dsheffie/r9999/README.md

# r9999
See https://dsheffie.github.io/henry-the-wannabe-ip22-soc/r9999-microarchitecture/#walking-the-pipeline for more details
