dsheffie/r9999/core.sv

`include "machine.vh"
`include "rob.vh"
`include "uop.vh"

`ifdef VERILATOR
import "DPI-C" function void record_faults(input int n_faults);
import "DPI-C" function void record_branches(input int n_branches);


import "DPI-C" function void record_alloc(input int rob_full,
					  input int alloc_one, 
					  input int alloc_two,
					  input int dq_empty,
					  input int uq_full,
					  input int uq_next_full,
					  input int one_insn_avail,
					  input int two_insn_avail,
					  input int active);

import "DPI-C" function void record_retirement(input longint pc,
					       input longint fetch_cycle,
					       input longint alloc_cycle,
					       input longint complete_cycle,
					       input longint retire_cycle,
					       input int     fault,
					       input int     is_mem,
					       input int     is_fp,
					       input int     missed_l1d);

import "DPI-C" function void record_restart(input int restart_cycles);
`ifdef PIPETRACE
/* pipetrace stage events: clear the rob slot's event list at allocation; name the
 * slot record_retirement is about to retire (see top.cc pt::) */
import "DPI-C" function void pt_alloc(input int rob_ptr);
import "DPI-C" function void pt_retire(input int rob_ptr);
`endif
import "DPI-C" function void record_ds_restart(input int delay_cycles);
import "DPI-C" function int check_insn_bytes(input longint pc, input int data);


`endif

module core(clk,
`ifdef FORMAL_ROBWR_PORTS
	    fml_robwr_badv,
	    fml_robwr_act,
`endif
`ifdef FORMAL_RETIRE_PORTS
	    fml_ret_bad,
	    fml_ret_act,
	    fml_ret_badv,
`endif
	    single_step,
	    step,
	    bp_enable,
	    fault_clear,
	    bp_pc,
	    bp_wp_addr,
	    bp_wp_val,
	    bp_fault_only,
	    rt_oneshot,
	    reset,
	    ip6,
	    ip5,
	    ip4,
	    ip3,
	    ip2,	   
	    in_kernel_mode,
	    in_supervisor_mode,
	    in_user_mode,
	    in_64b_kernel_mode,
	    in_64b_supervisor_mode,
	    in_64b_user_mode,
	    putchar_fifo_out,
	    putchar_fifo_empty,
	    putchar_fifo_pop,
	    putchar_fifo_wptr,
	    putchar_fifo_rptr,
	    head_of_rob_ptr_valid,
	    head_of_rob_ptr,
	    head_of_rob_has_delay_slot,
	    next_head_of_rob_ptr,
	    head_of_rob_ds_committable,
	    resume,
	    memq_empty,
	    drain_ds_complete,
	    dead_rob_mask,
	    resume_pc,
	    ready_for_resume,
	    flush_req_l1d,
	    flush_req_l1i,
	    flush_line_req_l1i,
	    flush_line_idx_l1i,
	    flush_cl_req,
	    flush_cl_addr,
	    flush_cl_inval,
	    flush_pg_req,
	    l1d_flush_complete,
	    l1i_flush_complete,
	    l1i_flush_line_complete,
	    l2_flush_complete,
	    ext_flush_req,
	    ext_flush_done,
	    ext_flush_ppn,
	    ext_flush_whole,
	    ext_flush_drop,
	    insn, 
	    insn_valid,
	    insn_ack,
	    insn_two, 
	    insn_valid_two,
	    insn_ack_two,	    
	    branch_pc,
	    branch_target,
	    branch_is_indirect,
	    branch_pc_valid,
	    branch_fault,
	    took_branch,
	    branch_bpu_idx,
	    restart_pc,
	    restart_src_pc,
	    restart_src_is_indirect,
	    restart_valid,
	    clr_link_reg,
	    restart_ack,
	    core_mem_req_ack,
	    core_mem_req,
	    core_mem_req_valid,

	    
	    core_mem_rsp,
	    core_mem_rsp_valid,
	    core_mem_blk_valid,
	    core_mem_wake_valid,
	    core_mem_st_done_valid,
	    core_mem_st_done_idx,
	    lsu_sb,
	    restart_color,
	    mem_color_busy,
	    mem_quiet,
	    
	    retire_reg_ptr,
	    retire_reg_data,
	    retire_reg_valid,
	    
	    retire_reg_two_ptr,
	    retire_reg_two_data,
	    retire_reg_two_valid,
	    retire_fp_reg_ptr,
	    retire_fp_reg_data,
	    retire_fp_reg_valid,
	    retire_fp_reg_two_ptr,
	    retire_fp_reg_two_data,
	    retire_fp_reg_two_valid,
	    retire_fcr_reg_ptr,
	    retire_fcr_reg_data,
	    retire_fcr_reg_valid,
	    retire_fcr_reg_two_ptr,
	    retire_fcr_reg_two_data,
	    retire_fcr_reg_two_valid,
	    retire_valid,
	    retire_two_valid,
	    retire_delay_slot,
	    retire_pc,
	    retire_two_pc,
`ifdef VERILATOR
	    retire_insn,
	    retire_two_insn,
`endif
	    retire_op,
	    retire_two_op,
	    retired_call,
	    retired_ret,
	    retired_rob_ptr_valid,
	    retired_rob_ptr_two_valid,
	    retired_rob_ptr,
	    retired_rob_ptr_two,
	    
	    got_break,
	    got_ud,
	    got_bad_addr,
	    core_state,
	    inflight,
	    dbg_rob_inflight,
	    epc,
	    status_reg,
	    badvaddr,
	    cause,
	    dbg_frozen,
	    dbg_wp_data,
	    cause_ip,
	    asid,
	    tlb_entry_out,
	    tlb_entry_out_valid,
	    took_irq,
	    cp0_count,
	    cp0_random,
	    
	    l1i_flush_done,
	    l1d_flush_done,
	    l2_flush_done,
	    dbg_head_pc,
	    dbg_head_status,
	    dbg_head_fetch_cycle,
	    dbg_head_alloc_cycle,
	    dbg_serialize_cycle,
	    dbg_cycle,
	    dbg_oldest_first_pending,
	    dbg_trace_index,
	    dbg_trace_data,
	    dbg_trace_wptr);

   input logic clk;
   input logic reset;
   input logic ip6;
   input logic ip5;
   input logic ip4;
   input logic ip3;
   input logic ip2;   
   output logic	in_kernel_mode;
   output logic	in_supervisor_mode;
   output logic	in_user_mode;
   output logic	in_64b_kernel_mode;
   output logic	in_64b_supervisor_mode;
   output logic	in_64b_user_mode;
    
   output logic [7:0] putchar_fifo_out;
   output logic       putchar_fifo_empty;
   input logic 	      putchar_fifo_pop;
   output logic [3:0] putchar_fifo_wptr;
   output logic [3:0] putchar_fifo_rptr;
   
   output logic head_of_rob_ptr_valid;
   output logic [`LG_ROB_ENTRIES-1:0] head_of_rob_ptr;
   output logic			      head_of_rob_has_delay_slot;
   output logic [`LG_ROB_ENTRIES-1:0] next_head_of_rob_ptr;
   output logic			      head_of_rob_ds_committable;
   input logic resume;
   input logic single_step;
   input logic step;
   input logic bp_enable;   /* debug: freeze core after retiring bp_pc (also arms the fault-trap) */
   input logic fault_clear; /* debug: clear the fault-trap latch + re-arm + un-freeze (resettable) */
   input logic [31:0] bp_pc; /* debug: driver-programmable breakpoint PC (slv_reg9) */
   input logic [31:0] bp_wp_addr; /* debug: driver-programmable store-address watchpoint VA (slv_reg10) */
   input logic [31:0] bp_wp_val;  /* debug: expected corrupt store value to freeze on (slv_reg11) */
   /* debug (ctrl bit22): rising edge rewinds + arms the retire ring for ONE
    * full pass, after which it self-freezes -- a coherent dump with the core
    * still RUNNING, so profiling never interrupts the soak. */
   input logic rt_oneshot;
   input logic bp_fault_only;     /* debug (ctrl bit19): freeze ONLY on a FAULT at bp_pc, suppressing
                                   * every retire-match + routine-fatal-fault net.  For a HOT bp_pc
                                   * (e.g. 0e788bc0, a load that usually succeeds) whose crash is a
                                   * rare FAULT: retire-matches would freeze on every normal pass. */
   input logic memq_empty;
   output logic drain_ds_complete;
   output logic [(1<<`LG_ROB_ENTRIES)-1:0] dead_rob_mask;
   
   input logic [(`M_WIDTH-1):0] resume_pc;
   output logic 		ready_for_resume;
   output logic 		flush_req_l1d;
   output logic 		flush_req_l1i;
   /* I-side CACHE op: invalidate one L1I set (both ways) instead of the whole L1I */
   output logic 		flush_line_req_l1i;
   output logic [`LG_L1I_NUM_SETS-1:0] flush_line_idx_l1i;
   
   output logic flush_cl_req;
   output logic [(`M_WIDTH-1):0] flush_cl_addr;
   output logic flush_cl_inval; /* per-line flush is an invalidate-no-writeback (DMA-in) */
   /* injected page op: L1D walks the page at flush_cl_addr (flush_cl_inval = drop) */
   output logic flush_pg_req;

   input logic			 l1d_flush_complete;
   input logic			 l1i_flush_complete;
   input logic			 l1i_flush_line_complete;
   input logic			 l2_flush_complete;
   /* ARM-requested whole-cache flush (via core_l1d_l1i).  Handled like an IRQ:
    * while pending, decode replaces a non-delay-slot instruction with a
    * serializing XFLUSH/XPG_* uop; it flushes L1D then L2 with the
    * core drained, restarts at its own pc, and pulses ext_flush_done. */
   input logic			 ext_flush_req;
   output logic			 ext_flush_done;
   /* sampled when the request is accepted and held until ext_flush_done: the page to
    * flush, or the whole cache. */
   input logic [`PA_WIDTH-1:`LG_PG_SZ] ext_flush_ppn;
   input logic			 ext_flush_whole;
   input logic			 ext_flush_drop;     /* page mode: 1 = drop, 0 = write back + invalidate */
   
	
   input 	insn_fetch_t insn;
   input logic 	insn_valid;
   output logic insn_ack;

   input 	insn_fetch_t insn_two;
   input logic 	insn_valid_two;
   output logic insn_ack_two;
   
   
   output logic [(`M_WIDTH-1):0] restart_pc;
   output logic [(`M_WIDTH-1):0] restart_src_pc;
   output logic 		 restart_src_is_indirect;
   output logic 		 restart_valid;
   output logic			 clr_link_reg;
   input logic 			 restart_ack;
   
   output logic [(`M_WIDTH-1):0] branch_pc;
   /* retiring indirect jump (not a return) and its resolved target: trains the BTB */
   output logic [(`M_WIDTH-1):0] branch_target;
   output logic 		 branch_is_indirect;
   output logic 		 branch_pc_valid;
   output logic 		 branch_fault;
   output logic 		 took_branch;
   output logic [`LG_BPU_TBL_SZ-1:0] branch_bpu_idx;
   
   /* mem port */
   input logic 	 core_mem_req_ack;
   
   output logic  core_mem_req_valid;
   output 	 mem_req_t core_mem_req;

  
   input 	 mem_rsp_t core_mem_rsp;
   input logic 	 core_mem_rsp_valid;
   input logic 	 core_mem_blk_valid;   /* LSU block code (core_mem_rsp.blk/lsu_idx) */
   input logic 	 core_mem_wake_valid;  /* LSU wakeup (core_mem_rsp.lsu_idx) */
   input logic 	 core_mem_st_done_valid;   /* LSU plain store written */
   input logic [`LG_MEM_SCHED_ENTRIES-1:0] core_mem_st_done_idx;
   output 	 lsu_sb_t lsu_sb;          /* LSU -> l1d store-buffer view */
   output logic	 restart_color;            /* current restart color (to the l1d) */
   input logic [1:0] mem_color_busy;       /* l1d: a memory op of color c is still in flight */
   input logic       mem_quiet;            /* l1d: nothing accepted is still in flight */

   output logic [4:0] 			  retire_reg_ptr;
   output logic [`M_WIDTH-1:0]		  retire_reg_data;
   output logic 			  retire_reg_valid;

   output logic [4:0] 			  retire_reg_two_ptr;
   output logic [`M_WIDTH-1:0]		  retire_reg_two_data;
   output logic 			  retire_reg_two_valid;
   /* FP and FCR architectural writes, for the co-sim.  retire_reg_valid tests
    * only valid_dst, so an FP register write was invisible to the checker --
    * every FP value bug stayed silent until it leaked through an mfc1/swc1.
    * rob_entry_t.data already carries the FP result (complete_bundle_2 writes
    * it), and for a compare data[7:0] is the condition-code vector. */
   output logic [4:0] 		  retire_fp_reg_ptr;
   output logic [`M_WIDTH-1:0] 	  retire_fp_reg_data;
   output logic 		  retire_fp_reg_valid;
   output logic [4:0] 		  retire_fp_reg_two_ptr;
   output logic [`M_WIDTH-1:0] 	  retire_fp_reg_two_data;
   output logic 		  retire_fp_reg_two_valid;
   output logic [4:0] 		  retire_fcr_reg_ptr;
   output logic [`M_WIDTH-1:0] 	  retire_fcr_reg_data;
   output logic 		  retire_fcr_reg_valid;
   output logic [4:0] 		  retire_fcr_reg_two_ptr;
   output logic [`M_WIDTH-1:0] 	  retire_fcr_reg_two_data;
   output logic 		  retire_fcr_reg_two_valid;
   
   output logic 			  retire_valid;
   output logic 			  retire_two_valid;
   
   output logic 			  retire_delay_slot;
   
   output logic [(`M_WIDTH-1):0] 	  retire_pc;
   output logic [(`M_WIDTH-1):0] 	  retire_two_pc;
`ifdef VERILATOR
   /* the instruction word each retiring op was fetched as: the L1I is not coherent with
    * stores, so it can differ from memory (IRIX utlbmiss_reset patches the refill vector
    * with no I-cache flush); the co-sim checker runs this word, not memory's */
   output logic [31:0] 			  retire_insn;
   output logic [31:0] 			  retire_two_insn;
   logic [31:0] 			  r_rob_raw_insn[(1<<`LG_ROB_ENTRIES)-1:0];
`endif

   output logic [7:0]			  retire_op;
   output logic [7:0]			  retire_two_op;
      
   output logic 			  retired_call;
   output logic 			  retired_ret;

   output logic 			  retired_rob_ptr_valid;

   output logic retired_rob_ptr_two_valid;
   output logic [`LG_ROB_ENTRIES-1:0] retired_rob_ptr;
   output logic [`LG_ROB_ENTRIES-1:0] retired_rob_ptr_two;
   
   
   output logic 			  got_break;
   output logic 			  got_ud;
   output logic 			  got_bad_addr;
   output logic [`LG_ROB_ENTRIES:0] 	  inflight;
   output logic [N_ROB_ENTRIES-1:0] dbg_rob_inflight;
   output logic [4:0]			  core_state;
   
   output logic [`M_WIDTH-1:0]		  epc;
   output logic [31:0]			  status_reg;
   
   output logic [`M_WIDTH-1:0]		  badvaddr;
   
   output logic [4:0]			  cause;
   output logic [7:0]			  cause_ip;
   output logic [2:0]			  dbg_frozen; /* {r_bp_hit, r_wp_hit, r_fault_hit} -- real freeze vs stall */
   output logic [31:0]			  dbg_wp_data; /* the DATA of the last store to bp_wp_addr (exact store value) */
   output logic [7:0]			  asid;
   output tlb_data_t		          tlb_entry_out;
   output logic				  tlb_entry_out_valid;
   output logic				  took_irq;
   output logic [31:0]			  cp0_count;
   output logic [5:0]			  cp0_random;
   
   
   output logic				  l1i_flush_done;
   output logic				  l1d_flush_done;
   output logic				  l2_flush_done;

   output logic [31:0]			  dbg_head_pc;
   output logic [31:0]			  dbg_head_status;
   output logic [31:0]			  dbg_head_fetch_cycle;
   output logic [31:0]			  dbg_head_alloc_cycle;
   output logic [31:0]			  dbg_serialize_cycle;
   output logic [31:0]			  dbg_cycle;
   output logic				  dbg_oldest_first_pending;
   input logic [19:0] dbg_trace_index;
   output logic [31:0] 			  dbg_trace_data;
   output logic [15:0] 			  dbg_trace_wptr;

   assign in_64b_kernel_mode     = w_in_64b_kernel_mode;
   assign in_64b_supervisor_mode = w_in_64b_supervisor_mode;
   assign in_64b_user_mode       = w_in_64b_user_mode;

   wire				w_in_64b_mode;
   generate
      if(`M_WIDTH==64)
	begin
	   /* must match decode_mips.sv (70538bc): 64-bit OPS are always valid in
	    * kernel mode -- KX gates only addressing and the XTLB vector.  This copy
	    * feeds only the P-mode-hazard guard (mode_when_fetched is decode's value)
	    * and debug prints; still requiring KX here made the guard fire on any RI
	    * in kernel mode with KX=0 (tests/fpu/fp_mips4: the first movn). */
	   assign w_in_64b_mode = in_kernel_mode |
				  w_in_64b_user_mode | 
				  w_in_64b_supervisor_mode;
	end
      else
	begin
	   assign w_in_64b_mode =1'b0;
	end
   endgenerate

   wire					  w_in_64b_kernel_mode;
   wire					  w_in_64b_supervisor_mode;
   wire					  w_in_64b_user_mode;
   wire					  w_cu1;   /* Status.CU1 (FPU enable) from exec -> decode CP1 CpU gate */
   wire					  w_fr;    /* Status.FR (FP reg mode) from exec -> decode FR=0 odd-reg gate */
   wire					  w_irq_pending;
   wire [31:0]				  w_cp0_count;
   wire [5:0]				  w_cp0_random;
   
   
   logic [`M_WIDTH-1:0]			  r_epc, n_epc;
   logic [`M_WIDTH-1:0]			  r_badvaddr, n_badvaddr;   
   wire [`M_WIDTH-1:0]			  w_exec_epc;
   
   wire					  w_sr_bev;
   wire					  w_sr_exl;

   
   logic				  r_exc_in_delay, n_exc_in_delay;
   
   
   localparam N_PRF_ENTRIES = (1<<`LG_PRF_ENTRIES);
   /* N_ROB_ENTRIES = pointer index space (masks/ports indexed by rob_ptr stay 2^LG);
    * ROB_ENTRIES = real capacity (storage arrays, pointer wrap) */
   localparam N_ROB_ENTRIES = (1<<`LG_ROB_ENTRIES);
   localparam ROB_ENTRIES = `ROB_ENTRIES;
   localparam ROB_POW2 = (ROB_ENTRIES == N_ROB_ENTRIES);
   localparam N_UQ_ENTRIES = (1<<`LG_UQ_ENTRIES);
   localparam N_HILO_ENTRIES = (1<<`LG_HILO_PRF_ENTRIES);
   localparam N_FCR_ENTRIES = (1<<`LG_FCR_PRF_ENTRIES);

   localparam N_DQ_ENTRIES = (1<<`LG_DQ_ENTRIES);
   localparam HI_EBITS = `M_WIDTH-32;

   logic 				  t_push_dq_one, t_push_dq_two;
   
   uop_t r_dq[N_DQ_ENTRIES-1:0];

   
   logic [`LG_DQ_ENTRIES:0] 		  r_dq_head_ptr, n_dq_head_ptr;
   logic [`LG_DQ_ENTRIES:0] 		  r_dq_next_head_ptr, n_dq_next_head_ptr;
   logic [`LG_DQ_ENTRIES:0] 		  r_dq_next_tail_ptr, n_dq_next_tail_ptr;
   
   logic [`LG_DQ_ENTRIES:0] 		  r_dq_cnt, n_dq_cnt;
   
   logic [`LG_DQ_ENTRIES:0] 		  r_dq_tail_ptr, n_dq_tail_ptr;
   logic 				  t_dq_empty, t_dq_full, t_dq_next_empty, t_dq_next_full;
   
   logic 				  r_got_restart_ack, n_got_restart_ack;
   
   /* ROB banked even/odd by rob_ptr[0] (rv64core scheme): alloc writes 2 consecutive
    * entries (tail, tail+1) which always differ in bit0 -> one to each bank, so each
    * bank sees a single alloc write (instead of 2 write ports on one wide array).
    * Retire reads head + head+1 -> one from each bank.  Bank index = rob_ptr[hi:1]. */
   /* completion-written fields (multi-ported flops) */
   crob_entry_t r_rob_even[(ROB_ENTRIES/2)-1:0];
   crob_entry_t r_rob_odd[(ROB_ENTRIES/2)-1:0];
   /* alloc-only fields: one write port per bank, no reset (LUTRAM-able) */
   mrob_entry_t r_mrob_even[(ROB_ENTRIES/2)-1:0];
   mrob_entry_t r_mrob_odd[(ROB_ENTRIES/2)-1:0];
   logic 	t_mrob_even_we, t_mrob_odd_we;
   logic [`LG_ROB_ENTRIES-2:0] t_mrob_even_addr, t_mrob_odd_addr;
   mrob_entry_t t_mrob_even_data, t_mrob_odd_data;

   /* ROB pointers are {wrap, index}: empty = equal, full = index equal + wrap differs.
    * Only advancing a pointer depends on the capacity. */
   function automatic logic [`LG_ROB_ENTRIES:0] rob_ptr_inc_pow2(input logic [`LG_ROB_ENTRIES:0] p, input logic [1:0] k);
      return p + {{(`LG_ROB_ENTRIES-1){1'b0}}, k};
   endfunction // rob_ptr_inc_pow2

   /* index wraps at ROB_ENTRIES and flips the wrap bit; k <= 2 and ROB_ENTRIES
    * even, so one conditional subtract suffices */
   function automatic logic [`LG_ROB_ENTRIES:0] rob_ptr_inc_npow2(input logic [`LG_ROB_ENTRIES:0] p, input logic [1:0] k);
      logic [`LG_ROB_ENTRIES:0] t_idx;
      logic 			t_wrap;
      t_idx = {1'b0, p[`LG_ROB_ENTRIES-1:0]} + {{(`LG_ROB_ENTRIES-1){1'b0}}, k};
      t_wrap = (t_idx >= ROB_ENTRIES);
      if(t_wrap)
	begin
	   t_idx = t_idx - ROB_ENTRIES;
	end
      return {p[`LG_ROB_ENTRIES] ^ t_wrap, t_idx[`LG_ROB_ENTRIES-1:0]};
   endfunction // rob_ptr_inc_npow2

`ifdef VERILATOR
   initial
     begin
	if((ROB_ENTRIES % 2) != 0 || ROB_ENTRIES > N_ROB_ENTRIES || ROB_ENTRIES <= (N_ROB_ENTRIES/2))
	  begin
	     $fatal(1, "ROB_ENTRIES %d must be even and in (2^(LG-1), 2^LG]", ROB_ENTRIES);
	  end
     end
`endif

   function automatic logic [`LG_ROB_ENTRIES:0] rob_ptr_inc(input logic [`LG_ROB_ENTRIES:0] p, input logic [1:0] k);
      return ROB_POW2 ? rob_ptr_inc_pow2(p, k) : rob_ptr_inc_npow2(p, k);
   endfunction // rob_ptr_inc

   function automatic mrob_entry_t rob_to_mrob(input rob_entry_t e);
      mrob_entry_t r;
      r.is_cpu = e.is_cpu;
      r.cpu_ce1 = e.cpu_ce1;
      r.is_ret = e.is_ret;
      r.is_call = e.is_call;
      r.is_irq = e.is_irq;
      r.is_store = e.is_store;
      r.is_tlbp = e.is_tlbp;
      r.valid_dst = e.valid_dst;
      r.valid_hilo_dst = e.valid_hilo_dst;
      r.valid_fp_dst = e.valid_fp_dst;
      r.valid_fcr_dst = e.valid_fcr_dst;
      r.has_delay_slot = e.has_delay_slot;
      r.has_nullifying_delay_slot = e.has_nullifying_delay_slot;
      r.in_delay_slot = e.in_delay_slot;
      r.ldst = e.ldst;
      r.srcA_ptr = e.srcA_ptr;
      r.srcA_arch = e.srcA_arch;
      r.pdst = e.pdst;
      r.old_pdst = e.old_pdst;
      r.pc = e.pc;
      r.is_br = e.is_br;
      r.is_indirect = e.is_indirect;
      r.is_break = e.is_break;
      r.is_syscall = e.is_syscall;
      r.is_cache = e.is_cache;
      r.cache_act = e.cache_act;
      r.opcode = e.opcode;
      r.bpu_idx = e.bpu_idx;
      r.br_pred = e.br_pred;
      r.oldest_first = e.oldest_first;
      r.mode_when_fetched = e.mode_when_fetched;
      r.post_restart = e.post_restart;
`ifdef ENABLE_CYCLE_ACCOUNTING
      r.fetch_cycle = e.fetch_cycle;
      r.alloc_cycle = e.alloc_cycle;
`endif
      return r;
   endfunction // rob_to_mrob

   function automatic crob_entry_t rob_to_crob(input rob_entry_t e);
      crob_entry_t r;
      r.faulted = e.faulted;
      r.is_ii = e.is_ii;
      r.is_fpe = e.is_fpe;
      r.fp_set_flags = e.fp_set_flags;
      r.overflow = e.overflow;
      r.trap = e.trap;
      r.is_bad_addr = e.is_bad_addr;
      r.is_bus_err = e.is_bus_err;
      r.target_pc = e.target_pc;
      r.take_br = e.take_br;
      r.data = e.data;
      r.tlb_refill = e.tlb_refill;
      r.tlb_invalid = e.tlb_invalid;
      r.tlb_modified = e.tlb_modified;
      r.tlb_hit = e.tlb_hit;
      r.tlb_index = e.tlb_index;
      r.exec_cycle = e.exec_cycle;
      r.fwd_sel = e.fwd_sel;
      r.fwd_selB = e.fwd_selB;
      r.srcB_val = e.srcB_val;
      r.hi_nzA = e.hi_nzA;
      r.hi_nzB = e.hi_nzB;
      r.wr_echo = e.wr_echo;
`ifdef ENABLE_CYCLE_ACCOUNTING
      r.complete_cycle = e.complete_cycle;
`endif
      return r;
   endfunction // rob_to_crob

   function automatic rob_entry_t rob_merge(input mrob_entry_t m, input crob_entry_t c);
      rob_entry_t r;
      r.faulted = c.faulted;
      r.is_ii = c.is_ii;
      r.is_cpu = m.is_cpu;
      r.cpu_ce1 = m.cpu_ce1;
      r.is_fpe = c.is_fpe;
      r.fp_set_flags = c.fp_set_flags;
      r.overflow = c.overflow;
      r.trap = c.trap;
      r.is_bad_addr = c.is_bad_addr;
      r.is_bus_err = c.is_bus_err;
      r.is_ret = m.is_ret;
      r.is_call = m.is_call;
      r.is_irq = m.is_irq;
      r.is_store = m.is_store;
      r.is_tlbp = m.is_tlbp;
      r.valid_dst = m.valid_dst;
      r.valid_hilo_dst = m.valid_hilo_dst;
      r.valid_fp_dst = m.valid_fp_dst;
      r.valid_fcr_dst = m.valid_fcr_dst;
      r.has_delay_slot = m.has_delay_slot;
      r.has_nullifying_delay_slot = m.has_nullifying_delay_slot;
      r.in_delay_slot = m.in_delay_slot;
      r.ldst = m.ldst;
      r.srcA_ptr = m.srcA_ptr;
      r.srcA_arch = m.srcA_arch;
      r.pdst = m.pdst;
      r.old_pdst = m.old_pdst;
      r.pc = m.pc;
      r.target_pc = c.target_pc;
      r.is_br = m.is_br;
      r.is_indirect = m.is_indirect;
      r.take_br = c.take_br;
      r.is_break = m.is_break;
      r.is_syscall = m.is_syscall;
      r.is_cache = m.is_cache;
      r.cache_act = m.cache_act;
      r.data = c.data;
      r.opcode = m.opcode;
      r.bpu_idx = m.bpu_idx;
      r.br_pred = m.br_pred;
      r.oldest_first = m.oldest_first;
      r.tlb_refill = c.tlb_refill;
      r.tlb_invalid = c.tlb_invalid;
      r.tlb_modified = c.tlb_modified;
      r.tlb_hit = c.tlb_hit;
      r.tlb_index = c.tlb_index;
      r.mode_when_fetched = m.mode_when_fetched;
      r.exec_cycle = c.exec_cycle;
      r.fwd_sel = c.fwd_sel;
      r.fwd_selB = c.fwd_selB;
      r.srcB_val = c.srcB_val;
      r.hi_nzA = c.hi_nzA;
      r.hi_nzB = c.hi_nzB;
      r.wr_echo = c.wr_echo;
      r.post_restart = m.post_restart;
`ifdef ENABLE_CYCLE_ACCOUNTING
      r.fetch_cycle = m.fetch_cycle;
      r.alloc_cycle = m.alloc_cycle;
      r.complete_cycle = c.complete_cycle;
`endif
      return r;
   endfunction // rob_merge
   logic [`M_WIDTH-1:0 ] r_addrs[ROB_ENTRIES-1:0];
   /* FP IEEE flags side-band (1W at FP completion / 2R at retire), mirroring
    * r_addrs: {denorm(E), V,Z,O,U,I} of each completed FP op, indexed by ROB ptr.
    * Read at retire to update FCSR.Cause/Flags (gated by the fp_set_flags bit). */
   logic [5:0] 		 r_fp_flags[ROB_ENTRIES-1:0];

   
   logic [N_ROB_ENTRIES-1:0] 		  r_rob_complete;
   logic [N_ROB_ENTRIES-1:0] 		  r_rob_sd_complete;
   /* ROB entry holds a memory op: a flush restarts without waiting for dead memory
    * ops (restart color) -- only non-memory ops still drain */
   logic [N_ROB_ENTRIES-1:0] 		  r_rob_is_mem;
   wire [1:0] 				  w_exec_color_pending;
   /* the color the next restart flips TO must have nothing left in flight (1-bit
    * color: a straggler from two restarts ago would otherwise alias as live) */
/* debug knob RESTART_MIN_CYC=N: never leave DRAIN/EXCEPTION_DRAIN in fewer than N
 * cycles (tests for completions that trail a flush by a few pipeline stages) */
`ifdef RESTART_MIN_CYC
   logic [7:0] r_drain_age;
   always_ff@(posedge clk)
     begin
	r_drain_age <= (reset || !((r_state == DRAIN) || (r_state == EXCEPTION_DRAIN))) ? 8'd0 :
		       ((r_drain_age == 8'hff) ? r_drain_age : (r_drain_age + 8'd1));
     end
   wire w_drain_min_ok = (r_drain_age >= `RESTART_MIN_CYC);
`else
   wire w_drain_min_ok = 1'b1;
`endif
`ifdef RESTART_MEM_QUIET
   /* debug knob: restart only once the memory system is empty (every accepted op
    * answered, nothing left to send), like main -- the color counters are not used */
   wire 				  w_next_color_busy = !mem_quiet | (w_exec_color_pending != 2'd0);
`else
   wire 				  w_next_color_busy = mem_color_busy[!restart_color] | w_exec_color_pending[!restart_color];
`endif
`ifdef VERILATOR
   /* debug only: a restart that waits a long time names what it is waiting on */
   logic [31:0] r_dbg_drain_cyc;
   always_ff@(posedge clk)
     begin
	r_dbg_drain_cyc <= (reset || !((r_state == DRAIN) || (r_state == EXCEPTION_DRAIN))) ? 32'd0 : (r_dbg_drain_cyc + 32'd1);
	if(r_dbg_drain_cyc == 32'd100000)
	  begin
	     $display("[DRAINWAIT] cyc=%0d state=%0d nonmem_inflight=%x ds_done=%b color=%b mem_color_busy=%b exec_color_pending=%b div_ready=%b",
		      r_cycle, r_state, (r_rob_inflight & ~r_rob_is_mem), r_ds_done, restart_color,
		      mem_color_busy, w_exec_color_pending, t_divide_ready);
	  end
     end
`endif

   logic 				  t_core_store_data_ptr_valid;
   logic [`LG_ROB_ENTRIES-1:0] 		  t_core_store_data_ptr;
 		  
   logic 				  t_rob_head_complete, t_rob_next_head_complete;
   
   
   logic [N_ROB_ENTRIES-1:0] 		  r_rob_inflight, r_rob_dead_insns;
   logic [N_ROB_ENTRIES-1:0] 		  t_clr_mask;
   
   rob_entry_t t_rob_head, t_rob_next_head, t_rob_tail, t_rob_next_tail;

   logic [N_PRF_ENTRIES-1:0] n_prf_free, r_prf_free;
   logic r_bank_sel;
   
   
   logic [N_PRF_ENTRIES-1:0] n_retire_prf_free, r_retire_prf_free;
      
   logic [N_HILO_ENTRIES-1:0] n_hilo_prf_free,r_hilo_prf_free;
   logic [N_HILO_ENTRIES-1:0] n_retire_hilo_prf_free, r_retire_hilo_prf_free;
   logic [`LG_HILO_PRF_ENTRIES-1:0] n_hilo_prf_entry;
   logic [`LG_HILO_PRF_ENTRIES:0]   t_hilo_prf_idx;
   
   logic [`LG_PRF_ENTRIES-1:0]  n_prf_entry, n_prf_entry2;

   //rob
   logic [`LG_ROB_ENTRIES:0] r_rob_head_ptr, n_rob_head_ptr;
   logic [`LG_ROB_ENTRIES:0] r_rob_next_head_ptr, n_rob_next_head_ptr;
   logic [`LG_ROB_ENTRIES:0] r_rob_tail_ptr, n_rob_tail_ptr;
   logic [`LG_ROB_ENTRIES:0] r_rob_next_tail_ptr, n_rob_next_tail_ptr;
   logic 		     t_rob_empty, t_rob_full, t_rob_next_full, t_rob_next_empty;
   
      
         
   logic [`LG_PRF_ENTRIES-1:0] r_alloc_rat[31:0];
   logic [`LG_PRF_ENTRIES-1:0] n_alloc_rat[31:0];
   logic [`LG_PRF_ENTRIES-1:0] r_retire_rat[31:0];
   logic [`LG_PRF_ENTRIES-1:0] n_retire_rat[31:0];
   
   logic [`LG_HILO_PRF_ENTRIES-1:0] r_hilo_alloc_rat;
   logic [`LG_HILO_PRF_ENTRIES-1:0] n_hilo_alloc_rat;
   logic [`LG_HILO_PRF_ENTRIES-1:0] r_hilo_retire_rat;
   logic [`LG_HILO_PRF_ENTRIES-1:0] n_hilo_retire_rat;

   /* ---- FP rename domain: mirrors the integer domain (32 arch FP regs). ----
    * FR=1 / N32 model (32 full 64-bit regs, no even/odd arch pairing yet).
    * One FP dst alloc per cycle (dual-FP-dst is serialized via t_enough_next_fprfs). */
   logic [N_PRF_ENTRIES-1:0]        n_fp_prf_free, r_fp_prf_free;
   logic [N_PRF_ENTRIES-1:0]        n_retire_fp_prf_free, r_retire_fp_prf_free;
   logic [`LG_PRF_ENTRIES-1:0]      r_fp_alloc_rat[31:0];
   logic [`LG_PRF_ENTRIES-1:0]      n_fp_alloc_rat[31:0];
   logic [`LG_PRF_ENTRIES-1:0]      r_fp_retire_rat[31:0];
   logic [`LG_PRF_ENTRIES-1:0]      n_fp_retire_rat[31:0];
   logic [`LG_PRF_ENTRIES-1:0]      n_fp_prf_entry;
   logic [`LG_PRF_ENTRIES:0]        t_fp_ffs0, t_fp_ffs1;   // bank0 (fpu) / bank1 (mem) free ptr
   logic 			   t_fp_b0_full, t_fp_b1_full;
   logic 			   w_fp_dst_is_mem;
   wire [N_PRF_ENTRIES-1:0] 	   w_fp_free_b0, w_fp_free_b1;
   logic 			   t_enough_fprfs, t_enough_next_fprfs;
   logic 			   t_free_fp_reg, t_free_fp_reg_two;
   logic [`LG_PRF_ENTRIES-1:0]      t_free_fp_reg_ptr, t_free_fp_reg_two_ptr;

   /* ---- FCR rename domain (FP condition-code byte): scalar, mirrors HI/LO. ----
    * One arch FCR; a compare RMWs it (read old via fcr_src, write new via fcr_dst).
    * The FCR phys-reg ptr is carried in the uop hilo_src/hilo_dst fields and in the
    * rob pdst/old_pdst fields (truncated to LG_FCR_PRF_ENTRIES), exactly like HI/LO. */
   logic [N_FCR_ENTRIES-1:0]        n_fcr_prf_free, r_fcr_prf_free;
   logic [N_FCR_ENTRIES-1:0]        n_retire_fcr_prf_free, r_retire_fcr_prf_free;
   logic [`LG_FCR_PRF_ENTRIES-1:0]  r_fcr_alloc_rat, n_fcr_alloc_rat;
   logic [`LG_FCR_PRF_ENTRIES-1:0]  r_fcr_retire_rat, n_fcr_retire_rat;
   logic [`LG_FCR_PRF_ENTRIES-1:0]  n_fcr_prf_entry;
   logic [`LG_FCR_PRF_ENTRIES:0]    t_fcr_ffs;
   logic 			   t_enough_fcrprfs, t_enough_next_fcrprfs;
   logic 			   t_free_fcr;
   logic [`LG_FCR_PRF_ENTRIES-1:0]  t_free_fcr_ptr;

   /* FCSR (FCR31) Cause/Flags update -> exec (internal), driven at retire/fault */
   logic			   core_fcsr_we;
   logic [5:0]			   core_fcsr_cause6;
   logic [4:0]			   core_fcsr_flags5;

   logic [N_ROB_ENTRIES-1:0] 	    uq_wait, mq_wait, fp_uq_wait;
   /* DEBUG: ROB-indexed mem-op PC readback from exec (dbg_trace_index[14]=1 mode). */
   wire [31:0] 			    w_dbg_memop_pc;
   

   
   
   wire 		     t_next_head_br;   /* the second retiring slot is a branch */
   logic 		     t_alloc, t_alloc_two, t_retire, t_retire_two,
			     t_rat_copy, t_clr_rob;

   logic 		     t_possible_to_alloc;
   
   
   logic 		     t_fold_uop, t_fold_uop2;
   
   logic 		     n_in_delay_slot, r_in_delay_slot;
   
   logic 		     t_clr_dq;
   logic [`M_WIDTH-1:0]   r_last_branch_target;  /* resolved target of last retired branch (Case 2) */
   logic 		     t_enough_iprfs, t_enough_hlprfs;
   logic 		     t_enough_next_iprfs, t_enough_next_hlprfs;
   

   
   
   logic 		     t_bump_rob_head;
   
   logic [(`M_WIDTH-1):0]    n_restart_pc, r_restart_pc;
   logic [(`M_WIDTH-1):0]    n_restart_src_pc, r_restart_src_pc;
   logic 		     n_restart_src_is_indirect, r_restart_src_is_indirect;
   /* DEBUG last-restart record (see dbg_trace_data, index[14]&index[4]).  The
    * retire ring only sees restarts that are FOLLOWED by a retire; this holds
    * the last one even when the machine wedges right after it. */
   localparam RST_WHY_NONE = 3'd0;
   localparam RST_WHY_MISPREDICT = 3'd1;
   localparam RST_WHY_EXCEPTION = 3'd2;
   localparam RST_WHY_SERIALIZE = 3'd3;
   localparam RST_WHY_CACHE_FLUSH = 3'd4;
   localparam RST_WHY_RESUME = 3'd5;
   logic [2:0] 		     n_restart_why, r_restart_why;
   logic [`LG_ROB_ENTRIES-1:0] n_restart_head_ptr, r_restart_head_ptr;
   logic [31:0] 	     r_restart_cycle;
   logic [31:0] 	     r_restart_count;
   logic [31:0] 	     r_restart_retired;
   
   logic [(`M_WIDTH-1):0]    n_branch_pc, r_branch_pc;
   
   logic [(`M_WIDTH-1):0] 	n_branch_target, r_branch_target;
   
   logic 				n_branch_is_indirect, r_branch_is_indirect;
   logic 		     n_took_branch, r_took_branch;
   logic 		     n_branch_valid, r_branch_valid;
   logic 		     n_branch_fault,r_branch_fault;
   logic [`LG_BPU_TBL_SZ-1:0] n_branch_bpu_idx, r_branch_bpu_idx;
         
   logic 		     n_restart_valid,r_restart_valid;
   logic 		     n_has_delay_slot, r_has_delay_slot;
   logic 		     n_has_nullifying_delay_slot,r_has_nullifying_delay_slot;
   logic 		     n_take_br, r_take_br;

   logic 		     n_got_break, r_got_break;
   logic 		     n_pending_break, r_pending_break;
   logic 		     n_pending_ud, r_pending_ud;
   logic 		     n_pending_bad_addr, r_pending_bad_addr;
   logic 		     n_got_ud, r_got_ud;
   logic 		     n_got_bad_addr, r_got_bad_addr;
   

   logic 		     n_l1i_flush_complete, r_l1i_flush_complete;
   logic 		     n_l1d_flush_complete, r_l1d_flush_complete;
   logic 		     n_l2_flush_complete, r_l2_flush_complete;
   logic 		     n_xflush_pend, r_xflush_pend;
   logic 		     n_xflush_done, r_xflush_done;
   logic [`PA_WIDTH-1:`LG_PG_SZ] n_xflush_ppn, r_xflush_ppn;
   logic 		     n_xflush_whole, r_xflush_whole;
   logic 		     n_xflush_drop, r_xflush_drop;
   assign ext_flush_done = r_xflush_done;
   /* the op decode injects into the flush uop, and the page the L1D walks (read at the
    * ROB head; held here until ext_flush_done) */
   wire [`M_WIDTH-1:0] w_xflush_addr = {{(`M_WIDTH-`PA_WIDTH){1'b0}}, r_xflush_ppn, {`LG_PG_SZ{1'b0}}};
   wire opcode_t w_xflush_op = r_xflush_whole ? XFLUSH : (r_xflush_drop ? XPG_INV : XPG_WBINV);
`ifdef VERILATOR
   /* an injected ext_flush uop must never land in a delay slot: it replaces the
    * instruction, and a replaced delay slot is silently lost (the restart only
    * re-runs .pc, and a delay slot re-run out of context is wrong). */
   always_ff@(negedge clk)
     begin
	if(t_alloc & is_xflush(t_alloc_uop.op) & r_in_delay_slot)
	  begin
	     $display("XFLUSH IN DELAY SLOT: pc %x at cycle %d", t_alloc_uop.pc, r_cycle);
	     $stop();
	  end
     end
`endif
   
   logic [31:0] 	     r_arch_a0;

   logic [4:0] 		     n_cause, r_cause;
   logic [1:0] 		     n_ce, r_ce;   /* Cause.CE for a CpU (1=CP1/FPU, else 0) */
   logic		     r_tlb_refill, n_tlb_refill;
   logic		     r_xtlb_refill, n_xtlb_refill;
   logic		     n_save_to_tlb_regs, r_save_to_tlb_regs;
   logic		     n_has_badvaddr,r_has_badvaddr;
   
   
   
   complete_t t_complete_bundle_1;
   logic 		     t_complete_valid_1;
   /* 2nd completion port: FP pipe (fpu) completes here, in parallel with port 1.
    * Ports 1 and 2 always carry distinct rob_ptrs (an insn completes on exactly
    * one port), so the banked rob writes below never collide. */
   complete_t t_complete_bundle_2;
   logic 		     t_complete_valid_2;
   
   logic 		     t_any_complete;
   

   logic 		     t_free_reg;
   logic [`LG_PRF_ENTRIES-1:0] t_free_reg_ptr;
   
   logic 		       t_free_reg_two;
   logic [`LG_PRF_ENTRIES-1:0] t_free_reg_two_ptr;
   
   logic 			   t_free_hilo;
   logic [`LG_HILO_PRF_ENTRIES-1:0] t_free_hilo_ptr;
   

   logic [`LG_HILO_PRF_ENTRIES:0]   t_hilo_ffs;

   
   logic [`LG_PRF_ENTRIES:0] 	    t_gpr_ffs, t_gpr_ffs2;
   logic 			    t_gpr_ffs_full, t_gpr_ffs2_full;
   wire [N_PRF_ENTRIES-1:0]  w_alu_even, w_alu_odd, w_mem_even, w_mem_odd;
   wire 		     w_alu_even_full, w_alu_odd_full, w_mem_even_full, w_mem_odd_full;
   wire [`LG_PRF_ENTRIES:0]  w_ffs_alu_even, w_ffs_alu_odd, w_ffs_mem_even, w_ffs_mem_odd;
   
   logic 		     t_uq_full, t_uq_next_full;
   
   logic 		     t_uq_read;
   logic 		     n_ready_for_resume, r_ready_for_resume;
   
   
   mem_req_t t_mem_req;
   logic 		     t_mem_req_valid;

   logic 		     n_machine_clr, r_machine_clr;
   logic r_post_restart_arm;  /* arms at RAT->ACTIVE restart edge, stamps first alloc, disarms */
   logic 		     n_flush_req_l1d, r_flush_req_l1d;
   logic 		     n_flush_req_l1i, r_flush_req_l1i;
   logic 		     n_flush_line_req_l1i, r_flush_line_req_l1i;
   logic [`LG_L1I_NUM_SETS-1:0] n_flush_line_idx_l1i, r_flush_line_idx_l1i;
   
   logic 		     n_flush_cl_req, r_flush_cl_req;
   logic [(`M_WIDTH-1):0]    n_flush_cl_addr, r_flush_cl_addr;
   logic 		     n_flush_cl_inval, r_flush_cl_inval;
   logic 		     n_flush_pg_req, r_flush_pg_req;
   logic 		     r_ds_done, n_ds_done;
   
   logic 		     t_can_retire_rob_head;
   logic 		     t_faulted_head_and_serializing_delay;
   logic 		     t_arch_fault;
   
   typedef enum logic [4:0] {
			     FLUSH_FOR_HALT = 'd0, //0			     
			     HALT = 'd1, //1
			     ACTIVE = 'd2 , //2
			     DRAIN = 'd3, //3
			     RAT = 'd4, //4
			     DELAY_SLOT = 'd5, //5
			     ALLOC_FOR_SERIALIZE = 'd6, //6
			     HALT_WAIT_FOR_RESTART = 'd7, //11
			     WAIT_FOR_SERIALIZE_AND_RESTART = 'd8, //12
			     ARCH_FAULT = 'd9,
			     WRITE_EPC = 'd10,
			     EXCEPTION_DRAIN = 'd11,
			     SERIALIZE_IN_FAULTED_DELAY_SLOT = 'd12,
			     WAIT_FOR_SERIALIZE_IN_FAULTED_DELAY_SLOT = 'd13,
			     CACHE_FLUSH = 'd14, // serializing CACHE op: nuke L1I/L1D/L2, then restart
			     DEAD = 'd15
			     } state_t;
   
   state_t r_state, n_state;
   logic 	r_pending_fault, n_pending_fault;
   logic        r_oldest_first_pending, n_oldest_first_pending;
   /* CP0 ordering (uop.vh is_cp0_wr/is_cp0_rd): CP0 writers allocated / retired.  A
    * CP0 reader snapshots r_cp0_alloc_seq into uop.cp0_seq and exec issues it once its
    * commit sequence (retire_cp0_valid count) catches up.  A flush drops every
    * un-retired writer: alloc resyncs to retire. */
   logic [`LG_ROB_ENTRIES+1:0] r_cp0_alloc_seq, n_cp0_alloc_seq;
   logic [`LG_ROB_ENTRIES+1:0] r_cp0_retire_seq, n_cp0_retire_seq;
   logic        r_retire_cp0_valid, r_retire_cp0_staged;
   logic [`LG_ROB_ENTRIES-1:0] r_retire_cp0_rob_ptr;
   
   /* single-step: one architectural commit per 0->1 edge on `step` */
   logic        r_step_d, r_step_credit, n_step_credit;
   logic	r_single_step;
   wire         w_step_edge = step & ~r_step_d;

`ifdef ENABLE_DEBUG_WATCHPOINT
   // On-silicon HW breakpoint + store value+address watchpoint + fault-trap. Gated OFF
   // by default; henry binds bp_pc/bp_wp_x/fault_clear/dbg_frozen/dbg_wp_data
   // unconditionally, so when the guard is off the outputs tie to 0 (else branch) and no
   // compare logic is generated. Retiring insn matching bp_pc, or a store of bp_wp_val to
   // bp_wp_addr, latches r_bp_hit/r_wp_hit and freezes the core so GPRs/DRAM read coherent.
   // bp_pc/bp_wp_x are driver-programmable (slv_reg9-11), no re-synth.
   logic	r_bp_hit;
   /* fault_clear (ctrl bit18) doubles as bp resume: clears r_bp_hit so the core runs
    * full-speed to the NEXT bp_pc match (re-latches next hit). */
   /* bp_fault_only: freeze the pipe on a FAULT at bp_pc (the ROB head always carries the fault,
    * see t_arch_fault); else the classic retire-match.  A hot bp_pc that usually RETIRES would
    * freeze on every normal pass under retire-match -- fault-only waits for the rare crash. */
   wire		w_bp_match = bp_enable &
		(bp_fault_only
		 ? (t_arch_fault & (t_rob_head.pc[31:0] == bp_pc))
		 : ((t_retire     & (t_rob_head.pc[31:0]      == bp_pc)) |
		    (t_retire_two & (t_rob_next_head.pc[31:0] == bp_pc))));

   /* STORE value+address WATCHPOINT (rob_ptr-correlated).  The store ADDRESS (VA) rides
    * t_mem_req (with rob_ptr); the store DATA arrives later from the LSU's
    * store-data capture (t_core_store_data_ptr = its rob_ptr, lsu_sb.data).  On a store whose VA==bp_wp_addr,
    * remember its rob_ptr; when that rob_ptr's data arrives and equals bp_wp_val, FREEZE
    * -- i.e. freeze on the store that writes the CORRUPT value to the watched slot,
    * whichever instruction did it. */
   logic	r_wp_hit;
   logic	r_wp_pending;
   logic [`LG_ROB_ENTRIES-1:0] r_wp_robptr;
   logic [31:0]	r_wp_data;
   assign dbg_wp_data = r_wp_data;
   /* fault-only mode wants ONLY the fault-at-bp_pc freeze: suppress the store watchpoint too
    * (else a store matching a reset/stale bp_wp_addr spuriously freezes retirement -> boot hang). */
   /* PC+THRESHOLD store watchpoint -- the IRIX `be` small-int-in-a-pointer-field BIRTH catch
    * (2026-07-26).  The corrupt struct-field ADDRESS is nondeterministic heap, so we can't preset
    * bp_wp_addr to it; instead key on the store's PC (bp_wp_addr repurposed = producer PC, e.g.
    * 0f377124 `sw r21,0x1c(r17)`) and freeze when its DATA is SMALL (< bp_wp_val, e.g. 0x01000000)
    * -- a small int where a heap pointer belongs.  mem_req_t.pc is un-guarded for synth. */
   wire		w_wp_addr_match = bp_enable & ~bp_fault_only & t_mem_req_valid & t_mem_req.is_store &
		(t_mem_req.pc[31:0] == bp_wp_addr);
   wire		w_wp_data_here  = r_wp_pending & t_core_store_data_ptr_valid &
		(t_core_store_data_ptr == r_wp_robptr);
   /* freeze when the store DATA is a small int (below bp_wp_val threshold) = the corruption. */
   wire		w_wp_match      = w_wp_data_here & (lsu_sb.data[31:0] < bp_wp_val);

   /* resettable fault-trap: while armed (bp_enable), the FIRST fatal USERSPACE arch-fault
    * (AdEL/AdES/IBE/DBE, EPC in useg) latches {epc,cause,badvaddr} + sets r_fault_hit,
    * which folds into w_step_ok to FREEZE so the ARM can read a coherent fault state (the
    * latched taps override the live outputs below).  fault_clear clears + re-arms. */
   logic		r_fault_hit;
   logic [`M_WIDTH-1:0] r_fault_epc, r_fault_badv;
   logic [4:0]	r_fault_cause;
   /* RI (cause 10) is deliberately NOT here: this kernel emulates RDHWR via the RI
    * handler, so userspace takes an RI on every TLS access -- ~1600 per 10M instrs
    * measured on the binutils workload.  Including it latched the trap milliseconds
    * into the run and made bp_enable unusable (arming bp_pc also arms this trap).
    * The remaining causes -- AdEL/AdES/IBE/DBE -- do not occur in healthy userspace,
    * so they are a real corruption signature. */
   /* 2026-09-10: cause 10 (RI) was STILL in this list -- present since the debug
    * interface landed (9e64731/ca2e5c7) -- even though the comment above says it is
    * "deliberately NOT here".  The comment recorded the diagnosis; the fix was never
    * applied.  Consequence, observed on silicon: arming bp_enable for an ARMSIG
    * capture latched HDR-FAULT cause=10 EPC=77bef8cc within ~1s (RDHWR/TLS
    * emulation), froze the core, and swapsoak then reprogrammed the PL -- so the
    * retire-match at force_sig_info could never be reached.  Removing it makes the
    * code match its own comment and is what makes bp_enable usable at all. */
   wire		w_fatal_cause = (n_cause == 5'd4) | (n_cause == 5'd5) | (n_cause == 5'd6) |
		(n_cause == 5'd7);
   /* in fault-only mode the pipe freeze comes from w_bp_match (fault AT bp_pc); suppress the
    * general fatal-fault trap so routine cause-4/5 emulation faults elsewhere don't freeze. */
   wire		w_fault_match = bp_enable & ~bp_fault_only & ~r_fault_hit & t_arch_fault & w_fatal_cause & ~n_epc[31];

   /* this gets consumed by retirement logic */
   wire		w_step_ok   = (r_single_step | r_bp_hit | r_wp_hit | r_fault_hit) ? (t_step_edge) : 1'b1;
   assign dbg_frozen = {r_bp_hit, r_wp_hit, r_fault_hit};
`else
   /* debug watchpoint/fault-trap compiled out -- ports tied off, no compare logic generated */
   wire		w_step_ok   = r_single_step ? (t_step_edge) : 1'b1;
   assign dbg_frozen  = 3'd0;
   assign dbg_wp_data = 32'd0;
`endif

   logic	n_step_last, r_step_last, t_step_edge;
   always_comb
     begin
	n_step_last = r_step_last;
	t_step_edge = 1'b0;
	if(r_step_last & (step == 1'b0))
	  begin
	     n_step_last = 1'b0;
	  end
	else if((r_step_last == 1'b0) & (step == 1'b1))
	  begin
	     n_step_last = 1'b1;
	     t_step_edge = 1'b1;
	  end
     end // always_comb


   always_ff@(posedge clk)
     begin
	r_step_last <= reset ? 1'b0 : n_step_last;
	r_single_step <= reset ? 1'b0 : single_step;
`ifdef ENABLE_DEBUG_WATCHPOINT
	r_bp_hit <= reset ? 1'b0 : (fault_clear ? 1'b0 : (r_bp_hit | w_bp_match));
	r_wp_hit <= reset ? 1'b0 : (fault_clear ? 1'b0 : (r_wp_hit | w_wp_match));
	if(reset)
	  r_wp_data <= 32'd0;
	else if(w_wp_data_here)
	  r_wp_data <= lsu_sb.data[31:0];   /* exact data of the store to bp_wp_addr */
	/* single pending slot: remember the rob_ptr of a store to bp_wp_addr, cleared when
	 * its data arrives (or on fault_clear).  A newer match overwrites -- fine, since we
	 * only care about the store carrying the corrupt value bp_wp_val. */
	if(reset)
	  begin
	     r_wp_pending <= 1'b0;
	     r_wp_robptr  <= '0;
	  end
	else if(fault_clear)
	  begin
	     r_wp_pending <= 1'b0;
	  end
	else if(w_wp_addr_match)
	  begin
	     r_wp_pending <= 1'b1;
	     r_wp_robptr  <= t_mem_req.rob_ptr;
	  end
	else if(w_wp_data_here)
	  begin
	     r_wp_pending <= 1'b0;
	  end
`endif
     end

`ifdef ENABLE_DEBUG_WATCHPOINT
   always_ff@(posedge clk)
     begin
	if(reset)
	  begin
	     r_fault_hit   <= 1'b0;
	     r_fault_epc   <= 'd0;
	     r_fault_badv  <= 'd0;
	     r_fault_cause <= 5'd0;
	  end // if (reset)
	else if(fault_clear)
	  begin
	     r_fault_hit <= 1'b0;   /* clear + re-arm; latched values held until the next hit */
	  end
	else if(w_fault_match)
	  begin
	     r_fault_hit   <= 1'b1;
	     r_fault_epc   <= n_epc;
	     r_fault_badv  <= n_badvaddr;
	     r_fault_cause <= n_cause;
	  end // if (w_fault_match)
     end // always_ff@ (posedge clk)
`endif

   logic [31:0] r_restart_cycles, n_restart_cycles;
   logic t_divide_ready;
   
   
   always_comb
     begin
	core_mem_req_valid = t_mem_req_valid;
	core_mem_req = t_mem_req;
	core_state = r_state;
     end // always_comb
   

   assign ready_for_resume = r_ready_for_resume;
   /* In DRAIN the delay slot of the retired mispredicted branch is the head and must
    * be allowed to issue -- unless it is the NULLIFIED slot of a not-taken
    * branch-likely: an oldest_first op there (mtc0 EntryLo/Index, tlbwr, an uncached
    * access) would otherwise execute its side effect and then be discarded. */
   assign head_of_rob_ptr_valid = (r_state == ACTIVE) |
				  ( (r_state==DRAIN) && !r_ds_done &&
				    !(r_has_nullifying_delay_slot && !r_take_br) );
   assign head_of_rob_ptr = r_rob_head_ptr[`LG_ROB_ENTRIES-1:0];
   assign head_of_rob_has_delay_slot = t_rob_head.has_delay_slot | t_rob_head.has_nullifying_delay_slot;
   /* Fix A (uncached-delay-slot deadlock): a REGULAR (non-nullifying) delay slot
    * of a COMPLETE, FAULTED (mispredicted) branch at the ROB head is guaranteed to
    * commit -- the branch has no execute-stage exception and nothing older can
    * squash it, so the delay slot is non-speculative even though the branch has not
    * retired yet.  l1d uses this to let a delay-slot UNCACHED op (e.g. the ip22
    * eeprom store behind a mispredicted `jr ra`) issue to the device; otherwise the
    * branch's retire gate (waits for delay-slot complete) and the uncached issue
    * gate (waits for at-head/drain) deadlock.  next_head_of_rob_ptr IS the delay
    * slot (the ROB entry right after the head). */
   assign next_head_of_rob_ptr = r_rob_next_head_ptr[`LG_ROB_ENTRIES-1:0];
   assign head_of_rob_ds_committable = w_rob_head_complete
					 & t_rob_head.faulted
					 & t_rob_head.has_delay_slot
					 & ~t_rob_head.has_nullifying_delay_slot;

   always_comb
     begin
	n_cp0_alloc_seq = r_cp0_alloc_seq
			  + ((t_alloc & is_cp0_wr(t_uop.op)) ? 'd1 : 'd0)
			  + ((t_alloc_two & is_cp0_wr(t_uop2.op)) ? 'd1 : 'd0);
	n_cp0_retire_seq = r_cp0_retire_seq
			   + ((t_retire & is_cp0_wr(t_rob_head.opcode)) ? 'd1 : 'd0);
	if(t_clr_rob)
	  begin
	     n_cp0_alloc_seq = n_cp0_retire_seq;
	  end
     end // always_comb

   always_ff@(posedge clk)
     begin
	r_cp0_alloc_seq <= reset ? 'd0 : n_cp0_alloc_seq;
	r_cp0_retire_seq <= reset ? 'd0 : n_cp0_retire_seq;
	/* commit handshake to exec: one CP0 writer retires per cycle (t_retire_two) */
	r_retire_cp0_valid <= reset ? 1'b0 : (t_retire & is_cp0_wr(t_rob_head.opcode));
	r_retire_cp0_staged <= reset ? 1'b0 : (t_retire & ((t_rob_head.opcode == MTC0) | (t_rob_head.opcode == DMTC0)));
	r_retire_cp0_rob_ptr <= r_rob_head_ptr[`LG_ROB_ENTRIES-1:0];
     end

`ifdef VERILATOR
   always_ff@(posedge clk)
     begin
	if(!reset && t_rob_empty && (r_cp0_alloc_seq != r_cp0_retire_seq))
	  begin
	     $display("[CP0SEQ] cycle %d: ROB empty but alloc seq %d != retire seq %d", r_cycle, r_cp0_alloc_seq, r_cp0_retire_seq);
	     $stop();
	  end
	if(!reset && t_retire_two && is_cp0_wr(t_rob_next_head.opcode))
	  begin
	     $display("[CP0SEQ] cycle %d: CP0 writer retired in the second slot", r_cycle);
	     $stop();
	  end
     end
`endif
				      
   assign flush_req_l1d = r_flush_req_l1d;
   assign flush_req_l1i = r_flush_req_l1i;
   assign flush_line_req_l1i = r_flush_line_req_l1i;
   assign flush_line_idx_l1i = r_flush_line_idx_l1i;
   assign flush_cl_req = r_flush_cl_req;
   assign flush_cl_addr = r_flush_cl_addr;
   assign flush_cl_inval = r_flush_cl_inval;
   assign flush_pg_req = r_flush_pg_req;

   
   assign got_break = r_got_break;
   assign got_ud = r_got_ud;
   assign got_bad_addr = r_got_bad_addr;
`ifdef ENABLE_DEBUG_WATCHPOINT
   /* when the fault-trap is frozen, expose the LATCHED fault state on the live taps
    * so the ARM reads a stable {epc,cause,badvaddr} (not clobbered by the handler). */
   assign epc      = r_fault_hit ? r_fault_epc   : r_epc;
   assign badvaddr = r_fault_hit ? r_fault_badv  : r_badvaddr;
   assign cause    = r_fault_hit ? r_fault_cause : r_cause;
`else
   assign epc = r_epc;
   assign badvaddr = r_badvaddr;
   assign cause = r_cause;
`endif

   assign dbg_head_pc              = t_rob_head.pc[31:0];
   /* why is the head stuck? read-only debug packing of existing head signals.
    * [0] rob_empty (stall is upstream/fetch, not the head)
    * [1] head_complete (head done but not retiring => retire-gate blocked)
    * [2] can_retire   [3] faulted
    * [4] has_delay_slot  [5] has_nullifying_delay_slot
    * [6] next_head_complete  [7] decode-queue empty */
   assign dbg_head_status = { 24'd0,
			      t_dq_empty,
			      w_rob_next_head_complete,
			      t_rob_head.has_nullifying_delay_slot,
			      t_rob_head.has_delay_slot,
			      t_rob_head.faulted,
			      t_can_retire_rob_head,
			      w_rob_head_complete,
			      w_rob_empty };
`ifdef ENABLE_CYCLE_ACCOUNTING
   assign dbg_head_fetch_cycle     = t_rob_head.fetch_cycle[31:0];
   assign dbg_head_alloc_cycle     = t_rob_head.alloc_cycle[31:0];
`else
   assign dbg_head_fetch_cycle     = 'd0;
   assign dbg_head_alloc_cycle     = 'd0;
`endif
   assign dbg_serialize_cycle      = r_serialize_cycle;
   assign dbg_cycle                = r_cycle[31:0];
   assign dbg_oldest_first_pending = r_oldest_first_pending;
`ifdef GHOST_DEBUG
   always_ff@(negedge clk)
     begin
	if(t_retire & t_rob_head.faulted & (r_state == ACTIVE))
	  $display("[flt-retire] cyc=%d pc=%x head=%d has_ds=%b nds=%b", r_cycle, t_rob_head.pc, r_rob_head_ptr, t_rob_head.has_delay_slot, n_ds_done);
	if((r_state == DRAIN) | (r_state == RAT))
	  $display("[st] cyc=%d st=%d head=%d hv=%b ds=%b ret=%b hpc=%x", r_cycle, r_state, r_rob_head_ptr, head_of_rob_ptr_valid, r_ds_done, t_retire, t_rob_head.pc);
     end
`endif

   /* NULL-TARGET FREEZE.  A jump to VA 0 is architecturally legal but is
    * essentially never correct: the 2026-08-24 Linux oops was exactly that -- a
    * JALR that RETIRED with target 0 (epc=0, BadVA=0, ra=__split_vma+0x1a0).
    * Detecting it HERE instead of waiting for the kernel oops is what makes the
    * retire ring usable: the oops does not halt the machine, so the 256-entry
    * ring wraps in microseconds and the evidence is gone.  Freezing on the
    * event keeps the offending JALR and everything before it resident.
    *
    * Catches BOTH zero and BTB_POISON_PC, and the two mean different things:
    * poison => a COLD/INVALID BTB entry reached retire (the predictor made it);
    * zero   => a genuine NULL pointer in the program.  Without the poison split
    * these are indistinguishable, which is why the 2026-08-24 dump could not
    * say whether the predictor or the data was at fault.
    *
    * r_trace_frozen is a flop, so the triggering retire record is still written
    * this cycle and only later writes are suppressed.  Sticky until reset. */
   /* MUST check BOTH retire slots: the machine retires two per cycle, and an
    * indirect that commits in the SECOND slot (t_retire_two / t_rob_next_head)
    * would otherwise never be seen -- a detector that is structurally unable to
    * report the event it exists for. */
   /* COMMIT = either head-advance path (`if(t_retire || t_bump_rob_head)`, the
    * ROB free logic).  A MISPREDICTED branch asserts BOTH (measured: retire=1
    * bump=1 at the jalr commit), so t_retire alone was in fact sufficient for
    * the is_indirect triggers -- verified by directed test, and NOT the reason
    * the ring failed to freeze on 2026-08-27.  What t_retire cannot see is an
    * ARCH-FAULT commit: t_retire = t_rob_head_complete & !t_arch_fault, so a
    * faulting entry commits via t_bump_rob_head with t_retire LOW.  That is
    * what w_null_pc_head below needs, and it also puts the fault records --
    * the crash evidence -- into the ring instead of dropping them. */
   wire 	      w_head_commit = t_retire | t_bump_rob_head;
   wire 	      w_null_tgt_head = w_head_commit & t_rob_head.is_indirect &
				        ((t_rob_head.target_pc == 'd0) |
					 (t_rob_head.target_pc == `BTB_POISON_PC));
   wire 	      w_null_tgt_two  = t_retire_two & t_rob_next_head.is_indirect &
				        ((t_rob_next_head.target_pc == 'd0) |
					 (t_rob_next_head.target_pc == `BTB_POISON_PC));
   /* THE CRASH ITSELF, not one way of causing it.  On 2026-08-27 the board
    * took the __split_vma oops (epc=0, cause 2) and the ring did NOT freeze,
    * with the ring provably live -- so the transfer to 0 was NOT a committed
    * indirect with target 0.  The is_indirect triggers above are structurally
    * blind to an ERET into a corrupted EPC, or to any bad restart_pc.  An entry
    * FETCHED from 0 reaching commit catches all of them: the faulting entry
    * carries pc==0 and commits via t_bump_rob_head (t_retire is LOW on an arch
    * fault), which is why this needs w_head_commit and not t_retire. */
   wire 	      w_null_pc_head = w_head_commit & (t_rob_head.pc == 'd0);
   /* WILD RESTART -- the trigger that cannot be blind to the route taken.
    * Fires on ANY restart into the null page, which covers every way the core
    * can architecturally arrive at pc 0: a mispredicted branch resolving to 0
    * (target_pc), a faulted delay slot restarting through a stale
    * r_last_branch_target, and an ERET into a corrupted EPC (resume_pc).  The
    * is_indirect triggers above see only the first of those, which is why they
    * stayed silent through the 2026-08-27 oops.  This is the silicon twin of
    * the sim-only `if(n_epc < 'd1000) $stop()` in the arch-fault path: the null
    * page is never mapped, so a restart into it is always a bug.  Reading
    * n_restart_* here is safe -- w_null_target is consumed only by always_ff
    * (a comb read would form a t_bump_rob_head/t_retire UNOPTFLAT loop). */
   wire 	      w_wild_restart = n_restart_valid &
				       (n_restart_pc[(`M_WIDTH-1):12] == 'd0);
   /* KERNEL NULL-PAGE FAULT.  The four kernel-mode events (__split_vma,
    * filp_flush x2, __get_unmapped_area) all reached PC=0 yet tripped NONE of the
    * triggers above -- so whatever takes the kernel to 0 is not a committed
    * indirect resolving to 0, and w_null_pc_head did not fire either.  Rather than
    * keep guessing at the route, trigger on the CONSEQUENCE: an arch fault taken
    * in kernel mode whose BadVA is in the never-mapped null page.  A kernel-mode
    * access to page 0 is always a bug, and ordinary user demand-paging cannot trip
    * it (that faults in user mode), so this cannot fire on normal activity.
    * Consumed only by always_ff below -- reading n_* in a comb block that assigns
    * them would form an UNOPTFLAT loop. */
   wire 	      w_kernel_null_fault = t_bump_rob_head & in_kernel_mode &
					    (n_badvaddr[(`M_WIDTH-1):12] == 'd0) &
					    ((n_cause == 5'd2) | (n_cause == 5'd3));
   /* WILD EPC -- the actual silicon twin of the pre-existing sim assertion
    * `if(n_epc < 'd1000) $stop()` in the arch-fault path.
    *
    * WHY this and not the others: all FOUR kernel events (__split_vma,
    * filp_flush x2, anon_pipe_read) report epc=0, yet NO trigger that detects a
    * real path to PC 0 ever fires -- not a committed indirect with target 0, not
    * a restart into the null page, and not a ROB entry committing with pc==0
    * (which DOES fire in sim for a genuine null jump).  The consistent reading is
    * that the kernel never executes at 0 at all and the EXCEPTION STATE is what
    * is wrong -- which would also explain ra values matching no call site in the
    * faulting function.  So trigger on the EPC being written wild, regardless of
    * how control got there. */
   /* ARMING GATE: at reset the ROB arrays are uninitialised (BRAM reads 0 on
    * FPGA), so n_epc computes as 0 and this fires during boot firmware -- observed
    * on 6d1f30fc, frozen at wptr=38 with the ring still showing 0xbfc000xx.  Arm
    * only after the machine is well past reset.  Default is small enough for the
    * directed sim test (which faults at ~16.7k cycles); silicon overrides it via
    * SV2V_DEFINES with a value far past boot. */
   /* Arm the wild-EPC trigger on the first USER-mode retire, not on a cycle count.
    * The old `WILD_EPC_ARM_CYCLES 10000` arm fired during the FSBL -- which runs
    * legitimately with EPC=0 -- so the trigger tripped at boot and latched the ring
    * shut at wptr=38 before the workload started.  v5, v6 and 5004523d were all
    * blinded this way, and 5004523d soaked for hours past three real userspace
    * SIGSEGVs (one with epc=0) without recording a single retire.  Arming on the
    * first user-mode commit is workload-relative, so it cannot race the firmware. */
   logic 	      r_wild_epc_armed;
   always_ff@(posedge clk)
     begin
	if(reset)
	  begin
	     r_wild_epc_armed <= 1'b0;
	  end
	else
	  begin
	     if(w_head_commit & !in_kernel_mode)
	       begin
		  r_wild_epc_armed <= 1'b1;
	       end
	  end
     end // always_ff

   wire 	      w_wild_epc = t_bump_rob_head & (n_epc[(`M_WIDTH-1):12] == 'd0) &
				   r_wild_epc_armed;
   /* USER-MODE BREAKPOINT EXCEPTION (ExcCode 09) -- the SIGFPE face of the bug.
    * A userspace `break 0x7' (the compiler's divide-by-zero guard) firing where it
    * is UNREACHABLE.  Captured TWICE on 03702fef (2026-09-06, both in `wc',
    * epc 0x40801c) with IDENTICAL operands t2=28 a3=10, and BOTH times the ring
    * did not freeze: every trigger above keys on reaching PC 0 / a null restart /
    * a wild EPC, and a break trap is none of those.  Two evidence windows lost.
    * TRADE-OFF: a break CAN fire legitimately (a real divide by zero) and the
    * freeze is sticky until the PL is reprogrammed, so a false trigger blinds the
    * board.  Accepted -- the soak workload has no legitimate div-by-zero.
    * USER mode only: the kernel's BUG()/BRK paths use break legitimately. */
   wire 	      w_user_break = t_bump_rob_head & (~in_kernel_mode) &
				     (n_cause == 5'd9);
   wire 	      w_null_target = w_null_tgt_head | w_null_tgt_two |
				      w_null_pc_head | w_wild_restart |
				      w_kernel_null_fault | w_wild_epc |
				      w_user_break;

   /* The retire ring is a flight recorder: it NEVER back-pressures retirement.
    * (debug-infra defined this alongside its own ring; the merged tree uses the
    * r_rtrace ring, whose readback encoding is the one rtdump.cc decodes.) */
   wire        w_rt_stall = 1'b0;

`ifdef ENABLE_PC_TRACE
   /* ---- retire trace ring (rich) ---------------------------------------------
    * Every field below is ALREADY unconditional in rob_entry_t, so logging costs
    * ring storage only -- no new pipeline state.  Deliberately over-collects:
    * a reproduction costs ~2.5 h, so a missing field is far more expensive than
    * an unused one.
    *
    * 256 entries x 4 words (~1 BRAM36).  Readback reuses the existing debug port:
    *   dbg_trace_index[7:0] = entry, [9:8] = word
    *   w0 = pc[31:0]         w1 = target_pc[31:0]   (RESOLVED target for branches)
    *   w2 = data[31:0]       (core_mem_rsp.data for a load == the LOADED VALUE)
    *   w3 = {flags, ldst[4:0], opcode[7:0]}
    * take_br is the resolved branch direction -- it answers directly whether the
    * guard beqz was taken, which no register dump can show.
    *
    * Frozen on a retired indirect whose target is 0 or BTB_POISON_PC. */
   /* TWO BANKS, not one array with two write ports: the machine retires two per
    * cycle, and a single array written twice in a cycle will not infer as BRAM
    * (it degrades to LUTRAM, far too costly at 256x128).  Bank E holds the head
    * slot, bank O the second retire slot, both written in the same cycle and
    * sharing one pair index.  Readback keeps the LINEAR order the driver already
    * expects: entry[0] = E[0], entry[1] = O[0], entry[2] = E[1] ...  so
    * dbg_trace_index[0] selects the bank and [7:1] the row, and the driver needs
    * no change.  WHY this matters: logging only the head hid every second
    * instruction -- both 2026-08-29 captures were missing the nop between the
    * faulting load and the branch, so the retire stream was half blind. */
   localparam LG_RT_BANK = `LG_RTRACE_ENTRIES - 1;   /* per-bank depth, log2 */
   logic [215:0]       r_rtrace_e [(1<<LG_RT_BANK)-1:0];
   logic [215:0]       r_rtrace_o [(1<<LG_RT_BANK)-1:0];
   logic [LG_RT_BANK-1:0] r_rtrace_ptr;
   logic 	       r_rtrace_frozen;
   logic [215:0]       r_rtrace_row_e, r_rtrace_row_o;

   /* Cycles since the previous committed head, saturating.  Logged with every
    * record so a long push-out (mispredict recovery, miss, replay) is visible in
    * the trace itself; the value stored with a record is the gap that PRECEDED
    * it.  The record is 144b, not 128b, because each bank is 2 RAMB36 in 512x72
    * SDP mode -- 144b is already paid for, so these bits cost no extra BRAM. */
   localparam RT_GAP_W = 8;
   logic [RT_GAP_W-1:0] r_rt_gap, n_rt_gap;
   always_comb
     begin
	n_rt_gap = w_head_commit ? 'd0 :
		   (r_rt_gap == {RT_GAP_W{1'b1}}) ? r_rt_gap : (r_rt_gap + 'd1);
     end // always_comb
   always_ff@(posedge clk)
     begin
	if(reset)
	  begin
	     r_rt_gap <= 'd0;
	  end
	else
	  begin
	     r_rt_gap <= n_rt_gap;
	  end
     end // always_ff

   /* ---- TIP-style stall ATTRIBUTION (3 bits, free) ----------------------
    * r_rt_gap already gives the CYCLES chargeable to each instruction (the
    * head-stall that preceded its retirement), so sum(gap)/insns reconciles to
    * CPI.  What it lacks is the REASON, which is what turns a gap histogram
    * into a time-proportional profile.  This adds the reason in the 3 bits that
    * were already sitting as `3'd0` padding at the top of the record -- so the
    * record stays 216b and the BRAM footprint does not change.
    *
    * Deliberately encodes only what CANNOT be recovered offline: the record
    * already carries opcode/is_store/is_br/faulted, so mem-vs-muldiv-vs-alu is
    * derived in post-processing by joining EXEC against opcode.  These codes
    * cover WHY retirement was blocked, which is invisible after the fact.
    *
    * Latched on the FIRST stalled cycle of a gap (r_rt_gap==0 and not
    * committing) and held, so the gap is attributed to what STARTED it rather
    * than to whatever happened to be true when it finally drained. */
   localparam [2:0] RT_ST_NONE  = 3'd0;  /* retired with no stall */
   localparam [2:0] RT_ST_FLUSH = 3'd1;  /* machine not ACTIVE: mispredict recovery/drain/restart */
   localparam [2:0] RT_ST_EMPTY = 3'd2;  /* ROB empty: FRONT-END starved (fetch/icache/TLB) */
   localparam [2:0] RT_ST_BP    = 3'd3;  /* retire back-pressure (single-step) */
   localparam [2:0] RT_ST_EXEC  = 3'd4;  /* head present, NOT complete: join w/ opcode offline */
   localparam [2:0] RT_ST_SER   = 3'd5;  /* serializing op in a faulted delay slot */
   localparam [2:0] RT_ST_DS    = 3'd6;  /* faulted head waiting on its delay slot */
   localparam [2:0] RT_ST_OTHER = 3'd7;  /* head complete but retire still gated */
   logic [2:0] r_rt_stall, n_rt_stall;
   wire [2:0]  w_rt_stall_cls = (r_state != ACTIVE)                     ? RT_ST_FLUSH :
			        t_rob_empty                             ? RT_ST_EMPTY :
			        w_rt_stall                              ? RT_ST_BP    :
			        t_faulted_head_and_serializing_delay    ? RT_ST_SER   :
			        (~t_rob_head_complete)                  ? RT_ST_EXEC  :
			        (t_rob_head.faulted & t_rob_head.has_delay_slot) ? RT_ST_DS :
			                                                  RT_ST_OTHER;
   always_comb
     begin
	n_rt_stall = w_head_commit   ? RT_ST_NONE :
		     (r_rt_gap == 'd0) ? w_rt_stall_cls :   /* first stalled cycle: latch */
		                        r_rt_stall;         /* hold for the rest of the gap */
     end // always_comb
   always_ff@(posedge clk)
     begin
	if(reset)
	  begin
	     r_rt_stall <= RT_ST_NONE;
	  end
	else
	  begin
	     r_rt_stall <= n_rt_stall;
	  end
     end // always_ff

   wire [31:0] 	       w_rt_flags = {25'd0,
				     t_rob_head.is_store,
				     t_rob_head.valid_dst,
				     t_rob_head.take_br,
				     t_rob_head.is_br,
				     t_rob_head.is_indirect,
				     t_rob_head.in_delay_slot,
				     t_rob_head.faulted};

   wire [31:0] 	       w_rt_flags2 = {25'd0,
				      t_rob_next_head.is_store,
				      t_rob_next_head.valid_dst,
				      t_rob_next_head.take_br,
				      t_rob_next_head.is_br,
				      t_rob_next_head.is_indirect,
				      t_rob_next_head.in_delay_slot,
				      t_rob_next_head.faulted};

   wire [215:0]        w_rt_rec_head = { r_rt_stall,
					 t_rob_head.hi_nzB,
					 t_rob_head.hi_nzA,
					 r_rob_head_ptr[`LG_ROB_ENTRIES-1:0],
					 t_rob_head.wr_echo,
					 t_rob_head.srcB_val,
					 t_rob_head.fwd_selB,
					 t_rob_head.post_restart,
					 t_rob_head.has_nullifying_delay_slot,
					 t_rob_head.has_delay_slot,
					 t_rob_head.is_ret,
					 t_rob_head.fwd_sel,   /* {fwd_int,fwd_mem} operand-mux select at execute */
					 t_rob_head.srcA_arch,
					 t_rob_head.srcA_ptr,
					 t_rob_head.pdst,
					 t_rob_head.exec_cycle,
					 r_rt_gap,
					 {{(11-`LG_BPU_TBL_SZ){1'b0}}, t_rob_head.bpu_idx},   /* was pht_idx[10:0]; same 11b slot */
					 t_rob_head.br_pred,
					 w_rt_flags[6:0],
					 t_rob_head.ldst,
					 t_rob_head.opcode,
					 t_rob_head.data[31:0],
					 t_rob_head.target_pc[31:0],
					 t_rob_head.pc[31:0] };

   wire [215:0]        w_rt_rec_two  = { r_rt_stall,
					 t_rob_next_head.hi_nzB,
					 t_rob_next_head.hi_nzA,
					 r_rob_next_head_ptr[`LG_ROB_ENTRIES-1:0],
					 t_rob_next_head.wr_echo,
					 t_rob_next_head.srcB_val,
					 t_rob_next_head.fwd_selB,
					 t_rob_next_head.post_restart,
					 t_rob_next_head.has_nullifying_delay_slot,
					 t_rob_next_head.has_delay_slot,
					 t_rob_next_head.is_ret,
					 t_rob_next_head.fwd_sel,   /* {fwd_int,fwd_mem} operand-mux select at execute */
					 t_rob_next_head.srcA_arch,
					 t_rob_next_head.srcA_ptr,
					 t_rob_next_head.pdst,
					 t_rob_next_head.exec_cycle,
					 r_rt_gap,
					 {{(11-`LG_BPU_TBL_SZ){1'b0}}, t_rob_next_head.bpu_idx},   /* was pht_idx[10:0]; same 11b slot */
					 t_rob_next_head.br_pred,
					 w_rt_flags2[6:0],
					 t_rob_next_head.ldst,
					 t_rob_next_head.opcode,
					 t_rob_next_head.data[31:0],
					 t_rob_next_head.target_pc[31:0],
					 t_rob_next_head.pc[31:0] };

   /* Filler for a cycle that retired ONE instruction: all-ones is impossible for
    * a real record (opcode ff is not a valid uop), so the dump shows ffffffff and
    * op=ff and an odd slot is never mistaken for a retired instruction. */
   wire [215:0]        w_rt_rec_none = {216{1'b1}};

   /* ---- ONE-SHOT capture mode (rt_oneshot, ctrl bit22) -------------------
    * Default is a continuously-wrapping ring that freezes on w_null_target,
    * i.e. "the last 1024 commits BEFORE a trigger".  Right for fault capture,
    * wrong for profiling: the window is only ~82us at CPI 8, it always ENDS at
    * the trigger, and a coherent dump requires HALTING the core because a live
    * ring reads torn (three reads of one index return three different values).
    *
    * One-shot: a rising edge on rt_oneshot rewinds the ring and arms it; it
    * records the next 1024 commits then freezes ITSELF.  The dump is then
    * coherent WITH THE CORE STILL RUNNING -- so the soak is never interrupted
    * and many independent windows can be sampled over time, which is what a
    * time-proportional profile needs.  Costs two flops and a comparator. */
   logic 	       r_rt_os_d, r_rt_os_arm;
   wire 	       w_rt_os_edge = rt_oneshot & ~r_rt_os_d;
   wire 	       w_rt_full    = (r_rtrace_ptr == {LG_RT_BANK{1'b1}});

   always_ff@(posedge clk)
     begin
	if(reset)
	  begin
	     r_rtrace_ptr <= 'd0;
	     r_rtrace_frozen <= 1'b0;
	     r_rt_os_d <= 1'b0;
	     r_rt_os_arm <= 1'b0;
	  end
	else
	  begin
	     r_rt_os_d <= rt_oneshot;
	     if(w_rt_os_edge)
	       begin
		  /* rewind + arm: the window STARTS here instead of ending at a trigger */
		  r_rtrace_ptr <= 'd0;
		  r_rtrace_frozen <= 1'b0;
		  r_rt_os_arm <= 1'b1;
	       end
	     else
	       begin
		  /* fault_clear (ctrl bit18) releases the freeze and puts the ring
		   * back into continuous wrapping mode.  Previously r_rtrace_frozen
		   * cleared ONLY on reset or another one-shot edge, so a one-shot
		   * profiling capture left FAULT capture blind for the rest of the
		   * run and the only way back was a PL reprogram -- which restarts
		   * the soak and destroys the very window being profiled.  Also
		   * cancels a one-shot still in flight.  w_null_target is evaluated
		   * AFTER this, so a trigger firing in the same cycle as the clear
		   * still freezes and the capture is not lost. */
		  if(fault_clear)
		    begin
		       r_rtrace_frozen <= 1'b0;
		       r_rt_os_arm <= 1'b0;
		    end
		  if(w_null_target)
		    begin
		       r_rtrace_frozen <= 1'b1;
		    end
		  if(w_head_commit & !r_rtrace_frozen)
		    begin
		       r_rtrace_e[r_rtrace_ptr] <= w_rt_rec_head;
		       r_rtrace_o[r_rtrace_ptr] <= t_retire_two ? w_rt_rec_two : w_rt_rec_none;
		       r_rtrace_ptr <= r_rtrace_ptr + 'd1;
		       if(r_rt_os_arm & w_rt_full)
			 begin
			    r_rtrace_frozen <= 1'b1;   /* buffer full: self-freeze */
			    r_rt_os_arm <= 1'b0;
			 end
		    end
	       end
	  end
	r_rtrace_row_e <= r_rtrace_e[dbg_trace_index[LG_RT_BANK:1]];
	r_rtrace_row_o <= r_rtrace_o[dbg_trace_index[LG_RT_BANK:1]];
     end // always_ff

   /* linear next-write slot = pair index * 2, so the driver's 0..255 walk is unchanged */
   wire [215:0]        w_rtrace_row = r_rtrace_sel ? r_rtrace_row_o : r_rtrace_row_e;
   logic 	       r_rtrace_sel;
   always_ff@(posedge clk)
     begin
	r_rtrace_sel <= dbg_trace_index[0];
     end
   /* Keep the frozen flag at bit 15 regardless of ring depth so the host decode
    * (frozen=(s>>15)&1, wptr=s&0x7fff) is independent of LG_RTRACE_ENTRIES. */
   assign dbg_trace_wptr = {r_rtrace_frozen, {(14-LG_RT_BANK){1'b0}}, r_rtrace_ptr, 1'b0};
   /* 216b record = 7 words.  Word select is {index[18], index[16:15]} so index[17]
    * stays free for the GHR readback in core_l1d_l1i (w_hist_sel = index[17:15]>=4). */
   wire [2:0] w_rt_word = {dbg_trace_index[18], dbg_trace_index[16:15]};
   /* DEBUG: index[14]=1 snarfs the ROB-indexed mem-op PC shadow (rob slot in
    * index[3:0]) instead of a ring word.  index[14] is unused by ring reads (row
    * = index[10:1] at LG_RTRACE_ENTRIES<=11, word = index[18]/[16:15]), and with
    * index[17:15]<4 and index[19]=0 the outer core_l1d_l1i mux passes it through. */
   /* DEBUG: index[14]&index[4] snarfs the last-restart record, word = index[2:0].
    * word0's 0x5A top byte is the live-probe discriminator. */
   wire w_rst_sel = dbg_trace_index[14] & dbg_trace_index[4];
   wire [31:0] w_rst_word0 = {8'h5A, 8'd0, {(8-`LG_ROB_ENTRIES){1'b0}}, r_restart_head_ptr, r_cause, r_restart_why};
   wire [31:0] w_rst_word = (dbg_trace_index[2:0] == 3'd0) ? w_rst_word0 :
			    (dbg_trace_index[2:0] == 3'd1) ? r_restart_pc[31:0] :
			    (dbg_trace_index[2:0] == 3'd2) ? r_restart_src_pc[31:0] :
			    (dbg_trace_index[2:0] == 3'd3) ? r_restart_cycle :
			    (dbg_trace_index[2:0] == 3'd4) ? r_restart_count :
			    r_restart_retired;
   assign dbg_trace_data = w_rst_sel ? w_rst_word :
			   dbg_trace_index[14] ? w_dbg_memop_pc :
			   (w_rt_word == 3'd4) ? w_rtrace_row[159:128] :
			   (w_rt_word == 3'd5) ? w_rtrace_row[191:160] :
			   (w_rt_word == 3'd6) ? {8'd0, w_rtrace_row[215:192]} :
			   (w_rt_word == 3'd7) ? 32'd0 :
			   (dbg_trace_index[16:15] == 2'd0) ? w_rtrace_row[31:0]   :
			   (dbg_trace_index[16:15] == 2'd1) ? w_rtrace_row[63:32]  :
			   (dbg_trace_index[16:15] == 2'd2) ? w_rtrace_row[95:64]  :
			                                      w_rtrace_row[127:96];
`elsif ENABLE_TRACE_BUFFER
   // ---- trace buffer: log head + next_head {pc,counters,flags} on retire OR arch-fault (incl. II) ----
   // row = 12 words = 2 records; record = {pc, fetch_cycle, alloc_cycle, complete_cycle, retire_cycle, {valid,faulted,cause}}
   // NOTE: verilator-only (see machine.vh) -- the 256x384b RAM dominates FPGA build time.
   logic [11:0][31:0] r_trace_ram [255:0];
   logic [7:0] 	      r_trace_wptr;
   logic [11:0][31:0] r_trace_row;
   logic 	      r_trace_frozen;
   always_ff@(posedge clk)
     begin
	if(reset)
	  begin
	     r_trace_frozen <= 1'b0;
	  end
	else if(w_null_target)
	  begin
	     r_trace_frozen <= 1'b1;
	  end
     end // always_ff

   wire 	      w_trace_we   = (t_retire | (t_arch_fault & (|n_cause))) & (r_state != DEAD) & !r_trace_frozen;

`ifdef VERILATOR
   /* make the event loud in sim too -- on silicon it shows up by itself as
    * epc/BadVA = deadcafc in the oops, but a sim run would otherwise only
    * reveal it via the frozen-ring bit, which nobody thinks to read. */
   always_ff@(posedge clk)
     begin
	/* only the FIRST event -- w_null_target is driven by sticky sources
	 * (w_user_break among them), so an unqualified print emits every cycle
	 * for the rest of the run (8.9GB of log in two minutes of a Linux boot). */
	if(w_null_target & (~r_trace_frozen))
	  begin
	     if(w_wild_epc)
	       begin
		  $display("[WILD-EPC] cyc=%d n_epc=%x cause=%d kernel=%b head_pc=%x",
			   r_cycle, n_epc, n_cause, in_kernel_mode, t_rob_head.pc);
	       end
	     if(w_kernel_null_fault)
	       begin
		  $display("[KERN-NULL] cyc=%d badvaddr=%x cause=%d", r_cycle, n_badvaddr, n_cause);
	       end
	     if(w_user_break)
	       begin
		  $display("[USER-BREAK] cyc=%d head_pc=%x cause=%d kernel=%b",
			   r_cycle, t_rob_head.pc, n_cause, in_kernel_mode);
	       end
	     if(w_wild_restart)
	       begin
		  $display("[WILD-RESTART] cyc=%d restart_pc=%x (head pc=%x op=%d in_ds=%b)",
			   r_cycle, n_restart_pc, t_rob_head.pc, t_rob_head.opcode,
			   t_rob_head.in_delay_slot);
	       end
	     if(w_null_pc_head)
	       begin
		  $display("[NULL-PC] cyc=%d commit of an entry FETCHED from 0 (faulted=%b in_ds=%b)",
			   r_cycle, t_rob_head.faulted, t_rob_head.in_delay_slot);
	       end
	     $display("[NULL-TARGET] cyc=%d slot=%s pc=%x target=%x src=%s",
		      r_cycle, w_null_tgt_head ? "head" : "two",
		      w_null_tgt_head ? t_rob_head.pc : t_rob_next_head.pc,
		      w_null_tgt_head ? t_rob_head.target_pc : t_rob_next_head.target_pc,
		      ((w_null_tgt_head ? t_rob_head.target_pc : t_rob_next_head.target_pc)
		       == `BTB_POISON_PC) ? "COLD-BTB-POISON" : "REAL-NULL");
	  end
     end // always_ff
`endif
   wire [31:0] 	      w_head_flags = {25'd0, (t_retire | t_arch_fault), t_arch_fault, n_cause};
   wire [31:0] 	      w_next_flags = {25'd0, t_retire_two, 1'b0, 5'd0};
   always_ff@(posedge clk)
     begin
	if(reset) r_trace_wptr <= 8'd0;
	else if(w_trace_we)
	  begin
	     r_trace_ram[r_trace_wptr] <=
		{ w_next_flags, r_cycle[31:0], t_rob_next_head.complete_cycle[31:0], t_rob_next_head.alloc_cycle[31:0], t_rob_next_head.fetch_cycle[31:0], t_rob_next_head.pc[31:0],
		  w_head_flags, r_cycle[31:0], t_rob_head.complete_cycle[31:0],      t_rob_head.alloc_cycle[31:0],      t_rob_head.fetch_cycle[31:0],      t_rob_head.pc[31:0] };
	     r_trace_wptr <= r_trace_wptr + 8'd1;
	  end
	r_trace_row <= r_trace_ram[dbg_trace_index[11:4]];
     end
   /* MSB of the wptr readback = "ring is frozen on a null-target event", so the
    * host can tell a captured trace from a live wrapping one with no new reg. */
   assign dbg_trace_wptr = {7'd0, r_trace_frozen, r_trace_wptr};   /* port widened to 16b for the 32K PC-trace ring */
   assign dbg_trace_data = r_trace_row[dbg_trace_index[3:0]];
`elsif STALL_SNAP
   /* debug: stall snapshot on the otherwise-unused trace port (index[4:0] = word).
    * The machine is wedged when this is read, so live values are the snapshot. */
   logic [31:0] r_snap_since_retire;
   logic [31:0] r_snap_word;
   always_ff@(posedge clk)
     begin
	r_snap_since_retire <= (reset || t_retire) ? 32'd0 : (r_snap_since_retire + 32'd1);
	r_snap_word <= (dbg_trace_index[4:0] == 5'd0) ? {16'h5AA5, 2'd0, r_state, t_rob_head_complete, t_rob_head.faulted, t_rob_empty, 6'd0} :
		       (dbg_trace_index[4:0] == 5'd1) ? t_rob_head.pc[31:0] :
		       (dbg_trace_index[4:0] == 5'd2) ? {1'b0, t_rob_head.srcA_ptr, 1'b0, t_rob_head.pdst, 1'b0, t_rob_head.old_pdst, {(8-`LG_ROB_ENTRIES-1){1'b0}}, r_rob_head_ptr} :
		       (dbg_trace_index[4:0] == 5'd3) ? {{(32-N_ROB_ENTRIES){1'b0}}, r_rob_inflight} :
		       (dbg_trace_index[4:0] == 5'd4) ? {24'd0, mem_quiet, mem_color_busy, restart_color, w_exec_color_pending, memq_empty, 1'b0} :
		       (dbg_trace_index[4:0] == 5'd5) ? r_snap_since_retire :
		       (dbg_trace_index[4:0] == 5'd6) ? {1'b0, r_alloc_rat[27], 1'b0, r_retire_rat[27], 1'b0, r_alloc_rat[26], 1'b0, r_retire_rat[26]} :
		       (dbg_trace_index[4:0] == 5'd7) ? {{(8-`LG_ROB_ENTRIES-1){1'b0}}, r_rob_tail_ptr, 24'd0} :
		       (dbg_trace_index[4:0] >= 5'd8 && dbg_trace_index[4:0] < 5'd18) ? w_dbg_exec_snap[{dbg_trace_index[4:0] - 5'd8, 5'd0} +: 32] :
		       32'hDEADBEEF;
     end
   assign dbg_trace_wptr = 'd0;
   assign dbg_trace_data = r_snap_word;
`else
   assign dbg_trace_wptr = 'd0;
   assign dbg_trace_data = 'd0;
`endif

   assign took_irq  = t_wr_epc & (r_cause == 5'd0);
   assign cp0_count = w_cp0_count;
   assign cp0_random = w_cp0_random;
   assign l1i_flush_done = n_l1i_flush_complete;
   assign l1d_flush_done = n_l1d_flush_complete;
   assign l2_flush_done = n_l2_flush_complete;
   
   assign dbg_rob_inflight = r_rob_inflight;
   popcount #(`LG_ROB_ENTRIES) inflight0 (.in(r_rob_inflight), 
					  .out(inflight));

   
   uop_t t_uop, t_dec_uop, t_alloc_uop;
   uop_t t_uop2, t_dec_uop2, t_alloc_uop2;
      
   assign insn_ack = !t_dq_full && insn_valid && (r_state == ACTIVE) && !r_oldest_first_pending;
   assign insn_ack_two = !t_dq_full &&
			 insn_valid &&
			 !t_dq_next_full &&
			 insn_valid_two && (r_state == ACTIVE) && !r_oldest_first_pending;
   
   assign restart_pc = r_restart_pc;
   assign restart_src_pc = r_restart_src_pc;
   assign restart_src_is_indirect = r_restart_src_is_indirect;

   assign dead_rob_mask = r_rob_dead_insns;
   assign restart_valid = r_restart_valid;

   /* clr_link_reg: pulse on exception (WRITE_EPC) or ERET retirement only.
    * Branch mispredictions must NOT clear the link register. */
   assign clr_link_reg = (r_state == WRITE_EPC) ||
                         (r_state == ACTIVE && t_can_retire_rob_head &&
                          t_rob_head.faulted && !t_arch_fault &&
                          t_rob_head.opcode == ERET);

   
   assign branch_pc = r_branch_pc;
   assign branch_target = r_branch_target;
   assign branch_is_indirect = r_branch_is_indirect;
   assign branch_pc_valid = r_branch_valid;
   assign branch_fault = r_branch_fault;
   assign branch_bpu_idx = r_branch_bpu_idx;
   
   assign took_branch = r_took_branch;
   
   
   logic [63:0] r_cycle;
   logic [31:0] r_serialize_cycle;
   logic [31:0] r_daddiu_decode_cycle;
   always_ff@(posedge clk)
     begin
	r_cycle <= reset ? 'd0 : r_cycle + 'd1;

     end

   /* DEBUG last-restart record: stamp the cycle + count on the restart edge
    * (restart_valid is held until acked in the serialize/flush states), and
    * count retires since -- 0 retired = wedged straight out of the restart. */
   wire w_restart_edge = n_restart_valid & !r_restart_valid;
   always_ff@(posedge clk)
     begin
	r_restart_cycle <= reset ? 'd0 : w_restart_edge ? r_cycle[31:0] : r_restart_cycle;
	r_restart_count <= reset ? 'd0 : w_restart_edge ? (r_restart_count + 'd1) : r_restart_count;
	r_restart_retired <= (reset | w_restart_edge) ? 'd0 :
			     (r_restart_retired + {30'd0, t_retire_two, t_retire & !t_retire_two});
     end // always_ff@ (posedge clk)

`ifdef VERILATOR
   // race probe: stamp when 64b-mode (KX) flips and when the kernel_entry
   // daddiu (0x..88300d78) allocates, to measure the decode-vs-mode margin.
   logic r_64b_prev_dbg;
   always_ff@(posedge clk) begin
      if(reset) r_64b_prev_dbg <= 1'b0;
      else begin
	 r_64b_prev_dbg <= w_in_64b_mode;
	 if(w_in_64b_mode != r_64b_prev_dbg)
	   $display("[mode] cyc=%0d 64b_mode -> %b", r_cycle, w_in_64b_mode);
	 if(t_uop.pc[31:0] == 32'h88300d78)
	   $display("[dec0] cyc=%0d op=%0d is_ii=%b mode=%b", r_cycle, t_uop.op, (t_uop.op == II), w_in_64b_mode);
	 if(t_uop2.pc[31:0] == 32'h88300d78)
	   $display("[dec1] cyc=%0d op=%0d is_ii=%b mode=%b", r_cycle, t_uop2.op, (t_uop2.op == II), w_in_64b_mode);
	 if(t_alloc && (t_alloc_uop.pc[31:0] == 32'h88300d78))
	   $display("[daddiu] cyc=%0d slot0 op=%0d is_ii=%b mode=%b", r_cycle, t_alloc_uop.op, (t_alloc_uop.op == II), w_in_64b_mode);
	 if(t_alloc_two && (t_alloc_uop2.pc[31:0] == 32'h88300d78))
	   $display("[daddiu] cyc=%0d slot1 op=%0d is_ii=%b mode=%b", r_cycle, t_alloc_uop2.op, (t_alloc_uop2.op == II), w_in_64b_mode);
      end
   end
`endif


`ifdef VERILATOR
   logic [31:0] r_clear_cnt;
   logic [31:0]	r_fault_cnt;
   always_ff@(posedge clk)
     begin
	if(reset)
	  begin
	     r_fault_cnt <= 'd0;
	  end
	else
	  begin
	     /* DISABLED: net exception-vs-ERET count > 10 is not a reliable livelock
	      * signal on a long healthy boot -- IRIX's R4000 clock-calibration spin
	      * (get_r4k_counter @0x880058xx) takes a periodic timer IRQ every ~660k
	      * cycles, and the +1/-1 accounting drifts.  The no-retire watchdog in
	      * henry_tb (64k cycles with zero retirement) is the reliable hang detector. */
	     // if(r_fault_cnt > 'd10)
	     //   begin
	     //      $display("you've recursively faulted yourself to death");
	     //      $stop();
	     //   end

	     if(t_retire &( t_rob_head.opcode == ERET))
	       begin
		  if(r_fault_cnt != 32'd0)
		    begin
		       r_fault_cnt <= r_fault_cnt - 32'd1;
		    end
	       end
	     else if(t_wr_epc)
	       begin
		  r_fault_cnt <= r_fault_cnt + 'd1;
	       end
	  end
     end
   
   always_ff@(posedge clk)
     begin
	if(reset)
	  begin
	     r_clear_cnt <= 'd0;
	  end
	else if(n_ds_done)
	  begin
	     r_clear_cnt <=  r_clear_cnt + 'd1;
	  end
     end
`endif


   always_ff@(posedge clk)
     begin
	if(reset)
	  begin
	     r_flush_req_l1i <= 1'b0;
	     r_flush_line_req_l1i <= 1'b0;
	     r_flush_line_idx_l1i <= 'd0;
	     r_flush_req_l1d <= 1'b0;
	     r_flush_cl_req <= 1'b0;
	     r_flush_cl_addr <= 'd0;
	     r_flush_cl_inval <= 1'b0;
	     r_flush_pg_req <= 1'b0;
	     r_restart_pc <= 'd0;
	     r_restart_src_pc <= 'd0;
	     r_restart_src_is_indirect <= 1'b0;
	     r_restart_why <= RST_WHY_NONE;
	     r_restart_head_ptr <= 'd0;
	     r_branch_pc <= 'd0;
	     r_branch_target <= 'd0;
	     r_branch_is_indirect <= 1'b0;
	     r_took_branch <= 1'b0;
	     r_branch_valid <= 1'b0;
	     r_branch_fault <= 1'b0;
	     r_branch_bpu_idx <= 'd0;
	     r_in_delay_slot <= 1'b0;
	     r_restart_valid <= 1'b0;
	     r_has_delay_slot <= 1'b0;
	     r_has_nullifying_delay_slot <= 1'b0;
	     r_take_br <= 1'b0;
	     r_got_break <= 1'b0;
	     r_pending_break <= 1'b0;
	     r_pending_ud <= 1'b0;
	     r_pending_bad_addr <= 1'b0;	     	     
	     r_got_ud <= 1'b0;
	     r_got_bad_addr <= 1'b0;
	     r_ready_for_resume <= 1'b0;
	     r_l1i_flush_complete <= 1'b0;
	     r_l1d_flush_complete <= 1'b0;
	     r_l2_flush_complete <= 1'b0;
	     r_xflush_pend <= 1'b0;
	     r_xflush_done <= 1'b0;
	     r_xflush_ppn <= 'd0;
	     r_xflush_whole <= 1'b1;
	     r_xflush_drop <= 1'b0;
	     r_ds_done <= 1'b0;
	     drain_ds_complete <= 1'b0;
	     r_epc <= 'd0;
	     r_badvaddr <= 'd0;
	     r_exc_in_delay <= 1'b0;	     
	  end
	else
	  begin
	     r_flush_req_l1d <= n_flush_req_l1d;
	     r_flush_req_l1i <= n_flush_req_l1i;
	     r_flush_line_req_l1i <= n_flush_line_req_l1i;
	     r_flush_line_idx_l1i <= n_flush_line_idx_l1i;
	     r_flush_cl_req <= n_flush_cl_req;
	     r_flush_cl_addr <= n_flush_cl_addr;
	     r_flush_cl_inval <= n_flush_cl_inval;
	     r_flush_pg_req <= n_flush_pg_req;
	     r_restart_pc <= n_restart_pc;
	     r_restart_src_pc <= n_restart_src_pc;
	     r_restart_src_is_indirect <= n_restart_src_is_indirect;
	     r_restart_why <= n_restart_why;
	     r_restart_head_ptr <= n_restart_head_ptr;
	     r_branch_pc <= n_branch_pc;
	     r_branch_target <= n_branch_target;
	     r_branch_is_indirect <= n_branch_is_indirect;
	     r_took_branch <= n_took_branch;
	     r_branch_valid <= n_branch_valid;
	     r_branch_fault <= n_branch_fault;
	     r_branch_bpu_idx <= n_branch_bpu_idx;
	     r_in_delay_slot <= n_in_delay_slot;
	     r_restart_valid <= n_restart_valid;
	     r_has_delay_slot <= n_has_delay_slot;
	     r_has_nullifying_delay_slot <= n_has_nullifying_delay_slot;
	     r_take_br <= n_take_br;
	     r_got_break <= n_got_break;
	     r_pending_break <= n_pending_break;
	     r_pending_ud <= n_pending_ud;
	     r_pending_bad_addr <= n_pending_bad_addr;	     	     
	     r_got_ud <= n_got_ud;
	     r_got_bad_addr <= n_got_bad_addr;
	     r_ready_for_resume <= n_ready_for_resume;
	     r_l1i_flush_complete <= n_l1i_flush_complete;
	     r_l1d_flush_complete <= n_l1d_flush_complete;
	     r_l2_flush_complete <= n_l2_flush_complete;
	     r_xflush_pend <= n_xflush_pend;
	     r_xflush_done <= n_xflush_done;
	     r_xflush_ppn <= n_xflush_ppn;
	     r_xflush_whole <= n_xflush_whole;
	     r_xflush_drop <= n_xflush_drop;
	     r_ds_done <= n_ds_done;
	     drain_ds_complete <= r_ds_done;
	     r_epc <= n_epc;
	     r_badvaddr <= n_badvaddr;	     
	     r_exc_in_delay <= n_exc_in_delay;
	  end
     end // always_ff@ (posedge clk)

   
   always_ff@(posedge clk)
     begin
	if(reset)
	  begin
	     r_state <= FLUSH_FOR_HALT;
	     r_restart_cycles <= 'd0;
	     r_machine_clr <= 1'b0;
	     r_post_restart_arm <= 1'b0;
	     r_got_restart_ack <= 1'b0;
	     r_cause <= 5'd0;
	     r_ce <= 2'd0;
	     r_tlb_refill <= 1'b0;
	     r_xtlb_refill <= 1'b0;
	     r_save_to_tlb_regs <= 1'b0;
	     r_has_badvaddr <= 1'b0;
	     r_pending_fault <= 1'b0;
	     r_oldest_first_pending <= 1'b0;
	     r_serialize_cycle <= 32'd0;
	     r_daddiu_decode_cycle <= 32'd0;
	  end
	else
	  begin
	     r_state <= n_state;
	     r_restart_cycles <= n_restart_cycles;
	     r_machine_clr <= n_machine_clr;
	     if(r_state == RAT && n_state == ACTIVE)
	       begin
		  r_post_restart_arm <= 1'b1;
	       end
	     else if(t_alloc)
	       begin
		  r_post_restart_arm <= 1'b0;
	       end
	     r_got_restart_ack <= n_got_restart_ack;
	     r_cause <= n_cause;
	     r_ce <= n_ce;
	     r_tlb_refill <= n_tlb_refill;
	     r_xtlb_refill <= n_xtlb_refill;
	     r_save_to_tlb_regs <= n_save_to_tlb_regs;
	     r_has_badvaddr <= n_has_badvaddr;
	     r_pending_fault <= n_pending_fault;
	     r_oldest_first_pending <= n_oldest_first_pending;
	     r_serialize_cycle <= (n_oldest_first_pending && !r_oldest_first_pending) ? r_cycle[31:0] : r_serialize_cycle;
	     if((t_alloc && (t_alloc_uop.pc[31:0] == 32'h88300d78)) || (t_alloc_two && (t_alloc_uop2.pc[31:0] == 32'h88300d78)))
	       r_daddiu_decode_cycle <= r_cycle[31:0];
	  end
     end

   always_ff@(posedge clk)
     begin
	if(reset)
	  begin
	     r_arch_a0 <= 'd0;
	  end
	else if(t_rob_head.valid_dst && t_retire && t_rob_head.ldst == 'd4)
	  begin
	     r_arch_a0 <= t_rob_head.data[31:0];
	  end
     end
   
   always_ff@(posedge clk)
     begin
   	if(reset)
   	  begin
   	     retire_reg_ptr <= 'd0;
   	     retire_reg_data <= 'd0;
   	     retire_reg_valid <= 1'b0;
   	     retire_reg_two_ptr <= 'd0;
   	     retire_reg_two_data <= 'd0;
   	     retire_reg_two_valid <= 1'b0;
   	     retire_fp_reg_ptr <= 'd0;
   	     retire_fp_reg_data <= 'd0;
   	     retire_fp_reg_valid <= 1'b0;
   	     retire_fp_reg_two_ptr <= 'd0;
   	     retire_fp_reg_two_data <= 'd0;
   	     retire_fp_reg_two_valid <= 1'b0;
   	     retire_fcr_reg_ptr <= 'd0;
   	     retire_fcr_reg_data <= 'd0;
   	     retire_fcr_reg_valid <= 1'b0;
   	     retire_fcr_reg_two_ptr <= 'd0;
   	     retire_fcr_reg_two_data <= 'd0;
   	     retire_fcr_reg_two_valid <= 1'b0;
   	     retire_valid <= 1'b0;
	     retire_two_valid <= 1'b0;
	     
   	     retire_pc <= 'd0;
	     retire_two_pc <= 'd0;
	     retire_op <= 'd0;
	     retire_two_op <= 'd0;
	     
	     retire_delay_slot <= 1'b0;
	     retired_call <= 1'b0;
	     retired_ret <= 1'b0;
	     retired_rob_ptr_valid <= 1'b0;
	     
	     retired_rob_ptr_two_valid <= 1'b0;
	     retired_rob_ptr <= 'd0;
	     retired_rob_ptr_two <= 'd0;
   	  end
   	else
   	  begin
   	     retire_reg_ptr <= t_rob_head.ldst;
   	     retire_reg_data <= t_rob_head.data;
   	     retire_reg_valid <= t_rob_head.valid_dst && t_retire;
   	     retire_reg_two_ptr <= t_rob_next_head.ldst;
   	     retire_reg_two_data <= t_rob_next_head.data;
   	     retire_reg_two_valid <= t_rob_next_head.valid_dst && t_retire_two;
   	     retire_fp_reg_ptr <= t_rob_head.ldst;
   	     retire_fp_reg_data <= t_rob_head.data;
   	     retire_fp_reg_valid <= t_rob_head.valid_fp_dst && t_retire;
   	     retire_fp_reg_two_ptr <= t_rob_next_head.ldst;
   	     retire_fp_reg_two_data <= t_rob_next_head.data;
   	     retire_fp_reg_two_valid <= t_rob_next_head.valid_fp_dst && t_retire_two;
   	     retire_fcr_reg_ptr <= t_rob_head.ldst;
   	     retire_fcr_reg_data <= t_rob_head.data;
   	     retire_fcr_reg_valid <= t_rob_head.valid_fcr_dst && t_retire;
   	     retire_fcr_reg_two_ptr <= t_rob_next_head.ldst;
   	     retire_fcr_reg_two_data <= t_rob_next_head.data;
   	     retire_fcr_reg_two_valid <= t_rob_next_head.valid_fcr_dst && t_retire_two;
	     
   	     /* an injected ext_flush uop (XFLUSH/XPG_*) leaves the ROB like any CACHE op
   	      * but is NOT an architectural instruction -- it replaced the insn at .pc,
   	      * which the restart re-executes -- so it must not count as retired (an IRQ
   	      * uop never retires either: it commits through the fault path). */
   	     retire_valid <= t_retire & !is_xflush(t_rob_head.opcode);
	     retire_two_valid <= t_retire_two;
   	     retire_pc <= t_rob_head.pc;
	     retire_two_pc <= t_rob_next_head.pc;
`ifdef VERILATOR
	     retire_insn <= r_rob_raw_insn[r_rob_head_ptr[`LG_ROB_ENTRIES-1:0]];
	     retire_two_insn <= r_rob_raw_insn[r_rob_next_head_ptr[`LG_ROB_ENTRIES-1:0]];
`endif
	     retire_delay_slot <= t_rob_head.in_delay_slot && t_retire;
	     retired_ret <= t_rob_head.is_ret && t_retire;
	     retired_call <= t_rob_head.is_call && t_retire;

	     retire_op <= t_rob_head.opcode;
	     retire_two_op <= t_rob_next_head.opcode;
	     
	     retired_rob_ptr_valid <= t_retire;
	     
	     retired_rob_ptr_two_valid <= t_retire_two;
	     retired_rob_ptr <= r_rob_head_ptr[`LG_ROB_ENTRIES-1:0];
	     retired_rob_ptr_two <= r_rob_next_head_ptr[`LG_ROB_ENTRIES-1:0];
   	  end
     end
`ifdef VERILATOR
   logic [63:0] last_retire_pc;
   always_ff@(posedge clk)
     begin
	if(retire_valid)
	  begin
	     last_retire_pc <= retire_pc;
	  end
     end
   always_ff@(negedge clk)
     begin
	localparam ZP = (64-`M_WIDTH);	
	
	/* sim-only "ran off into nowhere" guard, tuned for the Linux kernel (all
	 * kseg0 @ 0x88xxxxxx).  DISABLED: it false-trips on IRIX, which legitimately
	 * executes uncached in kseg1 -- its cache-init jumps to the kseg1 alias of its
	 * own text (e.g. `or v0,0x88011734,0xa0000000; jr v0` -> 0xa8011734) to size/
	 * flush the caches uncached.  The FPGA has no such guard anyway. */
	// if(retire_valid & retire_pc[63] & (retire_pc[31:0] > 32'h89000000)
	//    & ~((retire_pc[31:0] >= 32'hbfc00000) & (retire_pc[31:0] <= 32'hbfc0ffff)))
	//   begin
	//      $display("jumped into lala land at with pc %x at cycle %d, last retire pc %x", retire_pc, r_cycle, last_retire_pc);
	//      $stop();
	//   end
	
	

	record_alloc(t_rob_full ? 32'd1 : 32'd0,
		     t_alloc ? 32'd1 : 32'd0,
		     t_alloc_two ? 32'd1 : 32'd0,
		     t_dq_empty ? 32'd1 : 32'd0,
		     
		     t_uq_full ? 32'd1 : 32'd0,
		     t_uq_next_full ? 32'd1 : 32'd0,
		     
		     t_dq_empty ? 32'd0 : 32'd1,
		     !t_dq_next_empty && !t_dq_empty ? 32'd1 : 32'd0,
		     t_possible_to_alloc ? 32'd1 : 32'd0);
			    
   	if(t_retire)
   	  begin
`ifdef PIPETRACE
	     pt_retire({{(32-`LG_ROB_ENTRIES){1'b0}}, r_rob_head_ptr[`LG_ROB_ENTRIES-1:0]});
`endif
	     record_retirement({{ZP{1'b0}},t_rob_head.pc}, 
   			       t_rob_head.fetch_cycle,
   			       t_rob_head.alloc_cycle,
   			       t_rob_head.complete_cycle,
   			       r_cycle,
			       t_rob_head.faulted ? 32'd1 : 32'd0,
			       32'd0,
			       32'd0,
			       32'd0);
   	  end
   	if(t_retire_two)
   	  begin
`ifdef PIPETRACE
	     pt_retire({{(32-`LG_ROB_ENTRIES){1'b0}}, r_rob_next_head_ptr[`LG_ROB_ENTRIES-1:0]});
`endif
	     record_retirement({{ZP{1'b0}},t_rob_next_head.pc},
   			       t_rob_next_head.fetch_cycle,
   			       t_rob_next_head.alloc_cycle,
   			       t_rob_next_head.complete_cycle,
   			       r_cycle,
			       t_rob_next_head.faulted ? 32'd1 : 32'd0,
			       32'd0,
			       32'd0,
			       32'd0);	     
   	  end // if (t_retire_two)


	if(r_state == RAT && n_state == ACTIVE)
	  begin
	     record_restart(r_restart_cycles);
	  end
	if(r_state == DRAIN && n_state == RAT)
	  begin
	     record_ds_restart(r_restart_cycles);
	  end
	    
     end // always_ff@ (negedge clk)
`endif
   
   
//`define DEBUG
`ifdef VERILATOR
   logic [31:0] t_faults, t_branches;
   rob_entry_t t_dbg_rob;
   always_comb
     begin
	t_faults = 'd0;
	t_branches = 'd0;
	t_dbg_rob = '0;
	for(logic [`LG_ROB_ENTRIES:0] i = r_rob_head_ptr; i != (r_rob_tail_ptr); i=rob_ptr_inc(i, 2'd1))
	  begin
	     t_dbg_rob = i[0] ? rob_merge(r_mrob_odd[i[`LG_ROB_ENTRIES-1:1]], r_rob_odd[i[`LG_ROB_ENTRIES-1:1]]) :
		  rob_merge(r_mrob_even[i[`LG_ROB_ENTRIES-1:1]], r_rob_even[i[`LG_ROB_ENTRIES-1:1]]);
	     if(r_rob_complete[i[`LG_ROB_ENTRIES-1:0]]  && t_dbg_rob.faulted)
	       begin
		  t_faults = t_faults + 'd1;
	       end
	     if(t_dbg_rob.is_br && r_rob_complete[i[`LG_ROB_ENTRIES-1:0]])
	       begin
		  t_branches = t_branches + 'd1;
	       end
	  end
     end // always_comb
   
   always_ff@(negedge clk)
     begin
	record_faults(t_faults);
	record_branches(t_branches);
     end
`endif
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
