dsheffie/r9999/decode_mips.sv

`include "machine.vh"
`include "rob.vh"
`include "uop.vh"

module decode_mips(
		   in_kernel_mode,
		   in_supervisor_mode,
		   in_user_mode,
		   in_64b_kernel_mode,
		   in_64b_supervisor_mode,
		   in_64b_user_mode,
		   cu1,
		   fr,
		   irq,
		   xflush,
		   xflush_op,
		   tlb_miss,
		   tlb_invalid,
		   misaligned,
		   bad_va,
		   insn,
		   pc,
		   insn_pred,
		   bpu_idx,
		   insn_pred_target,
`ifdef ENABLE_CYCLE_ACCOUNTING
		   fetch_cycle,
`endif
		   uop);
   input logic			in_kernel_mode;
   input logic			in_supervisor_mode;
   input logic			in_user_mode;
   input logic			in_64b_kernel_mode;
   input logic			in_64b_supervisor_mode;
   input logic			in_64b_user_mode;
   input logic			cu1;   /* Status.CU1 (coprocessor-1 / FPU enable) */
   input logic			fr;    /* Status.FR (FP register mode: 1=32x64b, 0=16 even/odd pairs) */
   input logic			irq;
   /* an ARM-requested whole-cache flush is pending: replace this (non-delay-slot)
    * instruction with a serializing whole-L1D CACHE op, exactly as an IRQ
    * replaces it; the core restarts at this pc once the flush completes. */
   input logic			xflush;
   /* the injected flush's op (XFLUSH / XPG_WBINV / XPG_INV).  The page it names is
    * NOT carried in the uop: only one ext flush is pending at a time, so the core
    * reads it from its latched request at the ROB head. */
   input opcode_t		xflush_op;
   input logic			tlb_miss;
   input logic			tlb_invalid;
   input logic			misaligned;
   input logic			bad_va;
   input logic [31:0]		insn;
   input logic [`M_WIDTH-1:0] pc;
   input logic 	      insn_pred;
   input logic [`LG_BPU_TBL_SZ-1:0] bpu_idx;
   input logic [`M_WIDTH-1:0]	insn_pred_target;
`ifdef ENABLE_CYCLE_ACCOUNTING   
   input logic [63:0]		fetch_cycle;
`endif
   output			uop_t uop;

   wire [5:0]			opcode = insn[31:26];
   wire				is_nop = (insn == 32'd0);
   wire				is_ehb = (insn == 32'd192);
   
   
   /* how many zero pad bits for reg specifiers */
   localparam			ZP = (`LG_PRF_ENTRIES-5);

   wire				w_in_64b_mode;
   generate
      if(`M_WIDTH==64)
	begin
	   /* 64-bit OPERATIONS are always valid in Kernel mode (independent of KX --
	    * KX gates 64-bit addressing + XTLB-vector selection, not op availability).
	    * Supervisor/User require SX/UX.  (Gating kernel ops on KX was the root
	    * cause of the kernel_entry daddiu RI / 64b-mode silicon hazard.) */
	   assign w_in_64b_mode = in_kernel_mode |
				  in_64b_user_mode |
				  in_64b_supervisor_mode;
	end
      else
	begin
	   assign w_in_64b_mode =1'b0;
	end
   endgenerate
   
   
   wire [`LG_PRF_ENTRIES-1:0]	rs = {{ZP{1'b0}},insn[25:21]};
   wire [`LG_PRF_ENTRIES-1:0]	rt = {{ZP{1'b0}},insn[20:16]};
   wire [`LG_PRF_ENTRIES-1:0]	rd = {{ZP{1'b0}},insn[15:11]};
   /* (D)MTC0 commits at retire (exec.sv r_cp0_stage_*) and is ordered against every
    * other CP0 op by the CP0 sequence (uop.vh is_cp0_wr/is_cp0_rd), so it needs no
    * serialization -- EXCEPT for registers consumed implicitly by fetch/decode/
    * translate/interrupt logic outside that ordering: those still drain and refetch.
    * Plain: Index(0) EntryLo0(2) EntryLo1(3) Context(4) PageMask(5) console(7)
    * EPC(14) XContext(20) ErrorEPC(30). */
   wire 	w_mtc0_plain = (insn[15:11] == 5'd0) | (insn[15:11] == 5'd2) |
			 (insn[15:11] == 5'd3) | (insn[15:11] == 5'd4) |
			 (insn[15:11] == 5'd5) | (insn[15:11] == 5'd7) |
			 (insn[15:11] == 5'd14) | (insn[15:11] == 5'd20) |
			 (insn[15:11] == 5'd30);
   /* (D)MFC0/(D)MTC0 must have insn[10:0] zero -- except the R10000's PerfCount ($25),
    * whose low bits pick counter/control and which counter (mtps/mtpc, mfps/mfpc).
    * r9999 has no counters: all four selects share the one $25. */
`ifdef ENABLE_R10000
   wire 	w_cop0_sel_ok = (insn[10:0] == 11'd0) | (insn[15:11] == 5'd25);
`else
   wire 	w_cop0_sel_ok = (insn[10:0] == 11'd0);
`endif

   wire [`LG_PRF_ENTRIES-1:0]	fs = {{ZP{1'b0}},insn[15:11]};
   wire [`LG_PRF_ENTRIES-1:0]	ft = {{ZP{1'b0}},insn[20:16]};
   wire [`LG_PRF_ENTRIES-1:0]	fd = {{ZP{1'b0}},insn[10:6]};

   
   /* shamt only feeds the 16-bit imm as {10'b0, shamt}; keep it 6 bits so it
    * does not depend on LG_PRF_ENTRIES (the shift amount is insn[10:6]). */
   wire [5:0]			shamt = {1'b0, insn[10:6]};

   /* CACHE: insn[20:16] = op[4:2] (operation) | op[1:0] (0 I, 1 D, 2 SI, 3 S/SD).
    * Each CPU model numbers its operations differently; these tables turn the
    * encoding into the action this core takes (cache_act_t, machine.vh), and
    * nothing downstream of decode depends on the CPU model. */
   function automatic cache_act_t r4400_cache_act(input logic [4:0] op);
      begin
	 if((op[1:0] == 2'b01) && (op[4:2] == 3'b100))
	   begin
	      r4400_cache_act = CA_D_HIT_INV;      /* 0x11 */
	   end
	 else if((op[1:0] == 2'b01) && (op[4:2] == 3'b101))
	   begin
	      r4400_cache_act = CA_D_HIT_WBINV;    /* 0x15 */
	   end
	 else if((op[1:0] == 2'b01) && (op[4:2] == 3'b110))
	   begin
	      r4400_cache_act = CA_D_HIT_WB;       /* 0x19 */
	   end
	 else if(op[0])
	   begin
	      /* every other D/SD op, index or hit: the one L1D line at the EA */
	      r4400_cache_act = (op[4:2] == 3'b100) ? CA_D_LINE_INV : CA_D_LINE_WB;
	   end
	 else
	   begin
	      r4400_cache_act = CA_I_LINE_INV;     /* I/SI ops, including Fill (0x14) */
	   end
      end
   endfunction

   /* R10000 (MIPS R10000 manual; NetBSD cache_r10k.h; IRIS): ops 5-7 are the cache
    * barrier and the index-addressed data-array load/store, and there is no
    * Create Dirty Exclusive, Hit Writeback or SI target.  The IP28 kernel keeps its
    * caches with the S ops at a 128-byte stride (0x17 ranges, 0x3 sweeps). */
   function automatic cache_act_t r10k_cache_act(input logic [4:0] op);
      begin
	 case(op)
	   5'h00, 5'h10: r10k_cache_act = CA_I_LINE_INV;      /* Index Inv I / Hit Inv I */
	   5'h01:        r10k_cache_act = CA_D_LINE_WB;       /* Index WB-Inv D */
	   5'h11:        r10k_cache_act = CA_D_HIT_INV;       /* Hit Inv D */
	   5'h15:        r10k_cache_act = CA_D_HIT_WBINV;     /* Hit WB-Inv D */
	   5'h03:        r10k_cache_act = CA_BLK_INDEX_WBINV; /* Index WB-Inv S */
	   5'h13:        r10k_cache_act = CA_BLK_HIT_INV;     /* Hit Inv S */
	   5'h17:        r10k_cache_act = CA_BLK_HIT_WBINV;   /* Hit WB-Inv S */
	   default:      r10k_cache_act = CA_NOP;  /* 0x14 barrier, tag/data diagnostics, reserved */
	 endcase
      end
   endfunction

   cache_act_t w_cache_act;
`ifdef ENABLE_R10000
   assign w_cache_act = r10k_cache_act(insn[20:16]);
`else
   assign w_cache_act = r4400_cache_act(insn[20:16]);
`endif

   always_comb
     begin
	uop.op = II;
`ifdef VERILATOR
	uop.raw_insn = insn;
`endif
`ifdef ENABLE_EXC_RING
	uop.insn = insn;   /* debug: ferry the raw fetched word to the ROB alloc (exception ring) */
`endif
	uop.srcA = 'd0;
	uop.srcB = 'd0;
	uop.dst = 'd0;
	uop.srcA_valid = 1'b0;
	uop.srcB_valid = 1'b0;
	uop.fp_srcA_valid = 1'b0;
	uop.fp_srcB_valid = 1'b0;
	uop.srcC = 'd0;
	uop.srcC_valid = 1'b0;
	uop.fp_srcC_valid = 1'b0;
	uop.fcr_src_valid = 1'b0;
	uop.hilo_dst_valid = 1'b0;
	uop.hilo_src_valid = 1'b0;
	uop.hilo_dst = 'd0;
	uop.hilo_src = 'd0;

	uop.dst_valid = 1'b0;
	uop.fp_dst_valid = 1'b0;
	uop.fcr_dst_valid = 1'b0;
	uop.is_fp = 1'b0;
	uop.cpu_ce1 = 1'b0;
	
	uop.has_delay_slot = 1'b0;
	uop.has_nullifying_delay_slot = 1'b0;
	uop.imm = 16'd0;
	uop.jmp_imm = {(`M_WIDTH-16){1'b0}};
	uop.pc = pc;
	uop.pred_target = insn_pred_target;
	uop.serializing_op = 1'b0;
	uop.must_restart = 1'b0;
	uop.oldest_first = 1'b0;
	uop.rob_ptr = 'd0;
	uop.cp0_seq = 'd0;
	uop.br_pred = 1'b0;
	uop.is_br = 1'b0;
	uop.bpu_idx = bpu_idx;
	uop.is_mem = 1'b0;
	uop.is_int = 1'b0;
	uop.is_store = 1'b0;
	uop.is_cache = 1'b0;
	uop.cache_act = CA_NONE;
`ifdef ENABLE_CYCLE_ACCOUNTING
	uop.fetch_cycle = fetch_cycle;
`endif
	uop.mode_when_fetched = w_in_64b_mode;
	if(irq)
	  begin
	     uop.op = IRQ;
	  end
	else if(xflush)
	  begin
	     uop.op = xflush_op;
	     uop.is_int = 1'b1;
	     uop.serializing_op = 1'b1;
	     uop.srcA = 'd0;
	     uop.srcA_valid = 1'b1;
	  end
	else if(misaligned)
	  begin
	     uop.op = FETCH_MISALIGNED;
	  end
	else if(bad_va)
	  begin
	     /* AdEL: access-level / VA out-of-range -- must beat tlb_miss (an OOR
	      * mapped VA also misses the ITLB; Address Error outranks TLB refill). */
	     uop.op = FETCH_ADDR_ERROR;
	  end
	else if(tlb_miss)
	  begin
	     uop.op = FETCH_TLB_MISS;
	  end
	else if(tlb_invalid)
	  begin
	     uop.op = FETCH_TLB_INVALID;
	  end
	else
	  begin
	     case(opcode)
	       6'd0: /* rtype */
		 begin
		    case(insn[5:0])
		      6'd0: /* sll */
			begin
			   /* Two separate physreg-0 reads hid here.  (1) `sll $0,..' is
			    * nop/ssnop/ehb: already NOP'd, but srcA_valid was left set, so
			    * every nop still READ a register -- physreg 0 for the canonical
			    * `sll $0,$0,0'.  A NOP needs no sources.  (2) `sll rd,$0,sa' is
			    * statically zero, so emit MOVI with a zero immediate rather than
			    * shifting physreg 0.  imm MUST be forced to 0 on that path --
			    * MOVI would otherwise return the shift amount. */
			   uop.srcA = rt;
			   uop.srcA_valid = (rd != 'd0) && (rt != 'd0);
			   uop.dst = rd;
			   uop.dst_valid = (rd != 'd0);
			   uop.op = (rd == 'd0) ? NOP : ((rt == 'd0) ? MOVI : SLL);
			   uop.is_int = 1'b1;
			   uop.imm = (rt == 'd0) ? 16'd0 : {10'b0, shamt};
			end
		      6'd2: /* srl */
			begin
			   /* see the sll arm: NOP reads nothing, `srl rd,$0,sa' is MOVI 0 */
			   uop.srcA = rt;
			   uop.srcA_valid = (rd != 'd0) && (rt != 'd0);
			   uop.dst = rd;
			   uop.dst_valid = (rd != 'd0);
			   uop.op = (rd == 'd0) ? NOP : ((rt == 'd0) ? MOVI : SRL);
			   uop.is_int = 1'b1;
			   uop.imm = (rt == 'd0) ? 16'd0 : {10'b0, shamt};
			end
		      6'd3: /* sra */
			begin
			   /* see the sll arm: NOP reads nothing, `sra rd,$0,sa' is MOVI 0 */
			   uop.srcA = rt;
			   uop.srcA_valid = (rd != 'd0) && (rt != 'd0);
			   uop.dst = rd;
			   uop.dst_valid = (rd != 'd0);
			   uop.op = (rd == 'd0) ? NOP : ((rt == 'd0) ? MOVI : SRA);
			   uop.is_int = 1'b1;
			   uop.imm = (rt == 'd0) ? 16'd0 : {10'b0, shamt};
			end
		      6'd4: /* sllv */
			begin
			   uop.srcA = rt;
			   uop.srcA_valid = 1'b1;
			   uop.srcB = rs;
			   uop.srcB_valid = 1'b1;
			   uop.dst = rd;
			   uop.dst_valid = (rd != 'd0);
			   uop.op = (rd == 'd0) ? NOP : SLLV;
			   uop.is_int = 1'b1;
			end // case: 6'd4
		      6'd6: /* srlv */
			begin
			   uop.srcA = rt;
			   uop.srcA_valid = 1'b1;
			   uop.srcB = rs;
			   uop.srcB_valid = 1'b1;
			   uop.dst = rd;
			   uop.dst_valid = (rd != 'd0);
			   uop.op = (rd == 'd0) ? NOP : SRLV;
			   uop.is_int = 1'b1;
			end
		      6'd7: /* srav */
			begin
			   uop.srcA = rt;
			   uop.srcA_valid = 1'b1;
			   uop.srcB = rs;
			   uop.srcB_valid = 1'b1;
			   uop.dst = rd;
			   uop.dst_valid = (rd != 'd0);
			   uop.op = (rd == 'd0) ? NOP : SRAV;
			   uop.is_int = 1'b1;
			end
		      6'd20: /* dsllv */
			if(w_in_64b_mode)
			  begin
			     uop.srcA = rt;
			     uop.srcA_valid = 1'b1;
			     uop.srcB = rs;
			     uop.srcB_valid = 1'b1;
			     uop.dst = rd;
			     uop.dst_valid = (rd != 'd0);
			     uop.op = (rd == 'd0) ? NOP : DSLLV;
			     uop.is_int = 1'b1;
			  end
		      6'd22: /* dsrlv */
			if(w_in_64b_mode)
			  begin
			     uop.srcA = rt;
			     uop.srcA_valid = 1'b1;
			     uop.srcB = rs;
			     uop.srcB_valid = 1'b1;
			     uop.dst = rd;
			     uop.dst_valid = (rd != 'd0);
			     uop.op = (rd == 'd0) ? NOP : DSRLV;
			     uop.is_int = 1'b1;
			  end
		      6'd23: /* dsrav */
			if(w_in_64b_mode)
			  begin
			     uop.srcA = rt;
			     uop.srcA_valid = 1'b1;
			     uop.srcB = rs;
			     uop.srcB_valid = 1'b1;
			     uop.dst = rd;
			     uop.dst_valid = (rd != 'd0);
			     uop.op = (rd == 'd0) ? NOP : DSRAV;
			     uop.is_int = 1'b1;
			  end
		      6'd56: /* dsll */
			if(w_in_64b_mode)
			  begin
			     uop.srcA = rt;
			     uop.srcA_valid = 1'b1;
			     uop.dst = rd;
			     uop.dst_valid = (rd != 'd0);
			     uop.op = (rd == 'd0) ? NOP : DSLL;
			     uop.imm = {10'b0, shamt};
			     uop.is_int = 1'b1;
			  end
		      6'd58: /* dsrl */
			if(w_in_64b_mode)
			  begin
			     uop.srcA = rt;
			     uop.srcA_valid = 1'b1;
			     uop.dst = rd;
			     uop.dst_valid = (rd != 'd0);
			     uop.op = (rd == 'd0) ? NOP : DSRL;
			     uop.imm = {10'b0, shamt};
			     uop.is_int = 1'b1;
			  end
		      6'd59: /* dsra */
			if(w_in_64b_mode)
			  begin
			     uop.srcA = rt;
			     uop.srcA_valid = 1'b1;
			     uop.dst = rd;
			     uop.dst_valid = (rd != 'd0);
			     uop.op = (rd == 'd0) ? NOP : DSRA;
			     uop.imm = {10'b0, shamt};
			     uop.is_int = 1'b1;
			  end
		      6'd60: /* dsll32: shift = sa + 32 */
			if(w_in_64b_mode)
			  begin
			     uop.srcA = rt;
			     uop.srcA_valid = 1'b1;
			     uop.dst = rd;
			     uop.dst_valid = (rd != 'd0);
			     uop.op = (rd == 'd0) ? NOP : DSLL32;
			     uop.imm = {10'b0, shamt};
			     uop.is_int = 1'b1;
			  end
		      6'd62: /* dsrl32: shift = sa + 32 */
			if(w_in_64b_mode)
			  begin
			     uop.srcA = rt;
			     uop.srcA_valid = 1'b1;
			     uop.dst = rd;
			     uop.dst_valid = (rd != 'd0);
			     uop.op = (rd == 'd0) ? NOP : DSRL32;
			     uop.imm = {10'b0, shamt};
			     uop.is_int = 1'b1;
			  end
		      6'd63: /* dsra32: shift = sa + 32 */
			if(w_in_64b_mode)
			  begin
			     uop.srcA = rt;
			     uop.srcA_valid = 1'b1;
			     uop.dst = rd;
			     uop.dst_valid = (rd != 'd0);
			     uop.op = (rd == 'd0) ? NOP : DSRA32;
			     uop.imm = {10'b0, shamt};
			     uop.is_int = 1'b1;
			  end
		      6'd8: /* jr */
			begin
			   uop.srcA = rs;
			   uop.srcA_valid = 1'b1;
			   uop.has_delay_slot = 1'b1;
			   uop.op = JR;
			   uop.imm = insn_pred_target[15:0];
			   uop.jmp_imm = insn_pred_target[`M_WIDTH-1:16];
			   uop.is_br = 1'b1;
			   uop.is_int = 1'b1;
			end
		      6'd9: /* jalr */
			begin
			   uop.srcA = rs;
			   uop.srcA_valid = 1'b1;
			   uop.has_delay_slot = 1'b1;
			   uop.op = (rd == 'd0) ? JR : JALR;  /* jalr $0,rx == jr rx: keep the jump, drop the dead link write */
			   uop.dst_valid = rd != 'd0;
			   uop.dst = rd;
			   uop.imm = insn_pred_target[15:0];
			   uop.jmp_imm = insn_pred_target[`M_WIDTH-1:16];
			   uop.is_br = 1'b1;
			   uop.is_int = 1'b1;
			end // case: 6'd9
		      6'd12:
			begin
			   uop.op = SYSCALL;
			   uop.oldest_first = 1'b1;
			   uop.is_int = 1'b1;
			end
		      6'd13:
			begin
			   uop.op = BREAK;
			   uop.oldest_first = 1'b1;
			   uop.is_int = 1'b1;
			end
		      6'd15: /* sync - treat as nop */
			begin
			   uop.op = NOP;
			   uop.is_int = 1'b1;
			end
		      6'd16:
			begin
			   uop.op = (rd == 'd0) ? NOP : MFHI;
			   uop.dst = rd;
			   uop.dst_valid = (rd != 'd0);
			   uop.hilo_src_valid = 1'b1;
			   uop.is_int = 1'b1;		      
			end
		      6'd17:
			begin
			   uop.op = MTHI;
			   uop.srcA = rs;
			   uop.srcA_valid = 1'b1;
			   uop.hilo_src_valid = 1'b1;		      
			   uop.hilo_dst_valid = 1'b1;
			   uop.is_int = 1'b1;
			end
		      6'd18:
			begin
			   uop.op = (rd == 'd0) ? NOP : MFLO;
			   uop.dst = rd;
			   uop.dst_valid = (rd != 'd0);
			   uop.hilo_src_valid = 1'b1;
			   uop.is_int = 1'b1;
			end
		      6'd19:
			begin
			   uop.op = MTLO;
			   uop.srcA = rs;
			   uop.srcA_valid = 1'b1;
			   uop.hilo_src_valid = 1'b1;		      
			   uop.hilo_dst_valid = 1'b1;
			   uop.is_int = 1'b1;
			end
		      6'd24: /* mult */
			begin
			   uop.srcA = rs;
			   uop.srcA_valid = 1'b1;
			   uop.srcB = rt;
			   uop.srcB_valid = 1'b1;
			   uop.hilo_dst_valid = 1'b1;
			   uop.op = MULT;
			   uop.is_int = 1'b1;
			end
		      6'd25: /* multu */
			begin
			   uop.srcA = rs;
			   uop.srcA_valid = 1'b1;
			   uop.srcB = rt;
			   uop.srcB_valid = 1'b1;
			   uop.hilo_dst_valid = 1'b1;
			   uop.op = MULTU;
			   uop.is_int = 1'b1;
			end
		      6'd26: /* div */
			begin
			   uop.srcA = rs;
			   uop.srcA_valid = 1'b1;
			   uop.srcB = rt;
			   uop.srcB_valid = 1'b1;
			   uop.hilo_dst_valid = 1'b1;
			   uop.op = DIV;
			   uop.is_int = 1'b1;
			end
		      6'd27: /* divu */
			begin
			   uop.srcA = rs;
			   uop.srcA_valid = 1'b1;
			   uop.srcB = rt;
			   uop.srcB_valid = 1'b1;
			   uop.hilo_dst_valid = 1'b1;
			   uop.op = DIVU;
			   uop.is_int = 1'b1;
			end
		      6'd28: /* dmult */
			if(w_in_64b_mode)
			  begin
			     uop.srcA = rs;
			     uop.srcA_valid = 1'b1;
			     uop.srcB = rt;
			     uop.srcB_valid = 1'b1;
			     uop.hilo_dst_valid = 1'b1;
			     uop.op = DMULT;
			     uop.is_int = 1'b1;
			  end
		      6'd29: /* dmultu */
			if(w_in_64b_mode)
			  begin
			     uop.srcA = rs;
			     uop.srcA_valid = 1'b1;
			     uop.srcB = rt;
			     uop.srcB_valid = 1'b1;
			     uop.hilo_dst_valid = 1'b1;
			     uop.op = DMULTU;
			     uop.is_int = 1'b1;
			  end
		      6'd30: /* ddiv */
			if(w_in_64b_mode)
			  begin
			     uop.srcA = rs;
			     uop.srcA_valid = 1'b1;
			     uop.srcB = rt;
			     uop.srcB_valid = 1'b1;
			     uop.hilo_dst_valid = 1'b1;
			     uop.op = DDIV;
			     uop.is_int = 1'b1;
			  end
		      6'd31: /* ddivu */
			if(w_in_64b_mode)
			  begin
			     uop.srcA = rs;
			     uop.srcA_valid = 1'b1;
			     uop.srcB = rt;
			     uop.srcB_valid = 1'b1;
			     uop.hilo_dst_valid = 1'b1;
			     uop.op = DDIVU;
			     uop.is_int = 1'b1;
			  end
		      6'd32: /* add */
			begin
			   uop.srcA = rt;
			   uop.srcA_valid = 1'b1;
			   uop.srcB = rs;
			   uop.srcB_valid = 1'b1;
			   uop.dst = rd;
			   uop.dst_valid = (rd != 'd0);
			   uop.op = (rd == 'd0) ? ADDCHK : ADD;
			   uop.is_int = 1'b1;
			end		 
		      6'd33: /* addu */
			begin
			   /* `move rd,rs' assembles to `addu rd,rs,$0', which is the single
			    * biggest physreg-0 reader in compiled code -- 1099 static reads
			    * in the o32 `wc' binary, against 896 for every $0-comparing
			    * branch combined.  Steer the $0 forms to single-source uops so
			    * the read never happens (same triage as BEQZ/BNEZ/BRA).
			    * NOTE: ADDU is a 32-bit add whose result is sign-extended, NOT a
			    * 64-bit copy, so the one-source form is SLL with shamt 0 -- the
			    * ISA's own sext32 idiom.  MOV is WRONG here: it copies all 64
			    * bits and would carry bits 63:32 that ADDU must clear/replicate. */
			   if((rs == 'd0) && (rt == 'd0))
			     begin
				/* `addu rd,$0,$0': statically zero, no sources at all */
				uop.dst = rd;
				uop.dst_valid = (rd != 'd0);
				uop.op = (rd == 'd0) ? NOP : MOVI;
				uop.imm = 16'd0;
				uop.is_int = 1'b1;
			     end
			   else if((rs == 'd0) || (rt == 'd0))
			     begin
				uop.srcA = (rs == 'd0) ? rt : rs;
				uop.srcA_valid = 1'b1;
				uop.dst = rd;
				uop.dst_valid = (rd != 'd0);
				uop.op = (rd == 'd0) ? NOP : SLL;
				uop.imm = 16'd0;  /* sext32(srcA << 0) == addu rd,srcA,$0 */
				uop.is_int = 1'b1;
			     end
			   else
			     begin
				uop.srcA = rt;
				uop.srcA_valid = 1'b1;
				uop.srcB = rs;
				uop.srcB_valid = 1'b1;
				uop.dst = rd;
				uop.dst_valid = (rd != 'd0);
				uop.op = (rd == 'd0) ? NOP : ADDU;
				uop.is_int = 1'b1;
			     end
			end
		      6'd34: /* sub */
			begin
			   /* rd==$0 keeps SUBCHK (overflow check, no dst) and genuinely
			    * needs both operands.  Otherwise fold the $0 forms:
			    *   sub rd,$0,rt == trapping neg -> NEGT (traps only at INT_MIN)
			    *   sub rd,rs,$0 == rs - 0, cannot overflow -> SLL 0
			    *   sub rd,$0,$0 == 0 -> MOVI 0 */
			   if(rd == 'd0)
			     begin
				uop.srcA = rs;
				uop.srcA_valid = 1'b1;
				uop.srcB = rt;
				uop.srcB_valid = 1'b1;
				uop.op = SUBCHK;
				uop.is_int = 1'b1;
			     end
			   else
			     begin
				uop.srcA = (rs == 'd0) ? rt : rs;
				uop.srcA_valid = !((rs == 'd0) && (rt == 'd0));
				uop.srcB = rt;
				uop.srcB_valid = (rs != 'd0) && (rt != 'd0);
				uop.dst = rd;
				uop.dst_valid = 1'b1;
				uop.op = ((rs == 'd0) && (rt == 'd0)) ? MOVI :
					 (rs == 'd0) ? NEGT :
					 (rt == 'd0) ? SLL : SUB;
				uop.imm = 16'd0;
				uop.is_int = 1'b1;
			     end
			end
		      6'd35: /* subu */
			begin
			   /* `subu rd,$0,rt' is `negu rd,rt' -- 6039 static occurrences,
			    * the last large physreg-0 reader.  NOTE subu decodes
			    * srcA=rs, srcB=rt (the opposite of slt), so the non-zero
			    * operand for NEG is rt.  Free foldings of the other forms:
			    *   subu rd,rs,$0 == sext32(rs) -> SLL 0 (as for `addu')
			    *   subu rd,$0,$0 == 0          -> MOVI 0 */
			   uop.srcA = (rs == 'd0) ? rt : rs;
			   uop.srcA_valid = !((rs == 'd0) && (rt == 'd0));
			   uop.srcB = rt;
			   uop.srcB_valid = (rs != 'd0) && (rt != 'd0);
			   uop.dst = rd;
			   uop.dst_valid = (rd != 'd0);
			   uop.op = (rd == 'd0) ? NOP :
				    ((rs == 'd0) && (rt == 'd0)) ? MOVI :
				    (rs == 'd0) ? NEG :
				    (rt == 'd0) ? SLL : SUBU;
			   uop.imm = 16'd0;
			   uop.is_int = 1'b1;
			end
		      6'd36: /* and */
			begin
			   /* `and rd,rs,$0' is statically ZERO whichever operand is $0, so
			    * emit MOVI with a zero immediate -- no source reads at all. */
			   if((rs == 'd0) || (rt == 'd0))
			     begin
				uop.dst = rd;
				uop.dst_valid = (rd != 'd0);
				uop.op = (rd == 'd0) ? NOP : MOVI;
				uop.imm = 16'd0;
				uop.is_int = 1'b1;
			     end
			   else
			     begin
				uop.srcA = rt;
				uop.srcA_valid = 1'b1;
				uop.srcB = rs;
				uop.srcB_valid = 1'b1;
				uop.dst = rd;
				uop.dst_valid = (rd != 'd0);
				uop.op = (rd == 'd0) ? NOP : AND;
				uop.is_int = 1'b1;
			     end
			end
		      6'd37: /* or */
			begin
			   if(rs == 'd0)
			     begin
				/* `or rd,$0,rt' is `move rd,rt' -- already a single-source
				 * MOV.  But when rt is ALSO $0 (`move rd,$zero') the result
				 * is statically 0, and MOV would read physreg 0 to compute
				 * it: 967 such reads in one dhrystone run.  Emit MOVI with a
				 * zero immediate instead -- no sources at all.  This reuses
				 * the idiom decode already applies to `li' (addiu rt,$0,imm
				 * -> MOVI), so no new uop is needed. */
				uop.srcA = rt;
				uop.srcA_valid = (rt != 'd0);
				uop.dst = rd;
				uop.dst_valid = (rd != 'd0);
				uop.op = (rd == 'd0) ? NOP : ((rt == 'd0) ? MOVI : MOV);
				uop.imm = 16'd0;   /* MOVI path: result = sext(imm) = 0 */
				uop.is_int = 1'b1;
			     end
			   else if(rt == 'd0)
			     begin
				/* `or rd,rs,$0' is the other `move rd,rs' encoding (712 static
				 * reads in the same binary; gas picks it over addu depending on
				 * the macro).  OR is a full 64-bit bitwise op, so MOV -- a plain
				 * 64-bit copy -- is exact here, unlike the ADDU case above. */
				uop.srcA = rs;
				uop.srcA_valid = 1'b1;
				uop.dst = rd;
				uop.dst_valid = (rd != 'd0);
				uop.op = (rd == 'd0) ? NOP : MOV;
				uop.is_int = 1'b1;
			     end
			   else
			     begin
				uop.srcA = rt;
				uop.srcA_valid = 1'b1;
				uop.srcB = rs;
				uop.srcB_valid = 1'b1;
				uop.dst = rd;
				uop.dst_valid = (rd != 'd0);
				uop.op = (rd == 'd0) ? NOP : OR;
				uop.is_int = 1'b1;
			     end
			end
		      6'd38: /* xor */
			begin
			   /* `xor rd,rs,$0' is just `rs'.  XOR is a full 64-bit bitwise op,
			    * so a plain MOV copy is exact (contrast ADDU, which sign-extends).
			    * Both operands $0 is statically zero -> MOVI, no sources. */
			   if((rs == 'd0) && (rt == 'd0))
			     begin
				uop.dst = rd;
				uop.dst_valid = (rd != 'd0);
				uop.op = (rd == 'd0) ? NOP : MOVI;
				uop.imm = 16'd0;
				uop.is_int = 1'b1;
			     end
			   else if((rs == 'd0) || (rt == 'd0))
			     begin
				uop.srcA = (rs == 'd0) ? rt : rs;
				uop.srcA_valid = 1'b1;
				uop.dst = rd;
				uop.dst_valid = (rd != 'd0);
				uop.op = (rd == 'd0) ? NOP : MOV;
				uop.is_int = 1'b1;
			     end
			   else
			     begin
				uop.srcA = rt;
				uop.srcA_valid = 1'b1;
				uop.srcB = rs;
				uop.srcB_valid = 1'b1;
				uop.dst = rd;
				uop.dst_valid = (rd != 'd0);
				uop.op = (rd == 'd0) ? NOP : XOR;
				uop.is_int = 1'b1;
			     end
			end
		      6'd39: /* nor */
			begin
			   /* `nor rd,rs,$0' is the canonical `not rd,rs' -- steer it to the
			    * single-source NOT uop.  NOR(x,x) would give the same value and
			    * also avoid physreg 0, but it still occupies two RF read ports;
			    * NOT occupies one, which is what makes single-reader uops useful
			    * for shrinking the port count later.
			    * `nor rd,$0,$0' is ~0 == -1 -> MOVI 16'hffff (t_simm sign-extends
			    * from bit 15, giving all ones). */
			   if((rs == 'd0) && (rt == 'd0))
			     begin
				uop.dst = rd;
				uop.dst_valid = (rd != 'd0);
				uop.op = (rd == 'd0) ? NOP : MOVI;
				uop.imm = 16'hffff;
				uop.is_int = 1'b1;
			     end
			   else if((rs == 'd0) || (rt == 'd0))
			     begin
				uop.srcA = (rs == 'd0) ? rt : rs;
				uop.srcA_valid = 1'b1;
				uop.dst = rd;
				uop.dst_valid = (rd != 'd0);
				uop.op = (rd == 'd0) ? NOP : NOT;
				uop.is_int = 1'b1;
			     end
			   else
			     begin
				uop.srcA = rt;
				uop.srcA_valid = 1'b1;
				uop.srcB = rs;
				uop.srcB_valid = 1'b1;
				uop.dst = rd;
				uop.dst_valid = (rd != 'd0);
				uop.op = (rd == 'd0) ? NOP : NOR;
				uop.is_int = 1'b1;
			     end
			end
`ifdef ENABLE_MIPS4
		      6'd1: /* movf, movt (MIPS IV) */
			begin
			   /* rd = (FCC[cc] == tf) ? rs : rd.  The condition is the renamed
			    * FCC that BC1x already reads in the int ALU; cc rides srcC
			    * unrenamed as for BC1x */
			   uop.srcA = rs;
			   uop.srcA_valid = (rs != 'd0);
			   uop.srcB = rd;
			   uop.srcB_valid = (rd != 'd0);
			   uop.srcC = {{(`LG_PRF_ENTRIES-3){1'b0}}, insn[20:18]};
			   uop.fcr_src_valid = 1'b1;
			   uop.imm = {15'd0, insn[16]};
			   uop.dst = rd;
			   uop.dst_valid = (rd != 'd0);
			   uop.op = (rd == 'd0) ? NOP : MOVCI;
			   uop.is_int = 1'b1;
			end
		      6'd10, 6'd11: /* movz, movn (MIPS IV) */
			begin
			   /* rd = cond ? rs : rd.  The old rd is a real source (srcB),
			    * rt is a condition only (srcC -> its zero flag in exec);
			    * rs/rt == $0 stay unrenamed and read physreg 0 (value 0,
			    * zero flag 1) */
			   uop.srcA = rs;
			   uop.srcA_valid = (rs != 'd0);
			   uop.srcB = rd;
			   uop.srcB_valid = (rd != 'd0);
			   uop.srcC = rt;
			   uop.srcC_valid = (rt != 'd0);
			   uop.dst = rd;
			   uop.dst_valid = (rd != 'd0);
			   uop.op = (rd == 'd0) ? NOP : (insn[0] ? MOVN : MOVZ);
			   uop.is_int = 1'b1;
			end
`endif
		      6'd42: /* slt */
			begin
			   /* exec computes (srcB < srcA) with srcA=rt, srcB=rs.
			    *   slt rd,$0,rt -> (0 < rt) -> SGTZ on rt
			    *   slt rd,rs,$0 -> (rs < 0) -> SLTZ on rs
			    *   slt rd,$0,$0 -> 0        -> MOVI 0 */
			   uop.srcA = (rt == 'd0) ? rs : rt;
			   uop.srcA_valid = !((rs == 'd0) && (rt == 'd0));
			   uop.srcB = rs;
			   uop.srcB_valid = (rs != 'd0) && (rt != 'd0);
			   uop.dst = rd;
			   uop.dst_valid = (rd != 'd0);
			   uop.op = (rd == 'd0) ? NOP :
				    ((rs == 'd0) && (rt == 'd0)) ? MOVI :
				    (rs == 'd0) ? SGTZ :
				    (rt == 'd0) ? SLTZ : SLT;
			   uop.imm = 16'd0;
			   uop.is_int = 1'b1;
			end
		      6'd43: /* sltu */
			begin
			   /*   sltu rd,$0,rt -> (0 <u rt) == (rt != 0) -> SNEZ on rt
			    *   sltu rd,rs,$0 -> (rs <u 0)  is never true  -> MOVI 0 */
			   uop.srcA = rt;
			   uop.srcA_valid = (rt != 'd0);
			   uop.srcB = rs;
			   uop.srcB_valid = (rs != 'd0) && (rt != 'd0);
			   uop.dst = rd;
			   uop.dst_valid = (rd != 'd0);
			   uop.op = (rd == 'd0) ? NOP :
				    (rt == 'd0) ? MOVI :
				    (rs == 'd0) ? SNEZ : SLTU;
			   uop.imm = 16'd0;
			   uop.is_int = 1'b1;
			end // case: 6'd43
		      6'd44: /* dadd */
			begin
			   if(w_in_64b_mode)
			     begin		      
				uop.srcA = rt;
				uop.srcA_valid = 1'b1;
				uop.srcB = rs;
				uop.srcB_valid = 1'b1;
				uop.dst = rd;
				uop.dst_valid = (rd != 'd0);
				uop.op = (rd == 'd0) ? DADDCHK : DADD;
				uop.is_int = 1'b1;
			     end
			end
		      6'd45: /* daddu */
			begin
			   if(w_in_64b_mode)
			     begin
				/* the 64-bit ABI spells `move rd,rs' as `daddu rd,rs,$0'.  DADDU
				 * is a true 64-bit add, so MOV is exact here -- contrast ADDU
				 * above, which must sign-extend and therefore uses SLL 0. */
				if((rs == 'd0) && (rt == 'd0))
				  begin
				     uop.dst = rd;
				     uop.dst_valid = (rd != 'd0);
				     uop.op = (rd == 'd0) ? NOP : MOVI;
				     uop.imm = 16'd0;
				     uop.is_int = 1'b1;
				  end
				else if((rs == 'd0) || (rt == 'd0))
				  begin
				     uop.srcA = (rs == 'd0) ? rt : rs;
				     uop.srcA_valid = 1'b1;
				     uop.dst = rd;
				     uop.dst_valid = (rd != 'd0);
				     uop.op = (rd == 'd0) ? NOP : MOV;
				     uop.is_int = 1'b1;
				  end
				else
				  begin
				     uop.srcA = rt;
				     uop.srcA_valid = 1'b1;
				     uop.srcB = rs;
				     uop.srcB_valid = 1'b1;
				     uop.dst = rd;
				     uop.dst_valid = (rd != 'd0);
				     uop.op = (rd == 'd0) ? NOP : DADDU;
				     uop.is_int = 1'b1;
				  end
			     end
			end
		      6'd46: /* dsub */
			begin
			   if(w_in_64b_mode)
			     begin
				uop.srcA = rs;
				uop.srcA_valid = 1'b1;
				uop.srcB = rt;
				uop.srcB_valid = 1'b1;
				uop.dst = rd;
				uop.dst_valid = (rd != 'd0);
				uop.op = (rd == 'd0) ? DSUBCHK : DSUB;
				uop.is_int = 1'b1;
			     end
			end
		      6'd47: /* dsubu */
			begin
			   if(w_in_64b_mode)
			     begin
				uop.srcA = rs;
				uop.srcA_valid = 1'b1;
				uop.srcB = rt;
				uop.srcB_valid = 1'b1;
				uop.dst = rd;
				uop.dst_valid = (rd != 'd0);
				uop.op = (rd == 'd0) ? NOP : DSUBU;
				uop.is_int = 1'b1;
			     end
			end
		      6'd48: /* tge  */
			begin
			   uop.op = TGE;
			   uop.srcA = rs; uop.srcA_valid = 1'b1;
			   uop.srcB = rt; uop.srcB_valid = 1'b1;
			   uop.is_int = 1'b1;
			end
		      6'd49: /* tgeu */
			begin
			   /* `tgeu $0,rt' is `0 >=u rt', i.e. exactly rt == 0 -- reuse
			    * TEQZ, single source, no physreg-0 read.
			    * (`tgeu rs,$0' is unsigned `>= 0' and so traps ALWAYS; that
			    *  would need a source-free always-trap uop.  Left as TGEU:
			    *  0 static occurrences across wc/dhrystone/big-csmith/hello.) */
			   if((rs == 'd0) && (rt != 'd0))
			     begin
				uop.op = TEQZ;
				uop.srcA = rt; uop.srcA_valid = 1'b1;
				uop.is_int = 1'b1;
			     end
			   else
			     begin
				uop.op = TGEU;
				uop.srcA = rs; uop.srcA_valid = 1'b1;
				uop.srcB = rt; uop.srcB_valid = 1'b1;
				uop.is_int = 1'b1;
			     end
			end
		      6'd50: /* tlt  */
			begin
			   uop.op = TLT;
			   uop.srcA = rs; uop.srcA_valid = 1'b1;
			   uop.srcB = rt; uop.srcB_valid = 1'b1;
			   uop.is_int = 1'b1;
			end
		      6'd51: /* tltu */
			begin
			   /* `tltu rs,$0' is unsigned `< 0' -- can never trap, so it is a
			    * NOP with no sources at all.  `tltu $0,rt' is `0 <u rt', i.e.
			    * exactly rt != 0 -- reuse TNEZ, single source. */
			   if(rt == 'd0)
			     begin
				uop.op = NOP;
				uop.is_int = 1'b1;
			     end
			   else if(rs == 'd0)
			     begin
				uop.op = TNEZ;
				uop.srcA = rt; uop.srcA_valid = 1'b1;
				uop.is_int = 1'b1;
			     end
			   else
			     begin
				uop.op = TLTU;
				uop.srcA = rs; uop.srcA_valid = 1'b1;
				uop.srcB = rt; uop.srcB_valid = 1'b1;
				uop.is_int = 1'b1;
			     end
			end
		      6'd52: /* teq */
			begin
			   /* steer `teq rs,$zero' (the div-by-zero guard shape) to a
			    * uop that carries only the non-zero operand, so the trap
			    * decision never reads physreg 0.  Both-zero is degenerate
			    * and stays plain TEQ. */
			   uop.op = ((rs == 'd0) ^ (rt == 'd0)) ? TEQZ : TEQ;
			   uop.srcA = (rt == 'd0) ? rs : rt;
			   uop.srcA_valid = 1'b1;
			   uop.srcB = rs;
			   uop.srcB_valid = !((rs == 'd0) ^ (rt == 'd0));
			   uop.is_int = 1'b1;
			end
		      6'd54: /* tne */
			begin
			   /* steer `tne rs,$zero' (the div-by-zero guard shape) to a
			    * uop that carries only the non-zero operand, so the trap
			    * decision never reads physreg 0.  Both-zero is degenerate
			    * and stays plain TNE. */
			   uop.op = ((rs == 'd0) ^ (rt == 'd0)) ? TNEZ : TNE;
			   uop.srcA = (rt == 'd0) ? rs : rt;
			   uop.srcA_valid = 1'b1;
			   uop.srcB = rs;
			   uop.srcB_valid = !((rs == 'd0) ^ (rt == 'd0));
			   uop.is_int = 1'b1;
			end
		      default:
			begin
			end
		    endcase // case (insn[5:0])
		 end // case: 6'd0
	       /* end-rtype */
	       6'd1: /* BGEZ through BLTZ */
		 begin
		    uop.srcA = rs;
		    uop.srcA_valid = 1'b1;
		    uop.has_delay_slot = 1'b1;
		    uop.imm = insn[15:0];
		    uop.is_br = 1'b1;
		    uop.is_int = 1'b1;
		    uop.br_pred = insn_pred;

		    
		    case(rt[4:0])
		      'd0: /* BLTZ */
			begin
			   uop.op = BLTZ;
			end
		      'd1: /* BGEZ */
			begin
			   uop.op = BGEZ;
			end
		      'd2: /* BLTZL */
			begin
			   uop.op = BLTZL;
			   uop.has_nullifying_delay_slot = 1'b1;
			end
		      'd3:
			begin /* BGEZL */
			   uop.op = BGEZL;
			   uop.has_nullifying_delay_slot = 1'b1;
			end
		      'd17:
			begin /* BGEZAL */
			   uop.op = (rs == 'd0) ? BAL : BGEZAL;
			   uop.dst_valid = 1'b1;
			   uop.dst = 'd31;
			   uop.srcB = 'd31;
			   uop.srcB_valid = 1'b0;   /* *al links unconditionally: no old-r31 src */
			   /* `bal off' IS `bgezal $0,off': $0 >= 0 always, so the branch is
			    * UNCONDITIONAL and the operand is never consulted.  The shared
			    * REGIMM prologue above set srcA=rs=$0 with srcA_valid=1, which
			    * made every `bal' read physreg 0 for nothing -- 1888 of them in
			    * one dhrystone run, on a CONTROL TRANSFER, the same class as the
			    * bug being hunted.  Drop the source. */
			   if(rs == 'd0)
			     begin
				uop.srcA_valid = 1'b0;
			     end
			end
		      'd16:
			begin /* BLTZAL */
			   uop.op = BLTZAL;
			   uop.dst_valid = 1'b1;
			   uop.dst = 'd31;
			   uop.srcB = 'd31;
			   uop.srcB_valid = 1'b0;   /* *al links unconditionally: no old-r31 src */
			end
		      'd18:
			begin /* BLTZALL (likely) */
			   uop.op = BLTZALL;
			   uop.has_nullifying_delay_slot = 1'b1;
			   uop.dst_valid = 1'b1;
			   uop.dst = 'd31;
			   uop.srcB = 'd31;
			   uop.srcB_valid = 1'b0;   /* *al links unconditionally: no old-r31 src */
			end
		      'd19:
			begin /* BGEZALL (likely) */
			   uop.op = BGEZALL;
			   uop.has_nullifying_delay_slot = 1'b1;
			   uop.dst_valid = 1'b1;
			   uop.dst = 'd31;
			   uop.srcB = 'd31;
			   uop.srcB_valid = 1'b0;   /* *al links unconditionally: no old-r31 src */
			end
		      /* trap-immediates: srcA=rs (set above), compare vs sign-ext imm;
		       * reuse the register-trap ops with srcB_valid=0.  These are NOT
		       * branches -> undo the branch fields the common block set. */
		      'd8:  begin uop.op = TGE;  uop.has_delay_slot=1'b0; uop.is_br=1'b0; end /* tgei  */
		      'd9:  begin uop.op = TGEU; uop.has_delay_slot=1'b0; uop.is_br=1'b0; end /* tgeiu */
		      'd10: begin uop.op = TLT;  uop.has_delay_slot=1'b0; uop.is_br=1'b0; end /* tlti  */
		      'd11: begin uop.op = TLTU; uop.has_delay_slot=1'b0; uop.is_br=1'b0; end /* tltiu */
		      'd12: begin uop.op = TEQ;  uop.has_delay_slot=1'b0; uop.is_br=1'b0; end /* teqi  */
		      'd14: begin uop.op = TNE;  uop.has_delay_slot=1'b0; uop.is_br=1'b0; end /* tnei  */
		      default:
			begin
			   uop.op = II;
			end
		    endcase // case (rt[1:0])
		 end // case: 6'd1
	       6'd2: /* J - just fold */
		 begin
		    uop.op = J;
		    uop.is_br = 1'b1;
		    uop.is_int = 1'b1;
		    uop.has_delay_slot = 1'b1;
		    //uop.imm = insn[15:0];
		    //uop.jmp_imm = insn[25:16];
		    //uop.br_pred = 1'b1;
		 end
	       6'd3:
		 begin
		    uop.op = JAL;
		    uop.has_delay_slot = 1'b1;
		    uop.imm = insn[15:0];
		    uop.jmp_imm = {{(`M_WIDTH-26){1'b0}}, insn[25:16]};
		    uop.dst_valid = 1'b1;
		    uop.dst = 'd31;	  
		    uop.br_pred = 1'b1;
		    uop.is_br = 1'b1;
		    uop.is_int = 1'b1;	       
		 end
	       6'd4: /* BEQ -- steered to a zero-compare uop when either side is $zero */
		 begin
		    /* `beqz rs' is `beq rs,$zero' and `b lbl' is `beq $0,$0', so the
		     * plain BEQ arm made both read physreg 0 through the forwarding
		     * network.  Emit uops that carry NO srcB (and no sources at all
		     * for the unconditional case) so the compare is against a literal
		     * zero in exec.  Removes the read, drops a source from the
		     * scheduler wakeup, and makes the branch immune to $zero
		     * corruption on the bypass. */
		    uop.op = (rs == 'd0 && rt == 'd0) ? BRA :
			     (rt == 'd0) ? BEQZ :
			     (rs == 'd0) ? BEQZ : BEQ;

		    uop.dst_valid = 1'b0;
		    uop.dst = 'd0;
		    /* BEQZ keeps the ONE non-zero operand in srcA */
		    uop.srcA = (rs == 'd0) ? rt : rs;
		    uop.srcA_valid = (rs == 'd0 && rt == 'd0) ? 1'b0 : 1'b1;
		    uop.srcB = rt;
		    uop.srcB_valid = (rs != 'd0 && rt != 'd0);
		    uop.has_delay_slot = 1'b1;
		    uop.imm = insn[15:0];
		    uop.br_pred = insn_pred;
		    uop.is_br = 1'b1;
		    uop.is_int = 1'b1;
		 end // case: 6'd4
	       6'd5: /* BNE */
		 begin
		    //$display("decoded bne, rs = %d, rs = %d", rs, rt);
		    /* mirror of the BEQ arm above.  `bne $0,$0' is never taken; it is
		     * rare enough that it stays a plain BNE (still reads $zero) rather
		     * than earning a fourth uop. */
		    uop.op = (rs == 'd0 && rt == 'd0) ? BNE :
			     (rt == 'd0) ? BNEZ :
			     (rs == 'd0) ? BNEZ : BNE;
		    uop.dst_valid = 1'b0;
		    uop.dst = 'd0;
		    uop.srcA = (rs == 'd0 && rt != 'd0) ? rt : rs;
		    uop.srcA_valid = 1'b1;
		    uop.srcB = rt;
		    uop.srcB_valid = !((rs == 'd0) ^ (rt == 'd0));
		    uop.has_delay_slot = 1'b1;
		    uop.imm = insn[15:0];
		    uop.br_pred = insn_pred;
		    uop.is_br = 1'b1;
		    uop.is_int = 1'b1;
		 end // case: 6'd5
	       6'd6: /* BLEZ */
		 begin	    
		    uop.op = BLEZ;
		    uop.dst_valid = 1'b0;
		    uop.dst = 'd0;
		    uop.srcA = rs;
		    uop.srcA_valid = 1'b1;
		    uop.has_delay_slot = 1'b1;
		    uop.imm = insn[15:0];
		    uop.br_pred = insn_pred;
		    uop.is_br = 1'b1;
		    uop.is_int = 1'b1;	       
		 end
	       6'd7: /* BGTZ */
		 begin
		    uop.op = BGTZ;
		    uop.dst_valid = 1'b0;
		    uop.dst = 'd0;
		    uop.srcA = rs;
		    uop.srcA_valid = 1'b1;
		    uop.has_delay_slot = 1'b1;
		    uop.imm = insn[15:0];
		    uop.br_pred = insn_pred;
		    uop.is_br = 1'b1;
		    uop.is_int = 1'b1;
		 end // case: 6'd7
	       6'd8: /* ADDI */
		 begin
		    /* `addi rt,$0,imm' is 0 + sext(imm): it cannot overflow, so the
		     * trap is unreachable and it degenerates to a plain MOVI. */
		    uop.op = (rt == 'd0) ? ((rs == 'd0) ? NOP : ADDICHK)
					 : ((rs == 'd0) ? MOVI : ADDI);
		    uop.srcA_valid = (rs != 'd0);
		    uop.srcA = rs;
		    uop.dst_valid = (rt != 'd0);
		    uop.is_int = 1'b1;
		    uop.dst = rt;
		    uop.imm = insn[15:0];
		 end
	       6'd9: /* ADDIU */
		 begin
		    if(rs == 'd0)
		      begin
			 uop.op = (rt == 'd0) ? NOP : MOVI;
			 uop.dst_valid = (rt != 'd0);
			 uop.is_int = 1'b1;
			 uop.dst = rt;
			 uop.imm = insn[15:0];		    
		      end
		    else
		      begin
			 uop.op = (rt == 'd0) ? NOP : ADDIU;
			 uop.srcA_valid = 1'b1;
			 uop.srcA = rs;
			 uop.dst_valid = (rt != 'd0);
			 uop.is_int = 1'b1;
			 uop.dst = rt;
			 uop.imm = insn[15:0];
		      end
		 end
	       6'd10: /* SLTI */
		 begin
		    uop.op = (rt == 'd0) ? NOP : SLTI;
		    uop.srcA_valid = 1'b1;
		    uop.srcA = rs;
		    uop.dst_valid = (rt != 'd0);
		    uop.dst = rt;
		    uop.is_int = 1'b1;	       
		    uop.imm = insn[15:0];
		 end
	       6'd11: /* SLTIU */
		 begin
		    uop.op = (rt == 'd0) ? NOP : SLTIU;
		    uop.srcA_valid = 1'b1;
		    uop.srcA = rs;
		    uop.dst_valid = (rt != 'd0);
		    uop.dst = rt;
		    uop.is_int = 1'b1;	       
		    uop.imm = insn[15:0];
		 end
	       6'd12: /* ANDI */
		 begin
		    /* `andi rt,$0,imm' is statically zero -> MOVI with a zero imm */
		    uop.op = (rt == 'd0) ? NOP : ((rs == 'd0) ? MOVI : ANDI);
		    uop.srcA_valid = (rs != 'd0);
		    uop.srcA = rs;
		    uop.dst_valid = (rt != 'd0);
		    uop.dst = rt;
		    uop.is_int = 1'b1;
		    uop.imm = (rs == 'd0) ? 16'd0 : insn[15:0];	       
		 end
	       6'd13: /* ORI */
		 begin
		    /* `ori rt,$0,imm' is a zero-extended immediate load (1935 static
		     * occurrences -- the biggest physreg-0 reader left after `move').
		     * MOVIU, not MOVI: MOVI sign-extends and would be wrong for
		     * imm[15]=1. */
		    uop.op = (rt == 'd0) ? NOP : ((rs == 'd0) ? MOVIU : ORI);
		    uop.srcA_valid = (rs != 'd0);
		    uop.srcA = rs;	       
		    uop.dst_valid = (rt != 'd0);
		    uop.dst = rt;
		    uop.is_int = 1'b1;
		    uop.imm = insn[15:0];
		    //$display("ORI : dest %d, src %d, imm = %d", uop.dst, uop.srcA, uop.imm);
		    
		 end
	       6'd14: /* XORI */
		 begin
		    /* `xori rt,$0,imm' == `ori rt,$0,imm' -- zero-extended immediate */
		    uop.op = (rt == 'd0) ? NOP : ((rs == 'd0) ? MOVIU : XORI);
		    uop.srcA_valid = (rs != 'd0);
		    uop.srcA = rs;	       
		    uop.dst_valid = (rt != 'd0);
		    uop.dst = rt;
		    uop.is_int = 1'b1;
		    uop.imm = insn[15:0];	       
		 end
	       6'd15: /* LUI*/
		 begin
		    uop.op = (rt == 'd0) ? NOP : LUI;
		    uop.dst_valid = (rt != 'd0);
		    uop.dst = rt;
		    uop.is_int = 1'b1;
		    uop.imm = insn[15:0];
		 end
	       6'd16: /* coproc0 */
		 begin	
		    /* COP0 is kernel-only, with ONE deliberate exception: a user-mode MFC0 of
		     * the two custom performance counters (CP0 $23 = r_cycle, $24 =
		     * r_retired_insns).  These are hacks of ours living in CP0 space the R4x00
		     * marks Reserved (R4400 UM Table 1-19: 21-25 "--"), and reading them from
		     * userspace is the entire point -- without this the instruction matches no
		     * clause below, uop.op stays II, and it retires as RI, which IRIX reports
		     * as SIGILL.
		     *
		     * Deliberately narrow: MFC0 only (rs==0), reads only, and only those two
		     * register numbers.  Opening the whole block to user mode would let
		     * userspace MTC0 scribble on Status/EntryHi.
		     *
		     * NOTE this diverges from MIPS twice over: architecturally any COP0 access
		     * without Status.CU0 raises CpU (cause 11), and we raise RI (cause 10)
		     * instead -- same SIGILL to userspace, different Cause. */
		    /* rs==0 is MFC0, rs==1 is DMFC0.  Both are reads, so both are safe to
		     * expose for $23/$24; DMFC0 is what you want since the 32-bit MFC0 view
		     * wraps in seconds.  DMFC0 additionally requires 64-bit mode below, so a
		     * 32-bit (o32) user still gets the MFC0 path only. */
		    if(in_kernel_mode |
		       (((insn[25:21] == 5'd0) | (insn[25:21] == 5'd1)) & (insn[10:0] == 'd0) &
			((insn[15:11] == 5'd23) | (insn[15:11] == 5'd24))))
		    begin
		    if((insn[25]==1'b1) & (insn[24:6] == 19'd0) & (insn[5:0] == 6'd1))
		      begin
			 uop.op = TLBR;
			 uop.is_int = 1'b1;
			 uop.oldest_first = 1'b1;
		      end
		    else if((insn[25]==1'b1) & (insn[24:6] == 19'd0) & (insn[5:0] == 6'd2))
		      begin
			 uop.op = TLBWI;
			 uop.is_int = 1'b1;
			 uop.oldest_first = 1'b1;
		      end
		    else if((insn[25]==1'b1) & (insn[24:6] == 19'd0) & (insn[5:0] == 6'd6))
		      begin
			 uop.op = TLBWR;
			 uop.is_int = 1'b1;
			 uop.oldest_first = 1'b1;
		      end
		    else if((insn[25]==1'b1) & (insn[24:6] == 19'd0) & (insn[5:0] == 6'd8))
		      begin
			 uop.op = TLBP;
			 uop.is_mem = 1'b1;
		      end	       
		    else if((insn[25:21] == 5'd0) & w_cop0_sel_ok) /* switch on RS */
		      begin /* mfc0 */
			 uop.op = (rt == 'd0) ? NOP : MFC0;
			 uop.dst = rt;
			 uop.dst_valid = (rt != 'd0); /* never a valid int dest of $0 */
			 uop.srcA = rd;
			 uop.is_int = 1'b1;
			 /* ordered by the CP0 sequence (uop.vh is_cp0_rd), except Cause: its
			  * IP bits are asynchronous, and the CP0 sequence does not order a read
			  * behind older loads/stores.  IRIX wbadaddr does a posted store, flushes
			  * it with uncached loads, then reads Cause.IP6 for the MC bus error; an
			  * early mfc0 misses IP6, which then fires when SR is restored ("IRIX
			  * Killed due to Bus Error", IRIX 5.3 boot).  The R4000 is in order, so
			  * read Cause at the head. */
			 uop.oldest_first = (rd == 'd13);
		      end
		    else if((insn[25:21] == 5'd1) & w_cop0_sel_ok) /* dmfc0 */
		      begin
			 /* NO counter exemption here: in 32-bit mode (o32 user) a 64-bit
			  * GPR read has no meaning -- the ABI's registers are 32-bit -- so
			  * DMFC0 correctly stays II and retires as RI, counters included.
			  * o32 reads the counters with MFC0 (32-bit view, wraps); n32/n64
			  * run with UX set, so w_in_64b_mode is already true for them and
			  * they get the full 64-bit DMFC0. */
			 if(w_in_64b_mode)
			   begin
			      uop.op = (rt == 'd0) ? NOP : DMFC0;
			      uop.dst = rt;
			      uop.dst_valid = (rt != 'd0); /* never a valid int dest of $0 */
			      uop.srcA = rd;
			      uop.is_int = 1'b1;
			      uop.oldest_first = (rd == 'd13);   /* Cause: see MFC0 */
			   end
			 /* else: 64-bit op in 32-bit mode -> op stays II (RI) */
		      end
		    else if((insn[25:21] == 5'd4) & w_cop0_sel_ok) /* switch on RS */
		      begin
			 uop.op = MTC0;
			 uop.dst = rd;
			 uop.srcA = rt;
			 uop.srcA_valid = 1'b1;
			 uop.has_delay_slot = 1'b0;
			 uop.is_int = 1'b1;
			 uop.serializing_op = !w_mtc0_plain;
		      end // case: 5'd4
		    else if((insn[25:21] == 5'd5) & w_cop0_sel_ok) /* dmtc0 */
		      begin
			 if(w_in_64b_mode)
			   begin
			      uop.op = DMTC0;
			      uop.dst = rd;
			      uop.srcA = rt;
			      uop.srcA_valid = 1'b1;
			      uop.has_delay_slot = 1'b0;
			      uop.is_int = 1'b1;
			      uop.serializing_op = !w_mtc0_plain;
			   end
			 /* else: 64-bit op in 32-bit mode -> op stays II (RI) */
		      end
		    else if(insn[25:0] == 26'b10000000000000000000011000)
		      begin
			 uop.op = ERET;
			 uop.oldest_first = 1'b1;
			 uop.has_delay_slot = 1'b0;
			 uop.is_int = 1'b1;
		      end
		    else if((insn[25]==1'b1) & (insn[24:6] == 19'd0) & (insn[5:0] == 6'd32))
		      begin
			 /* WAIT: r9999 has no low-power halt -- treat as NOP so the kernel
			  * idle loop (r4k_wait) spins with interrupts enabled instead of
			  * RI-faulting (same approach as CACHE->NOP). */
			 uop.op = NOP;
			 uop.is_int = 1'b1;
		      end
		    end // if(in_kernel_mode)
		    else
		      begin
			 uop.op = CPU; /* CP0 instruction outside kernel mode -> Coprocessor Unusable */
		      end
		 end // case: 6'd16
	       6'd17: /* coproc1 */
		 begin
		    if(!cu1)
		      begin /* CP1 with FPU disabled -> Coprocessor Unusable, CE=1 */
			 uop.op = CPU;
			 uop.cpu_ce1 = 1'b1;
		      end
		    else
		    if((insn[25:21]==5'd0) && (insn[10:0] == 11'd0))
		      begin /* mfc1: GPR[rt] <- FPR[fs] */
			 uop.dst = rt;
			 uop.dst_valid = (rt != 'd0); /* never a valid int dest of $0 */
			 uop.op = MFC1;
			 /* FR=0: read the EVEN reg of the pair; jmp_imm[0]=fs[0] picks the
			  * 32b half to extract (low=even, high=odd).  FR=1: whole reg, low32. */
			 if(!fr)
			   begin
			      uop.srcB = {fs[`LG_PRF_ENTRIES-1:1], 1'b0};
			      uop.jmp_imm[0] = fs[0];
			   end
			 else
			   uop.srcB = fs;
			 uop.fp_srcB_valid = 1'b1;
			 uop.is_mem = 1'b1;
		      end
		    else if((insn[25:21]==5'd4) && (insn[10:0] == 11'd0))
		      begin /* mtc1: FPR[fs] <- GPR[rt] */
			 uop.srcA = rt;
			 uop.srcA_valid = 1'b1;
			 uop.op = MTC1;
			 /* FR=0: write the EVEN reg; read it too (srcB) as the merge old-value;
			  * jmp_imm[0]=fs[0] picks the half to overwrite.  FR=1: whole reg. */
			 if(!fr)
			   begin
			      uop.dst = {fs[`LG_PRF_ENTRIES-1:1], 1'b0};
			      uop.srcB = {fs[`LG_PRF_ENTRIES-1:1], 1'b0};
			      uop.fp_srcB_valid = 1'b1;
			      uop.jmp_imm[0] = fs[0];
			   end
			 else
			   uop.dst = fs;
			 uop.fp_dst_valid = 1'b1;
			 uop.is_mem = 1'b1;
		      end // if ((insn[25:21]==5'd4) && (insn[10:0] == 11'd0))
		    else if((insn[25:21]==5'd2) && (insn[10:0] == 11'd0))
		      begin /* cfc1: GPR[rt] <- FCR[fs] (fs=insn[15:11]: 0=FIR, 31=FCSR) */
			 uop.op = (rt == 'd0) ? NOP : CFC1;
			 uop.dst = rt;
			 uop.dst_valid = (rt != 'd0); /* never a valid int dest of $0 */
			 uop.srcA = fs;        /* carry the FCR number (NOT a PRF read) */
			 uop.is_int = 1'b1;
			 uop.oldest_first = 1'b1;
			 uop.fcr_src_valid = 1'b1; /* read the renamed FCC to materialize FCSR */
		      end
		    else if((insn[25:21]==5'd6) && (insn[10:0] == 11'd0))
		      begin /* ctc1: FCR[fs] <- GPR[rt] (only FCR31 is writable) */
			 uop.op = CTC1;
			 uop.dst = fs;         /* the FCR number, for the FCSR-field write */
			 uop.srcA = rt;
			 uop.srcA_valid = 1'b1;
			 uop.fcr_dst_valid = 1'b1;  /* CTC1 writes all 8 CCs: full write */
			 uop.is_int = 1'b1;
			 uop.serializing_op = 1'b1;
		      end
		    else if((insn[25:21]==5'd1) && (insn[10:0] == 11'd0))
		      begin /* dmfc1: GPR[rt] <- FPR[fs] (full 64b) */
			 if(w_in_64b_mode)
			   begin
			      uop.op = DMFC1;
			      uop.dst = rt;
			      uop.dst_valid = (rt != 'd0); /* never a valid int dest of $0 */
			      uop.srcB = fs;
			      uop.fp_srcB_valid = 1'b1;
			      uop.is_mem = 1'b1;
			   end
		      end
		    else if((insn[25:21]==5'd5) && (insn[10:0] == 11'd0))
		      begin /* dmtc1: FPR[fs] <- GPR[rt] (full 64b) */
			 if(w_in_64b_mode)
			   begin
			      uop.srcA = rt;
			      uop.srcA_valid = 1'b1;
			      uop.op = DMTC1;
			      uop.dst = fs;
			      uop.fp_dst_valid = 1'b1;
			      uop.is_mem = 1'b1;
			   end
		      end
		    else if(insn[25:21]==5'd8)
		      begin /* BC1x: branch on FP condition code (read FCR) */
			 uop.fcr_src_valid = 1'b1;
			 uop.has_delay_slot = 1'b1;
			 uop.imm = insn[15:0];
			 uop.br_pred = insn_pred;
			 uop.is_br = 1'b1;
			 uop.is_int = 1'b1;
			 /* cc index (which condition-code bit) rides srcC, NOT renamed */
			 uop.srcC = {{(`LG_PRF_ENTRIES-3){1'b0}}, insn[20:18]};
			 case(insn[17:16])
			   2'b00: uop.op = BC1F;
			   2'b01: uop.op = BC1T;
			   2'b10:
			     begin
				uop.op = BC1FL;
				uop.has_nullifying_delay_slot = 1'b1;
			     end
			   2'b11:
			     begin
				uop.op = BC1TL;
				uop.has_nullifying_delay_slot = 1'b1;
			     end
			 endcase
		      end
		    else if((insn[25:21]==5'd16 || insn[25:21]==5'd17) &&
			    (insn[5:0]==6'd0 || insn[5:0]==6'd1 || insn[5:0]==6'd2 || insn[5:0]==6'd3))
		      begin /* ADD/SUB/MUL/DIV.[sd]: fmt 16=single,17=double; func 0=add,1=sub,2=mul,3=div */
			 uop.srcA = fs;
			 uop.fp_srcA_valid = 1'b1;
			 uop.srcB = ft;
			 uop.fp_srcB_valid = 1'b1;
			 uop.dst = fd;
			 uop.fp_dst_valid = 1'b1;
			 uop.is_fp = 1'b1;
			 if(insn[25:21]==5'd16) /* single */
			   uop.op = (insn[5:0]==6'd0) ? SP_ADD :
				    (insn[5:0]==6'd1) ? SP_SUB :
				    (insn[5:0]==6'd2) ? SP_MUL : SP_DIV;
			 else /* double */
			   uop.op = (insn[5:0]==6'd0) ? DP_ADD :
				    (insn[5:0]==6'd1) ? DP_SUB :
				    (insn[5:0]==6'd2) ? DP_MUL : DP_DIV;
		      end
		    else if((insn[25:21]==5'd16 || insn[25:21]==5'd17) && (insn[5:0]==6'd4))
		      begin /* SQRT.[sd]: single source (fs), func 4 */
			 uop.srcA = fs;
			 uop.fp_srcA_valid = 1'b1;
			 uop.dst = fd;
			 uop.fp_dst_valid = 1'b1;
			 uop.is_fp = 1'b1;
			 uop.op = (insn[25:21]==5'd16) ? SP_SQRT : DP_SQRT;
		      end
`ifdef ENABLE_MIPS4
		    else if((insn[25:21]==5'd16 || insn[25:21]==5'd17) &&
			    (insn[5:0]==6'd21 || insn[5:0]==6'd22))
		      begin /* RECIP(21)/RSQRT(22).[sd]: single source (fs), on the divider */
			 uop.srcA = fs;
			 uop.fp_srcA_valid = 1'b1;
			 uop.dst = fd;
			 uop.fp_dst_valid = 1'b1;
			 uop.is_fp = 1'b1;
			 if(insn[25:21]==5'd16)
			   begin
			      uop.op = (insn[5:0]==6'd21) ? SP_RECIP : SP_RSQRT;
			   end
			 else
			   begin
			      uop.op = (insn[5:0]==6'd21) ? DP_RECIP : DP_RSQRT;
			   end
		      end
		    else if((insn[25:21]==5'd16 || insn[25:21]==5'd17) &&
			    (insn[5:0]==6'd17 || insn[5:0]==6'd18 || insn[5:0]==6'd19))
		      begin /* MOVCF(17: movf/movt)/MOVZ(18)/MOVN(19).[sd]: fd = cond ? fs : fd.
			     * Two FP sources (fs, the old fd) and a one-bit condition:
			     * an FCC bit, or GPR rt's zero flag (int-renamed srcC) */
			 uop.srcA = fs;
			 uop.fp_srcA_valid = 1'b1;
			 uop.srcB = fd;
			 uop.fp_srcB_valid = 1'b1;
			 uop.dst = fd;
			 uop.fp_dst_valid = 1'b1;
			 uop.is_fp = 1'b1;
			 uop.op = FP_CMOV;
			 if(insn[5:0]==6'd17)
			   begin
			      uop.fcr_src_valid = 1'b1;
			      uop.imm = {10'd0, 2'd0, insn[16], insn[20:18]};
			   end
			 else
			   begin
			      uop.srcC = rt;
			      uop.srcC_valid = (rt != 'd0);
			      uop.imm = {10'd0, (insn[0] ? 2'd2 : 2'd1), 4'd0};
			   end
		      end
`endif
		    else if((insn[25:21]==5'd16 || insn[25:21]==5'd17) &&
			    (insn[5:0]==6'd5 || insn[5:0]==6'd6 || insn[5:0]==6'd7))
		      begin /* ABS(5)/MOV(6)/NEG(7).[sd]: single FP source, no flags */
			 uop.srcA = fs;
			 uop.fp_srcA_valid = 1'b1;
			 uop.dst = fd;
			 uop.fp_dst_valid = 1'b1;
			 uop.is_fp = 1'b1;
			 if(insn[25:21]==5'd16) /* single */
			   uop.op = (insn[5:0]==6'd5) ? SP_ABS :
				    (insn[5:0]==6'd6) ? SP_MOV : SP_NEG;
			 else /* double */
			   uop.op = (insn[5:0]==6'd5) ? DP_ABS :
				    (insn[5:0]==6'd6) ? DP_MOV : DP_NEG;
		      end
		    else if((insn[25:21]==5'd16 || insn[25:21]==5'd17) && (insn[5:4]==2'b11))
		      begin /* C.cond.fmt: all 16 predicates (func 48..63); cc = insn[10:8] */
			 uop.srcA = fs;
			 uop.fp_srcA_valid = 1'b1;
			 uop.srcB = ft;
			 uop.fp_srcB_valid = 1'b1;
			 uop.fcr_dst_valid = 1'b1; /* alloc a new FCR phys reg */
			 uop.fcr_src_valid = 1'b1; /* read old FCR to keep other CC bits */
			 uop.is_fp = 1'b1;
			 uop.imm = {9'd0, insn[3:0], insn[10:8]}; /* cond->imm[6:3], cc->imm[2:0] */
			 uop.op = (insn[25:21]==5'd16) ? SP_CMP : DP_CMP;
		      end
		    else if((insn[25:21]==5'd16 || insn[25:21]==5'd17) && (insn[5:0]==6'd13))
		      begin /* TRUNC.W.[sd]: FP->int32, round toward zero (f2i) */
			 uop.srcA = fs;
			 uop.fp_srcA_valid = 1'b1;
			 uop.dst = fd;
			 uop.fp_dst_valid = 1'b1;
			 uop.is_fp = 1'b1;
			 uop.op = (insn[25:21]==5'd16) ? TRUNC_W_S : TRUNC_W_D;
		      end
			    else if((insn[25:21]==5'd16 || insn[25:21]==5'd17) &&
				    (insn[5:0]==6'd12 || insn[5:0]==6'd14 ||
				     insn[5:0]==6'd15 || insn[5:0]==6'd36))
			      begin /* ROUND.W(12,RN)/CEIL.W(14,RP)/FLOOR.W(15,RM)/CVT.W(36,FCSR.RM) */
				 uop.srcA = fs;
				 uop.fp_srcA_valid = 1'b1;
				 uop.dst = fd;
				 uop.fp_dst_valid = 1'b1;
				 uop.is_fp = 1'b1;
				 uop.op = (insn[25:21]==5'd16) ? CVT_W_S : CVT_W_D;
				 /* rm carrier: imm[2]=1 -> FCSR.RM (cvt.w); else imm[1:0] fixed */
				 uop.imm = (insn[5:0]==6'd36) ? 16'd4 :   /* CVT.W -> FCSR.RM */
					   (insn[5:0]==6'd12) ? 16'd0 :   /* ROUND -> RN */
					   (insn[5:0]==6'd14) ? 16'd2 :   /* CEIL  -> RP */
							16'd3;    /* FLOOR -> RM */
			      end
			    else if((insn[25:21]==5'd16 || insn[25:21]==5'd17) &&
				    (insn[5:0]==6'd8 || insn[5:0]==6'd9 ||
				     insn[5:0]==6'd10 || insn[5:0]==6'd11 || insn[5:0]==6'd37))
			      begin /* f2i->L: ROUND.L(8,RN)/TRUNC.L(9,RZ)/CEIL.L(10,RP)/FLOOR.L(11,RM)/CVT.L(37,FCSR.RM) */
				 uop.srcA = fs;
				 uop.fp_srcA_valid = 1'b1;
				 uop.dst = fd;
				 uop.fp_dst_valid = 1'b1;
				 uop.is_fp = 1'b1;
				 uop.op = (insn[25:21]==5'd16) ? CVT_L_S : CVT_L_D;
				 uop.imm = (insn[5:0]==6'd37) ? 16'd4 :   /* CVT.L -> FCSR.RM */
					   (insn[5:0]==6'd8)  ? 16'd0 :   /* ROUND -> RN */
					   (insn[5:0]==6'd9)  ? 16'd1 :   /* TRUNC -> RZ */
					   (insn[5:0]==6'd10) ? 16'd2 :   /* CEIL  -> RP */
							16'd3;    /* FLOOR -> RM */
			      end
			    else if((insn[25:21]==5'd21) && (insn[5:0]==6'd32 || insn[5:0]==6'd33))
			      begin /* CVT.S.L / CVT.D.L: int64 -> FP (i2f, src_long), FCSR.RM */
				 uop.srcA = fs;
				 uop.fp_srcA_valid = 1'b1;
				 uop.dst = fd;
				 uop.fp_dst_valid = 1'b1;
				 uop.is_fp = 1'b1;
				 uop.op = (insn[5:0]==6'd32) ? CVT_S_L : CVT_D_L;
			      end
		    else if((insn[25:21]==5'd20) && (insn[5:0]==6'd32 || insn[5:0]==6'd33))
		      begin /* CVT.S.W / CVT.D.W: int32->FP (i2f), FCSR.RM */
			 uop.srcA = fs;
			 uop.fp_srcA_valid = 1'b1;
			 uop.dst = fd;
			 uop.fp_dst_valid = 1'b1;
			 uop.is_fp = 1'b1;
			 uop.op = (insn[5:0]==6'd32) ? CVT_S_W : CVT_D_W;
		      end
			    else if((insn[25:21]==5'd17 && insn[5:0]==6'd32) ||  /* CVT.S.D: D->S narrow */
				    (insn[25:21]==5'd16 && insn[5:0]==6'd33))    /* CVT.D.S: S->D widen */
			      begin /* FP<->FP convert (f2f): narrow rounds per RM, widen is exact */
				 uop.srcA = fs;
				 uop.fp_srcA_valid = 1'b1;
				 uop.dst = fd;
				 uop.fp_dst_valid = 1'b1;
				 uop.is_fp = 1'b1;
				 uop.op = (insn[5:0]==6'd32) ? CVT_S_D : CVT_D_S;
			      end
			    else
			      begin /* any other COP1 op: Unimplemented (E) -> OS soft-float emulator */
				 uop.srcA = fs;
				 uop.fp_srcA_valid = 1'b1;
				 uop.dst = fd;
				 uop.fp_dst_valid = 1'b1;
				 uop.is_fp = 1'b1;
				 uop.op = FP_UNIMPL;
			      end
		 end // case: 6'd17
	       6'd20: /* BEQL */
		 begin
		    /* `beqzl rs' IS `beql rs,$0' -- the same physreg-0 read BEQZ/BNEZ
		     * already removed for the non-likely forms; branch-likely was
		     * simply missed.  Both operands $0 is degenerate (beql $0,$0 is
		     * always taken, bnel $0,$0 never taken but STILL nullifies its
		     * delay slot, so it is not a NOP) -- left as plain BEQL, matching
		     * the teq/tne $0,$0 precedent. */
		    uop.op = ((rs == 'd0) ^ (rt == 'd0)) ? BEQZL : BEQL;
		    uop.dst_valid = 1'b0;
		    uop.dst = 'd0;
		    uop.srcA = (rs == 'd0) ? rt : rs;
		    uop.srcA_valid = 1'b1;
		    uop.srcB = rt;
		    uop.srcB_valid = !((rs == 'd0) ^ (rt == 'd0));
		    uop.has_delay_slot = 1'b1;
		    uop.has_nullifying_delay_slot = 1'b1;
		    uop.imm = insn[15:0];
		    uop.is_br = 1'b1;
		    uop.br_pred = insn_pred;
		    uop.is_int = 1'b1;
		 end // case: 6'd20
	       6'd21: /* BNEL */
		 begin
		    /* `bnezl rs' IS `bnel rs,$0' -- the same physreg-0 read BEQZ/BNEZ
		     * already removed for the non-likely forms; branch-likely was
		     * simply missed.  Both operands $0 is degenerate (beql $0,$0 is
		     * always taken, bnel $0,$0 never taken but STILL nullifies its
		     * delay slot, so it is not a NOP) -- left as plain BNEL, matching
		     * the teq/tne $0,$0 precedent. */
		    uop.op = ((rs == 'd0) ^ (rt == 'd0)) ? BNEZL : BNEL;
		    uop.dst_valid = 1'b0;
		    uop.dst = 'd0;
		    uop.srcA = (rs == 'd0) ? rt : rs;
		    uop.srcA_valid = 1'b1;
		    uop.srcB = rt;
		    uop.srcB_valid = !((rs == 'd0) ^ (rt == 'd0));
		    uop.has_delay_slot = 1'b1;
		    uop.has_nullifying_delay_slot = 1'b1;
		    uop.imm = insn[15:0];
		    uop.is_br = 1'b1;
		    uop.br_pred = insn_pred;
		    uop.is_int = 1'b1;
		 end // case: 6'd21
	       6'd22: /* BLEZL */
		 begin	    
		    uop.op = BLEZL;
		    uop.dst_valid = 1'b0;
		    uop.dst = 'd0;
		    uop.srcA = rs;
		    uop.srcA_valid = 1'b1;
		    uop.has_delay_slot = 1'b1;
		    uop.has_nullifying_delay_slot = 1'b1;	       
		    uop.imm = insn[15:0];
		    uop.is_br = 1'b1;
		    uop.br_pred = insn_pred;
		    uop.is_int = 1'b1;
		 end // case: 6'd22
	       6'd23: /* BGTZL */
		 begin
		    uop.op = BGTZL;
		    uop.dst_valid = 1'b0;
		    uop.dst = 'd0;
		    uop.srcA = rs;
		    uop.srcA_valid = 1'b1;
		    uop.has_delay_slot = 1'b1;
		    uop.has_nullifying_delay_slot = 1'b1;
		    uop.imm = insn[15:0];
		    uop.is_br = 1'b1;
		    uop.br_pred = insn_pred;
		    uop.is_int = 1'b1;
		 end // case: 6'd23
	       6'd24: /* daddi (traps on 64-bit overflow) */
		 begin
		    if(w_in_64b_mode)
		      begin
			 uop.srcA = rs;
			 uop.srcA_valid = 1'b1;
			 uop.dst = rt;
			 uop.dst_valid = (rt != 'd0);
			 uop.op = (rt == 'd0) ? DADDICHK : DADDI;
			 uop.imm = insn[15:0];
			 uop.is_int = 1'b1;
		      end
		 end
	       6'd25: /* daddiu */
		 begin
		    if(w_in_64b_mode)
		      begin
			 uop.srcA = rs;
			 uop.srcA_valid = 1'b1;
			 uop.dst = rt;
			 uop.dst_valid = (rt != 'd0);
			 uop.op = (rt == 'd0) ? NOP : DADDIU;
			 uop.imm = insn[15:0];
			 uop.is_int = 1'b1;
		      end
		 end
	       6'd32: /* LB */
		 begin
		    uop.op = LB;
		    uop.srcA = rs;
		    uop.srcA_valid = 1'b1;
		    uop.dst = rt;
		    uop.dst_valid = (rt != 'd0);
		    uop.imm = insn[15:0];
		    uop.is_mem = 1'b1;
		 end
	       6'd33: /* LH */
		 begin
		    uop.op = LH;
		    uop.srcA = rs;
		    uop.srcA_valid = 1'b1;
		    uop.dst = rt;
		    uop.dst_valid = (rt != 'd0);
		    uop.imm = insn[15:0];
		    uop.is_mem = 1'b1;
		 end
	       6'd26: /* LDL */
		 begin
		    if(w_in_64b_mode)
		      begin
			 uop.op = LDL;
			 uop.srcA = rs;
			 uop.srcA_valid = 1'b1;
			 uop.srcB = rt;
			 uop.srcB_valid = 1'b1;
			 uop.dst = rt;
			 uop.dst_valid = (rt != 'd0);
			 uop.imm = insn[15:0];
			 uop.is_mem = 1'b1;
		      end
		 end
	       6'd27: /* LDR */
		 begin
		    if(w_in_64b_mode)
		      begin
			 uop.op = LDR;
			 uop.srcA = rs;
			 uop.srcA_valid = 1'b1;
			 uop.srcB = rt;
			 uop.srcB_valid = 1'b1;
			 uop.dst = rt;
			 uop.dst_valid = (rt != 'd0);
			 uop.imm = insn[15:0];
			 uop.is_mem = 1'b1;
		      end
		 end
	       6'd34: /* LWL */
		 begin
		    uop.op = LWL;
		    uop.srcA = rs;
		    uop.srcA_valid = 1'b1;
		    uop.srcB = rt;
		    uop.srcB_valid = 1'b1;
		    uop.dst = rt;
		    uop.dst_valid = (rt != 'd0);
		    uop.imm = insn[15:0];
		    uop.is_mem = 1'b1;
		 end
	       6'd35: /* LW */
		 begin
		    uop.op = LW;
		    uop.srcA = rs;
		    uop.srcA_valid = 1'b1;
		    uop.dst = rt;
		    uop.dst_valid = (rt != 'd0);
		    uop.imm = insn[15:0];
		    uop.is_mem = 1'b1;
		 end
	       6'd36: /* LBU */
		 begin
		    uop.op = LBU;
		    uop.srcA = rs;
		    uop.srcA_valid = 1'b1;
		    uop.dst = rt;
		    uop.dst_valid = (rt != 'd0);
		    uop.imm = insn[15:0];
		    uop.is_mem = 1'b1;
		 end
	       6'd37: /* LHU */
		 begin
		    uop.op = LHU;
		    uop.srcA = rs;
		    uop.srcA_valid = 1'b1;
		    uop.dst = rt;
		    uop.dst_valid = (rt != 'd0);
		    uop.imm = insn[15:0];
		    uop.is_mem = 1'b1;
		 end
	       6'd38: /* LWR */
		 begin
		    uop.op = LWR;
		    uop.srcA = rs;
		    uop.srcA_valid = 1'b1;
		    uop.srcB = rt;
		    uop.srcB_valid = 1'b1;
		    uop.dst = rt;
		    uop.dst_valid = (rt != 'd0);
		    uop.imm = insn[15:0];
		    uop.is_mem = 1'b1;
		 end
	       6'd39: /* LWU */
		 begin
		    if(w_in_64b_mode)
		      begin
			 uop.op = LWU;
			 uop.srcA = rs;
			 uop.srcA_valid = 1'b1;
			 uop.dst = rt;
			 uop.dst_valid = (rt != 'd0);
			 uop.imm = insn[15:0];
			 uop.is_mem = 1'b1;
		      end
		 end
	       6'd40: /* SB */
		 begin
		    uop.op = SB;
		    uop.srcA = rs;
		    uop.srcA_valid = 1'b1;
		    uop.srcB = rt;
		    uop.srcB_valid = 1'b1;
		    uop.imm = insn[15:0];
		    uop.is_mem = 1'b1;
		    uop.is_store = 1'b1;
		 end	    
	       6'd41: /* SH */
		 begin
		    uop.op = SH;
		    uop.srcA = rs;
		    uop.srcA_valid = 1'b1;
		    uop.srcB = rt;
		    uop.srcB_valid = 1'b1;
		    uop.imm = insn[15:0];
		    uop.is_mem = 1'b1;
		    uop.is_store = 1'b1;	       
		 end
	       6'd42:
		 begin
		    uop.op = SWL;
		    uop.srcA = rs;
		    uop.srcA_valid = 1'b1;
		    uop.srcB = rt;
		    uop.srcB_valid = 1'b1;
		    uop.imm = insn[15:0];
		    uop.is_mem = 1'b1;
		    uop.is_store = 1'b1;
		 end
	       6'd43: /* SW */
		 begin
		    uop.op = SW;
		    uop.srcA = rs;
		    uop.srcA_valid = 1'b1;
		    uop.srcB = rt;
		    uop.srcB_valid = 1'b1;
		    uop.imm = insn[15:0];
		    uop.is_mem = 1'b1;
		    uop.is_store = 1'b1;
		 end
	       6'd44: /* SDL */
		 begin
		    if(w_in_64b_mode)
		      begin
			 uop.op = SDL;
			 uop.srcA = rs;
			 uop.srcA_valid = 1'b1;
			 uop.srcB = rt;
			 uop.srcB_valid = 1'b1;
			 uop.imm = insn[15:0];
			 uop.is_mem = 1'b1;
			 uop.is_store = 1'b1;
		      end
		 end
	       6'd45: /* SDR */
		 begin
		    if(w_in_64b_mode)
		      begin
			 uop.op = SDR;
			 uop.srcA = rs;
			 uop.srcA_valid = 1'b1;
			 uop.srcB = rt;
			 uop.srcB_valid = 1'b1;
			 uop.imm = insn[15:0];
			 uop.is_mem = 1'b1;
			 uop.is_store = 1'b1;
		      end
		 end
	       6'd46: /* SWR */
		 begin
		    uop.op = SWR;
		    uop.srcA = rs;
		    uop.srcA_valid = 1'b1;
		    uop.srcB = rt;
		    uop.srcB_valid = 1'b1;
		    uop.imm = insn[15:0];
		    uop.is_mem = 1'b1;
		    uop.is_store = 1'b1;
		 end
	       6'd47: /* CACHE: w_cache_act (the CPU model's table, above) picks the action.
		       * D hit ops are MEM uops (AGU -> mem queue -> l1d, where the dtlb
		       * translates the EA: IRIX invalidates MAPPED K2SEG buffer-cache lines
		       * for DMA; the old funnel path masked VA&0x1fffffff, wrong for mapped
		       * EAs -> stale superblock -> EWRONGFS), whose side effect defers to
		       * post-retirement via store graduation.  The line actions serialize
		       * and act at retire (core.sv), on the EA = base+offset in rob.data. */
		 begin
		    if(!in_kernel_mode)
		      begin
			 uop.op = CPU; /* CACHE outside kernel mode -> Coprocessor Unusable */
		      end
		    else if(w_cache_act == CA_NOP)
		      begin
			 uop.op = NOP;
			 uop.is_int = 1'b1;
		      end
		    else if((w_cache_act == CA_D_HIT_INV) || (w_cache_act == CA_D_HIT_WBINV) ||
			    (w_cache_act == CA_D_HIT_WB) || (w_cache_act == CA_BLK_HIT_INV) ||
			    (w_cache_act == CA_BLK_HIT_WBINV) || (w_cache_act == CA_BLK_INDEX_WBINV))
		      begin
			 /* the R10000 block ops (CA_BLK_*) go to the L2 as MEM_BLK_*, which
			  * sequences the 128-byte block */
			 uop.op = (w_cache_act == CA_D_HIT_INV) ? CHINV :
				  (w_cache_act == CA_D_HIT_WBINV) ? CHWBINV :
				  (w_cache_act == CA_D_HIT_WB) ? CHWB :
				  (w_cache_act == CA_BLK_HIT_INV) ? CHBINV :
				  (w_cache_act == CA_BLK_HIT_WBINV) ? CHBWBINV : CHBIDX;
			 uop.is_mem = 1'b1;
			 uop.srcA = rs;
			 uop.srcA_valid = 1'b1;
			 uop.imm = insn[15:0];
		      end
		    else
		      begin
			 uop.op = CACHE_OP;
			 uop.is_int = 1'b1;
			 uop.serializing_op = 1'b1;
			 uop.is_cache = 1'b1;
			 uop.cache_act = w_cache_act;
			 uop.srcA = rs;
			 uop.srcA_valid = 1'b1;
			 uop.imm = insn[15:0];
		      end
		 end
	       6'd48: /* LL */
		 begin
		    uop.op = LL;
		    uop.srcA = rs;
		    uop.srcA_valid = 1'b1;
		    uop.dst = rt;
		    uop.dst_valid = (rt != 'd0);
		    uop.imm = insn[15:0];
		    uop.is_mem = 1'b1;
		    uop.oldest_first = 1'b1;
		 end
	       6'd52: /* LLD */
		 begin
		    if(w_in_64b_mode)
		      begin
			 uop.op = LLD;
			 uop.srcA = rs;
			 uop.srcA_valid = 1'b1;
			 uop.dst = rt;
			 uop.dst_valid = (rt != 'd0);
			 uop.imm = insn[15:0];
			 uop.is_mem = 1'b1;
			 uop.oldest_first = 1'b1;
		      end
		 end
	       6'd56: /* SC */
		 begin
		    uop.op = SC;
		    uop.srcA = rs;
		    uop.srcA_valid = 1'b1;
		    uop.srcB = rt;
		    uop.srcB_valid = 1'b1;
		    uop.dst = rt;
		    uop.dst_valid = (rt != 'd0);
		    uop.imm = insn[15:0];
		    uop.is_mem = 1'b1;
		    uop.is_store = 1'b1;
		    uop.oldest_first = 1'b1;
		 end
	       6'd60: /* SCD */
		 begin
		    if(w_in_64b_mode)
		      begin
			 uop.op = SCD;
			 uop.srcA = rs;
			 uop.srcA_valid = 1'b1;
			 uop.srcB = rt;
			 uop.srcB_valid = 1'b1;
			 uop.dst = rt;
			 uop.dst_valid = (rt != 'd0);
			 uop.imm = insn[15:0];
			 uop.is_mem = 1'b1;
			 uop.is_store = 1'b1;
			 uop.oldest_first = 1'b1;
		      end
		 end
`ifdef ENABLE_MIPS4
	       6'd19: /* COP1X (MIPS IV): indexed FP loads/stores, address = base + index.
		       * The ops are LWC1/LDC1/SWC1/SDC1 with imm 0 and the index GPR (rt
		       * field) in srcC: on a mem uop srcC_valid means "add srcC", which the
		       * AGU selects instead of the immediate (exec.sv w_agu).  srcB keeps its
		       * meaning (store data / the FR=0 merge read), so the store-data path
		       * is untouched.  index = $0 -> srcC_valid = 0 -> + 0.  madd/msub/
		       * nmadd/nmsub (funct 32..57) are three-source FP ops, below. */
		 begin
		    if(!cu1)
		      begin
			 uop.op = CPU;
			 uop.cpu_ce1 = 1'b1;
		      end
		    else
		      begin
			 case(insn[5:0])
			   6'd0: /* LWXC1: FPR[fd] <- mem[base+index] (low 32b) */
			     begin
				uop.op = LWC1;
				uop.srcA = rs;
				uop.srcA_valid = 1'b1;
				uop.srcC = rt;
				uop.srcC_valid = (rt != 'd0);
				uop.fp_dst_valid = 1'b1;
				uop.is_mem = 1'b1;
				if(!fr)
				  begin
				     uop.dst = {fd[`LG_PRF_ENTRIES-1:1], 1'b0};
				     uop.srcB = {fd[`LG_PRF_ENTRIES-1:1], 1'b0};
				     uop.fp_srcB_valid = 1'b1;
				     uop.jmp_imm[0] = fd[0];
				  end
				else
				  begin
				     uop.dst = fd;
				  end
			     end
			   6'd1: /* LDXC1: FPR[fd] <- mem[base+index] (64b) */
			     begin
				uop.op = LDC1;
				uop.srcA = rs;
				uop.srcA_valid = 1'b1;
				uop.srcC = rt;
				uop.srcC_valid = (rt != 'd0);
				uop.dst = fr ? fd : {fd[`LG_PRF_ENTRIES-1:1], 1'b0};
				uop.fp_dst_valid = 1'b1;
				uop.is_mem = 1'b1;
			     end
			   6'd8: /* SWXC1: mem[base+index] <- FPR[fs] (low 32b) */
			     begin
				uop.op = SWC1;
				uop.srcA = rs;
				uop.srcA_valid = 1'b1;
				uop.srcC = rt;
				uop.srcC_valid = (rt != 'd0);
				if(!fr)
				  begin
				     uop.srcB = {fs[`LG_PRF_ENTRIES-1:1], 1'b0};
				     uop.jmp_imm[0] = fs[0];
				  end
				else
				  begin
				     uop.srcB = fs;
				  end
				uop.fp_srcB_valid = 1'b1;
				uop.is_mem = 1'b1;
				uop.is_store = 1'b1;
			     end
			   6'd9: /* SDXC1: mem[base+index] <- FPR[fs] (64b) */
			     begin
				uop.op = SDC1;
				uop.srcA = rs;
				uop.srcA_valid = 1'b1;
				uop.srcC = rt;
				uop.srcC_valid = (rt != 'd0);
				uop.srcB = fr ? fs : {fs[`LG_PRF_ENTRIES-1:1], 1'b0};
				uop.fp_srcB_valid = 1'b1;
				uop.is_mem = 1'b1;
				uop.is_store = 1'b1;
			     end
			   6'd15: /* PREFX: a hint */
			     begin
				uop.op = NOP;
				uop.is_int = 1'b1;
			     end
			   /* MADD(4)/MSUB(5)/NMADD(6)/NMSUB(7) = funct[5:3], fmt3 = funct[2:0]
			    * (0 = S, 1 = D): fd = fs*ft +- fr.  fr is the base field. */
			   6'd32, 6'd33, 6'd40, 6'd41, 6'd48, 6'd49, 6'd56, 6'd57:
			     begin
				uop.srcA = fs;
				uop.fp_srcA_valid = 1'b1;
				uop.srcB = ft;
				uop.fp_srcB_valid = 1'b1;
				uop.srcC = rs;
				uop.fp_srcC_valid = 1'b1;
				uop.dst = fd;
				uop.fp_dst_valid = 1'b1;
				uop.is_fp = 1'b1;
				uop.op = (insn[5:0] == 6'd32) ? SP_MADD :
					 (insn[5:0] == 6'd33) ? DP_MADD :
					 (insn[5:0] == 6'd40) ? SP_MSUB :
					 (insn[5:0] == 6'd41) ? DP_MSUB :
					 (insn[5:0] == 6'd48) ? SP_NMADD :
					 (insn[5:0] == 6'd49) ? DP_NMADD :
					 (insn[5:0] == 6'd56) ? SP_NMSUB : DP_NMSUB;
			     end
			   default:
			     begin
			     end
			 endcase // case (insn[5:0])
		      end
		 end
`endif
	       6'd49: /* LWC1: FPR[ft] <- mem[rs+off] (low 32b) */
		 begin
		    if(!cu1)
		      begin uop.op = CPU; uop.cpu_ce1 = 1'b1; end
		    else
		    begin
		    uop.op = LWC1;
		    uop.srcA = rs;
		    uop.srcA_valid = 1'b1;
		    uop.fp_dst_valid = 1'b1;
		    uop.imm = insn[15:0];
		    uop.is_mem = 1'b1;
		    /* FR=0: write the EVEN reg's jmp_imm[0]-selected 32b half, preserving
		     * the other half.  Read the even reg (srcB) at issue for the merge old
		     * value (spliced at writeback).  FR=1: whole reg ft, plain load. */
		    if(!fr)
		      begin
			 uop.dst = {ft[`LG_PRF_ENTRIES-1:1], 1'b0};
			 uop.srcB = {ft[`LG_PRF_ENTRIES-1:1], 1'b0};
			 uop.fp_srcB_valid = 1'b1;
			 uop.jmp_imm[0] = ft[0];
		      end
		    else
		      uop.dst = ft;
		    end
		 end
	       6'd53: /* LDC1: FPR[ft] <- mem[rs+off] (64b) */
		 begin
		    if(!cu1)
		      begin uop.op = CPU; uop.cpu_ce1 = 1'b1; end
		    else
		    begin
			 uop.op = LDC1;
			 uop.srcA = rs;
			 uop.srcA_valid = 1'b1;
			 uop.dst = fr ? ft : {ft[`LG_PRF_ENTRIES-1:1], 1'b0}; /* FR=0 odd ft: force even (see fp-reg check below) */
			 uop.fp_dst_valid = 1'b1;
			 uop.imm = insn[15:0];
			 uop.is_mem = 1'b1;
		    end
		 end
	       6'd51: /* PREF */
		 begin
		    uop.op = NOP;
		    uop.is_int = 1'b1;
		 end
	       6'd57: /* SWC1: mem[rs+off] <- FPR[ft] (low 32b) */
		 begin
		    if(!cu1)
		      begin uop.op = CPU; uop.cpu_ce1 = 1'b1; end
		    else
		    begin
		    uop.op = SWC1;
		    uop.srcA = rs;
		    uop.srcA_valid = 1'b1;
		    /* FR=0: store the half (even=low, odd=high) of the EVEN reg; jmp_imm[0]
		     * = ft[0] picks it.  FR=1: low 32 of the whole reg. */
		    if(!fr)
		      begin
			 uop.srcB = {ft[`LG_PRF_ENTRIES-1:1], 1'b0};
			 uop.jmp_imm[0] = ft[0];
		      end
		    else
		      uop.srcB = ft;
		    uop.fp_srcB_valid = 1'b1;
		    uop.imm = insn[15:0];
		    uop.is_mem = 1'b1;
		    uop.is_store = 1'b1;
		    end
		 end
	       6'd61: /* SDC1: mem[rs+off] <- FPR[ft] (64b) */
		 begin
		    if(!cu1)
		      begin uop.op = CPU; uop.cpu_ce1 = 1'b1; end
		    else
		    begin
			 uop.op = SDC1;
			 uop.srcA = rs;
			 uop.srcA_valid = 1'b1;
			 uop.srcB = fr ? ft : {ft[`LG_PRF_ENTRIES-1:1], 1'b0}; /* FR=0 odd ft: force even (see fp-reg check below) */
			 uop.fp_srcB_valid = 1'b1;
			 uop.imm = insn[15:0];
			 uop.is_mem = 1'b1;
			 uop.is_store = 1'b1;
		    end
		 end
	       6'd55: /* LD */
		 begin
		    if(w_in_64b_mode)
		      begin
			 uop.op = LD;
			 uop.srcA = rs;
			 uop.srcA_valid = 1'b1;
			 uop.dst = rt;
			 uop.dst_valid = (rt != 'd0);
			 uop.imm = insn[15:0];
			 uop.is_mem = 1'b1;
		      end
		 end
	       6'd63: /* SD */
		 begin
		    if(w_in_64b_mode)
		      begin
			 uop.op = SD;
			 uop.srcA = rs;
			 uop.srcA_valid = 1'b1;
			 uop.srcB = rt;
			 uop.srcB_valid = 1'b1;
			 uop.imm = insn[15:0];
			 uop.is_mem = 1'b1;
			 uop.is_store = 1'b1;
		      end
		 end

	       default:
		 begin
		 end
	     endcase // case (insn[5:0])

	     /* ---- FR=0 odd-register FP-compute gate (DESIGN NOTE) ----------------
	      * In FR=0 (o32 / MIPS I-II FP model) the 32 FPRs are 16 even/odd 32-bit
	      * pairs, and ARITHMETIC is defined only on even-numbered registers
	      * (R10000 UM p.307, "32- and 64-Bit Operations"; Fig 15-5).  An odd
	      * register on a compute op is architecturally UNPREDICTABLE -- MIPS is
	      * wildly underspecified here: it mandates NO specific exception, and the
	      * Sail spec (sail-cheri-mips) doesn't even model FR (mips_prelude.sail:
	      * "RP/FR/RE/MX/PX not implemented") so it gives no ruling.  The R10000
	      * silently forces the low bit to 0 (treats odd as even) -- a SILENT
	      * fault we refuse.  WE CHOOSE Reserved Instruction (ResI / ExcCode 10):
	      * loud, uses the standard RI code, and is correct as PERMANENT behavior
	      * even once FR=0 is fully supported (odd-reg compute stays malformed; the
	      * FR=0 merge work only makes the VALID cases -- even-reg arith + odd/even
	      * load halves -- work).  This per-op silent-half merge in FR=0 is exactly
	      * why mipscore sprayed MERGE variants through every FP op; we instead gate
	      * compute here and (later) do the R10000 rename-alias + load/move merge.
	      * `is_fp` is set ONLY by FP compute (add/sub/mul/div/sqrt/cmp/cvt/abs/
	      * neg/mov) -- never by moves/loads/stores -- so it selects exactly the
	      * even-only ops.  Unused reg fields are 0 in valid encodings (compares:
	      * insn[6]=0; single-src: ft=0), so the uniform fs|ft|fd low-bit test is
	      * safe and, on a malformed encoding, conservatively faults. */
	     /* Only (compute) is_fp ops with an odd fs/ft/fd in FR=0 stay malformed
	      * -> II -> RI (odd-reg arith is genuinely undefined).  LDC1/SDC1 with an
	      * odd ft are NOT faulted: real R4K/R10K, MAME, and our iris ISS all treat
	      * odd-as-even (never RI) -- iris = fpr[reg & !1] -- and the Linux kernel FP
	      * save (_save_fp_context stores all 32, odd incl.) relies on it.  We force
	      * ft even at the LDC1/SDC1 decode above; the even doubleword covers both
	      * FR=0 single halves (lwc1/swc1 already merge them into the even reg). */
	     /* the .fmt conditional moves have no ft: insn[16] is tf (movt/movf) or the
	      * low bit of GPR rt (movz/movn), so only fs and fd must be even */
	     if((fr == 1'b0) && uop.is_fp && (insn[11] | (insn[16] & (uop.op != FP_CMOV)) | insn[6] |
					     (insn[21] & uop.fp_srcC_valid)))   /* madd: fr = insn[25:21] */
	       begin
		  uop.op            = II;   /* -> is_ii -> ARCH_FAULT -> cause 10 (ResI) */
		  uop.is_fp         = 1'b0;
		  uop.is_mem        = 1'b0;
		  uop.is_store      = 1'b0;
		  uop.fp_srcA_valid = 1'b0;
		  uop.fp_srcB_valid = 1'b0;
		  uop.fp_srcC_valid = 1'b0;
		  uop.fp_dst_valid  = 1'b0;
		  uop.fcr_src_valid = 1'b0;
		  uop.fcr_dst_valid = 1'b0;
		  uop.srcA_valid    = 1'b0;
		  uop.dst_valid     = 1'b0;
	       end
	  end // always_comb
     end   

endmodule
   
