dsheffie/r9999/exec.sv

`include "uop.vh"
`include "rob.vh"

`ifdef VERILATOR
import "DPI-C" function void report_exec(input int int_valid, 
					 input int int_blocked,
					 input int mem_valid, 
					 input int mem_blocked,
					 input int fp_valid, 
					 input int fp_blocked,
					 input int iq_full,
					 input int mq_full,
					 input int fq_full,
					 input int blocked_by_store,
					 input int int_ready
					 );
/* checkpoint resume seeds (Verilator only): full control-register + HILO state */
import "DPI-C" function int     have_checkpoint();
import "DPI-C" function int     loadcp0(input int regid);
import "DPI-C" function longint loadcp0_64(input int regid);
import "DPI-C" function longint loadhilo(input int half);
import "DPI-C" function int     loadfcsr();
`endif

module exec(clk, 
	    reset,
	    ip6,
	    ip5,
	    ip4,
	    ip3,
	    ip2,
	    retire,
	    retire_two,
	    single_step,
	    core_epc,
	    core_wr_epc,
	    core_cause,
	    core_ce,
	    core_wr_cause,
	    core_wr_badvaddr,
	    core_badvaddr,
	    core_fcsr_we,
	    core_fcsr_cause6,
	    core_fcsr_flags5,
	    exec_epc,
	    cause_ip,
	    core_wr_tlbp,
	    core_tlbp_hit,
	    core_tlbp_index,
	    save_to_tlb_regs,
	    asid,
	    sr_bev,
	    sr_exl,
	    exc_in_delay,
	    in_kernel_mode,
	    in_supervisor_mode,
	    in_user_mode,
	    in_64b_user_mode,
	    in_64b_supervisor_mode,
	    cu1,
	    fr,
	    in_64b_kernel_mode,
	    putchar_fifo_out,
	    putchar_fifo_empty,
	    putchar_fifo_pop,
	    putchar_fifo_wptr,
	    putchar_fifo_rptr,
`ifdef VERILATOR
	    clear_cnt,
`endif
	    divide_ready,
	    ds_done,
	    restart_complete,
	    head_of_rob_ptr_valid,
	    head_of_rob_ptr,
	    dbg_exec_snap,
	    next_head_of_rob_ptr,
	    head_of_rob_ds_committable,
	    retire_cp0_valid,
	    retire_cp0_staged,
	    retire_cp0_rob_ptr,
	    cpr0_status_reg,
	    uq_wait,
	    mq_wait,
	    fp_uq_wait,
	    dbg_memop_idx,
	    dbg_memop_pc,
	    uq_full,
	    uq_next_full,
	    uq_uop,
	    uq_uop_two,
	    uq_push,
	    uq_push_two,
	    complete_bundle_1,
	    complete_valid_1,
	    complete_bundle_2,
	    complete_valid_2,
	    mem_req,
	    mem_req_valid, 
	    mem_req_ack,
	    //tell rob store data has been read
	    core_store_data_ptr,
	    core_store_data_ptr_valid,
	    mem_rsp_dst_ptr,
	    mem_rsp_dst_valid,
	    mem_rsp_fp_dst,
	    mem_rsp_fp_merge,
	    mem_rsp_fp_hi,
	    mem_rsp_fp_pres,
	    mem_rsp_rob_ptr,
	    mem_rsp_load_data,
	    mem_rsp_valid,
	    mem_rsp_lsu_hold,
	    mem_rsp_lsu_idx,
	    mem_blk_valid,
	    mem_blk_code,
	    mem_blk_st,
	    mem_wake_valid,
	    mem_st_done_valid,
	    mem_st_done_idx,
	    lsu_sb,
	    restart_color,
	    mem_color_pending,
	    retired_rob_ptr_valid,
	    retired_rob_ptr_two_valid,
	    retired_rob_ptr,
	    retired_rob_ptr_two,
	    tlb_entry_out,
	    tlb_entry_out_valid,
	    irq_pending,
	    cp0_count,
	    cp0_random
	    );
   input logic clk;
   input logic reset;
   input logic ip6;
   input logic ip5;
   input logic ip4;
   input logic ip3;
   input logic ip2;
   input logic retire;
   input logic retire_two;
   input logic single_step;
   input logic [`M_WIDTH-1:0] core_epc;
       
   input logic		      core_wr_epc;
   input logic [4:0]	      core_cause;
   input logic [1:0]	      core_ce;     /* Cause.CE (coprocessor #) for a CpU exception */
   input logic		      core_wr_cause;
   input logic		      core_wr_badvaddr;
   input logic [`M_WIDTH-1:0] core_badvaddr;
   /* FCSR (FCR31) update from retire/fault: set the Cause field (bits 17:12) and
    * OR sticky exceptions into the Flags field (bits 6:2). */
   input logic		      core_fcsr_we;
   input logic [5:0]	      core_fcsr_cause6;  /* {E,V,Z,O,U,I} this op raised */
   input logic [4:0]	      core_fcsr_flags5;  /* {V,Z,O,U,I} to OR into Flags (0 on a trap) */

   output logic [`M_WIDTH-1:0] exec_epc;
   input logic		       save_to_tlb_regs;
   input logic		       core_wr_tlbp;
   input logic		       core_tlbp_hit;
   input logic [5:0]	       core_tlbp_index;
   
   output logic [7:0]	       asid;
   output logic [7:0]	       cause_ip;   /* Cause.IP[7:0] pending bits, for co-sim ISR dispatch */

   output logic		       sr_bev;
   output logic		       sr_exl;

   input logic			exc_in_delay;
   output logic			in_kernel_mode;
   output logic			in_supervisor_mode;
   output logic			in_user_mode;

   output logic			in_64b_kernel_mode;
   output logic			in_64b_supervisor_mode;
   output logic			in_64b_user_mode;
   output logic			cu1;   /* Status.CU1 (FPU enable) -> decode CP1 CpU gate */
   output logic			fr;    /* Status.FR (FP reg mode) -> decode FR=0 odd-reg gate */
   output logic			irq_pending;
   output logic [31:0]		cp0_count;
   output logic [5:0]		cp0_random;   /* CP0 Random, for the co-sim checker (timing-dependent) */

   
   output logic [7:0]		putchar_fifo_out;
   output logic       putchar_fifo_empty;
   input logic 	      putchar_fifo_pop;
   output logic [3:0] putchar_fifo_wptr;
   output logic [3:0] putchar_fifo_rptr;   
   
`ifdef VERILATOR
   input logic [31:0] clear_cnt;
`endif
   output logic       divide_ready;
   input logic ds_done;
   input logic restart_complete;
   input logic head_of_rob_ptr_valid;
   input logic [`LG_ROB_ENTRIES-1:0] head_of_rob_ptr;
   output logic [319:0] dbg_exec_snap;   /* STALL_SNAP: head/scheduler/LSU/PRF state for the AXI debug port */
   input logic [`LG_ROB_ENTRIES-1:0] next_head_of_rob_ptr;
   input logic			     head_of_rob_ds_committable;
   /* a CP0 writer (uop.vh is_cp0_wr) retired last cycle; staged = (D)MTC0, whose data
    * is committed from r_cp0_stage_* at retire_cp0_rob_ptr */
   input logic			     retire_cp0_valid;
   input logic			     retire_cp0_staged;
   input logic [`LG_ROB_ENTRIES-1:0] retire_cp0_rob_ptr;
   output logic [31:0]     cpr0_status_reg;
      
   localparam N_ROB_ENTRIES = (1<<`LG_ROB_ENTRIES);   
   output logic [N_ROB_ENTRIES-1:0]  uq_wait;
   output logic [N_ROB_ENTRIES-1:0]  mq_wait;
   output logic [N_ROB_ENTRIES-1:0]  fp_uq_wait;
   /* DEBUG: ROB-indexed PC of the last memory op scheduled into each ROB slot.
    * Written at the one-mem-op-per-cycle schedule point (t_pop_mem_uq); survives
    * squash (only overwritten when the slot is reused).  Snarfed by rob index to
    * identify a memory op that stranded its L1D r_rob_inflight bit but never
    * retired (the applu FP-wedge orphan). */
   input logic [`LG_ROB_ENTRIES-1:0] dbg_memop_idx;
   output logic [31:0] 		     dbg_memop_pc;
   
   output logic 			     uq_full;
   output logic 			     uq_next_full;
   
   input 				     uop_t uq_uop;
   input 				     uop_t uq_uop_two;
   
   input logic 				     uq_push;
   input logic 				     uq_push_two;
   
   output 	complete_t complete_bundle_1;
   output logic complete_valid_1;
   output 	complete_t complete_bundle_2;
   output logic complete_valid_2;


   output 	mem_req_t mem_req;
   output 	logic mem_req_valid;
   input logic 	      mem_req_ack;

   
   output logic [`LG_ROB_ENTRIES-1:0] core_store_data_ptr;
   output logic 		      core_store_data_ptr_valid;
   
   
   input logic [`LG_PRF_ENTRIES-1:0] mem_rsp_dst_ptr;
   input logic 			     mem_rsp_dst_valid;
   input logic 			     mem_rsp_fp_dst;
   input logic 			     mem_rsp_fp_merge;   /* FR=0 lwc1 merge */
   input logic 			     mem_rsp_fp_hi;
   input logic [31:0]		     mem_rsp_fp_pres;
   input logic [`M_WIDTH-1:0]	     mem_rsp_load_data;
   input logic [`LG_ROB_ENTRIES-1:0] mem_rsp_rob_ptr;
   /* LSU: a completing simple load frees its entry (mem_rsp_valid & lsu_hold);
    * a block parks it with a code; a wakeup makes it issuable again */
   input logic 			     mem_rsp_valid;
   input logic 			     mem_rsp_lsu_hold;
   input logic [`LG_MEM_SCHED_ENTRIES-1:0] mem_rsp_lsu_idx;
   input logic 			     mem_blk_valid;
   input 			     blk_code_t mem_blk_code;
   input logic [(1<<`LG_MEM_SCHED_ENTRIES)-1:0] mem_blk_st;
   input logic 			     mem_wake_valid;
   input logic 			     mem_st_done_valid;
   input logic [`LG_MEM_SCHED_ENTRIES-1:0] mem_st_done_idx;
   output 			     lsu_sb_t lsu_sb;
   /* restart color: flips at every restart; stamped into each memory request */
   output logic 		     restart_color;
   /* a request of color c is between issue and the l1d (AGU stage / request FIFO) */
   output logic [1:0] 		     mem_color_pending;
   /* retirement: a plain store in the LSU becomes committable */
   input logic 			     retired_rob_ptr_valid;
   input logic 			     retired_rob_ptr_two_valid;
   input logic [`LG_ROB_ENTRIES-1:0] retired_rob_ptr;
   input logic [`LG_ROB_ENTRIES-1:0] retired_rob_ptr_two;

   /* int-domain mem writeback: an FP mem result (mem_rsp_fp_dst) writes the FP
    * PRF, not the int PRF.  int/FP physical reg numbers OVERLAP, so int-domain
    * wakeup/bypass must gate on this -- else an FP load whose FP pdst happens to
    * equal an int op's source pdst would falsely forward FP data into the int op. */
   /* PRODUCER-SIDE $zero GUARD (mem).  rf4r2w refuses to WRITE physreg 0
    * (wrptr0 != 'd0, the r0/SSNOP fix) but nothing refused to BYPASS onto it: a
    * producer with dst==0 was blocked from the register file yet would still
    * forward its result to every consumer reading $zero.  That asymmetry is the
    * hazard; the decode-side work only removed some of the readers.  Qualifying
    * the single valid signal here covers every mem forward and wakeup compare at
    * once.  Per the decode audit this is currently redundant (all 13 integer
    * loads plus SC/SCD/MFC1/DMFC1 set dst_valid=(rt!='d0)), which is the point --
    * it makes the invariant STRUCTURAL instead of resting on ~68 per-arm guards,
    * two of which were already found missing this month. */
   wire w_mem_rsp_int_valid = mem_rsp_dst_valid & ~mem_rsp_fp_dst &
			      (mem_rsp_dst_ptr != 'd0);
   

   output tlb_data_t	             tlb_entry_out;
   output logic			     tlb_entry_out_valid;

   /* The shadow TLB is the CP0 maintenance mirror (TLBR/TLBWI/TLBWR): a plain
    * indexed 48-entry RAM (registered read by r_index, write by r_tlb_index) --
    * NOT a CAM (TLBP matches on the dtlb instead). Force it into block RAM so it
    * costs ~1 BRAM instead of ~5904 FF/LUTRAM of fabric. 48-deep is too shallow
    * for Vivado to pick BRAM unprompted. */
   `TLB_SHADOW_RAM_STYLE tlb_stored_t r_shadow_tlb[`N_TLB_ENTRIES-1:0];
   
   
   localparam N_INT_SCHED_ENTRIES = 1<<`LG_INT_SCHED_ENTRIES;
   localparam logic [N_INT_SCHED_ENTRIES-1:0] INT_SCHED_USABLE = {N_INT_SCHED_ENTRIES{1'b1}} >> (N_INT_SCHED_ENTRIES - `INT_SCHED_ENTRIES);
   
   localparam N_MQ_ENTRIES = (1<<`LG_MQ_ENTRIES);
   localparam N_INT_PRF_ENTRIES = (1<<`LG_PRF_ENTRIES);
   localparam N_HILO_PRF_ENTRIES = (1<<`LG_HILO_PRF_ENTRIES);
   
   localparam N_UQ_ENTRIES = (1<<`LG_UQ_ENTRIES);
   localparam N_MEM_UQ_ENTRIES = (1<<`LG_MEM_UQ_ENTRIES);
   localparam N_MEM_DQ_ENTRIES = (1<<`LG_MEM_DQ_ENTRIES);
   
   logic [(`M_WIDTH*2)-1:0] r_hilo_prf[N_HILO_PRF_ENTRIES-1:0];
      
   logic [N_INT_PRF_ENTRIES-1:0]  r_prf_inflight, n_prf_inflight;
   logic [N_HILO_PRF_ENTRIES-1:0] r_hilo_inflight, n_hilo_inflight;

   /* FP register file: clustered/banked rf4r2w-style (fp_regfile, instanced below).
    * All four read ports are SYNCHRONOUS (registered inside the module): rd0/rd1 =
    * fpu operand reads (consumed one cycle later in the FP read stage); rd2 = mfc1
    * source (srcB); rd3 = FP store data (dq).  No flat r_fp_prf flop array anymore. */
   logic [`M_WIDTH-1:0] 	  w_fp_srcA, w_fp_srcB;     // fpu reads  (rd0/rd1)
   logic [`M_WIDTH-1:0] 	  w_fp_srcC;                // ENABLE_MIPS4 madd fr (rd4)
   logic [`M_WIDTH-1:0] 	  r_fp_rd_srcB, r_fp_rd_dq; // mem reads (rd2/rd3)
   logic [N_INT_PRF_ENTRIES-1:0]  r_fp_prf_inflight, n_fp_prf_inflight;

   logic 			  t_wr_int_prf, t_wr_cpr0, t_wr_cpr0_64;
   /* (D)MTC0 data staged per ROB entry at exec, committed to CP0 at retire */
   logic [`M_WIDTH-1:0] 	  r_cp0_stage_data[N_ROB_ENTRIES-1:0];
   logic [4:0] 			  r_cp0_stage_reg[N_ROB_ENTRIES-1:0];
   logic 			  r_cp0_stage_64[N_ROB_ENTRIES-1:0];
   wire 			  w_cp0_wr = retire_cp0_valid & retire_cp0_staged;
   wire [4:0] 			  w_cp0_wr_reg = r_cp0_stage_reg[retire_cp0_rob_ptr];
   wire [`M_WIDTH-1:0] 		  w_cp0_wr_data = r_cp0_stage_data[retire_cp0_rob_ptr];
   wire 			  w_cp0_wr_64 = r_cp0_stage_64[retire_cp0_rob_ptr];
   /* CP0 writers retired AND committed; a CP0 reader issues when this reaches its
    * uop.cp0_seq (the writers allocated before it) */
   logic [`LG_ROB_ENTRIES+1:0] 	  r_cp0_commit_seq;
   logic 			  t_wr_fcsr;
   logic [`M_WIDTH-1:0]		  t_csr0_val, t_csr0_64_val;
   
   logic 	t_wr_hilo;
   logic	t_overflow;
   logic	t_eret;
   logic	t_trap;
   
   logic	t_clr_erl;
   logic 	t_take_br;
   logic 	t_mispred_br;
   logic 	t_alu_valid;
      
   
   mem_req_t r_mem_q[N_MQ_ENTRIES-1:0];
   logic [`LG_MQ_ENTRIES:0] r_mq_head_ptr, n_mq_head_ptr;
   logic [`LG_MQ_ENTRIES:0] r_mq_tail_ptr, n_mq_tail_ptr;
   logic [`LG_MQ_ENTRIES:0] r_mq_next_tail_ptr, n_mq_next_tail_ptr;
   mem_req_t t_mem_tail, t_mem_head;
   logic 		    mem_q_full,mem_q_next_full, mem_q_empty;


   
   

   logic [3:0]		    r_rd_pc_idx, n_rd_pc_idx;
   logic [3:0]		    r_wr_pc_idx, n_wr_pc_idx;
   logic [7:0]		    r_pc_buf [7:0];
   logic t_push_putchar;
   
   

   logic 	t_pop_uq,t_pop_mem_uq;
   logic 	r_mem_ready;
   
   
   localparam E_BITS = `M_WIDTH-16;
   localparam HI_EBITS = `M_WIDTH-32;
   
   logic [`M_WIDTH-1:0] t_simm, t_mem_simm;
   logic [`M_WIDTH-1:0] t_result;
   logic [`M_WIDTH-1:0] t_cpr0_result;

   
   logic [(`M_WIDTH*2)-1:0] t_hilo_result;
   
   logic [`M_WIDTH-1:0] t_pc, t_pc4, t_pc8;
   logic [27:0] t_jaddr;
   logic 	t_srcs_rdy;

   
   wire [`M_WIDTH-1:0] w_srcA, w_srcB;
   wire [`M_WIDTH-1:0] w_mem_srcA, w_mem_srcB;
   wire [`M_WIDTH-1:0] w_mem_srcC;   /* ENABLE_MIPS4: indexed FP load/store index (rf port 4) */
   
   logic 	r_fwd_int_srcA, r_fwd_int_srcB;
   logic 	r_fwd_mem_srcA, r_fwd_mem_srcB;

   logic t_fwd_int_mem_srcA,t_fwd_mem_mem_srcA;
   logic r_fwd_int_mem_srcA,r_fwd_mem_mem_srcA;
   logic t_fwd_int_mem_srcC,t_fwd_mem_mem_srcC;
   logic r_fwd_int_mem_srcC,r_fwd_mem_mem_srcC;
   
   /* Dedicated forward-DATA registers, one per forward flag, captured in the
    * SAME if() that sets the flag.  ROOT-CAUSE FIX for the 2026-09-02/03 stale
    * forward (4 silicon ring captures, fwd_sel field): the flags are one-shot
    * but the old free-running result registers (since removed) were overwritten EVERY
    * cycle, so any consumer that executes later than pick+1 forwards a LATER
    * producer's value.  Capture 20260903_120637 shows it exactly: two load
    * responses one cycle apart, the bnez forwarded from MEM and received the
    * SECOND load's data (the ra value, non-zero) while its own producer had
    * written 0 -- so the never-taken __free_hook branch was taken and jr t9
    * jumped to 0.  REG_L1D_RSP moved the timing and the fault survived, which
    * proves the defect is this flag/data lifetime mismatch and not the L1D
    * response path.  With the data captured beside its flag the pair cannot
    * desynchronise, whatever the pick-to-execute delay. */
   logic [`M_WIDTH-1:0]     r_fwd_srcA_data, r_fwd_srcB_data;
   logic [`M_WIDTH-1:0]     r_fwd_mem_srcA_data;
   logic [`M_WIDTH-1:0]     r_fwd_mem_srcC_data;
   logic [(`M_WIDTH*2)-1:0] r_fwd_hilo_data;
   logic [(`M_WIDTH*2)-1:0] r_src_hilo;
   logic 	r_fwd_hilo_int, r_fwd_hilo_mul, r_fwd_hilo_div;
      
   logic [`M_WIDTH-1:0] t_srcA, t_srcB;
   logic [`M_WIDTH-1:0] t_mem_srcA;
   logic [`M_WIDTH-1:0] t_mem_srcC;
   
   
   logic [(`M_WIDTH*2)-1:0] t_src_hilo;
   logic [`M_WIDTH-1:0] t_cpr0_srcA;
   
   
   logic 	t_unimp_op;
   logic 	t_fault;
   
   logic 	t_signed_shift;
   logic [`LG_M_WIDTH-1:0] t_shift_amt;
   
   logic [31:0] t_shift_right;

   logic 	t_start_mul;
   logic 	t_mul_complete;
   logic [(`M_WIDTH*2)-1:0] t_mul_result;
   
   logic 	t_hilo_prf_ptr_val_out;
   logic [`LG_ROB_ENTRIES-1:0] t_rob_ptr_out;

   
   logic [`LG_HILO_PRF_ENTRIES-1:0] t_hilo_prf_ptr_out;
   
   logic [`MAX_LAT:0] r_wb_bitvec, n_wb_bitvec;

   /* divider */
   logic 	t_div_ready, t_signed_div, t_start_div32, t_start_div64;
   logic [`LG_ROB_ENTRIES-1:0] t_div_rob_ptr_out;
   logic [(`M_WIDTH*2)-1:0] 	       t_div_result;
   logic [`LG_HILO_PRF_ENTRIES-1:0] t_div_hilo_prf_ptr_out;
   /* unified divider, FP side (uni_divider.sv).
    * t_fdiv_pop = an FP div/sqrt pops from fp_uq THIS cycle (it starts NEXT cycle) */
   logic 			    t_fdiv_pop, t_fdiv_start, t_fdiv_wb_used;
   logic 			    w_fdiv_ready, w_fdiv_complete, w_fdiv_denorm;
   logic [63:0] 		    w_fdiv_y;
   logic [4:0] 			    w_fdiv_fflags;
   logic [`LG_ROB_ENTRIES-1:0] 	    w_fdiv_rob_ptr;
   logic [`LG_PRF_ENTRIES-1:0] 	    w_fdiv_dst_ptr;
   logic 			    t_div_complete;

   logic [N_ROB_ENTRIES-1:0] 	    r_uq_wait, r_mq_wait, r_fp_uq_wait;
   /* DEBUG mem-op PC shadow, ROB-indexed (see dbg_memop_pc port). */
   logic [31:0] 		    r_memop_pc [N_ROB_ENTRIES-1:0];
   /* non mem uop queue */
   uop_t r_uq[N_UQ_ENTRIES];
   uop_t uq, int_uop;
   /* ENABLE_UQ_DUAL_POP: second uq entry written into a second free entry */
   uop_t uq2;
   logic t_pop_uq2;
   logic 			    r_start_int;
   
   
   
   logic 			    t_uq_read, t_uq_empty, t_uq_full, t_uq_next_full;
   logic [`LG_UQ_ENTRIES:0] 	    r_uq_head_ptr, n_uq_head_ptr;
   logic [`LG_UQ_ENTRIES:0] 	    r_uq_tail_ptr, n_uq_tail_ptr;
   logic [`LG_UQ_ENTRIES:0] 	    r_uq_next_head_ptr, n_uq_next_head_ptr;
   logic [`LG_UQ_ENTRIES:0] 	    r_uq_next_tail_ptr, n_uq_next_tail_ptr;

   /* mem uop queue */
   uop_t r_mem_uq[N_MEM_UQ_ENTRIES];
   uop_t t_mem_uq, mem_uq;
   logic 	      t_mem_uq_read, t_mem_uq_empty, t_mem_uq_full,
		      t_mem_uq_next_full;
   
   logic [`LG_MEM_UQ_ENTRIES:0]  r_mem_uq_head_ptr, n_mem_uq_head_ptr;
   logic [`LG_MEM_UQ_ENTRIES:0]  r_mem_uq_tail_ptr, n_mem_uq_tail_ptr;
   logic [`LG_MEM_UQ_ENTRIES:0] r_mem_uq_next_head_ptr, n_mem_uq_next_head_ptr;
   logic [`LG_MEM_UQ_ENTRIES:0] r_mem_uq_next_tail_ptr, n_mem_uq_next_tail_ptr;

   /* LSU: the memory scheduler (rv64core's age-matrix scheduler, extended to
    * hold loads until answered and stores until written -- see the LSU block) */
   localparam N_MEM_SCHED_ENTRIES = 1<<`LG_MEM_SCHED_ENTRIES;
   localparam logic [N_MEM_SCHED_ENTRIES-1:0] MEM_SCHED_USABLE = {N_MEM_SCHED_ENTRIES{1'b1}} >> (N_MEM_SCHED_ENTRIES - `MEM_SCHED_ENTRIES);
   uop_t r_mem_sched_uops[N_MEM_SCHED_ENTRIES-1:0];
   logic [N_MEM_SCHED_ENTRIES-1:0] r_mem_sched_valid, n_mem_sched_valid;
   logic [N_MEM_SCHED_ENTRIES-1:0] r_mem_sched_ld, n_mem_sched_ld;          /* simple load */
   logic [N_MEM_SCHED_ENTRIES-1:0] r_mem_sched_st, n_mem_sched_st;          /* plain store */
   logic [N_MEM_SCHED_ENTRIES-1:0] r_mem_sched_ser, n_mem_sched_ser;        /* CACHE hit op: serializing */
   logic [N_MEM_SCHED_ENTRIES-1:0] r_mem_sched_old1, n_mem_sched_old1;      /* SC/SCD: a held store that issues only when oldest */
   logic [N_MEM_SCHED_ENTRIES-1:0] r_mem_sched_mg, n_mem_sched_mg;          /* LWL/LWR/LDL/LDR: needs the old rt (captured) before issue */
   logic [N_MEM_SCHED_ENTRIES-1:0] r_mem_sched_mv, n_mem_sched_mv;          /* MFC1/MTC1/DMFC1/DMTC1: register move, no memory ordering */
   logic [N_MEM_SCHED_ENTRIES-1:0] r_mem_sched_issued, n_mem_sched_issued;  /* address pass issued */
   logic [N_MEM_SCHED_ENTRIES-1:0] r_mem_sched_sd_sel, n_mem_sched_sd_sel;  /* store data read issued */
   logic [N_MEM_SCHED_ENTRIES-1:0] r_mem_sched_sd_ok, n_mem_sched_sd_ok;    /* store data in the l1d */
   logic [N_MEM_SCHED_ENTRIES-1:0] r_mem_sched_ret, n_mem_sched_ret;        /* store retired */
   logic [N_MEM_SCHED_ENTRIES-1:0] r_mem_sched_cmt, n_mem_sched_cmt;        /* store commit issued */
   logic [N_MEM_SCHED_ENTRIES-1:0] r_mem_sched_ep, n_mem_sched_ep;          /* slot epoch (per alloc) */
   blk_code_t r_mem_sched_blk[N_MEM_SCHED_ENTRIES-1:0];
   blk_code_t n_mem_sched_blk[N_MEM_SCHED_ENTRIES-1:0];
   logic [N_MEM_SCHED_ENTRIES-1:0] r_mem_sched_blk_st[N_MEM_SCHED_ENTRIES-1:0];   /* LSU-owned block: stores waited on */
   logic [N_MEM_SCHED_ENTRIES-1:0] n_mem_sched_blk_st[N_MEM_SCHED_ENTRIES-1:0];
   logic [N_MEM_SCHED_ENTRIES-1:0] r_mem_sched_ep_snap[N_MEM_SCHED_ENTRIES-1:0];  /* epochs at issue */
   logic [N_MEM_SCHED_ENTRIES-1:0] n_mem_sched_ep_snap[N_MEM_SCHED_ENTRIES-1:0];
   logic [N_MEM_SCHED_ENTRIES-1:0] r_mem_sched_matrix[N_MEM_SCHED_ENTRIES-1:0];
   logic [N_MEM_SCHED_ENTRIES-1:0] n_mem_sched_matrix[N_MEM_SCHED_ENTRIES-1:0];
   logic [N_MEM_SCHED_ENTRIES-1:0] t_mem_entry_rdy, t_mem_elig, t_mem_strict, t_mem_pending, t_mem_st_live;
   logic [N_MEM_SCHED_ENTRIES-1:0] t_mem_alloc_entry, t_mem_select_entry, t_mem_free_entry;
   logic [N_MEM_SCHED_ENTRIES-1:0] t_mem_sched_mask_valid, t_mem_survive;
   logic [N_MEM_SCHED_ENTRIES-1:0] t_mem_cmt_rdy, t_mem_sd_rdy, t_mem_st_retire, t_blk_release;
   wire [N_MEM_SCHED_ENTRIES-1:0]  w_mem_sched_oldest_ready;
   logic [`LG_MEM_SCHED_ENTRIES:0] t_mem_sched_alloc_ptr, t_mem_sched_select_ptr, t_mem_sched_pick_ptr;
   logic [`LG_MEM_SCHED_ENTRIES:0] t_mem_cmt_ptr, t_mem_sd_ptr;
   uop_t t_picked_mem_uop;
   logic 	t_mem_issue, t_mem_issue_addr, t_mem_issue_cmt;
   logic 	t_mem_uq_generic_load, t_mem_uq_plain_store, t_mem_uq_serial, t_mem_uq_old1, t_mem_uq_merge, t_mem_uq_move;
   /* the issued op, one stage on (AGU) */
   logic [`LG_MEM_SCHED_ENTRIES-1:0] r_mem_uq_lsu_idx;
   logic 	r_mem_uq_lsu_hold, r_mem_uq_commit, r_mem_uq_color;
   logic 	r_restart_color;
   logic [N_MEM_SCHED_ENTRIES-1:0] r_mem_uq_older_st, r_mem_uq_older_ep;
   /* store data capture */
   logic 	t_sd_go, r_sd_go, r_sd_fp, r_sd_fp_hi, r_sd_zero;
   logic [`LG_PRF_ENTRIES-1:0] t_sd_src;
   logic [`LG_MEM_SCHED_ENTRIES-1:0] r_sd_idx;
   logic [`LG_ROB_ENTRIES-1:0] r_sd_rob;

   
   logic             t_push_two_mem,  t_push_two_int;
   logic             t_push_one_mem,  t_push_one_int;
   
   logic 			t_flash_clear;
   always_comb
     begin
	t_flash_clear = ds_done;
     end

   always_comb
     begin
	uq_full = t_uq_full || t_mem_uq_full || t_fp_uq_full;
	uq_next_full = t_uq_next_full || t_mem_uq_next_full || t_fp_uq_next_full;
     end
   
   always_ff@(posedge clk)
     begin
	if(reset || t_flash_clear)
	  begin
	     r_uq_head_ptr <= 'd0;
	     r_uq_tail_ptr <= 'd0;
	     r_uq_next_head_ptr <= 'd1;
	     r_uq_next_tail_ptr <= 'd1;	     
	  end
	else
	  begin
	     r_uq_head_ptr <=  n_uq_head_ptr;
	     r_uq_tail_ptr <=  n_uq_tail_ptr;
	     r_uq_next_head_ptr <= n_uq_next_head_ptr;
	     r_uq_next_tail_ptr <= n_uq_next_tail_ptr;	     
	  end
     end // always_ff@ (posedge clk)

   always_ff@(posedge clk)
     begin
	if(reset  || t_flash_clear)
	  begin
	     r_mem_uq_head_ptr <= 'd0;
	     r_mem_uq_tail_ptr <= 'd0;
	     r_mem_uq_next_head_ptr <= 'd1;
	     r_mem_uq_next_tail_ptr <= 'd1;
	  end
	else
	  begin
	     r_mem_uq_head_ptr <= n_mem_uq_head_ptr;
	     r_mem_uq_tail_ptr <= n_mem_uq_tail_ptr;
	     r_mem_uq_next_head_ptr <= n_mem_uq_next_head_ptr;
	     r_mem_uq_next_tail_ptr <= n_mem_uq_next_tail_ptr;
	  end
     end // always_ff@ (posedge clk// )
   
   
   


   always_comb
     begin
	n_mem_uq_head_ptr = r_mem_uq_head_ptr;
	n_mem_uq_tail_ptr = r_mem_uq_tail_ptr;
	n_mem_uq_next_head_ptr = r_mem_uq_next_head_ptr;
	n_mem_uq_next_tail_ptr = r_mem_uq_next_tail_ptr;


	
	t_mem_uq_empty = (r_mem_uq_head_ptr == r_mem_uq_tail_ptr);
	t_mem_uq_full = (r_mem_uq_head_ptr != r_mem_uq_tail_ptr) && (r_mem_uq_head_ptr[`LG_MEM_UQ_ENTRIES-1:0] == r_mem_uq_tail_ptr[`LG_MEM_UQ_ENTRIES-1:0]);

	t_mem_uq_next_full = (r_mem_uq_head_ptr != r_mem_uq_next_tail_ptr) && 
			     (r_mem_uq_head_ptr[`LG_MEM_UQ_ENTRIES-1:0] == r_mem_uq_next_tail_ptr[`LG_MEM_UQ_ENTRIES-1:0]);

		
	t_mem_uq = r_mem_uq[r_mem_uq_head_ptr[`LG_MEM_UQ_ENTRIES-1:0]];


	t_push_two_mem = uq_push && uq_push_two && uq_uop.is_mem && uq_uop_two.is_mem;
	t_push_one_mem = ((uq_push && uq_uop.is_mem) || (uq_push_two && uq_uop_two.is_mem)) && !t_push_two_mem;

	
	/* these need work */
	if(t_push_two_mem)
	  begin
	     n_mem_uq_tail_ptr = r_mem_uq_tail_ptr + 'd2;
	     n_mem_uq_next_tail_ptr = r_mem_uq_next_tail_ptr + 'd2;

	  end
	else if(uq_push_two && uq_uop_two.is_mem || uq_push && uq_uop.is_mem)
	  begin
	     n_mem_uq_tail_ptr = r_mem_uq_tail_ptr + 'd1;
	     n_mem_uq_next_tail_ptr = r_mem_uq_next_tail_ptr + 'd1;
	  end
	
	if(t_pop_mem_uq)
	  begin
	     n_mem_uq_head_ptr = r_mem_uq_head_ptr + 'd1;
	  end
     end // always_comb

   always_ff@(posedge clk)
     begin
	mem_uq <= t_picked_mem_uop;
	r_mem_uq_lsu_idx <= t_mem_sched_select_ptr[`LG_MEM_SCHED_ENTRIES-1:0];
	r_mem_uq_lsu_hold <= r_mem_sched_ld[t_mem_sched_select_ptr[`LG_MEM_SCHED_ENTRIES-1:0]] |
			     r_mem_sched_st[t_mem_sched_select_ptr[`LG_MEM_SCHED_ENTRIES-1:0]] |
			     r_mem_sched_ser[t_mem_sched_select_ptr[`LG_MEM_SCHED_ENTRIES-1:0]];
	r_mem_uq_commit <= t_mem_issue_cmt;
	r_mem_uq_color <= r_restart_color;
	r_mem_uq_older_st <= r_mem_sched_matrix[t_mem_sched_select_ptr[`LG_MEM_SCHED_ENTRIES-1:0]] & t_mem_st_live;
	r_mem_uq_older_ep <= r_mem_sched_ep;
     end

   always_ff@(posedge clk)
     begin
	if(reset)
	  begin
	     r_mq_wait <= 'd0;
	     r_uq_wait <= 'd0;
	     r_fp_uq_wait <= 'd0;
	  end
	else if(restart_complete)
	  begin
	     r_mq_wait <= 'd0;
	     r_uq_wait <= 'd0;
	     r_fp_uq_wait <= 'd0;
	  end
	else
	  begin
	     //mem port
	     if(t_push_two_mem)
	       begin
		  r_mq_wait[uq_uop_two.rob_ptr] <= 1'b1;
		  r_mq_wait[uq_uop.rob_ptr] <= 1'b1;
	       end
	     else if(t_push_one_mem)
	       begin
		  r_mq_wait[uq_uop.is_mem ? uq_uop.rob_ptr : uq_uop_two.rob_ptr] <= 1'b1; 
	       end
	     if(t_mem_issue_addr)
	       begin
		  r_mq_wait[t_picked_mem_uop.rob_ptr] <= 1'b0;
		  r_memop_pc[t_picked_mem_uop.rob_ptr] <= t_picked_mem_uop.pc[31:0];
	       end
	     /* r_mq_wait = "this op is back in the LSU and will not complete if the
	      * machine flushes now" (t_clr_mask drops its ROB inflight bit).  Only an
	      * LSU-owned block puts it back (it is re-picked, which clears the bit); a
	      * cache-owned block (BLK_MISS/BLK_ST_CONFLICT) stays in the l1d and is
	      * ANSWERED, never re-picked, so setting the bit there leaked it to the next
	      * op in the ROB slot -- a multiply then lost its inflight bit at a flush, the
	      * restart did not wait for it, and its completion landed on a new op. */
	     if(mem_rsp_valid)
	       begin
		  r_mq_wait[mem_rsp_rob_ptr] <= 1'b0;
	       end
	     if(mem_blk_valid && mem_blk_code[2])
	       begin
		  r_mq_wait[mem_rsp_rob_ptr] <= 1'b1;
	       end
	     
	     //int port
	     if(t_push_two_int)
	       begin
		  r_uq_wait[uq_uop.rob_ptr] <= 1'b1;
		  r_uq_wait[uq_uop_two.rob_ptr] <= 1'b1;
	       end
	     else if(t_push_one_int)
	       begin
		  r_uq_wait[uq_uop.is_int ? uq_uop.rob_ptr : uq_uop_two.rob_ptr] <= 1'b1; 
	       end
	     
	     if(r_start_int)
	       begin
		  r_uq_wait[int_uop.rob_ptr] <= 1'b0;
	       end

	     //fp port (mirrors mipscore r_fq_wait: track ops sitting in fp_uq so a
	     // fault-drain can flash-clear their r_rob_inflight via t_clr_mask).
	     if(t_push_two_fp)
	       begin
		  r_fp_uq_wait[uq_uop.rob_ptr] <= 1'b1;
		  r_fp_uq_wait[uq_uop_two.rob_ptr] <= 1'b1;
	       end
	     else if(t_push_one_fp)
	       begin
		  r_fp_uq_wait[uq_uop.is_fp ? uq_uop.rob_ptr : uq_uop_two.rob_ptr] <= 1'b1;
	       end
	     if(t_pop_fp_uq)
	       begin
		  r_fp_uq_wait[fp_uq.rob_ptr] <= 1'b0;
	       end

	  end // else: !if(reset)
     end // always_ff@ (posedge clk)

   
   always_ff@(posedge clk)
     begin
	if(t_push_two_mem)
	  begin
	     //$display("cycle %d : pushing mem ops for rob slots %d & %d", r_cycle, uq_uop_two.rob_ptr, uq_uop.rob_ptr);
	     r_mem_uq[r_mem_uq_next_tail_ptr[`LG_MEM_UQ_ENTRIES-1:0]] <= uq_uop_two;
	     r_mem_uq[r_mem_uq_tail_ptr[`LG_MEM_UQ_ENTRIES-1:0]] <= uq_uop;
	  end
	else if(t_push_one_mem)
	  begin
	     //$display("cycle %d : pushing mem ops for rob slots %d", r_cycle, uq_uop.rob_ptr);
	     r_mem_uq[r_mem_uq_tail_ptr[`LG_MEM_UQ_ENTRIES-1:0]] <= uq_uop.is_mem ? uq_uop : uq_uop_two;
	  end	
     end // always_ff@ (posedge clk)


   
   

   
   always_comb
     begin
	n_uq_head_ptr = r_uq_head_ptr;
	n_uq_tail_ptr = r_uq_tail_ptr;
	n_uq_next_head_ptr = r_uq_next_head_ptr;
	n_uq_next_tail_ptr = r_uq_next_tail_ptr;
	
	
	t_uq_empty = (r_uq_head_ptr == r_uq_tail_ptr);
	t_uq_full = (r_uq_head_ptr != r_uq_tail_ptr) && 
		    (r_uq_head_ptr[`LG_UQ_ENTRIES-1:0] == r_uq_tail_ptr[`LG_UQ_ENTRIES-1:0]);
	
	t_uq_next_full = (r_uq_head_ptr != r_uq_next_tail_ptr) && 
			 (r_uq_head_ptr[`LG_UQ_ENTRIES-1:0] == r_uq_next_tail_ptr[`LG_UQ_ENTRIES-1:0]);

	t_push_two_int = uq_push && uq_push_two && uq_uop.is_int && uq_uop_two.is_int;
	t_push_one_int = ((uq_push && uq_uop.is_int) || (uq_push_two && uq_uop_two.is_int)) && !t_push_two_int;
	
	uq = r_uq[r_uq_head_ptr[`LG_UQ_ENTRIES-1:0]];
	uq2 = r_uq[r_uq_next_head_ptr[`LG_UQ_ENTRIES-1:0]];
	
	if(t_push_two_int)
	  begin	     
	     n_uq_tail_ptr = r_uq_tail_ptr + 'd2;
	     n_uq_next_tail_ptr = r_uq_next_tail_ptr + 'd2;
	  end
	else if(uq_push_two && uq_uop_two.is_int || uq_push && uq_uop.is_int)
	  begin	     
	     n_uq_tail_ptr = r_uq_tail_ptr + 'd1;
	     n_uq_next_tail_ptr = r_uq_next_tail_ptr + 'd1;
	  end

	
	if(t_pop_uq2)
	  begin
	     n_uq_head_ptr = r_uq_head_ptr + 'd2;
	     n_uq_next_head_ptr = r_uq_next_head_ptr + 'd2;
	  end
	else if(t_pop_uq)
	  begin
	     n_uq_head_ptr = r_uq_head_ptr + 'd1;
	     n_uq_next_head_ptr = r_uq_next_head_ptr + 'd1;
	  end
     end // always_comb

   always_ff@(posedge clk)
     begin
	if(t_push_two_int)
	  begin
	     r_uq[r_uq_tail_ptr[`LG_UQ_ENTRIES-1:0]] <= uq_uop;
	     r_uq[r_uq_next_tail_ptr[`LG_UQ_ENTRIES-1:0]] <= uq_uop_two;	     
	  end
	else if(t_push_one_int)
	  begin
	     r_uq[r_uq_tail_ptr[`LG_UQ_ENTRIES-1:0]] <= uq_uop.is_int ? uq_uop : uq_uop_two;
	  end
	
     end // always_ff@ (posedge clk)
   
   /* 64-bit: as 32-bit these wrap in ~43s at 100MHz (and r_retired_insns sooner
    * under dual retire), which makes any long measurement useless.  MFC0 still
    * returns the sign-extended LOW 32 for compatibility; DMFC0 returns all 64. */
   logic [63:0]        r_cycle, r_retired_insns;
`ifdef GHOST_DEBUG
   always_ff@(negedge clk)
     begin
	if(r_start_int & ((int_uop.op == TLBWR) | (int_uop.op == TLBWI)))
	  $display("[tlbw-exec] cyc=%d pc=%x op=%s rob=%d random=%d idx=%d vpn=%x head=%d hv=%b", 
		   r_cycle, int_uop.pc, (int_uop.op == TLBWR) ? "wr" : "wi",
		   int_uop.rob_ptr, r_random, r_index, r_entryhi_vpn2, head_of_rob_ptr, head_of_rob_ptr_valid);
	if(r_tlb_entry_out_valid)
	  $display("[tlbwrite] cyc=%d idx=%d vpn=%x ds_done=%b", r_cycle, r_tlb_index, r_entryhi_vpn2, ds_done);
     end
`endif
   always_ff@(posedge clk)
     begin
	r_cycle <= reset ? 'd0 : r_cycle + 'd1;
	
     end

   always_ff@(posedge clk)
     begin
	if(reset)
	  begin
	     r_retired_insns <= 'd0;
	  end
	else if(retire_two)
	  begin
	     r_retired_insns <= r_retired_insns + 'd2;
	  end
	else if(retire) 
	  begin
	     r_retired_insns <= r_retired_insns + 'd1;
	  end
     end // always_ff@ (posedge clk)   


   always_ff@(posedge clk)
     begin
	if(reset)
	  begin
	     r_wb_bitvec <= 'd0;
	  end
	else
	  begin
	     r_wb_bitvec <= n_wb_bitvec;
	  end
     end // always_ff@ (posedge clk)

   always_comb
     begin
	for(integer i = (`MAX_LAT-1); i > -1; i = i-1)
	  begin
	     n_wb_bitvec[i] = r_wb_bitvec[i+1];	     
	  end
	n_wb_bitvec[`DIV32_LAT] = (t_start_div32 | t_start_div64) & r_start_int;
	
	if(t_start_mul&r_start_int)
	  begin
	     n_wb_bitvec[`MUL_LAT] = 1'b1;
	  end
     end // always_comb

   
   always_comb
     begin
	/* forwarded operands come from the data captured WITH the flag (see the
	 * r_fwd_*_data declarations), never from the free-running result registers */
	t_srcA = r_fwd_int_srcA ? r_fwd_srcA_data :
		 r_fwd_mem_srcA ? r_fwd_srcA_data :
		 w_srcA;
	
	t_srcB = r_fwd_int_srcB ? r_fwd_srcB_data :
		 r_fwd_mem_srcB ? r_fwd_srcB_data :
		 w_srcB;

	t_mem_srcA = r_fwd_int_mem_srcA ? r_fwd_mem_srcA_data :
		     r_fwd_mem_mem_srcA ? r_fwd_mem_srcA_data :
		     w_mem_srcA;

	t_mem_srcC = r_fwd_int_mem_srcC ? r_fwd_mem_srcC_data :
		     r_fwd_mem_mem_srcC ? r_fwd_mem_srcC_data :
		     w_mem_srcC;

	
	t_src_hilo = r_fwd_hilo_int ? r_fwd_hilo_data :
		     r_fwd_hilo_mul ? r_fwd_hilo_data :
		     r_fwd_hilo_div ? r_fwd_hilo_data :
		     r_src_hilo;
     end // always_comb




   //does this scheduler entry contain a valid uop?
   logic [N_INT_SCHED_ENTRIES-1:0] r_alu_sched_valid;
   logic [`LG_INT_SCHED_ENTRIES:0] t_alu_sched_alloc_ptr;
   logic 			  t_alu_sched_full;
   /* ENABLE_SCHED_BYPASS: uq head issues straight to the ALU this cycle */
   logic 			  t_uq_bypass;
   logic [`LG_INT_SCHED_ENTRIES:0] t_alu_sched_alloc2_ptr;
   logic [N_INT_SCHED_ENTRIES-1:0] t_alu_alloc2_entry;
   logic [N_INT_SCHED_ENTRIES-1:0] t_alu_sched_free2;
   logic t_alu_alloc2_srcA_match,
	 t_alu_alloc2_srcB_match,
	 t_alu_alloc2_hilo_match,
	 t_alu_alloc2_fcr_match;
   
   logic [N_INT_SCHED_ENTRIES-1:0] t_alu_alloc_entry, t_alu_select_entry;

   uop_t r_alu_sched_uops[N_INT_SCHED_ENTRIES-1:0];
   uop_t t_picked_uop;

   
   logic [N_INT_SCHED_ENTRIES-1:0] t_alu_entry_rdy;
   logic [`LG_INT_SCHED_ENTRIES:0]  t_alu_sched_select_ptr;
   
	
   logic [N_INT_SCHED_ENTRIES-1:0] r_alu_srcA_rdy,
				   r_alu_srcB_rdy,
				   r_alu_hilo_rdy,
				   r_alu_fcr_rdy;
   /* srcC (movn/movz rt) ready, or no srcC */
   logic [N_INT_SCHED_ENTRIES-1:0] t_alu_srcC_ok;
`ifdef ENABLE_MIPS4
   /* movn/movz: rt is only a condition, "is its physical register zero" -- one
    * flag bit per int physical register, written with every int PRF write (never
    * physreg 0, which rf4r2w does not write either: its flag stays 1), and a
    * third ready bit that wakes on the same producers as srcA/srcB.  A consumer
    * selected on a writeback match executes the next cycle, after the flag write. */
   logic [N_INT_PRF_ENTRIES-1:0]   r_prf_zero;
   logic [N_INT_SCHED_ENTRIES-1:0] r_alu_srcC_rdy, t_alu_srcC_match;
   logic 			   t_alu_alloc_srcC_match, t_alu_alloc2_srcC_match;
`endif

   logic [N_INT_SCHED_ENTRIES-1:0] t_alu_srcA_match,
				   t_alu_srcB_match,
				   t_alu_hilo_match,
				   t_alu_fcr_match;



   logic t_alu_alloc_srcA_match,
	 t_alu_alloc_srcB_match,
	 t_alu_alloc_hilo_match,
	 t_alu_alloc_fcr_match;
   
   wire [N_INT_SCHED_ENTRIES-1:0] w_alu_sched_oldest_ready;
   
   find_lowest_set_bit#(`LG_INT_SCHED_ENTRIES) ffs_int_sched_alloc( .in(~r_alu_sched_valid & INT_SCHED_USABLE),
							      .y(t_alu_sched_alloc_ptr));

   find_lowest_set_bit#(`LG_INT_SCHED_ENTRIES) ffs_int_sched_alloc2( .in(t_alu_sched_free2),
							       .y(t_alu_sched_alloc2_ptr));

   find_lowest_set_bit#(`LG_INT_SCHED_ENTRIES) ffs_int_sched_select( .in(w_alu_sched_oldest_ready),
								.y(t_alu_sched_select_ptr));

   
   
   always_comb
     begin
	t_alu_alloc_entry = 'd0;
	t_alu_alloc2_entry = 'd0;
	t_alu_select_entry = 'd0;
	if(t_pop_uq && !t_uq_bypass)
	  begin
	     t_alu_alloc_entry[t_alu_sched_alloc_ptr[`LG_INT_SCHED_ENTRIES-1:0]] = 1'b1;
	  end
	if(t_pop_uq2)
	  begin
	     t_alu_alloc2_entry[t_alu_sched_alloc2_ptr[`LG_INT_SCHED_ENTRIES-1:0]] = 1'b1;
	  end
	if(t_alu_entry_rdy != 'd0)
	  begin
	     t_alu_select_entry[t_alu_sched_select_ptr[`LG_INT_SCHED_ENTRIES-1:0]] = 1'b1;
	  end
     end // always_comb




   always_comb
     begin
	t_picked_uop = t_uq_bypass ? uq : r_alu_sched_uops[t_alu_sched_select_ptr[`LG_INT_SCHED_ENTRIES-1:0]];
     end
   
   always_ff@(posedge clk)
     begin
	int_uop <= t_picked_uop;
     end

`ifdef TOPDOWN
   /* per-uop stage stamps (see core.sv TOPDOWN): 1 = enters the ALU scheduler,
    * 2 = ALU execute starts, 3 = memory uop dispatched to address generation */
   import "DPI-C" function void topdown_uop(input int ev, input int rob_ptr);
   always_ff@(negedge clk)
     begin
	if(!reset)
	  begin
	     if(t_pop_uq)
	       begin
		  topdown_uop(1, {{(32-`LG_ROB_ENTRIES){1'b0}}, uq.rob_ptr});
	       end
	     if(t_pop_uq2)
	       begin
		  topdown_uop(1, {{(32-`LG_ROB_ENTRIES){1'b0}}, uq2.rob_ptr});
	       end
	     if(r_start_int)
	       begin
		  topdown_uop(2, {{(32-`LG_ROB_ENTRIES){1'b0}}, int_uop.rob_ptr});
	       end
	     if(t_mem_issue_addr)
	       begin
		  topdown_uop(3, {{(32-`LG_ROB_ENTRIES){1'b0}}, t_picked_mem_uop.rob_ptr});
	       end
	  end
     end // always_ff
`endif

`ifdef PIPETRACE
   /* pipetrace stage events (letters in gen_html.cc), joined by rob index in top.cc */
   import "DPI-C" function void pt_event(input int rob_ptr, input int letter, input longint cycle);
   function int pt_rob(logic [`LG_ROB_ENTRIES-1:0] p);
      return {{(32-`LG_ROB_ENTRIES){1'b0}}, p};
   endfunction
   always_ff@(negedge clk)
     begin
	if(!reset)
	  begin
	     if(r_start_int)
	       begin
		  pt_event(pt_rob(int_uop.rob_ptr), "S", r_cycle);
	       end
	     if(t_pop_mem_uq)
	       begin
		  pt_event(pt_rob(t_mem_uq.rob_ptr), "Q", r_cycle);
	       end
	     if(t_mem_issue_addr)
	       begin
		  pt_event(pt_rob(t_picked_mem_uop.rob_ptr), "S", r_cycle);
	       end
	     if(mem_blk_valid)
	       begin
		  pt_event(pt_rob(mem_rsp_rob_ptr),
			   (mem_blk_code == BLK_MISS) ? "B" :
			   (mem_blk_code == BLK_ST_CONFLICT) ? "X" :
			   (mem_blk_code == BLK_SB_CONFLICT) ? "W" :
			   (mem_blk_code == BLK_UNCACHEABLE) ? "U" : "D", r_cycle);
	       end
	     if(mem_wake_valid && r_mem_sched_valid[mem_rsp_lsu_idx])
	       begin
		  pt_event(pt_rob(r_mem_sched_uops[mem_rsp_lsu_idx].rob_ptr), "K", r_cycle);
	       end
	     for(integer i = 0; i < N_MEM_SCHED_ENTRIES; i = i + 1)
	       begin
		  if(t_blk_release[i] && r_mem_sched_valid[i])
		    begin
		       pt_event(pt_rob(r_mem_sched_uops[i].rob_ptr), "K", r_cycle);
		    end
	       end
	     if(r_sd_go)
	       begin
		  pt_event(pt_rob(r_sd_rob), "Z", r_cycle);
	       end
	  end
     end // always_ff@ (negedge clk)
`endif

   always_ff@(posedge clk)
     begin
	r_start_int <= reset ? 1'b0 : (((t_alu_entry_rdy != 'd0) | t_uq_bypass) & !ds_done);
     end // always_comb

   
   
   always_comb
     begin
	//allocation forwarding
	t_alu_alloc_srcA_match = uq.srcA_valid && (
						   (w_mem_rsp_int_valid & (mem_rsp_dst_ptr == uq.srcA)) ||
						   (r_start_int && t_wr_int_prf & (int_uop.dst != 'd0) & (int_uop.dst == uq.srcA))
						   );
	t_alu_alloc_srcB_match = uq.srcB_valid && (
						   (w_mem_rsp_int_valid & (mem_rsp_dst_ptr == uq.srcB)) ||
						   (r_start_int && t_wr_int_prf & (int_uop.dst != 'd0) & (int_uop.dst == uq.srcB))
						   );

	t_alu_alloc_hilo_match = uq.hilo_src_valid && (
						       (t_hilo_prf_ptr_val_out & (t_hilo_prf_ptr_out == uq.hilo_src)) ||
						       (t_div_complete && (t_div_hilo_prf_ptr_out == uq.hilo_src)) ||
						       (r_start_int && t_wr_hilo && (int_uop.hilo_dst == uq.hilo_src))
						       );
	/* FCR source (BC1x): wakes on the fpu compare writing the same FCR phys reg */
	t_alu_alloc_fcr_match = uq.fcr_src_valid &&
				(w_fpu_fcr_valid & (w_fpu_fcr_ptr == uq.hilo_src));

	t_alu_alloc2_srcA_match = uq2.srcA_valid && (
						     (w_mem_rsp_int_valid & (mem_rsp_dst_ptr == uq2.srcA)) ||
						     (r_start_int && t_wr_int_prf & (int_uop.dst != 'd0) & (int_uop.dst == uq2.srcA))
						     );
	t_alu_alloc2_srcB_match = uq2.srcB_valid && (
						     (w_mem_rsp_int_valid & (mem_rsp_dst_ptr == uq2.srcB)) ||
						     (r_start_int && t_wr_int_prf & (int_uop.dst != 'd0) & (int_uop.dst == uq2.srcB))
						     );
	t_alu_alloc2_hilo_match = uq2.hilo_src_valid && (
							 (t_hilo_prf_ptr_val_out & (t_hilo_prf_ptr_out == uq2.hilo_src)) ||
							 (t_div_complete && (t_div_hilo_prf_ptr_out == uq2.hilo_src)) ||
							 (r_start_int && t_wr_hilo && (int_uop.hilo_dst == uq2.hilo_src))
							 );
	t_alu_alloc2_fcr_match = uq2.fcr_src_valid &&
				 (w_fpu_fcr_valid & (w_fpu_fcr_ptr == uq2.hilo_src));
`ifdef ENABLE_MIPS4
	t_alu_alloc_srcC_match = uq.srcC_valid && (
						   (w_mem_rsp_int_valid & (mem_rsp_dst_ptr == uq.srcC)) ||
						   (r_start_int && t_wr_int_prf & (int_uop.dst != 'd0) & (int_uop.dst == uq.srcC))
						   );
	t_alu_alloc2_srcC_match = uq2.srcC_valid && (
						     (w_mem_rsp_int_valid & (mem_rsp_dst_ptr == uq2.srcC)) ||
						     (r_start_int && t_wr_int_prf & (int_uop.dst != 'd0) & (int_uop.dst == uq2.srcC))
						     );
`endif

     end // always_comb
  

   logic [N_INT_SCHED_ENTRIES-1:0] t_alu_sched_mask_valid;
   logic [N_INT_SCHED_ENTRIES-1:0] r_alu_sched_matrix [N_INT_SCHED_ENTRIES-1:0];

   
   always_comb
     begin
	t_alu_sched_mask_valid = r_alu_sched_valid & (~t_alu_select_entry);
     end

   generate
      for(genvar i = 0; i < N_INT_SCHED_ENTRIES; i=i+1)
	begin
	   assign w_alu_sched_oldest_ready[i] = t_alu_entry_rdy[i] & (~(|(t_alu_entry_rdy & r_alu_sched_matrix[i])));
	   always_ff@(posedge clk)
	     begin
		if(reset || t_flash_clear)
		  begin
		     r_alu_sched_matrix[i] <= 'd0;
		  end
		else if(t_alu_alloc_entry[i])
		  begin
		     r_alu_sched_matrix[i] <= t_alu_sched_mask_valid;
		  end
		else if(t_alu_alloc2_entry[i])
		  begin
		     r_alu_sched_matrix[i] <= t_alu_sched_mask_valid | t_alu_alloc_entry;
		  end
		else if(t_alu_entry_rdy != 'd0)
		  begin
		     r_alu_sched_matrix[i] <= r_alu_sched_matrix[i] & (~t_alu_select_entry);
		  end
	     end
	end // for (genvar i = 0; i < N_INT_SCHED_ENTRIES; i=i+1)
   endgenerate

   //always_ff@(negedge clk)
   //begin
   //if(t_alu_entry_rdy != 'd0)
   //	  $display("w_alu_sched_oldest = %b, w_alu_sched_oldest_ready = %b, t_alu_entry_rdy = %b", 
   //w_alu_sched_oldest, w_alu_sched_oldest_ready, t_alu_entry_rdy);
   //end
   
   generate
      for(genvar i = 0; i < N_INT_SCHED_ENTRIES; i=i+1)
	begin
	   always_comb
	     begin
		t_alu_srcA_match[i] = r_alu_sched_uops[i].srcA_valid && (
									 (w_mem_rsp_int_valid & (mem_rsp_dst_ptr == r_alu_sched_uops[i].srcA)) ||
									 (r_start_int && t_wr_int_prf & (int_uop.dst != 'd0) & (int_uop.dst == r_alu_sched_uops[i].srcA))
									 );
		t_alu_srcB_match[i] = r_alu_sched_uops[i].srcB_valid && (
									 (w_mem_rsp_int_valid & (mem_rsp_dst_ptr == r_alu_sched_uops[i].srcB)) ||
									 (r_start_int && t_wr_int_prf & (int_uop.dst != 'd0) & (int_uop.dst == r_alu_sched_uops[i].srcB))
									 );
		
		t_alu_hilo_match[i] = r_alu_sched_uops[i].hilo_src_valid && (
									     (t_hilo_prf_ptr_val_out & (t_hilo_prf_ptr_out == r_alu_sched_uops[i].hilo_src)) ||
									     (t_div_complete && (t_div_hilo_prf_ptr_out == r_alu_sched_uops[i].hilo_src)) ||
									     (r_start_int && t_wr_hilo && (int_uop.hilo_dst == r_alu_sched_uops[i].hilo_src))
									     );
		t_alu_fcr_match[i] = r_alu_sched_uops[i].fcr_src_valid &&
				     (w_fpu_fcr_valid & (w_fpu_fcr_ptr == r_alu_sched_uops[i].hilo_src));
`ifdef ENABLE_MIPS4
		t_alu_srcC_match[i] = r_alu_sched_uops[i].srcC_valid && (
									 (w_mem_rsp_int_valid & (mem_rsp_dst_ptr == r_alu_sched_uops[i].srcC)) ||
									 (r_start_int && t_wr_int_prf & (int_uop.dst != 'd0) & (int_uop.dst == r_alu_sched_uops[i].srcC))
									 );
		t_alu_srcC_ok[i] = t_alu_srcC_match[i] | r_alu_srcC_rdy[i];
`else
		t_alu_srcC_ok[i] = 1'b1;
`endif
	

		//is_mult(r_alu_sched_uops[i].op);
		
		t_alu_entry_rdy[i] = r_alu_sched_valid[i] &&
				     (is_div(r_alu_sched_uops[i].op) ?  (t_div_ready & !t_fdiv_pop) :  (is_mult(r_alu_sched_uops[i].op) ?  !r_wb_bitvec[`MUL_LAT+2] : !r_wb_bitvec[1]))
				     ? (
					(t_alu_srcA_match[i] |r_alu_srcA_rdy[i]) &
					(t_alu_srcB_match[i] |r_alu_srcB_rdy[i]) &
					(t_alu_hilo_match[i] |r_alu_hilo_rdy[i]) &
					(t_alu_fcr_match[i] |r_alu_fcr_rdy[i]) &
					t_alu_srcC_ok[i] &
					(!is_cp0_rd(r_alu_sched_uops[i].op) ||
					 (r_alu_sched_uops[i].cp0_seq == r_cp0_commit_seq)) &
					(!r_alu_sched_uops[i].oldest_first ||
					 (head_of_rob_ptr_valid &&
					  (r_alu_sched_uops[i].rob_ptr == head_of_rob_ptr)) ||
					 /* Fix A sibling: an oldest_first op (e.g. mfc0) that is the
					  * REGULAR delay slot of a complete, faulted branch at the head
					  * is non-speculative (guaranteed to commit), so let it issue
					  * even though the branch -- not it -- is the head.  Without
					  * this, the branch's retire waits for the delay slot to
					  * complete while the delay slot waits to be oldest -> deadlock
					  * (IRIX boot: faulted beqz + mfc0 c0_cause delay slot). */
					 (head_of_rob_ds_committable &&
					  (r_alu_sched_uops[i].rob_ptr == next_head_of_rob_ptr))) ) : 1'b0;
	     end // always_comb
	   
	   always_ff@(posedge clk)
	     begin
		if(reset)
		  begin
		     r_alu_srcA_rdy[i] <= 1'b0;
		     r_alu_srcB_rdy[i] <= 1'b0;
		     r_alu_hilo_rdy[i] <= 1'b0;
		     r_alu_fcr_rdy[i] <= 1'b0;
		  end
		else
		  begin
		     if(t_alu_alloc_entry[i])
		       begin //allocating to this entry
			  r_alu_srcA_rdy[i] <= uq.srcA_valid ? (!r_prf_inflight[uq.srcA] | t_alu_alloc_srcA_match) : 1'b1;
			  r_alu_srcB_rdy[i] <= uq.srcB_valid ? (!r_prf_inflight[uq.srcB] | t_alu_alloc_srcB_match) : 1'b1;
			  r_alu_hilo_rdy[i] <= uq.hilo_src_valid ? (!r_hilo_inflight[uq.hilo_src] | t_alu_alloc_hilo_match) : 1'b1;
			  r_alu_fcr_rdy[i] <= uq.fcr_src_valid ? (!r_fcr_prf_inflight[uq.hilo_src] | t_alu_alloc_fcr_match) : 1'b1;
		       end
		     else if(t_alu_alloc2_entry[i])
		       begin
			  r_alu_srcA_rdy[i] <= uq2.srcA_valid ? (!r_prf_inflight[uq2.srcA] | t_alu_alloc2_srcA_match) : 1'b1;
			  r_alu_srcB_rdy[i] <= uq2.srcB_valid ? (!r_prf_inflight[uq2.srcB] | t_alu_alloc2_srcB_match) : 1'b1;
			  r_alu_hilo_rdy[i] <= uq2.hilo_src_valid ? (!r_hilo_inflight[uq2.hilo_src] | t_alu_alloc2_hilo_match) : 1'b1;
			  r_alu_fcr_rdy[i] <= uq2.fcr_src_valid ? (!r_fcr_prf_inflight[uq2.hilo_src] | t_alu_alloc2_fcr_match) : 1'b1;
		       end
		     else if(t_alu_select_entry[i])
		       begin
			  r_alu_srcA_rdy[i] <= 1'b0;
			  r_alu_srcB_rdy[i] <= 1'b0;
			  r_alu_hilo_rdy[i] <= 1'b0;
			  r_alu_fcr_rdy[i] <= 1'b0;
		       end
		     else if(r_alu_sched_valid[i])
		       begin
			  r_alu_srcA_rdy[i] <= r_alu_srcA_rdy[i] | t_alu_srcA_match[i];
			  r_alu_srcB_rdy[i] <= r_alu_srcB_rdy[i] | t_alu_srcB_match[i];
			  r_alu_hilo_rdy[i] <= r_alu_hilo_rdy[i] | t_alu_hilo_match[i];
			  r_alu_fcr_rdy[i] <= r_alu_fcr_rdy[i] | t_alu_fcr_match[i];
		       end // else: !if(t_pop_uq&&(t_alu_sched_alloc_ptr == i))
		     
		  end // else: !if(reset)
	     end // always_ff@ (posedge clk)
`ifdef ENABLE_MIPS4
	   always_ff@(posedge clk)
	     begin
		if(reset)
		  begin
		     r_alu_srcC_rdy[i] <= 1'b0;
		  end
		else if(t_alu_alloc_entry[i])
		  begin
		     r_alu_srcC_rdy[i] <= uq.srcC_valid ? (!r_prf_inflight[uq.srcC] | t_alu_alloc_srcC_match) : 1'b1;
		  end
		else if(t_alu_alloc2_entry[i])
		  begin
		     r_alu_srcC_rdy[i] <= uq2.srcC_valid ? (!r_prf_inflight[uq2.srcC] | t_alu_alloc2_srcC_match) : 1'b1;
		  end
		else if(t_alu_select_entry[i])
		  begin
		     r_alu_srcC_rdy[i] <= 1'b0;
		  end
		else if(r_alu_sched_valid[i])
		  begin
		     r_alu_srcC_rdy[i] <= r_alu_srcC_rdy[i] | t_alu_srcC_match[i];
		  end
	     end // always_ff@ (posedge clk)
`endif
	end // for (genvar i = 0; i < LG_INT_SCHED_ENTRIES; i=i+1)
   endgenerate
   
   
   
   /* second free entry: any free entry other than the first allocation's */
   always_comb
     begin
	t_alu_sched_free2 = ~r_alu_sched_valid & INT_SCHED_USABLE;
	t_alu_sched_free2[t_alu_sched_alloc_ptr[`LG_INT_SCHED_ENTRIES-1:0]] = 1'b0;
     end

   always_comb
     begin
	t_pop_uq = 1'b0;
	t_uq_bypass = 1'b0;
	t_alu_sched_full = (&(r_alu_sched_valid | ~INT_SCHED_USABLE));
`ifdef ENABLE_SCHED_BYPASS
	/* An entry written into the scheduler is not selectable until the next
	 * cycle, so a uq-head uop whose operands are already ready would wait a
	 * cycle for nothing.  When no scheduler entry is ready (so oldest-ready
	 * priority is unaffected), issue the uq head directly.  Readiness is the
	 * same !inflight|alloc-match test used when the uop is written into an
	 * entry; the operand read and the r_fwd_* capture follow t_picked_uop.
	 * div/mult/oldest_first keep the normal path. */
	t_uq_bypass = !(t_flash_clear || t_uq_empty) && (t_alu_entry_rdy == 'd0) &&
		      !is_div(uq.op) && !is_mult(uq.op) && !uq.oldest_first && !r_wb_bitvec[1] &&
		      (uq.srcA_valid ? (!r_prf_inflight[uq.srcA] | t_alu_alloc_srcA_match) : 1'b1) &&
		      (uq.srcB_valid ? (!r_prf_inflight[uq.srcB] | t_alu_alloc_srcB_match) : 1'b1) &&
		      (uq.hilo_src_valid ? (!r_hilo_inflight[uq.hilo_src] | t_alu_alloc_hilo_match) : 1'b1) &&
		      (uq.fcr_src_valid ? (!r_fcr_prf_inflight[uq.hilo_src] | t_alu_alloc_fcr_match) : 1'b1)
`ifdef ENABLE_MIPS4
		      && (uq.srcC_valid ? (!r_prf_inflight[uq.srcC] | t_alu_alloc_srcC_match) : 1'b1)
`endif
		      ;
`endif
	t_pop_uq = !(t_flash_clear || t_uq_empty ||t_alu_sched_full) || t_uq_bypass;
	t_pop_uq2 = 1'b0;
`ifdef ENABLE_UQ_DUAL_POP
	/* The uq pops one uop per cycle but allocation pushes up to two, so
	 * back-to-back int pairs queue here.  Pop the second uq entry into a
	 * second free scheduler entry.  Both uops were pushed in earlier cycles,
	 * so their inflight bits already reflect each other (no pair hazard). */
	t_pop_uq2 = t_pop_uq && (r_uq_next_head_ptr != r_uq_tail_ptr) && (t_alu_sched_free2 != 'd0);
`endif
     end
   
   always_ff@(posedge clk)
     begin
	if(reset || t_flash_clear)
	  begin
	     r_alu_sched_valid <= 'd0;
	  end
	else
	  begin
	     if(t_pop_uq && !t_uq_bypass)
	       begin
		  /* USABLE, not 1: unusable entries' valid bits are then a constant 0 */
		  r_alu_sched_valid[t_alu_sched_alloc_ptr[`LG_INT_SCHED_ENTRIES-1:0]] <= INT_SCHED_USABLE[t_alu_sched_alloc_ptr[`LG_INT_SCHED_ENTRIES-1:0]];
		  r_alu_sched_uops[t_alu_sched_alloc_ptr[`LG_INT_SCHED_ENTRIES-1:0]] <= uq;
	       end
	     if(t_pop_uq2)
	       begin
		  r_alu_sched_valid[t_alu_sched_alloc2_ptr[`LG_INT_SCHED_ENTRIES-1:0]] <= INT_SCHED_USABLE[t_alu_sched_alloc2_ptr[`LG_INT_SCHED_ENTRIES-1:0]];
		  r_alu_sched_uops[t_alu_sched_alloc2_ptr[`LG_INT_SCHED_ENTRIES-1:0]] <= uq2;
	       end
	     if(t_alu_entry_rdy != 'd0)
	       begin
		  r_alu_sched_valid[t_alu_sched_select_ptr[`LG_INT_SCHED_ENTRIES-1:0]] <= 1'b0;
	       end
	  end // else: !if(reset)
     end

   logic t_32b_shift, t_shift_left;

   wire [`M_WIDTH-1:0] w_shifter_out;
   generate
      if(`M_WIDTH == 64)
	begin
	   wire [63:0] w_shift_src = t_32b_shift ? 
				     {{32{(t_signed_shift ? t_srcA[31] : 1'b0)}}, t_srcA[31:0]} : 
				     t_srcA;   

	   shift_right #(.LG_W(6)) 
	   s0(
	      .is_left(t_shift_left),
	      .is_signed(t_signed_shift),
	      .is_circular(1'b0),
	      .data(w_shift_src), 
	      .distance(t_shift_amt),
	      .y(w_shifter_out)
	      );

	end
      else
	begin
	   shift_right #(.LG_W(5)) 
	   s0(
	      .is_left(t_shift_left),
	      .is_signed(t_signed_shift),
	      .is_circular(1'b0),
	      .data(t_srcA[31:0]), 
	      .distance(t_shift_amt),
	      .y(w_shifter_out)
	      );

	end // UNMATCHED !!
   endgenerate
   
   
   mul #(.W(`M_WIDTH)) m(
			 .clk(clk),
			 .reset(reset),
			 .is_signed(int_uop.op != MULTU && int_uop.op != DMULTU),
			 .go(t_start_mul&r_start_int),
			 .is_32b(int_uop.op == MULT || int_uop.op == MULTU),
			 .src_A(t_srcA),
			 .src_B(t_srcB),
			 .rob_ptr_in(int_uop.rob_ptr),
			 .hilo_prf_ptr_in(int_uop.hilo_dst),
			 .y(t_mul_result),
			 .complete(t_mul_complete),
			 .rob_ptr_out(t_rob_ptr_out),
			 .hilo_prf_ptr_val_out(t_hilo_prf_ptr_val_out),
			 .hilo_prf_ptr_out(t_hilo_prf_ptr_out)
	 );

   /* CLZ-accelerated divider (ported from rv64core/nu_divider). It finishes
    * early and holds the result until a HILO writeback slot is free; the other
    * two HILO writers are the multiplier (t_hilo_prf_ptr_val_out) and int->HILO
    * ops (r_start_int & t_wr_hilo). The DIV32/64_LAT reservation above is the
    * backstop that guarantees a free slot by the worst-case latency. */
   uni_divider #(.LG_W(`LG_M_WIDTH))
   d0 (
       .clk(clk),
       .reset(reset),
       /* ds_done: the delay slot (if any) has completed, so an op still in d0 is dead */
       .flush(ds_done),
       /* defer the divide's WB drain for ANY int completion, not just HILO-writing
	* ones: the divide shares the ROB completion port complete_bundle_1 with plain
	* ALU ops (r_start_int & t_alu_valid), and div wins that mux -- so draining in
	* the same cycle an ALU op completes DROPS the ALU op's completion -> its ROB
	* entry never completes -> head wedge.  (& t_wr_hilo missed plain ALU ops; this
	* restores rv64core's `r_start_int | t_mul_complete` guard.) */
       .wb_slot_used(t_hilo_prf_ptr_val_out | r_start_int),
       .is_32b(t_start_div32),
       .srcA(t_srcA),
       .srcB(t_srcB),
       .rob_ptr_in(int_uop.rob_ptr),
       .hilo_prf_ptr_in(int_uop.hilo_dst),
       .is_signed_div(t_signed_div),
       .start_div(t_start_div32 | t_start_div64),
       .y(t_div_result),
       .rob_ptr_out(t_div_rob_ptr_out),
       .hilo_prf_ptr_out(t_div_hilo_prf_ptr_out),
       .complete(t_div_complete),
       .ready(t_div_ready),
       .fp_opcode(r_fp_iss_uop.op),
       .fp_start(t_fdiv_start),
`ifdef ENABLE_MIPS4
       /* recip = 1.0 / fs: the constant dividend, fs as the divisor */
       .fp_src_a(((r_fp_iss_uop.op == SP_RECIP) || (r_fp_iss_uop.op == DP_RECIP)) ?
		 ((r_fp_iss_uop.op == DP_RECIP) ? 64'h3ff0000000000000 : 64'h000000003f800000) : w_fp_srcA),
       .fp_src_b(((r_fp_iss_uop.op == SP_RECIP) || (r_fp_iss_uop.op == DP_RECIP)) ? w_fp_srcA : w_fp_srcB),
`else
       .fp_src_a(w_fp_srcA),
       .fp_src_b(w_fp_srcB),
`endif
       .fp_rm(r_fcsr[1:0]),
       .fp_rob_ptr_in(r_fp_iss_uop.rob_ptr),
       .fp_dst_ptr_in(r_fp_iss_uop.dst),
       .fp_wb_slot_used(t_fdiv_wb_used),
       .fp_ready(w_fdiv_ready),
       .fp_complete(w_fdiv_complete),
       .fp_y(w_fdiv_y),
       .fp_fflags(w_fdiv_fflags),
       .fp_denorm(w_fdiv_denorm),
       .fp_rob_ptr_out(w_fdiv_rob_ptr),
       .fp_dst_ptr_out(w_fdiv_dst_ptr)
       );
   
   assign divide_ready = t_div_ready;




   
   always_comb
     begin
	n_mq_head_ptr = r_mq_head_ptr;
	n_mq_tail_ptr = r_mq_tail_ptr;
	n_mq_next_tail_ptr = r_mq_next_tail_ptr;
	
`ifdef ENABLE_L1D_SKID
	/* skid: enqueue a fresh request only if it was NOT bypassed-and-accepted this
	 * cycle; advance head only for requests that actually came from the FIFO. */
	if(r_mem_ready & !(w_skid_bypass & mem_req_ack))
	  begin
	     n_mq_tail_ptr = r_mq_tail_ptr + 'd1;
	     n_mq_next_tail_ptr = r_mq_next_tail_ptr + 'd1;
	  end
	if(mem_req_ack & !w_skid_bypass)
	  begin
	     n_mq_head_ptr = r_mq_head_ptr + 'd1;
	  end
`else
	if(r_mem_ready)
	  begin
	     n_mq_tail_ptr = r_mq_tail_ptr + 'd1;
	     n_mq_next_tail_ptr = r_mq_next_tail_ptr + 'd1;
	  end
	if(mem_req_ack)
	  begin
	     n_mq_head_ptr = r_mq_head_ptr + 'd1;
	  end
`endif
	
	t_mem_head = r_mem_q[r_mq_head_ptr[`LG_MQ_ENTRIES-1:0]];
	
	mem_q_empty = (r_mq_head_ptr == r_mq_tail_ptr);
	
	mem_q_full = (r_mq_head_ptr != r_mq_tail_ptr) &&
		     (r_mq_head_ptr[`LG_MQ_ENTRIES-1:0] == r_mq_tail_ptr[`LG_MQ_ENTRIES-1:0]);

	mem_q_next_full = (r_mq_head_ptr != r_mq_next_tail_ptr) &&
			  (r_mq_head_ptr[`LG_MQ_ENTRIES-1:0] == r_mq_next_tail_ptr[`LG_MQ_ENTRIES-1:0]);
	
     end // always_comb
   
   always_ff@(posedge clk)
     begin
`ifdef ENABLE_L1D_SKID
	if(r_mem_ready & !(w_skid_bypass & mem_req_ack))
	  begin
	     r_mem_q[r_mq_tail_ptr[`LG_MQ_ENTRIES-1:0]] <= t_mem_tail;
	  end
`else
	if(r_mem_ready)
	  begin
	     r_mem_q[r_mq_tail_ptr[`LG_MQ_ENTRIES-1:0]] <= t_mem_tail;
	  end
`endif
     end


   
   

   
`ifdef ENABLE_L1D_SKID
   /* bypass the FIFO when it is empty and a fresh AGU'd request is ready this
    * cycle: drive t_mem_tail straight to the L1D (which accepts combinationally
    * and registers into r_req2), saving the enqueue->dequeue cycle. */
   wire w_skid_bypass = (r_mq_head_ptr == r_mq_tail_ptr) & r_mem_ready;
   assign mem_req       = w_skid_bypass ? t_mem_tail : t_mem_head;
   assign mem_req_valid = !mem_q_empty | r_mem_ready;
`else
   assign mem_req = t_mem_head;
   assign mem_req_valid = !mem_q_empty;
`endif
   assign uq_wait = r_uq_wait;
   assign mq_wait = r_mq_wait;
   assign dbg_memop_pc = r_memop_pc[dbg_memop_idx];
   assign fp_uq_wait = r_fp_uq_wait;
   
   
   always_ff@(posedge clk)
     begin
	r_mq_head_ptr <= reset ? 'd0 : n_mq_head_ptr;
	r_mq_tail_ptr <= reset ? 'd0 : n_mq_tail_ptr;
	r_mq_next_tail_ptr <= reset ? 'd1 : n_mq_next_tail_ptr;
     end

   always_ff@(posedge clk)
     begin
	if(reset)
	  begin
	     r_prf_inflight <= 'd0;
	     r_hilo_inflight <= 'd0;
	     r_fp_prf_inflight <= 'd0;
	  end
	else
	  begin
	     r_prf_inflight <= ds_done ? 'd0 : n_prf_inflight;
	     r_hilo_inflight <= ds_done ? 'd0 : n_hilo_inflight;
	     r_fp_prf_inflight <= ds_done ? 'd0 : n_fp_prf_inflight;
	  end
     end // always_ff@ (posedge clk)

   /* FP register file -- clustered/banked (Henry Wong scheme), like the int PRF.
    * Bank by physical-ptr MSB: bank 0 (fpu-arith results, write port 0) / bank 1
    * (mem-pipe FP results = loads + mtc1, write port 1).  The free-list allocates
    * fp dsts into the bank matching their producing write port (core.sv), so the
    * MSB is meaningful.  4 synchronous read ports: rd0/rd1 = fpu operands (address
    * = combinational FP-UQ head; consumed a cycle later in the FP read stage),
    * rd2/rd3 = mem-pipe reads (mfc1 source / FP store data), aligned with mem_uq /
    * mem_dq exactly as before.  read-before-write on a same-cycle collision is a
    * non-issue: inflight pop-gating never lets a source be read the cycle it is
    * written. */
   fp_regfile #(.WIDTH(`M_WIDTH), .LG_DEPTH(`LG_PRF_ENTRIES))
   fpprf (.clk(clk),
	  .reset(reset),
	  .rdptr0(fp_uq.srcA),
	  .rdptr1(fp_uq.srcB),
	  .rdptr2(t_picked_mem_uop.srcB),
	  .rdptr3(t_sd_src),
`ifdef ENABLE_MIPS4
	  .rdptr4(fp_uq.srcC),
`else
	  .rdptr4('d0),
`endif
	  /* bank0 write port shared by fpu-arith result and single-cycle convert
	   * (mutually exclusive by r_fp_wb_bitvec) */
	  .wrptr0(w_fdiv_complete ? w_fdiv_dst_ptr : w_fpu_result_valid ? w_fpu_dst_ptr : r_cvt_dst),
	  .wrptr1(mem_rsp_dst_ptr),
	  .wen0(w_fdiv_complete | w_fpu_result_valid | r_cvt_valid),
	  .wen1(mem_rsp_dst_valid & mem_rsp_fp_dst),
	  .wr0(w_fdiv_complete ? w_fdiv_y : w_fpu_result_valid ? w_fpu_result : r_cvt_result),
	  /* FR=0 lwc1 merge: splice the loaded 32 into the fp_hi half, keep fp_pres. */
	  .wr1(mem_rsp_fp_merge
	       ? (mem_rsp_fp_hi ? {mem_rsp_load_data[31:0], mem_rsp_fp_pres}
				: {mem_rsp_fp_pres, mem_rsp_load_data[31:0]})
	       : mem_rsp_load_data),
	  .rd0(w_fp_srcA),
	  .rd1(w_fp_srcB),
	  .rd2(r_fp_rd_srcB),
	  .rd3(r_fp_rd_dq),
	  .rd4(w_fp_srcC)
	  );

   
   always_comb
     begin
	n_prf_inflight = r_prf_inflight;
	n_fp_prf_inflight = r_fp_prf_inflight;


	if(uq_push && uq_uop.dst_valid)
	  begin
	     n_prf_inflight[uq_uop.dst] = 1'b1;
	  end
	if(uq_push_two && uq_uop_two.dst_valid)
	  begin
	     n_prf_inflight[uq_uop_two.dst] = 1'b1;
	  end
	/* FP dst allocation marks the FP physical reg inflight */
	if(uq_push && uq_uop.fp_dst_valid)
	  n_fp_prf_inflight[uq_uop.dst] = 1'b1;
	if(uq_push_two && uq_uop_two.fp_dst_valid)
	  n_fp_prf_inflight[uq_uop_two.dst] = 1'b1;

	if(mem_rsp_dst_valid)
	  begin
	     if(mem_rsp_fp_dst)
	       n_fp_prf_inflight[mem_rsp_dst_ptr] = 1'b0;
	     else
	       n_prf_inflight[mem_rsp_dst_ptr] = 1'b0;
	  end
	/* the unified divider's FP result clears its FP-dst inflight bit */
	if(w_fdiv_complete)
	  n_fp_prf_inflight[w_fdiv_dst_ptr] = 1'b0;
	/* FP arithmetic result clears the FP-dst inflight bit */
	if(w_fpu_result_valid)
	  n_fp_prf_inflight[w_fpu_dst_ptr] = 1'b0;
	/* single-cycle convert result clears its FP-dst inflight bit */
	if(r_cvt_valid)
	  n_fp_prf_inflight[r_cvt_dst] = 1'b0;
	if(r_start_int && t_wr_int_prf)
	  begin
	     n_prf_inflight[int_uop.dst] = 1'b0;
	  end
     end // always_comb

   // =================================================================
   // FP execution pipe (mirrors mipscore: in-order FP UQ -> fpu -> port 2)
   // =================================================================
   localparam N_FP_UQ_ENTRIES   = (1<<`LG_FP_UQ_ENTRIES);
   localparam N_FCR_PRF_ENTRIES = (1<<`LG_FCR_PRF_ENTRIES);

   /* FP issue queue: a normal circular queue, issued strictly in-order (no
    * scheduler) -- exactly like mipscore.  Sources wake on r_fp_prf_inflight /
    * r_fcr_prf_inflight; the fpu is fixed-latency so FP completes 1/cycle on its
    * own ROB port (complete_bundle_2) with no shared writeback-bitvec. */
   uop_t r_fp_uq[N_FP_UQ_ENTRIES];
   uop_t fp_uq;
   logic t_fp_uq_empty, t_fp_uq_full, t_fp_uq_next_full;
   logic [`LG_FP_UQ_ENTRIES:0] r_fp_uq_head_ptr, n_fp_uq_head_ptr;
   logic [`LG_FP_UQ_ENTRIES:0] r_fp_uq_tail_ptr, n_fp_uq_tail_ptr;
   logic [`LG_FP_UQ_ENTRIES:0] r_fp_uq_next_tail_ptr, n_fp_uq_next_tail_ptr;
   logic t_push_one_fp, t_push_two_fp, t_pop_fp_uq;

   /* renamed FCR (FP condition-code byte) physical register file */
   logic [7:0] r_fcr_prf[N_FCR_PRF_ENTRIES-1:0];
   /* FP condition codes live ONLY here.  r_fcsr holds bits 23 and 31:25 at zero
    * and CFC1 ORs the renamed vector back in, so the two cannot drift apart --
    * which is how `ctc1 $t,$31; bc1t' came to read a stale condition code. */
   localparam [31:0] FCC_MASK = {7'h7f, 1'b0, 1'b1, 23'd0};
   function automatic logic [31:0] fcc_expand(input logic [7:0] cc);
      begin
	 fcc_expand = {cc[7:1], 1'b0, cc[0], 23'd0};
      end
   endfunction
   logic [N_FCR_PRF_ENTRIES-1:0] r_fcr_prf_inflight, n_fcr_prf_inflight;

   /* fpu outputs */
   wire [63:0] w_fpu_result;
   wire [4:0]  w_fpu_fflags;
   wire        w_fpu_denorm;
   wire        w_fpu_result_valid, w_fpu_fcr_valid;
   wire [`LG_PRF_ENTRIES-1:0]     w_fpu_dst_ptr;
   wire [`LG_FCR_PRF_ENTRIES-1:0] w_fpu_fcr_ptr;
   wire [`LG_ROB_ENTRIES-1:0]     w_fpu_rob_ptr;

   /* single-cycle FP convert (fpu_f2i / fpu_i2f) -- shares the bank0 write port +
    * complete_bundle_2 with the multi-cycle fpu, arbitrated by r_fp_wb_bitvec.
    * Latency from pop: convert = 2 (read stage + 1), fpu = FPU_LAT+1; reserve each
    * op's writeback slot at pop, gate the head on the matching slot. */
`ifdef ENABLE_MIPS4
   /* madd/msub/nmadd/nmsub: a mul pass then an add pass in fpu0 -> 2*FPU_LAT+1 from pop.
    * Its add pass re-enters fpu0's head FPU_LAT cycles after its own start, so that
    * start slot is reserved too (r_fp_st_bitvec, same dist conventions: an fpu op
    * popped now starts at dist 1, a madd's add pass at dist FPU_LAT+1). */
   localparam FP_WB_BITS = 2*`FPU_LAT + 2;
   localparam FP_ST_BITS = `FPU_LAT + 2;
   logic [FP_ST_BITS-1:0] r_fp_st_bitvec, n_fp_st_bitvec;
`else
   localparam FP_WB_BITS = `FPU_LAT + 2;
`endif
   logic [FP_WB_BITS-1:0] r_fp_wb_bitvec, n_fp_wb_bitvec;
   wire [63:0] w_f2i_out, w_i2f_out, w_f2f_out;
   wire [4:0]  w_f2i_fflags, w_i2f_fflags, w_f2f_fflags;
   wire        w_f2f_denorm;
   logic        r_cvt_valid;
   logic [`LG_PRF_ENTRIES-1:0] r_cvt_dst;
   logic [`LG_ROB_ENTRIES-1:0] r_cvt_rob;
   logic [63:0] r_cvt_result;
   logic [4:0]  r_cvt_fflags;
   logic        r_cvt_denorm;   /* CVT.S.D narrow underflow / denorm operand -> E-trap */
   /* head-op (fp_uq) and issue-op (r_fp_iss_uop) convert classification */
   wire w_head_is_cvt = (fp_uq.op == TRUNC_W_S) || (fp_uq.op == TRUNC_W_D) ||
			(fp_uq.op == CVT_S_W)   || (fp_uq.op == CVT_D_W)   ||
			(fp_uq.op == CVT_S_D)   || (fp_uq.op == CVT_D_S)   ||
			(fp_uq.op == CVT_W_S)   || (fp_uq.op == CVT_W_D)   ||
			(fp_uq.op == CVT_L_S)   || (fp_uq.op == CVT_L_D)   ||
			(fp_uq.op == CVT_S_L)   || (fp_uq.op == CVT_D_L);
   wire w_iss_is_f2f  = (r_fp_iss_uop.op == CVT_S_D)   || (r_fp_iss_uop.op == CVT_D_S);
   wire w_iss_is_f2i  = (r_fp_iss_uop.op == TRUNC_W_S) || (r_fp_iss_uop.op == TRUNC_W_D) ||
			(r_fp_iss_uop.op == CVT_W_S)   || (r_fp_iss_uop.op == CVT_W_D)   ||
			(r_fp_iss_uop.op == CVT_L_S)   || (r_fp_iss_uop.op == CVT_L_D);
   wire w_iss_is_i2f  = (r_fp_iss_uop.op == CVT_S_W)   || (r_fp_iss_uop.op == CVT_D_W)   ||
			(r_fp_iss_uop.op == CVT_S_L)   || (r_fp_iss_uop.op == CVT_D_L);
   wire w_iss_is_cvt  = w_iss_is_f2i | w_iss_is_i2f | w_iss_is_f2f;
   /* abs/neg/mov: single-cycle bit-twiddle, ride the same single-cycle path as
    * converts (bank0 writeback, complete at pop+2 via r_fp_wb_bitvec). */
   wire w_head_is_signop = (fp_uq.op == SP_ABS) || (fp_uq.op == DP_ABS) ||
			   (fp_uq.op == SP_NEG) || (fp_uq.op == DP_NEG) ||
			   (fp_uq.op == SP_MOV) || (fp_uq.op == DP_MOV);
   wire w_iss_is_signop  = (r_fp_iss_uop.op == SP_ABS) || (r_fp_iss_uop.op == DP_ABS) ||
			   (r_fp_iss_uop.op == SP_NEG) || (r_fp_iss_uop.op == DP_NEG) ||
			   (r_fp_iss_uop.op == SP_MOV) || (r_fp_iss_uop.op == DP_MOV);
`ifdef ENABLE_MIPS4
   wire w_head_is_fcmov = (fp_uq.op == FP_CMOV);
   wire w_iss_is_fcmov  = (r_fp_iss_uop.op == FP_CMOV);
`else
   wire w_head_is_fcmov = 1'b0;
   wire w_iss_is_fcmov  = 1'b0;
`endif
   /* convert, signop and the FP conditional moves are single-cycle (bitvec dist 2,
    * fpu bypassed) */
   wire w_head_is_sc = w_head_is_cvt | w_head_is_signop | w_head_is_fcmov;
`ifdef ENABLE_MIPS4
   /* recip/rsqrt run on the divider too (uni_divider: 1.0 / fs, and its two-pass rsqrt) */
   wire w_head_is_ds = (fp_uq.op == SP_DIV) || (fp_uq.op == DP_DIV) ||
		       (fp_uq.op == SP_SQRT) || (fp_uq.op == DP_SQRT) ||
		       (fp_uq.op == SP_RECIP) || (fp_uq.op == DP_RECIP) ||
		       (fp_uq.op == SP_RSQRT) || (fp_uq.op == DP_RSQRT);
   wire w_iss_is_ds  = (r_fp_iss_uop.op == SP_DIV) || (r_fp_iss_uop.op == DP_DIV) ||
		       (r_fp_iss_uop.op == SP_SQRT) || (r_fp_iss_uop.op == DP_SQRT) ||
		       (r_fp_iss_uop.op == SP_RECIP) || (r_fp_iss_uop.op == DP_RECIP) ||
		       (r_fp_iss_uop.op == SP_RSQRT) || (r_fp_iss_uop.op == DP_RSQRT);
   wire w_head_is_madd = (fp_uq.op == SP_MADD) || (fp_uq.op == DP_MADD) ||
			 (fp_uq.op == SP_MSUB) || (fp_uq.op == DP_MSUB) ||
			 (fp_uq.op == SP_NMADD) || (fp_uq.op == DP_NMADD) ||
			 (fp_uq.op == SP_NMSUB) || (fp_uq.op == DP_NMSUB);
`else
   wire w_head_is_ds = (fp_uq.op == SP_DIV) || (fp_uq.op == DP_DIV) ||
		       (fp_uq.op == SP_SQRT) || (fp_uq.op == DP_SQRT);
   wire w_iss_is_ds  = (r_fp_iss_uop.op == SP_DIV) || (r_fp_iss_uop.op == DP_DIV) ||
		       (r_fp_iss_uop.op == SP_SQRT) || (r_fp_iss_uop.op == DP_SQRT);
   wire w_head_is_madd = 1'b0;
`endif
   /* writeback distance from pop: convert 2, fpu FPU_LAT+1, madd 2*FPU_LAT+1 */
   localparam LG_FP_WB = $clog2(FP_WB_BITS);
   wire [LG_FP_WB-1:0] w_head_wb_dist = w_head_is_sc ? LG_FP_WB'(2) :
				       w_head_is_madd ? LG_FP_WB'(2*`FPU_LAT+1) : LG_FP_WB'(`FPU_LAT+1);
   wire w_iss_is_sc  = w_iss_is_cvt  | w_iss_is_signop | w_iss_is_fcmov;
   /* abs.* clears the sign, neg.* flips it, mov.* copies; single zero-extends low 32 */
   wire w_signop_dbl = (r_fp_iss_uop.op == DP_ABS) || (r_fp_iss_uop.op == DP_NEG) || (r_fp_iss_uop.op == DP_MOV);
   wire w_signop_abs = (r_fp_iss_uop.op == SP_ABS) || (r_fp_iss_uop.op == DP_ABS);
   wire w_signop_neg = (r_fp_iss_uop.op == SP_NEG) || (r_fp_iss_uop.op == DP_NEG);
   wire [63:0] w_signop_out = w_signop_dbl ?
       (w_signop_abs ? {1'b0,           w_fp_srcA[62:0]} :
        w_signop_neg ? {~w_fp_srcA[63], w_fp_srcA[62:0]} : w_fp_srcA) :
       {32'd0, (w_signop_abs ? {1'b0,           w_fp_srcA[30:0]} :
                w_signop_neg ? {~w_fp_srcA[31], w_fp_srcA[30:0]} : w_fp_srcA[31:0])};

   logic t_fpu_srcA_rdy, t_fpu_srcB_rdy, t_fpu_fcr_rdy, t_fpu_srcs_rdy;
   /* registered FP read/issue stage: the cycle after a head pops, the fp_regfile
    * presents its operands (w_fp_srcA/B) and these carry the issued uop's metadata,
    * so the fpu sees registered operands + metadata together (synchronous RF read
    * costs +1 FP issue latency; inflight gating keeps it correct, no bypass). */
   uop_t       r_fp_iss_uop;
   logic       r_fp_iss_valid;
   logic [7:0] r_fp_iss_fcr;

   // ---- FP UQ pointers / full-empty / push-pop bookkeeping ----
   always_comb
     begin
	n_fp_uq_head_ptr = r_fp_uq_head_ptr;
	n_fp_uq_tail_ptr = r_fp_uq_tail_ptr;
	n_fp_uq_next_tail_ptr = r_fp_uq_next_tail_ptr;
	t_fp_uq_empty = (r_fp_uq_head_ptr == r_fp_uq_tail_ptr);
	t_fp_uq_full = (r_fp_uq_head_ptr != r_fp_uq_tail_ptr) &&
		       (r_fp_uq_head_ptr[`LG_FP_UQ_ENTRIES-1:0] == r_fp_uq_tail_ptr[`LG_FP_UQ_ENTRIES-1:0]);
	t_fp_uq_next_full = (r_fp_uq_head_ptr != r_fp_uq_next_tail_ptr) &&
			    (r_fp_uq_head_ptr[`LG_FP_UQ_ENTRIES-1:0] == r_fp_uq_next_tail_ptr[`LG_FP_UQ_ENTRIES-1:0]);
	fp_uq = r_fp_uq[r_fp_uq_head_ptr[`LG_FP_UQ_ENTRIES-1:0]];

	t_push_two_fp = uq_push && uq_push_two && uq_uop.is_fp && uq_uop_two.is_fp;
	t_push_one_fp = ((uq_push && uq_uop.is_fp) || (uq_push_two && uq_uop_two.is_fp)) && !t_push_two_fp;

	if(t_push_two_fp)
	  begin
	     n_fp_uq_tail_ptr = r_fp_uq_tail_ptr + 'd2;
	     n_fp_uq_next_tail_ptr = r_fp_uq_next_tail_ptr + 'd2;
	  end
	else if((uq_push_two && uq_uop_two.is_fp) || (uq_push && uq_uop.is_fp))
	  begin
	     n_fp_uq_tail_ptr = r_fp_uq_tail_ptr + 'd1;
	     n_fp_uq_next_tail_ptr = r_fp_uq_next_tail_ptr + 'd1;
	  end
	if(t_pop_fp_uq)
	  n_fp_uq_head_ptr = r_fp_uq_head_ptr + 'd1;
     end

   always_ff@(posedge clk)
     begin
	if(reset || t_flash_clear)
	  begin
	     r_fp_uq_head_ptr <= 'd0;
	     r_fp_uq_tail_ptr <= 'd0;
	     r_fp_uq_next_tail_ptr <= 'd1;
	  end
	else
	  begin
	     r_fp_uq_head_ptr <= n_fp_uq_head_ptr;
	     r_fp_uq_tail_ptr <= n_fp_uq_tail_ptr;
	     r_fp_uq_next_tail_ptr <= n_fp_uq_next_tail_ptr;
	  end
     end
   always_ff@(posedge clk)
     begin
	if(t_push_two_fp)
	  begin
	     r_fp_uq[r_fp_uq_tail_ptr[`LG_FP_UQ_ENTRIES-1:0]] <= uq_uop;
	     r_fp_uq[r_fp_uq_next_tail_ptr[`LG_FP_UQ_ENTRIES-1:0]] <= uq_uop_two;
	  end
	else if(t_push_one_fp)
	  r_fp_uq[r_fp_uq_tail_ptr[`LG_FP_UQ_ENTRIES-1:0]] <= uq_uop.is_fp ? uq_uop : uq_uop_two;
     end

   // ---- in-order issue: wake on source inflight bits, pop when ready ----
   always_comb
     begin
	t_fpu_srcA_rdy = fp_uq.fp_srcA_valid ? !r_fp_prf_inflight[fp_uq.srcA] : 1'b1;
	t_fpu_srcB_rdy = fp_uq.fp_srcB_valid ? !r_fp_prf_inflight[fp_uq.srcB] : 1'b1;
	t_fpu_fcr_rdy  = fp_uq.fcr_src_valid ? !r_fcr_prf_inflight[fp_uq.hilo_src] : 1'b1;
	t_fpu_srcs_rdy = t_fpu_srcA_rdy && t_fpu_srcB_rdy && t_fpu_fcr_rdy;
`ifdef ENABLE_MIPS4
	/* madd's fr */
	if(fp_uq.fp_srcC_valid && r_fp_prf_inflight[fp_uq.srcC])
	  begin
	     t_fpu_srcs_rdy = 1'b0;
	  end
	/* movz/movn.fmt: GPR rt (srcC) must be written, so its zero flag is valid */
	if(fp_uq.srcC_valid && r_prf_inflight[fp_uq.srcC])
	  begin
	     t_fpu_srcs_rdy = 1'b0;
	  end
`endif
	/* writeback slot for the head op (convert=2, fpu arith/compare=FPU_LAT+1 from pop)
	 * must be free, else stall a cycle (mixed-latency shared FP writeback port). */
	/* div.s/div.d/sqrt.s/sqrt.d run on the unified divider (d0), not fpu0.
	 * Variable latency, one op in flight, shared with the INTEGER divides: the
	 * head pops only when d0 is free (w_fdiv_ready), starts from the issue stage
	 * the next cycle, and drains into the FP writeback port / complete_bundle_2
	 * in the first cycle neither fpu0 nor the convert path is using them -- so it
	 * takes no r_fp_wb_bitvec reservation. */
	t_pop_fp_uq = !t_fp_uq_empty && !t_flash_clear && t_fpu_srcs_rdy &&
		      (w_head_is_ds ? w_fdiv_ready
				    : !r_fp_wb_bitvec[w_head_wb_dist]);
`ifdef ENABLE_MIPS4
	/* an fpu op (not convert/signop/cmov, not divider) starts fpu0 next cycle: not in
	 * the slot a madd's add pass has reserved */
	if(!w_head_is_sc && !w_head_is_ds && r_fp_st_bitvec[1])
	  begin
	     t_pop_fp_uq = 1'b0;
	  end
`endif
	t_fdiv_pop     = t_pop_fp_uq & w_head_is_ds;
	t_fdiv_start   = r_fp_iss_valid & w_iss_is_ds;
	t_fdiv_wb_used = w_fpu_result_valid | w_fpu_fcr_valid | r_cvt_valid;
     end

   /* FP writeback reservation: shift down each cycle; on pop, reserve dist-1 (next-cycle
    * frame). gate above reads [dist]. arith/compare fpu dist=FPU_LAT+1, convert dist=2. */
   always_comb
     begin
	integer i;
	for(i = 0; i < FP_WB_BITS-1; i = i + 1)
	  n_fp_wb_bitvec[i] = r_fp_wb_bitvec[i+1];
	n_fp_wb_bitvec[FP_WB_BITS-1] = 1'b0;
	if(t_pop_fp_uq)
	  n_fp_wb_bitvec[w_head_wb_dist - LG_FP_WB'(1)] = 1'b1;
     end
`ifdef ENABLE_MIPS4
   always_comb
     begin
	integer i;
	for(i = 0; i < FP_ST_BITS-1; i = i + 1)
	  begin
	     n_fp_st_bitvec[i] = r_fp_st_bitvec[i+1];
	  end
	n_fp_st_bitvec[FP_ST_BITS-1] = 1'b0;
	if(t_pop_fp_uq && w_head_is_madd)
	  begin
	     n_fp_st_bitvec[`FPU_LAT] = 1'b1;
	  end
     end
   always_ff@(posedge clk)
     begin
	if(reset)
	  begin
	     r_fp_st_bitvec <= 'd0;
	  end
	else
	  begin
	     r_fp_st_bitvec <= n_fp_st_bitvec;
	  end
     end
`endif
   always_ff@(posedge clk)
     begin
	/* NOT flushed on t_flash_clear: an FP op already in the pipeline (popped from
	 * fp_uq) must run to completion so it clears its r_rob_inflight bit -- otherwise
	 * EXCEPTION_DRAIN (which waits for r_rob_inflight==0 with flash_clear held high
	 * the whole drain) deadlocks.  Matches mipscore (fq_wait drops the *waiting* ops;
	 * the in-flight pipe drains naturally).  fpu0's internal pipe likewise only resets. */
	if(reset)
	  r_fp_wb_bitvec <= 'd0;
	else
	  r_fp_wb_bitvec <= n_fp_wb_bitvec;
     end

   /* FP read/issue stage register: aligns with the fp_regfile rd0/rd1 latency.
    * NOT flushed on t_flash_clear -- a just-popped op must reach fpu0 and complete
    * so its r_rob_inflight clears (see r_fp_wb_bitvec note).  t_pop_fp_uq is gated by
    * !t_flash_clear, so no NEW op enters; this only lets the one caught op proceed. */
   always_ff@(posedge clk)
     begin
	if(reset)
	  r_fp_iss_valid <= 1'b0;
	else
	  r_fp_iss_valid <= t_pop_fp_uq;
     end
   always_ff@(posedge clk)
     begin
	r_fp_iss_uop <= fp_uq;
	r_fp_iss_fcr <= r_fcr_prf[fp_uq.hilo_src];
     end
`ifdef ENABLE_MIPS4
   /* movz/movn.fmt condition: rt's zero flag, read with the FCC at issue */
   logic r_fp_iss_zero;
   always_ff@(posedge clk)
     begin
	r_fp_iss_zero <= r_prf_zero[fp_uq.srcC];
     end
   /* whole 64-bit register either way (the old fd is srcB): .s keeps fd's upper half */
   wire w_fcmov_cond = (r_fp_iss_uop.imm[5:4] == 2'd0) ? (r_fp_iss_fcr[r_fp_iss_uop.imm[2:0]] == r_fp_iss_uop.imm[3]) :
		       (r_fp_iss_uop.imm[5:4] == 2'd2) ? !r_fp_iss_zero : r_fp_iss_zero;
   wire [63:0] w_fcmov_out = w_fcmov_cond ? w_fp_srcA : w_fp_srcB;
`else
   wire [63:0] w_fcmov_out = 64'd0;
`endif

   fpu #(.LG_PRF_WIDTH(`LG_PRF_ENTRIES),
	 .LG_ROB_WIDTH(`LG_ROB_ENTRIES),
	 .LG_FCR_WIDTH(`LG_FCR_PRF_ENTRIES),
	 .FPU_LAT(`FPU_LAT))
   fpu0(
	.clk(clk),
	.reset(reset),
	.pc(r_fp_iss_uop.pc),
	.opcode(r_fp_iss_uop.op),
	.start(r_fp_iss_valid & ~w_iss_is_sc & ~w_iss_is_ds),   /* converts + sign-ops bypass the fpu (single-cycle path); div/sqrt -> d0 */
	.src_a(w_fp_srcA),
	.src_b(w_fp_srcB),
`ifdef ENABLE_MIPS4
	.src_c(w_fp_srcC),          /* madd fr */
`else
	.src_c({`M_WIDTH{1'b0}}),
`endif
	.src_fcr(r_fp_iss_fcr),
	.rm(r_fcsr[1:0]),   /* FCSR.RM; CTC1 serializes so this is stable per FP op */
	.rob_ptr_in(r_fp_iss_uop.rob_ptr),
	.dst_ptr_in(r_fp_iss_uop.dst),
	.fcr_ptr_in(r_fp_iss_uop.hilo_dst),
	.fcr_sel(r_fp_iss_uop.imm[2:0]),
	.cmp_cond(r_fp_iss_uop.imm[6:3]),   /* C.cond predicate */
	.val(w_fpu_result_valid),
	.cmp_val(w_fpu_fcr_valid),
	.y(w_fpu_result),
	.fflags(w_fpu_fflags),
	.denorm(w_fpu_denorm),
	.rob_ptr_out(w_fpu_rob_ptr),
	.dst_ptr_out(w_fpu_dst_ptr),
	.fcr_ptr_out(w_fpu_fcr_ptr)
	);

   /* single-cycle FP convert: combinational on the issue-stage operand (w_fp_srcA),
    * result registered one cycle -> writes bank0 / completes at pop+2.  TRUNC.W = RZ;
    * CVT.S.W/CVT.D.W use FCSR.RM.  fmt: source-double for f2i, dest-double for i2f. */
   /* TRUNC.W -> RZ; ROUND/CEIL/FLOOR.W -> fixed rm in imm[1:0]; CVT.W -> FCSR.RM
    * (imm[2]).  fmt = source-double (TRUNC_W_D / CVT_W_D). */
   wire w_f2i_src_d = (r_fp_iss_uop.op == TRUNC_W_D) || (r_fp_iss_uop.op == CVT_W_D) ||
		      (r_fp_iss_uop.op == CVT_L_D);
   wire w_f2i_dst_l = (r_fp_iss_uop.op == CVT_L_S) || (r_fp_iss_uop.op == CVT_L_D);
   wire [1:0] w_f2i_rm = ((r_fp_iss_uop.op == TRUNC_W_S) || (r_fp_iss_uop.op == TRUNC_W_D)) ? 2'b01
			 : r_fp_iss_uop.imm[2] ? r_fcsr[1:0]
			 : r_fp_iss_uop.imm[1:0];
   fpu_f2i f2i0(.in(w_fp_srcA),
		.fmt(w_f2i_src_d),
		.dst_long(w_f2i_dst_l),
		.rm(w_f2i_rm),
		.out(w_f2i_out), .fflags(w_f2i_fflags));
   fpu_i2f i2f0(.in(w_fp_srcA),
		.src_long((r_fp_iss_uop.op == CVT_S_L) || (r_fp_iss_uop.op == CVT_D_L)),
		.fmt((r_fp_iss_uop.op == CVT_D_W) || (r_fp_iss_uop.op == CVT_D_L)),
		.rm(r_fcsr[1:0]),
		.out(w_i2f_out), .fflags(w_i2f_fflags));
   /* FP<->FP convert: CVT.D.S widens (to_double=1, exact); CVT.S.D narrows (rounds
    * per FCSR.RM, E-trap via denorm on underflow / denorm operand). */
   fpu_f2f f2f0(.in(w_fp_srcA),
		.to_double(r_fp_iss_uop.op == CVT_D_S),
		.rm(r_fcsr[1:0]),
		.out(w_f2f_out), .denorm(w_f2f_denorm), .fflags(w_f2f_fflags));
   always_ff@(posedge clk)
     begin
	/* NOT flushed on t_flash_clear: the single-cycle convert in flight must complete
	 * so its r_rob_inflight clears (see r_fp_wb_bitvec note). */
	if(reset)
	  r_cvt_valid <= 1'b0;
	else
	  r_cvt_valid <= r_fp_iss_valid & w_iss_is_sc;
     end
   always_ff@(posedge clk)
     begin
	r_cvt_result <= w_iss_is_fcmov  ? w_fcmov_out :
			w_iss_is_signop ? w_signop_out :
			w_iss_is_f2f    ? w_f2f_out :
			w_iss_is_f2i    ? w_f2i_out : w_i2f_out;
	r_cvt_fflags <= (w_iss_is_signop | w_iss_is_fcmov) ? 5'd0 :
			w_iss_is_f2f    ? w_f2f_fflags :
			w_iss_is_f2i    ? w_f2i_fflags : w_i2f_fflags;
	r_cvt_denorm <= w_iss_is_f2f ? w_f2f_denorm : 1'b0;
	r_cvt_dst    <= r_fp_iss_uop.dst;
	r_cvt_rob    <= r_fp_iss_uop.rob_ptr;
     end

   /* FP exception: the single FP completion this cycle (fpu OR convert -- bitvec
    * mutually-exclusive) carries {denorm, fflags}.  An op FAULTS (R4000 FPE,
    * ExcCode 15) iff denorm (Unimplemented E, always) OR an enabled IEEE flag
    * (fflags & FCSR.Enable[11:7]).  Routed via complete_bundle_2.faulted -> the
    * ROB is_fpe bit -> ARCH_FAULT.  (convert raises no denorm.) */
   wire [4:0] w_fp_cmpl_fflags = w_fdiv_complete ? w_fdiv_fflags : (w_fpu_result_valid | w_fpu_fcr_valid) ? w_fpu_fflags : r_cvt_fflags;
   wire       w_fp_cmpl_denorm = w_fdiv_complete ? w_fdiv_denorm : (w_fpu_result_valid | w_fpu_fcr_valid) ? w_fpu_denorm : r_cvt_denorm;
   wire       w_fp_fault = w_fp_cmpl_denorm | (|(w_fp_cmpl_fflags & r_fcsr[11:7]));

   // ---- FCR PRF: inflight tracking + write ----
   always_comb
     begin
	n_fcr_prf_inflight = r_fcr_prf_inflight;
	if(uq_push && uq_uop.fcr_dst_valid)
	  n_fcr_prf_inflight[uq_uop.hilo_dst] = 1'b1;
	if(uq_push_two && uq_uop_two.fcr_dst_valid)
	  n_fcr_prf_inflight[uq_uop_two.hilo_dst] = 1'b1;
	if(w_fpu_fcr_valid)
	  n_fcr_prf_inflight[w_fpu_fcr_ptr] = 1'b0;
	/* CTC1 produces an FCR value from the INT pipe and must clear its own
	 * inflight bit, or every later FCR reader waits for an FP completion
	 * that never comes. */
	if(r_start_int & t_wr_fcsr)
	  n_fcr_prf_inflight[int_uop.hilo_dst] = 1'b0;
     end
   always_ff@(posedge clk)
     begin
	if(reset || t_flash_clear)
	  r_fcr_prf_inflight <= 'd0;
	else
	  r_fcr_prf_inflight <= ds_done ? 'd0 : n_fcr_prf_inflight;
     end
   always_ff@(posedge clk)
     begin
	if(reset)
	  begin
	     for(integer i = 0; i < N_FCR_PRF_ENTRIES; i = i + 1)
	       r_fcr_prf[i] <= 8'd0;
	  end
	else if(w_fpu_fcr_valid)
	  r_fcr_prf[w_fpu_fcr_ptr] <= w_fpu_result[7:0];
	else if(r_start_int & t_wr_fcsr)
	  r_fcr_prf[int_uop.hilo_dst] <= {t_srcA[31:25], t_srcA[23]};
     end

   // ---- FP completion -> ROB port 2 ----
   always_ff@(posedge clk)
     begin
	if(reset)
	  complete_valid_2 <= 1'b0;
	else
	  /* NOT gated by !ds_done: an in-flight FP op must be allowed to COMPLETE during
	   * EXCEPTION_DRAIN (ds_done held high the whole drain) so it clears its
	   * r_rob_inflight bit -- otherwise the drain's r_rob_inflight==0 exit never fires
	   * and the machine deadlocks.  Matches mipscore (FP complete has no ds_done gate). */
	  complete_valid_2 <= (w_fpu_result_valid || w_fpu_fcr_valid || r_cvt_valid || w_fdiv_complete);
     end
   always_ff@(posedge clk)
     begin
	/* port-2 source mux: fpu arith/compare, else the single-cycle convert.
	 * r_fp_wb_bitvec guarantees these never assert in the same cycle. */
	complete_bundle_2.rob_ptr <= w_fdiv_complete ? w_fdiv_rob_ptr : (w_fpu_result_valid || w_fpu_fcr_valid) ? w_fpu_rob_ptr : r_cvt_rob;
	complete_bundle_2.complete <= 1'b1;
	complete_bundle_2.faulted <= w_fp_fault;   /* FP exception (denorm/enabled IEEE) -> is_fpe -> ExcCode 15 */
	complete_bundle_2.restart_pc <= 'd0;
	complete_bundle_2.is_ii <= 1'b0;
	complete_bundle_2.take_br <= 1'b0;
	complete_bundle_2.overflow <= 1'b0;
	complete_bundle_2.trap <= 1'b0;
	complete_bundle_2.fp_flags <= {w_fp_cmpl_denorm, w_fp_cmpl_fflags};
	complete_bundle_2.data <= w_fdiv_complete ? w_fdiv_y : (w_fpu_result_valid || w_fpu_fcr_valid) ? w_fpu_result : r_cvt_result;
	complete_bundle_2.fwd_sel <= 2'b00;   /* FP/convert port: no int srcA mux */
	complete_bundle_2.fwd_selB <= 2'b00;
	complete_bundle_2.srcB_val <= 32'd0;
	complete_bundle_2.hi_nzA <= 1'b0;
	complete_bundle_2.hi_nzB <= 1'b0;
     end

   always_comb
     begin
	n_hilo_inflight = r_hilo_inflight;
	if(uq_push && uq_uop.hilo_dst_valid)
	  begin
	     n_hilo_inflight[uq_uop.hilo_dst] = 1'b1;
	  end
	
	if(uq_push_two && uq_uop_two.hilo_dst_valid)
	  begin
	     n_hilo_inflight[uq_uop_two.hilo_dst] = 1'b1;
	  end
	
	if(t_hilo_prf_ptr_val_out)
	  begin
	     n_hilo_inflight[t_hilo_prf_ptr_out] = 1'b0;
	  end
	if(t_div_complete)
	  begin
	     n_hilo_inflight[t_div_hilo_prf_ptr_out] = 1'b0;
	  end
	if(r_start_int && t_wr_hilo)
	  begin
	     n_hilo_inflight[int_uop.hilo_dst] = 1'b0;
	  end

     end // always_comb
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
