dsheffie/r9999/l1d.sv

`include "machine.vh"
`include "rob.vh"
`include "uop.vh"
// EXPERIMENT: fence mapped cached loads to ROB-head (non-speculative) -- read-path
// DMA coherence (stale INQUIRY-buffer reads).  Comment out to disable.
//`define ENABLE_KERNEL_LOAD_FENCE 1
// EXPERIMENT (speculation-off test): gate EVERY cached mem request (loads AND
// stores, mapped or kseg0) on being at the ROB head / its committable delay slot,
// so nothing accesses the L1D speculatively -> no speculative fill of a DMA buffer
// (the R10000-class non-coherent-DMA hazard).  Very slow (serializes memory), a
// correctness knob to prove the speculation root cause on silicon.
//`define ENABLE_MEM_HEAD_SERIALIZE 1

//`define VERBOSE_L1D 1

`ifdef VERILATOR
import "DPI-C" function void record_l1d(input int req, 
					input int ack,
					input int ack_st,
					input int block,
					input int stall_reason);
`endif

`ifdef ENABLE_STORE_CHECK
// Co-sim store-check (forward-ported from rv64core l1d.sv across the shared MIPS
// ancestor): report each committed store-write so henry_tb can compare vs the golden
// ISS store stream.  Gated by ENABLE_STORE_CHECK (henry_tb only) -- r9999's own
// ooo_core Verilator build never sees it.
import "DPI-C" function void wr_log(input longint pc, input int rob_ptr,
				    input longint unsigned addr,
				    input longint unsigned data, int is_atomic);
// L1D->L2 writeback watch: report each dirty-line writeback so henry_tb can tell whether
// the L1D hands L2 a clean or already-corrupted cache line (vs the L2->DRAM store DESCWATCH sees).
import "DPI-C" function void l1d_wb_log(input longint unsigned pa,
					input longint unsigned data_lo,
					input longint unsigned data_hi);
// IRIX o32 .data stale-load debug: fill-cycle map + bcopy-load read trace.  rd_log = a
// committed load's pc/pa/data/hit; l1d_fill_log = a line fill (pa+data) so henry_tb can
// record WHEN each line was last loaded; l1d_cacheop_log = a CACHE-op invalidate (pa).
// Together they timeline the source line: filled-before-DMA (speculative refill) vs a
// never-invalidated stale line (incomplete CACHE-inval).
import "DPI-C" function void rd_log(input longint pc, input longint unsigned addr,
				    input longint unsigned data, input int hit);
// L1D line-lifecycle trace: l1d_fill records WHICH instruction (pc) at WHICH cycle brought
// a line into the L1D (fill); l1d_cacheop records a CACHE-op invalidate/writeback hitting a
// line (pc = the CACHE-op instruction if known, else 0).  henry_tb correlates: a line filled
// (speculatively?) and never CACHE-op'd before a DMA overwrote DRAM = the stale-read bug.
import "DPI-C" function void l1d_fill(input longint unsigned cycle, input longint pc,
				      input longint unsigned pa,
				      input longint unsigned data_lo, input longint unsigned data_hi);
import "DPI-C" function void l1d_cacheop(input longint unsigned cycle, input longint pc,
					 input longint unsigned pa, input int inval);
// dirty-set-drop watch: fires when a store commit (t_wr_array, wants dirty=1) coincides with a
// dirty-CLEAR event (refill or invalidate, which win the single dc_dirty write port) -> the
// store's dirty=1 is DROPPED -> the line looks clean -> evicted with no writeback.  by_refill
// distinguishes the refill-clear (1) from the invalidate-clear (0).
import "DPI-C" function void dirtydrop(input longint unsigned cycle, input longint pc,
				      input longint unsigned pa, input int by_refill);
`endif

module l1d(clk,
`ifdef FORMAL_DPRELOAD
	   fml_pre_tag,
	   fml_pre_data,
`endif
	   reset,
	   asid,
	   tlb_entry_in,
	   tlb_entry_in_valid,
	   state,
	   in_kernel_mode,
	   in_supervisor_mode,
	   in_user_mode,
	   head_of_rob_ptr,
	   head_of_rob_ptr_valid,
	   head_of_rob_has_delay_slot,
	   next_head_of_rob_ptr,
	   head_of_rob_ds_committable,
	   retired_rob_ptr_valid,
	   retired_rob_ptr_two_valid,
	   retired_rob_ptr,
	   retired_rob_ptr_two,
	   restart_valid,
	   clr_link_reg,
	   memq_empty,
	   dbg_rob_inflight,
	   drain_ds_complete,
	   dead_rob_mask,
	   flush_req,
	   flush_complete,
	   flush_cl_req,
	   flush_cl_addr,
	   flush_cl_inval,
	   dma_inval_req,
	   dma_inval_addr,
	   dma_inval_ack,
	   probe_req,
	   probe_addr,
	   probe_colour,
	   probe_ack,
	   probe_dirty,
	   probe_data,
	   flush_pg_req,
	   pg_drop_dirty_cnt,
	   //inputs from core
	   core_mem_req_valid,
	   core_mem_req,
	   //store data (and lwl/lwr data)
	   //outputs to core
	   core_mem_req_ack,
	   core_mem_rsp,
	   core_mem_rsp_valid,
	   core_mem_blk_valid,
	   core_mem_wake_valid,
	   core_mem_st_done_valid,
	   core_mem_st_done_idx,
	   lsu_sb,
	   restart_color,
	   mem_color_busy,
	   mem_quiet,
	   //output to the memory system
	   mem_req_ack,
	   mem_req_valid, 
	   mem_req_addr, 
	   mem_req_colour,
	   mem_req_store_data, 
	   mem_req_opcode,
	   mem_req_cacheable,
	   mem_req_mask,
	   //reply from memory system
	   mem_rsp_valid,
	   mem_rsp_load_data,
	   mem_rsp_bad,
	   cache_accesses,
	   cache_hits
	   );

   localparam L1D_NUM_SETS = 1 << `LG_L1D_NUM_SETS;
   localparam L1D_CL_LEN = 1 << `LG_L1D_CL_LEN;
   localparam L1D_CL_LEN_BITS = 1 << (`LG_L1D_CL_LEN + 3);
   
   input logic clk;
   input logic reset;
   input logic [7:0] asid;
   input	     tlb_data_t tlb_entry_in;
   input logic	     tlb_entry_in_valid;
   
   output logic [3:0] state;
   input logic			in_kernel_mode;
   input logic			in_supervisor_mode;
   input logic			in_user_mode;


   input logic [`LG_ROB_ENTRIES-1:0] head_of_rob_ptr;
   input logic 			     head_of_rob_ptr_valid;
   input logic			     head_of_rob_has_delay_slot;
   input logic [`LG_ROB_ENTRIES-1:0] next_head_of_rob_ptr;
   input logic			     head_of_rob_ds_committable;
   
   input logic retired_rob_ptr_valid;
   input logic retired_rob_ptr_two_valid;
   input logic [`LG_ROB_ENTRIES-1:0] retired_rob_ptr;
   input logic [`LG_ROB_ENTRIES-1:0] retired_rob_ptr_two;
   input logic 			     restart_valid;
   input logic			     clr_link_reg;
   output logic			     memq_empty;
   output logic [N_ROB_ENTRIES-1:0] dbg_rob_inflight;
   input logic 			     drain_ds_complete;
   input logic [(1<<`LG_ROB_ENTRIES)-1:0] dead_rob_mask;
   
   
   input logic flush_cl_req;
   input logic [`M_WIDTH-1:0] flush_cl_addr;
   input logic 		      flush_cl_inval;
   /* DMA-completion invalidate: a SECOND requester into the same per-line
    * invalidate machinery, independent of the CPU's CACHE-op handshake so the
    * core never stalls on it.  One 16B line per request; the SoC-side walker
    * steps the range and holds dma_inval_addr stable until dma_inval_ack.
    * Always drop-without-writeback (software already invalidated pre-DMA, so a
    * line present here is a clean speculative refill -- writing it back would
    * stomp the DMA'd data). */
   input logic 		      dma_inval_req;
   input logic [`PA_WIDTH-1:0] dma_inval_addr;
   output logic 	      dma_inval_ack;
   /* inclusive-l2-v2 stage B: back-invalidate probe from the L2, which is evicting a line
    * the L1D may hold on behalf of an L1I miss.  The L2 holds probe_req/probe_addr until
    * probe_ack (a 1-cycle pulse); r_prb_seen keeps one held request from being answered
    * twice and clears when probe_req drops.  The probe is taken from ACTIVE or from any
    * state that is only waiting on the L2 -- never dependent on the L1D's own request
    * (rule R2 of INCLUSIVE_L2_PROTOCOL.md).  Hit: the line is invalidated and returned
    * (probe_dirty, probe_data) if dirty. */
   input logic 		      probe_req;
   input logic [`PA_WIDTH-1:0] probe_addr;
   input logic [`L1D_N_COLOUR-1:0] probe_colour;   /* stage C2: the set colour to probe (L2 pidx) */
   output logic 	      probe_ack;
   output logic 	      probe_dirty;
   output logic [127:0]       probe_data;
   /* injected page op (XPG_WBINV / XPG_INV): walk the page's lines at flush_cl_addr
    * (page-aligned PA, held by the core like the CACHE-op address), flush_cl_inval =
    * drop (XPG_INV).  Per line, L1D then L2 -- the core is drained at the ROB head, so
    * the order is free (formal/murphi/r9999_pagewalk.m):
    *   WBINV: L1D dirty hit -> MEM_WB (to DRAM, L2 copy dropped); otherwise invalidate
    *          an L1D hit and MEM_INVL (L2 writes back if dirty, then drops).
    *   INV:   invalidate an L1D hit, MEM_PGDROP (L2 drops without writeback).
    * One flush_complete pulse at the end of the page. */
   input logic 		      flush_pg_req;
   /* dirty lines found by XPG_INV walks (L1D + L2): a correctly cleaned page has none,
    * so any nonzero count is a coherence bug (saturating). */
   output logic [15:0] 	      pg_drop_dirty_cnt;
   input logic 		      flush_req;
   output logic 	      flush_complete;

   input logic core_mem_req_valid;
   input       mem_req_t core_mem_req;

   
   output logic core_mem_req_ack;
   output 	mem_rsp_t core_mem_rsp;
   output logic core_mem_rsp_valid;
   /* LSU replay: a simple load (lsu_hold) that cannot complete on its port-2 pass
    * returns a block code (core_mem_rsp.blk) instead of waiting in the l1d; its
    * miss-queue entry still reloads the line, and the port-1 pass then sends a
    * wakeup (core_mem_rsp.lsu_idx) instead of the data.  The LSU re-issues it. */
   output logic core_mem_blk_valid;
   output logic core_mem_wake_valid;
   /* a plain-store commit has been written (cache or device): free its LSU slot */
   output logic core_mem_st_done_valid;
   output logic [`LG_MEM_SCHED_ENTRIES-1:0] core_mem_st_done_idx;
   input 	lsu_sb_t lsu_sb;
   /* restart color: a request / queued op / response of the other color belongs
    * to a flushed era (commits exempt) -- dropped instead of drained */
   input logic	restart_color;
   /* an op of color c is still in flight here (the core's flip-back guard) */
   output logic [1:0] mem_color_busy;
   output logic       mem_quiet;       /* nothing accepted is still being worked on */

   input logic 	mem_req_ack;
   
   output logic mem_req_valid;
   output logic [(`PA_WIDTH-1):0] mem_req_addr;
   output logic [`L1D_N_COLOUR-1:0] mem_req_colour;   /* stage C2: the colour of the set this line lives at */
   output logic [L1D_CL_LEN_BITS-1:0] mem_req_store_data;
   output logic [5:0] 			  mem_req_opcode;
   output logic				  mem_req_cacheable;
   output logic [15:0]			  mem_req_mask;
   
   input logic 				  mem_rsp_valid;
   input logic [L1D_CL_LEN_BITS-1:0] 	  mem_rsp_load_data;
   input logic 				  mem_rsp_bad;        /* uncached load answered with a bus error */

   
   output logic [63:0] 			 cache_accesses;
   output logic [63:0] 			 cache_hits;

         
   localparam LG_WORDS_PER_CL = `LG_L1D_CL_LEN - 2;
   localparam LG_DWORDS_PER_CL = `LG_L1D_CL_LEN - 3;
   
   localparam WORDS_PER_CL = 1<<(LG_WORDS_PER_CL);
   /* Tag is taken down to LG_PG_SZ (not IDX_STOP) so it INCLUDES the alias bits
    * -- the index bits above the page offset (VIPT synonym bits).  At <=page-size
    * (4KB: IDX_STOP==LG_PG_SZ) this is identical to the old tag.  When the L1D is
    * larger than a page (8KB: IDX_STOP>LG_PG_SZ), including PA[12..] in the tag is
    * what lets the speculatively-VA-indexed port-2 read detect an alias as a tag
    * miss; it then replays through the (already physical) miss-queue retry, which
    * re-indexes with the physical address -> no synonym/duplicate lines can form.
    * (rv64core nu_l1d scheme; see machine.vh LG_L1D_NUM_SETS.) */
   localparam IDX_START = `LG_L1D_CL_LEN;
   localparam IDX_STOP  = `LG_L1D_CL_LEN + `LG_L1D_NUM_SETS;
   /* TAG_LSB = min(LG_PG_SZ, IDX_STOP).  For cache >= page the tag is still taken down to
    * LG_PG_SZ (carries the VIPT alias bits, unchanged).  For a SUB-page cache
    * (IDX_STOP < LG_PG_SZ) it extends down to IDX_STOP so PA[IDX_STOP..LG_PG_SZ-1] stays
    * tagged (no aliasing) and {tag,idx,offset} reconstructs the full PA_WIDTH address. */
   localparam TAG_LSB = (IDX_STOP < `LG_PG_SZ) ? IDX_STOP : `LG_PG_SZ;
   localparam LG_ALIAS_BITS = IDX_STOP - TAG_LSB;   // == max(0, IDX_STOP - LG_PG_SZ)
   localparam N_TAG_BITS = `PA_WIDTH - TAG_LSB;
`ifdef FORMAL_DPRELOAD
   /* FORMAL PRELOAD (d-side).  The flush walk normally writes valid=0 to every
    * set; here it writes valid=1 and fills tag/data from these FREE inputs, so a
    * load HITS immediately instead of needing a DRAM round trip.  Two payoffs:
    *  (1) REACHABILITY -- no fill latency, so interesting states arrive in a
    *      handful of cycles instead of the ~30 the DIVA controls needed.
    *  (2) It makes `dst_valid` LIVE.  The response only carries dst_valid on a
    *      CACHE-HIT reply (t_rsp_dst_valid2 = r_req2.dst_valid & t_hit_cache2),
    *      and a harness that cannot manufacture a hit leaves every response-field
    *      control CONSTANT-0 -- which is exactly why formal_l1d_rsp's c_dstv /
    *      c_ptr / c_rob / c_dat are all dead and its bad_p0 "proof" is vacuous.
    * These MUST be real ports, not undriven nets: the build does `setundef -zero`,
    * which would silently tie them to 0 (the phantom mem_req_ack trap).
    * OVER-APPROXIMATION: a free tag lets a line claim any address, so this admits
    * cache states no real fill sequence produces.  UNSAT is therefore sound; a SAT
    * counterexample must be checked for realizability before it is believed. */
   input logic [N_TAG_BITS-1:0]      fml_pre_tag;
   input logic [L1D_CL_LEN_BITS-1:0] fml_pre_data;
   /* INIT_CACHE is the RESET walk (INITIALIZE -> INIT_CACHE -> ACTIVE) and needs no
    * flush_req, so the preload happens automatically out of reset.  FLUSH_CACHE is
    * included so an explicit flush re-preloads rather than emptying the cache. */
   wire w_dpreload = ((r_state == INIT_CACHE) | (r_state == FLUSH_CACHE)) & t_mark_invalid;
`endif
   localparam WORD_START = 2;
   localparam WORD_STOP = WORD_START+LG_WORDS_PER_CL;
   localparam DWORD_START = 3;
   localparam DWORD_STOP = DWORD_START + LG_DWORDS_PER_CL;
  
   localparam N_MQ_ENTRIES = (1<<`LG_MRQ_ENTRIES);

   function logic [15:0] make_mask(mem_req_t r);
      logic [15:0]		  t_m, m;
      logic			  b,s,w,d;
      logic			  lwl_lwr, swl_swr;
      logic [3:0]		  swl, swr;

      swr = r.addr[1:0] == 'd0 ? 4'b0001 :
	    r.addr[1:0] == 'd1 ? 4'b0011 :
	    r.addr[1:0] == 'd2 ? 4'b0111 :
	    4'b1111;

      swl = r.addr[1:0] == 'd3 ? 4'b1000 :
	    r.addr[1:0] == 'd2 ? 4'b1100 :
	    r.addr[1:0] == 'd1 ? 4'b1110 :
	    4'b1111;        // BE swl at word-aligned EA stores all 4 bytes (was 4'b0000 = no-op)
            
      
      swl_swr = (r.op == MEM_SWR | r.op == MEM_SWL);
      lwl_lwr = (r.op == MEM_LWR | r.op == MEM_LWL);
      if(r.op == MEM_LDL || r.op == MEM_LDR || r.op == MEM_SDL || r.op == MEM_SDR ||
         r.op == MEM_LLD || r.op == MEM_SCD || r.op == MEM_LD || r.op == MEM_SD)
	return 16'hff << {r.addr[DWORD_START], 3'b0};

      b = 	(r.op == MEM_SB | r.op == MEM_LB | r.op == MEM_LBU);
      s = 	(r.op == MEM_SH | r.op == MEM_LH | r.op == MEM_LHU);
      w = 	(r.op == MEM_SW | r.op == MEM_LW | r.op == MEM_LL | r.op == MEM_SC | lwl_lwr);
      
      t_m = b ? 16'h0001 :
	    s ? 16'h0003 :
	    w ? 16'h000f :
	    (r.op == MEM_SWL) ? {12'd0, swl} :
	    (r.op == MEM_SWR) ? {12'd0, swr} :
	    16'hffff;
      
      m = t_m << ((lwl_lwr | swl_swr) ? {r.addr[3:2], 2'd0} : r.addr[3:0]);      
      return m;
   endfunction
         
   /* byte mask an UNCACHED store sends to memory.  make_mask gives SDL/SDR the whole
    * doubleword (fine for the cached merge, the store-buffer overlap checks and the MQ),
    * but an uncached store's line is merged onto r_array_out -- the cached line that
    * happens to sit at that index -- so every byte under the mask reaches memory.
    * SDL/SDR must cover only their own bytes (big-endian: SDL k..7, SDR 0..k), or the
    * unrelated line's bytes land in memory (IRIX 5.3's bcopy/blkclr on kseg1 directory
    * buffers: /tmp got the in-core superblock's bytes). */
   function logic [15:0] unc_st_mask(mem_req_t r);
      if(r.op == MEM_SDL)
	return {8'd0, 8'hff << r.addr[2:0]} << {r.addr[DWORD_START], 3'b0};
      if(r.op == MEM_SDR)
	return {8'd0, 8'hff >> (3'd7 - r.addr[2:0])} << {r.addr[DWORD_START], 3'b0};
      return make_mask(r);
   endfunction

function logic [L1D_CL_LEN_BITS-1:0] merge_cl32(logic [L1D_CL_LEN_BITS-1:0] cl, logic [31:0] w32, logic[LG_WORDS_PER_CL-1:0] pos);
   logic [L1D_CL_LEN_BITS-1:0] 		 cl_out;
   case(pos)
     2'd0:
       cl_out = {cl[127:32], w32};
     2'd1:
       cl_out = {cl[127:64], w32, cl[31:0]};
     2'd2:
       cl_out = {cl[127:96], w32, cl[63:0]};
     2'd3:
       cl_out = {w32, cl[95:0]};
   endcase // case (pos)
   return cl_out;
endfunction

function logic [31:0] select_cl32(logic [L1D_CL_LEN_BITS-1:0] cl, logic[LG_WORDS_PER_CL-1:0] pos);
   logic [31:0] 			 w32;
   case(pos)
     2'd0:
       w32 = cl[31:0];
     2'd1:
       w32 = cl[63:32];
     2'd2:
       w32 = cl[95:64];
     2'd3:
       w32 = cl[127:96];
   endcase // case (pos)
   return w32;
endfunction

function logic [63:0] bswap64(logic [63:0] x);
   return {x[7:0],x[15:8],x[23:16],x[31:24],x[39:32],x[47:40],x[55:48],x[63:56]};
endfunction

function logic [L1D_CL_LEN_BITS-1:0] merge_cl64(logic [L1D_CL_LEN_BITS-1:0] cl, logic [63:0] w64, logic [LG_DWORDS_PER_CL-1:0] pos);
   logic [L1D_CL_LEN_BITS-1:0] cl_out;
   case(pos)
     1'd0:
       cl_out = {cl[127:64], w64};
     1'd1:
       cl_out = {w64, cl[63:0]};
   endcase
   return cl_out;
endfunction

function logic [63:0] select_cl64(logic [L1D_CL_LEN_BITS-1:0] cl, logic [LG_DWORDS_PER_CL-1:0] pos);
   logic [63:0] w64;
   case(pos)
     1'd0:
       w64 = cl[63:0];
     1'd1:
       w64 = cl[127:64];
   endcase
   return w64;
endfunction
   
   logic 				  r_got_req, r_last_wr, n_last_wr;
   logic 				  r_last_rd, n_last_rd;
   logic 				  r_got_req2, r_last_wr2, n_last_wr2;
   logic 				  r_last_rd2, n_last_rd2;
   
   logic 				  rr_got_req, rr_last_wr, rr_is_retry, rr_did_reload;

   logic 				  r_lock_cache, n_lock_cache;
   
   logic [`LG_MRQ_ENTRIES:0] 		  r_n_inflight;   


   
   //1st read port
   logic [`LG_L1D_NUM_SETS-1:0] 	  t_cache_idx, r_cache_idx, rr_cache_idx;
   logic [N_TAG_BITS-1:0] 		  t_cache_tag, r_cache_tag, r_tag_out;
   logic [N_TAG_BITS-1:0] 		  rr_cache_tag;
   /* PA of the line read out on port 1 (writeback / invalidate address).  The tag
    * carries the alias bits (PA above the page offset), so only the in-page index bits
    * come from r_cache_idx: the line's PA no longer depends on WHERE it is stored,
    * which is what lets stage C store lines at their VA index. */
   localparam IDX_IN_PG = TAG_LSB - IDX_START;
   wire [`PA_WIDTH-1:0] 		  w_line_pa = {r_tag_out, r_cache_idx[IDX_IN_PG-1:0], {`LG_L1D_CL_LEN{1'b0}}};
   /* the in-page part of a set index; the bits above it are the set's colour */
   localparam [`LG_L1D_NUM_SETS-1:0] IDX_PG_MASK = (1 << IDX_IN_PG) - 1;
   localparam N_COLOUR = `L1D_N_COLOUR;
   logic 				  r_valid_out, r_dirty_out;
   logic [L1D_CL_LEN_BITS-1:0] 		  r_array_out, t_data, t_data2;
   
   //2nd read port
   logic [`LG_L1D_NUM_SETS-1:0] 	  t_cache_idx2, r_cache_idx2;
   logic [N_TAG_BITS-1:0] 		  t_cache_tag2, r_cache_tag2, r_tag_out2;
   logic 				  r_valid_out2, r_dirty_out2;
   logic [L1D_CL_LEN_BITS-1:0] 		  r_array_out2;
   
   
   logic [`LG_L1D_NUM_SETS-1:0] 	  t_miss_idx, r_miss_idx;
   logic [`M_WIDTH-1:0] 		  t_miss_addr, r_miss_addr;

   //write port   
   logic [`LG_L1D_NUM_SETS-1:0] 	  t_array_wr_addr;
   logic [L1D_CL_LEN_BITS-1:0] 		  t_array_wr_data, r_array_wr_data;

   logic 				  t_array_wr_en;
		  

   logic 				  r_flush_req, n_flush_req;
   logic 				  r_flush_cl_req, n_flush_cl_req;
   logic 				  r_dma_inval_req, n_dma_inval_req;
   logic 				  r_dma_inval_ack, n_dma_inval_ack;
   logic 				  r_cl_is_dma, n_cl_is_dma;   /* owner of the in-flight FLUSH_CL */
   logic 				  r_flush_pg_req, n_flush_pg_req;
   localparam LG_PG_LINES = `LG_PG_SZ - `LG_L1D_CL_LEN;
   logic [LG_PG_LINES-1:0] 		  r_pg_off, n_pg_off;
   logic [15:0] 			  r_pg_dirty_cnt, n_pg_dirty_cnt;
   assign pg_drop_dirty_cnt = r_pg_dirty_cnt;
   wire [`PA_WIDTH-1:0] 		  w_pg_line = {flush_cl_addr[`PA_WIDTH-1:`LG_PG_SZ], r_pg_off, {`LG_L1D_CL_LEN{1'b0}}};
   wire [`PA_WIDTH-1:0] 		  w_pg_line_nxt = {flush_cl_addr[`PA_WIDTH-1:`LG_PG_SZ], r_pg_off + 1'b1, {`LG_L1D_CL_LEN{1'b0}}};
   wire [`PA_WIDTH-1:0] 		  w_pg_line0 = {flush_cl_addr[`PA_WIDTH-1:`LG_PG_SZ], {`LG_PG_SZ{1'b0}}};
   wire 				  w_pg_hit = r_valid_out & (r_tag_out == w_pg_line[`PA_WIDTH-1:TAG_LSB]);
   assign dma_inval_ack = r_dma_inval_ack;
   /* arbitrated line address/op: the CPU CACHE-op wins; DMA is always invalidate */
   wire [`M_WIDTH-1:0] 			  w_cl_addr  = r_cl_is_dma ? {{(`M_WIDTH-`PA_WIDTH){1'b0}}, dma_inval_addr} : flush_cl_addr;
   wire 				  w_cl_inval = r_cl_is_dma ? 1'b1 : flush_cl_inval;
   logic 				  r_flush_complete, n_flush_complete;
   

   logic [31:0] 			  t_array_out_b32[WORDS_PER_CL-1:0];
   logic [31:0] 			  t_w32, t_bswap_w32;
   logic [31:0] 			  t_w32_2, t_bswap_w32_2;

   logic 				  t_got_rd_retry, t_port2_hit_cache;
`ifdef L1D_PORT2_ALWAYS_MISS
   wire 				  w_p2_force_miss = 1'b1;
`else
   wire 				  w_p2_force_miss = 1'b0;
`endif
      
   logic 				  t_mark_invalid;
   logic 				  t_wr_array;
   logic 				  t_hit_cache;
   logic 				  t_rsp_dst_valid;
   logic 				  t_rsp_fp_dst_valid;
   logic [63:0] 			  t_rsp_data;
   
   logic 				  t_hit_cache2;
   logic 				  t_rsp_dst_valid2;
   logic 				  t_rsp_fp_dst_valid2;
   logic [63:0] 			  t_rsp_data2;


   
   logic [L1D_CL_LEN_BITS-1:0] 		  t_array_data;
   
   logic [`M_WIDTH-1:0] 		  t_addr;
   logic 				  t_got_req, t_got_req2;
   logic 				  t_got_miss;
   logic 				  t_push_miss;
   
   logic 				  t_mh_block, t_cm_block, t_cm_block2,
					  t_cm_block_stall;

   logic 				  r_must_forward, r_must_forward2;
      
   logic 				  n_inhibit_write, r_inhibit_write;
   logic 				  t_got_non_mem, r_got_non_mem;

   logic 				  t_ucld_dead_drop;
      
   logic 				  n_is_retry, r_is_retry;
   logic 				  r_q_priority, n_q_priority;
   
   logic 				  n_core_mem_rsp_valid, r_core_mem_rsp_valid;
   logic 				  n_core_mem_blk_valid, r_core_mem_blk_valid;
   logic 				  n_core_mem_wake_valid, r_core_mem_wake_valid;
   logic 				  n_core_mem_st_done_valid, r_core_mem_st_done_valid;
   logic [`LG_MEM_SCHED_ENTRIES-1:0] 	  n_core_mem_st_done_idx, r_core_mem_st_done_idx;
   mem_rsp_t n_core_mem_rsp, r_core_mem_rsp;

   wire [5:0] w_tlb_index;
   wire        w_tlb_dirty;
   wire        w_tlb_valid;
   wire [2:0]  w_tlb_c;     /* dtlb: matched page cacheability (EntryLo C/CCA) */
   wire	      w_tlb_hit;
   wire	      w_tlb_oor;   /* dtlb: matched entry's PFN exceeds MAX_PA(36b) -> Addr Error */

      
   mem_req_t n_req, r_req, t_req;
   mem_req_t n_req2, r_req2;

   mem_req_t r_mem_q[N_MQ_ENTRIES-1:0];
   logic [`LG_MRQ_ENTRIES:0] r_mq_head_ptr, n_mq_head_ptr;
   logic [`LG_MRQ_ENTRIES:0] r_mq_tail_ptr, n_mq_tail_ptr;
   logic [`LG_MRQ_ENTRIES:0] t_mq_tail_ptr_plus_one;

   
   logic [N_MQ_ENTRIES-1:0] r_mq_addr_valid;
   logic [IDX_STOP-IDX_START-1:0] r_mq_addr[N_MQ_ENTRIES-1:0];
   /* per-MQ-entry byte mask (mirrors rv64core nu_l1d): only STORES carry a mask;
    * loads store 0.  Used to refine the port-2 same-set hazard from set-index-only
    * to set-index AND byte-overlap so disjoint-byte accesses no longer serialize. */
   logic [15:0] 		 r_mq_mask[N_MQ_ENTRIES-1:0];
  
   
   mem_req_t t_mem_tail, t_mem_head;
   logic 	mem_q_full, mem_q_empty, mem_q_almost_full;
   
   typedef enum logic [4:0] {INITIALIZE = 'd0, //0
			     INIT_CACHE = 'd1, //1
			     ACTIVE = 'd2, //2
                             INJECT_RELOAD = 'd3, //3
			     WAIT_INJECT_RELOAD = 'd4, //4
                             FLUSH_CACHE = 'd5, //5
                             FLUSH_CACHE_WAIT = 'd6, //6
			     FLUSH_CACHE_LAST_WAIT = 'd7, //6
                             FLUSH_CL = 'd8,
                             FLUSH_CL_WAIT = 'd9,
                             HANDLE_RELOAD = 'd10,
			     INJECT_UNCACHE_STORE = 'd11,
			     INJECT_UNCACHE_LOAD = 'd12,
			     UNCACHE_WB = 'd13,
			     /* 'd14-'d16 were the 32B "double-beat" CACHE-op states, removed:
			      * a D CACHE op acts on the one 16B block containing its address
			      * (Config DB=0).  Encodings below are kept for trace decoders. */
			     /* injected page op: one line of the page per visit (RAM
			      * outputs are for w_pg_line), then wait for the L2 ack */
			     FLUSH_PG = 'd17,
			     FLUSH_PG_WAIT = 'd18,
			     PROBE_CHK = 'd19
                             } state_t;

   
   state_t r_state, n_state;
   /* stage B probe state */
   logic 		      r_prb_seen, n_prb_seen;
   logic 		      r_prb_ack, n_prb_ack;
   logic 		      r_prb_dirty, n_prb_dirty;
   logic [127:0] 	      r_prb_data, n_prb_data;
   state_t 		      r_prb_ret, n_prb_ret;
   logic [`LG_L1D_NUM_SETS-1:0] r_prb_save, n_prb_save;
   logic [`PA_WIDTH-1:TAG_LSB] r_prb_tag, n_prb_tag;
   logic 		      t_prb_pend, t_prb_ok_state, t_prb_hit;
`ifdef VERILATOR
   /* stage B probe statistics (sim only) */
   logic [63:0] r_dbg_prb, r_dbg_prb_hit, r_dbg_prb_dirty;
   always_ff@(posedge clk)
     begin
	if(reset)
	  begin
	     r_dbg_prb <= 'd0;
	     r_dbg_prb_hit <= 'd0;
	     r_dbg_prb_dirty <= 'd0;
	  end
	else if(r_state == PROBE_CHK)
	  begin
	     r_dbg_prb <= r_dbg_prb + 'd1;
	     r_dbg_prb_hit <= r_dbg_prb_hit + (t_prb_hit ? 'd1 : 'd0);
	     r_dbg_prb_dirty <= r_dbg_prb_dirty + ((t_prb_hit && r_dirty_out) ? 'd1 : 'd0);
	  end
     end
   final
     begin
	$display("[PROBE] L1D probes %0d, hit %0d, dirty %0d", r_dbg_prb, r_dbg_prb_hit, r_dbg_prb_dirty);
     end
`endif
   assign probe_ack = r_prb_ack;
   assign probe_dirty = r_prb_dirty;
   assign probe_data = r_prb_data;
   always_ff@(posedge clk)
     begin
	if(reset)
	  begin
	     r_prb_seen <= 1'b0;
	     r_prb_ack <= 1'b0;
	     r_prb_dirty <= 1'b0;
	     r_prb_data <= 'd0;
	     r_prb_ret <= ACTIVE;
	     r_prb_save <= 'd0;
	     r_prb_tag <= 'd0;
	  end
	else
	  begin
	     r_prb_seen <= n_prb_seen;
	     r_prb_ack <= n_prb_ack;
	     r_prb_dirty <= n_prb_dirty;
	     r_prb_data <= n_prb_data;
	     r_prb_ret <= n_prb_ret;
	     r_prb_save <= n_prb_save;
	     r_prb_tag <= n_prb_tag;
	  end
     end
   logic 	t_pop_mq;
   logic 	n_reload_issue, r_reload_issue;
   logic 	n_did_reload, r_did_reload;
   logic 	n_uncache_wb_dirty, r_uncache_wb_dirty;

   /* debug/trace-only observability port (kept 4b to avoid rippling the width
    * up through core_l1d_l1i/henry_soc/ILA); r_state is 5b, so FLUSH_PG=17 and
    * FLUSH_PG_WAIT=18 alias 1 and 2 in the trace. */
   assign state = r_state[3:0];
   /* both restart colors folded: "this rob slot has an l1d op in flight" */
   assign dbg_rob_inflight = r_rob_inflight[N_ROB_ENTRIES-1:0] | r_rob_inflight[2*N_ROB_ENTRIES-1:N_ROB_ENTRIES];
   
   logic	r_mem_req_cacheable, n_mem_req_cacheable;
   logic [15:0]	t_mem_req_mask, r_mem_req_mask, n_mem_req_mask;
   
   logic	r_mem_req_valid, n_mem_req_valid;
   logic [(`PA_WIDTH-1):0] r_mem_req_addr, n_mem_req_addr;
   /* stage C2: the L1D set a request's line lives in travels WITH the request
    * (port 2 -> MQ -> r_req -> fill), instead of being re-derived from the PA.
    * C2a: always the PA index (cycle-identical); C2b: the VA index. */
   logic [`LG_L1D_NUM_SETS-1:0] r_mem_req_idx, n_mem_req_idx;   /* the fill's set */
   logic [`LG_L1D_NUM_SETS-1:0] r_req_idx, n_req_idx;           /* r_req's set */
   logic [`LG_L1D_NUM_SETS-1:0] t_req2_idx;                     /* r_req2's set */
   logic [`LG_L1D_NUM_SETS-1:0] t_mq_push_idx;
   logic [L1D_CL_LEN_BITS-1:0] r_mem_req_store_data, n_mem_req_store_data;
   
   logic [5:0] 		       r_mem_req_opcode, n_mem_req_opcode;
   logic [63:0] 	       n_cache_accesses, r_cache_accesses;
   logic [63:0] 	       n_cache_hits, r_cache_hits;

   wire [`PA_WIDTH-1:0]      w_mapped_addr;
   /* port-2 tag is the TLB-TRANSLATED physical tag (w_mapped_addr), not the VA
    * tag (r_cache_tag2).  For unmapped accesses w_mapped_addr == va (1:1) so this
    * is equivalent; for mapped accesses it is the real physical tag.  Aligned
    * with r_tag_out2/r_req2 (both clocked off the same port-2 request). */
   wire [N_TAG_BITS-1:0]     w_tlb_tag2 = w_mapped_addr[`PA_WIDTH-1:TAG_LSB];
   
   
   logic [31:0] 			 r_cycle;
   assign flush_complete = r_flush_complete;
   assign mem_req_addr = r_mem_req_addr;
   assign mem_req_colour = N_COLOUR'(r_mem_req_idx >> IDX_IN_PG);
   assign mem_req_store_data = r_mem_req_store_data;
   assign mem_req_opcode = r_mem_req_opcode;
   assign mem_req_valid = r_mem_req_valid;
   assign mem_req_cacheable = r_mem_req_cacheable;
   assign mem_req_mask = r_mem_req_mask;

   /* w_* = the l1d's own view of what it answered (counts every answer);
    * core_mem_* = the same, minus answers for a flushed era (restart color) */
   logic w_rsp_v, w_blk_v, w_wake_v;
   mem_rsp_t w_rsp;
   logic t_req_stale, t_mq_stale_drop, t_mq_stale_owed;
`ifdef REG_L1D_RSP
   /* registered response -- matches rv64core; see REG_L1D_RSP in machine.vh */
   assign w_rsp_v = r_core_mem_rsp_valid;
   assign w_blk_v = r_core_mem_blk_valid;
   assign w_wake_v = r_core_mem_wake_valid;
   assign w_rsp = r_core_mem_rsp;
   assign core_mem_st_done_valid = r_core_mem_st_done_valid;
   assign core_mem_st_done_idx = r_core_mem_st_done_idx;
`else
   assign w_rsp_v = n_core_mem_rsp_valid;
   assign w_blk_v = n_core_mem_blk_valid;
   assign w_wake_v = n_core_mem_wake_valid;
   assign w_rsp = n_core_mem_rsp;
   assign core_mem_st_done_valid = n_core_mem_st_done_valid;
   assign core_mem_st_done_idx = n_core_mem_st_done_idx;
`endif
   wire w_rsp_stale = (w_rsp.restart_id != restart_color);
   assign core_mem_rsp_valid = w_rsp_v & !w_rsp_stale;
   assign core_mem_blk_valid = w_blk_v & !w_rsp_stale;
   assign core_mem_wake_valid = w_wake_v & !w_rsp_stale;
   always_comb
     begin
	core_mem_rsp = w_rsp;
	core_mem_rsp.dst_valid = w_rsp.dst_valid & !w_rsp_stale;   /* no PRF write / forward */
     end
   
   assign cache_accesses = r_cache_accesses;
   assign cache_hits = r_cache_hits;

   wire					 w_cacheable_mem_rsp_valid = (r_state == INJECT_RELOAD) & 
					 mem_rsp_valid;
   /* fill -> load bypass: the simple load that owns this fill takes its data from
    * the fill itself (no array write + port-1 re-lookup + registered hit).  Its
    * ordering checks were all made on its first pass (an overlapping older LSU store
    * blocks it BLK_SB_*, an MQ store is ahead of it), and the L1D held no copy, so
    * the fill is current.  If a port-2 op answers this cycle (they share the
    * response), the bypass response goes out next cycle from r_fill_rsp: no
    * port-2 request is accepted on the fill cycle and the MQ's next pop answers a
    * cycle later, so that slot is always free. */
   wire					 w_fill_bypass = w_cacheable_mem_rsp_valid &
					 (r_mem_req_opcode == MEM_LW) &
					 r_req.lsu_hold & !r_req.is_store;
   mem_rsp_t				 t_fill_rsp, r_fill_rsp;
   /* start the fill straight from the port-2 miss (no MQ pop + port-1 re-lookup) */
   logic				 t_direct_fill_ok, t_direct_fill;
   logic				 n_fill_rsp_pend, r_fill_rsp_pend;
   
   always_ff@(posedge clk)
     begin
	r_cycle <= reset ? 'd0 : (r_cycle + 'd1);
     end
   
   
   always_ff@(posedge clk)
     begin
	if(reset)
	  begin
	     r_mq_head_ptr <= 'd0;
	     r_mq_tail_ptr <= 'd0;
	  end
	else
	  begin
	     r_mq_head_ptr <= n_mq_head_ptr;
	     r_mq_tail_ptr <= n_mq_tail_ptr;
	  end
     end // always_ff@ (posedge clk)

   localparam N_ROB_ENTRIES = (1<<`LG_ROB_ENTRIES);
   logic [N_ROB_ENTRIES-1:0] r_missed;
   logic [2*N_ROB_ENTRIES-1:0] r_rob_inflight;   /* indexed {restart color, rob_ptr} */

   logic r_link_reg_val;
   logic [`PA_WIDTH-1:0] r_link_reg;
   wire w_match_link = r_link_reg_val &&
                       (r_link_reg == {r_req.addr[`PA_WIDTH-1:`LG_L1D_CL_LEN],
                                       {`LG_L1D_CL_LEN{1'b0}}});
   wire w_match_link2 = r_link_reg_val &&
                        (r_link_reg == {r_req2.addr[`PA_WIDTH-1:`LG_L1D_CL_LEN],
                                        {`LG_L1D_CL_LEN{1'b0}}});

`ifdef VERILATOR
   logic r_pg_wait2;
   always_ff@(posedge clk)
     begin
	r_pg_wait2 <= reset ? 1'b0 : (r_state == FLUSH_PG_WAIT) & (n_state == FLUSH_PG_WAIT);
     end
   /* XPG_INV found a dirty line: the page was not cleaned before its DMA deposit */
   always_ff@(negedge clk)
     begin
	if((r_state == FLUSH_PG) & flush_cl_inval & w_pg_hit & r_dirty_out)
	  begin
	     $display("[pgdrop-dirty] L1D cyc=%d pa=%x", r_cycle, w_pg_line);
	  end
	/* the walk held the index, so from the 2nd wait cycle on the RAM output is the
	 * post-invalidate line: a page op must never leave a page line valid */
	if((r_state == FLUSH_PG_WAIT) & r_pg_wait2 & w_pg_hit)
	  begin
	     $display("[pgwalk] LINE STILL VALID after page op: cyc=%d pa=%x", r_cycle, w_pg_line);
	     $stop();
	  end
	if((r_state == FLUSH_PG_WAIT) & mem_rsp_valid & flush_cl_inval & mem_rsp_load_data[0])
	  begin
	     $display("[pgdrop-dirty] L2 cyc=%d pa=%x", r_cycle, w_pg_line);
	  end
     end // always_ff
`endif
   /* CACHE hit-type mem ops (MEM_CHWB/CHWBINV/CHINV): line ops with dtlb-translated
    * PAs, admitted only non-speculatively (w_chop_req), performed from the MQ head,
    * answered when the L2 acks.  The R10000 block ops (MEM_BLK_*) take the same
    * path, but the l1d hands the whole 128-byte block to the L2. */
   function automatic logic is_blkop(mem_op_t op);
      begin
`ifdef ENABLE_R10000
	 is_blkop = (op == MEM_BLK_WBINV) | (op == MEM_BLK_INV) | (op == MEM_BLK_IDX);
`else
	 is_blkop = 1'b0;
`endif
      end
   endfunction
   function automatic logic is_chop(mem_op_t op);
      begin
	 is_chop = (op == MEM_CHWB) | (op == MEM_CHWBINV) | (op == MEM_CHINV) | is_blkop(op);
      end
   endfunction
   wire w_is_chop2 = is_chop(r_req2.op);
   wire w_is_chop_head = is_chop(t_mem_head.op);
   wire w_is_chop_r = is_chop(r_req.op);
   logic r_chop_wait, n_chop_wait;
`ifdef CHOP_DEBUG
   always_ff@(negedge clk)
     begin
	if(t_push_miss)
	  $display("[push] cyc=%d op=%d pa=%x st=%b rob=%d", r_cycle, r_req2.op, t_remapped_req2.addr, r_req2.is_store, r_req2.rob_ptr);
	if(t_pop_mq & t_mem_head.is_store & !w_is_chop_head)
	  $display("[st-fire] cyc=%d pa=%x", r_cycle, t_mem_head.addr);
	if(t_pop_mq & w_is_chop_head)
	  $display("[chop-fire] cyc=%d op=%d pa=%x", r_cycle, t_mem_head.op, t_mem_head.addr);
	if(r_got_req & w_is_chop_r)
	  $display("[chop-retry] cyc=%d op=%d pa=%x v=%b tagm=%b d=%b -> st=%d wb=%b", r_cycle, r_req.op, r_req.addr,
		   r_valid_out, (r_tag_out == r_cache_tag), r_dirty_out, n_state, n_mem_req_valid);
	if(r_state == FLUSH_CL)
	  $display("[funnel-flcl] cyc=%d pa=%x inval=%b v=%b tagm=%b d=%b -> st=%d", r_cycle, flush_cl_addr, flush_cl_inval,
		   r_valid_out, (r_tag_out == flush_cl_addr[`PA_WIDTH-1:TAG_LSB]), r_dirty_out, n_state);
	if(n_mem_req_valid & ((n_mem_req_opcode == MEM_WB) | (n_mem_req_opcode == MEM_INVL)) & (r_state != FLUSH_CACHE))
	  $display("[l2op] cyc=%d op=%s pa=%x data=%x", r_cycle, (n_mem_req_opcode == MEM_WB) ? "WB" : "INVL", n_mem_req_addr, n_mem_req_store_data[31:0]);
     end
`endif


   wire w_req2_is_store = (r_req2.op == MEM_SB)  || (r_req2.op == MEM_SH)  ||
                          (r_req2.op == MEM_SW)  || (r_req2.op == MEM_SWL) ||
                          (r_req2.op == MEM_SWR) || (r_req2.op == MEM_SD)  ||
                          (r_req2.op == MEM_SDL) || (r_req2.op == MEM_SDR);
   /* What breaks the LL/SC link on the in-order first pass (LLSC model, machine.vh).
    * NOT MEM_LL/LLD (set it), NOT MEM_SC/SCD (clear at response after w_match_link2). */
`ifdef LLSC_BREAK_ON_LOAD
   /* R10000 (p.27): ANY intervening normal load/store breaks the link. */
   wire w_req2_breaks_link = (r_req2.op != MEM_LL)   && (r_req2.op != MEM_LLD) &&
                             (r_req2.op != MEM_SC)    && (r_req2.op != MEM_SCD) &&
                             (r_req2.op != MEM_TLBP)  && (r_req2.op != MEM_INVL) &&
                             (r_req2.op != MEM_MOV);
`else
   /* BERI/CHERI (default): only a STORE to the linked line breaks the link. */
   wire w_req2_breaks_link = w_req2_is_store && w_match_link2;
`endif
   always_ff@(posedge clk)
     begin
	if(reset || clr_link_reg)
	  begin
	     r_link_reg_val <= 1'b0;
	     r_link_reg <= 'd0;
	  end
	/* Track the link at the IN-ORDER first pass (port2 = core_mem_req ingress);
	 * misses replay via port1, which is OOO and must NOT touch the link. */
	else if(r_got_req2 && (r_req2.op == MEM_LL || r_req2.op == MEM_LLD))
	  begin
	     r_link_reg_val <= 1'b1;
	     r_link_reg <= {r_req2.addr[`PA_WIDTH-1:`LG_L1D_CL_LEN], {`LG_L1D_CL_LEN{1'b0}}};
	  end
	else if(n_core_mem_rsp_valid && r_got_req2 && (r_req2.op == MEM_SC || r_req2.op == MEM_SCD))
	  begin
	     /* SC/SCD: clear at its response, after the w_match_link2 check below */
	     r_link_reg_val <= 1'b0;
	  end
	else if(r_got_req2 && w_req2_breaks_link && !r_req2.commit)
	  begin
	     /* in-order first pass breaks the link (model selected above) */
	     r_link_reg_val <= 1'b0;
	  end
     end


   always_ff@(posedge clk)
     begin
	if(reset)
	  begin
	     r_n_inflight <= 'd0;
	  end
	else
	  begin
	     /* a cache-owned block (MISS / ST_CONFLICT) stays counted until its wakeup,
	      * so memq_empty (the drain condition) cannot assert while one is owed */
	     r_n_inflight <= r_n_inflight + {{`LG_MRQ_ENTRIES{1'b0}}, t_got_req2}
			     - {{`LG_MRQ_ENTRIES{1'b0}}, (w_rsp_v | w_wake_v | (w_blk_v & w_rsp.blk[2]))}
			     - {{`LG_MRQ_ENTRIES{1'b0}}, core_mem_st_done_valid}
			     - {{`LG_MRQ_ENTRIES{1'b0}}, t_mq_stale_owed};
	  end
     end // always_ff@ (posedge clk)

   

   
   
   always_comb
     begin
	n_mq_head_ptr = r_mq_head_ptr;
	n_mq_tail_ptr = r_mq_tail_ptr;
	t_mq_tail_ptr_plus_one = r_mq_tail_ptr + 'd1;
	
	if(t_push_miss)
	  begin
	     n_mq_tail_ptr = r_mq_tail_ptr + 'd1;
	  end
	
	if(t_pop_mq)
	  begin
	     n_mq_head_ptr = r_mq_head_ptr + 'd1;
	  end
	
	t_mem_head = r_mem_q[r_mq_head_ptr[`LG_MRQ_ENTRIES-1:0]];
	
	mem_q_empty = (r_mq_head_ptr == r_mq_tail_ptr);
	
	mem_q_full = (r_mq_head_ptr != r_mq_tail_ptr) &&
		     (r_mq_head_ptr[`LG_MRQ_ENTRIES-1:0] == r_mq_tail_ptr[`LG_MRQ_ENTRIES-1:0]);
	
	mem_q_almost_full = (r_mq_head_ptr != t_mq_tail_ptr_plus_one) &&
			    (r_mq_head_ptr[`LG_MRQ_ENTRIES-1:0] == t_mq_tail_ptr_plus_one[`LG_MRQ_ENTRIES-1:0]);
	
	
     end // always_comb


   always_ff@(posedge clk)
     begin
	if(reset)
	  begin
	     r_missed <= 'd0;
	  end
	else
	  begin
	     if(t_push_miss && !r_req2.commit)
	       begin
		  r_missed[r_req2.rob_ptr] <= !t_port2_hit_cache;
	       end
	  end
     end // always_ff@ (posedge clk)

   always_ff@(posedge clk)
     begin
	if(reset)
	  begin
	     r_rob_inflight <= 'd0;
	  end
	else
	  begin
	     if(t_direct_fill)
	       begin
		  r_rob_inflight[{r_req2.restart_id, r_req2.rob_ptr}] <= 1'b1;
	       end
	     if(r_got_req2 && !drain_ds_complete && t_push_miss && !r_req2.commit)
	       begin
		  //$display("rob entry %d enters at cycle %d", r_req2.rob_ptr, r_cycle);
		  
		  if(r_rob_inflight[{r_req2.restart_id, r_req2.rob_ptr}] == 1'b1)
		    $display("entry %d should not be inflight\n", r_req2.rob_ptr);
		  
		  r_rob_inflight[{r_req2.restart_id, r_req2.rob_ptr}] <= 1'b1;
	       end
	     if(r_got_req && r_valid_out && (r_tag_out == r_cache_tag) && !r_req.commit)
	       begin
		  //$display("rob entry %d leaves at cycle %d", r_req.rob_ptr, r_cycle);
		  //if(r_rob_inflight[{r_req.restart_id, r_req.rob_ptr}] == 1'b0) 
		  //$display("huh %d should be inflight....\n", r_req.rob_ptr);
		  
		  r_rob_inflight[{r_req.restart_id, r_req.rob_ptr}] <= 1'b0;
	       end
	     else if(w_fill_bypass)
	       begin
		  r_rob_inflight[{r_req.restart_id, r_req.rob_ptr}] <= 1'b0;
	       end
	     else if((r_state == INJECT_UNCACHE_STORE | r_state == INJECT_UNCACHE_LOAD) & mem_rsp_valid & !r_req.commit)
	       begin
		  //if(r_rob_inflight[{r_req.restart_id, r_req.rob_ptr}] == 1'b0) 
		  //$display("huh %d should be inflight....\n", r_req.rob_ptr);
		  
		  r_rob_inflight[{r_req.restart_id, r_req.rob_ptr}] <= 1'b0;
	       end
	     if(t_mq_stale_drop)
	       begin
		  r_rob_inflight[{t_mem_head.restart_id, t_mem_head.rob_ptr}] <= 1'b0;
	       end
	     if(t_ucld_dead_drop)
	       begin
		  r_rob_inflight[{r_req.restart_id, r_req.rob_ptr}] <= 1'b0;
	       end
	     /* a CACHE hit-op retry completes the op on THIS pass whether it hits,
	      * misses, or tag-mismatches (the line op / L2 scrub is issued either
	      * way) -- clear its inflight bit unconditionally, else a miss/mismatch
	      * chop leaves rob_inflight stuck and the next op reusing that rob_ptr
	      * can never be accepted (l1d wedge, MQ empty). */
	     if(r_got_req & w_is_chop_r)
	       begin
		  r_rob_inflight[{r_req.restart_id, r_req.rob_ptr}] <= 1'b0;
	       end
	  end
     end

   mem_req_t t_remapped_req2;
   always_comb
     begin
	t_remapped_req2 = r_req2;
	t_remapped_req2.addr = {{(`M_WIDTH-`PA_WIDTH){1'b0}}, w_mapped_addr};
`ifdef L1D_PA_INDEX
	t_req2_idx = w_mapped_addr[IDX_STOP-1:IDX_START];   /* (old behaviour) the PA set */
`else
	/* stage C2: lines live at their VA set -- the set port 2 already read.  A
	 * synonym (same PA, other colour) misses here and the L2 probes the old copy. */
	t_req2_idx = r_req2.addr[IDX_STOP-1:IDX_START];
`endif
	/* For a TLB-MAPPED access, cacheability comes from the matched page's C
	 * field (machine.vh CCA_CACHED) rather than mipsseg's segment default; for an
	 * unmapped (direct) access keep the segment decision in r_req2.cached.
	 * w_tlb_c is registered in lockstep with w_mapped_addr, so it lines up
	 * with r_req2 here. (This is the proper fix the L2 UNCACHE_WB_TURNAROUND
	 * worked around: a cacheable mapped store was being routed uncached.) */
`ifdef FORCE_UNCACHED
	t_remapped_req2.cached = 1'b0;   /* SCIENCE: force ALL data traffic uncached */
`else
	t_remapped_req2.cached = r_req2.mapped ? `CCA_CACHED(w_tlb_c) : r_req2.cached;
`endif
	/* the queued/replayed req now carries the TLB-translated PHYSICAL address;
	 * mark it unmapped so the replay refills from / re-tags with the PA and
	 * does NOT translate it a second time. */
	t_remapped_req2.mapped = 1'b0;
	/* merge loads (LWL/LWR/LDL/LDR) take their register merge value from
	 * their LSU slot; MQ entries and direct fills carry it in .data */
	if(r_req2.op == MEM_LWL || r_req2.op == MEM_LWR ||
	   r_req2.op == MEM_LDL || r_req2.op == MEM_LDR)
	  begin
	     t_remapped_req2.data = r_sb_data[r_req2.lsu_idx];
	  end
     end

   /* ---------------- LSU store buffer (payload only) ----------------
    * One slot per LSU entry.  A plain store's port-2 pass (translation, fault
    * check, early ack) writes its PA/mask/op/cacheability here; its data arrives
    * separately from the LSU (lsu_sb.data_*).  The LSU owns liveness, age,
    * retirement and drain; a load compares against the slots its LSU entry saw as
    * older stores at issue (lsu_older_st), still holding the same store (epoch). */
   localparam N_LSU = 1 << `LG_MEM_SCHED_ENTRIES;
   logic [`PA_WIDTH-1:0] r_sb_pa[N_LSU-1:0];
   logic [`LG_L1D_NUM_SETS-1:0] r_sb_idx[N_LSU-1:0];   /* the store's L1D set (C2) */
   logic [15:0] 	 r_sb_mask[N_LSU-1:0];
   mem_op_t		 r_sb_op[N_LSU-1:0];
   logic [N_LSU-1:0] 	 r_sb_cached;
   logic [N_LSU-1:0] 	 r_sb_scok;       /* SC/SCD: link held at the address pass */
   logic [63:0] 	 r_sb_data[N_LSU-1:0];
   logic 		 t_sb_wr;
   /* pipetrace: the port-2 / port-1 outcome for this cycle's op (0 = none) */
   logic [7:0] 		 t_pt2, t_pt1;
   logic 		 t_p2_ok, t_p2_accept;
   /* hit-under-miss: the port-2 request was read from the set being filled */
   logic 		 r_fill_conflict2;

   always_ff@(posedge clk)
     begin
	if(t_sb_wr)
	  begin
	     r_sb_pa[r_req2.lsu_idx] <= w_mapped_addr;
	     r_sb_idx[r_req2.lsu_idx] <= t_req2_idx;
	     r_sb_mask[r_req2.lsu_idx] <= make_mask(r_req2);
	     r_sb_op[r_req2.lsu_idx] <= r_req2.op;
	     r_sb_cached[r_req2.lsu_idx] <= t_remapped_req2.cached;
	     r_sb_scok[r_req2.lsu_idx] <= w_match_link2;
	  end
	if(lsu_sb.data_valid)
	  begin
	     r_sb_data[lsu_sb.data_idx] <= lsu_sb.data;
	  end
     end // always_ff@ (posedge clk)

   /* a store's bytes placed in a 16B line (byte k at bits 8k+7:8k), as the port-1
    * merge writes them: SB raw, SH/SW/SD byte-swapped */
   function logic [L1D_CL_LEN_BITS-1:0] sb_line(mem_op_t op, logic [3:0] off, logic [63:0] d);
      logic [L1D_CL_LEN_BITS-1:0] l;
      l = (op == MEM_SB) ? {120'd0, d[7:0]} :
	  (op == MEM_SH) ? {112'd0, bswap16(d[15:0])} :
	  (op == MEM_SW) ? {96'd0, bswap32(d[31:0])} :
	  {64'd0, bswap64(d)};
      return l << {off, 3'd0};
   endfunction

   function logic [L1D_CL_LEN_BITS-1:0] expand_mask(logic [15:0] m);
      logic [L1D_CL_LEN_BITS-1:0] e;
      for(integer b = 0; b < 16; b = b + 1)
	begin
	   e[b*8 +: 8] = {8{m[b]}};
	end
      return e;
   endfunction

   logic [N_LSU-1:0] t_sb_older, t_sb_match, t_sb_youngest;
   logic [15:0] 	 t_ld_mask2;
   logic [`LG_MEM_SCHED_ENTRIES-1:0] t_sb_y;
   logic 				   t_sb_fwd, t_sb_blk;
   blk_code_t				   t_sb_code;
   logic [N_LSU-1:0] 			   t_sb_blk_st;
   logic [L1D_CL_LEN_BITS-1:0] 		   t_sb_line, t_sb_bytes;
   logic 				   w_sb_fwd_op;

   always_comb
     begin
	t_ld_mask2 = make_mask(r_req2);
	t_sb_y = 'd0;
	for(integer j = 0; j < N_LSU; j = j + 1)
	  begin
	     t_sb_older[j] = r_req2.lsu_older_st[j] & lsu_sb.live[j] & (lsu_sb.epoch[j] == r_req2.lsu_older_ep[j]);
	     t_sb_match[j] = t_sb_older[j] &
			     (r_sb_pa[j][`PA_WIDTH-1:`LG_L1D_CL_LEN] == w_mapped_addr[`PA_WIDTH-1:`LG_L1D_CL_LEN]) &
			     (|(r_sb_mask[j] & t_ld_mask2));
	  end
	/* the youngest overlapping older store: no other match is younger than it */
	for(integer j = 0; j < N_LSU; j = j + 1)
	  begin
	     t_sb_youngest[j] = t_sb_match[j] &
				((t_sb_match & ~lsu_sb.matrix[j*N_LSU +: N_LSU] & ~(1 << j)) == 'd0);
	     if(t_sb_youngest[j])
	       begin
		  t_sb_y = j[`LG_MEM_SCHED_ENTRIES-1:0];
	       end
	  end
	/* the youngest overlapping store is a whole-access store sb_line can place
	 * (partial stores and SC never forward: the load waits for their drain) */
	w_sb_fwd_op = (r_sb_op[t_sb_y] == MEM_SB) | (r_sb_op[t_sb_y] == MEM_SH) |
		      (r_sb_op[t_sb_y] == MEM_SW) | (r_sb_op[t_sb_y] == MEM_SD);
	t_sb_line = sb_line(r_sb_op[t_sb_y], r_sb_pa[t_sb_y][3:0], r_sb_data[t_sb_y]);
	t_sb_bytes = expand_mask(r_sb_mask[t_sb_y]);
	/* forward when the youngest overlapping older store covers every load byte */
	t_sb_fwd = (|t_sb_match) & lsu_sb.data_ok[t_sb_y] & r_sb_cached[t_sb_y] & t_remapped_req2.cached &
		   w_sb_fwd_op &
		   ((t_ld_mask2 & ~r_sb_mask[t_sb_y]) == 16'd0);
	/* an uncached load waits for EVERY older store (device ordering); a cached
	 * one only for overlapping stores it cannot forward from */
	t_sb_blk = r_req2.lsu_hold & !r_req2.is_store &
		   (t_remapped_req2.cached ? ((|t_sb_match) & !t_sb_fwd) : (|t_sb_older));
	t_sb_code = BLK_SB_CONFLICT;
	t_sb_blk_st = t_remapped_req2.cached ? t_sb_match : t_sb_older;
	if(t_remapped_req2.cached && !lsu_sb.data_ok[t_sb_y] && r_sb_cached[t_sb_y] && w_sb_fwd_op &&
	   ((t_ld_mask2 & ~r_sb_mask[t_sb_y]) == 16'd0))
	  begin
	     /* only the data is missing: wait for it, not for the drain */
	     t_sb_code = BLK_SB_DATA;
	     t_sb_blk_st = t_sb_youngest;
	  end
     end // always_comb

   /* commit: the MQ entry is rebuilt from the store buffer (already physical,
    * already retired -- it fires at the MQ head with no graduation wait) */
   mem_req_t t_mq_push_req;
   always_comb
     begin
	t_mq_push_req = t_remapped_req2;
	t_mq_push_idx = t_req2_idx;
	if(r_req2.commit)
	  begin
	     t_mq_push_req = r_req2;
	     t_mq_push_req.addr = {{(`M_WIDTH-`PA_WIDTH){1'b0}}, r_sb_pa[r_req2.lsu_idx]};
	     t_mq_push_idx = r_sb_idx[r_req2.lsu_idx];
	     t_mq_push_req.op = r_sb_op[r_req2.lsu_idx];
	     t_mq_push_req.data = r_sb_data[r_req2.lsu_idx];
	     t_mq_push_req.cached = r_sb_cached[r_req2.lsu_idx];
	     t_mq_push_req.sc_ok = r_sb_scok[r_req2.lsu_idx];
	     t_mq_push_req.mapped = 1'b0;
	     t_mq_push_req.is_store = 1'b1;
	     t_mq_push_req.bad_addr = 1'b0;
	  end
     end

`ifdef LSU_TRACE
   always_ff@(negedge clk)
     begin
	if(!reset && t_p2_accept && (r_state == INJECT_RELOAD))
	  begin
	     $display("[L1D] cyc=%0d hum-accept op=%0d", r_cycle, core_mem_req.op);
	  end
	if(!reset && r_got_req2 && (r_state == INJECT_RELOAD) && (n_core_mem_rsp_valid && n_core_mem_rsp.dst_valid))
	  begin
	     $display("[L1D] cyc=%0d hum-hit", r_cycle);
	  end
     end // always_ff@ (negedge clk)
`endif

   /* per-color accounting for the core's flip-back guard: ops accepted and not yet
    * answered (a cache-owned block stays owed until its wakeup/data), plus queued
    * MQ entries (an early-acked old-path store still sits in the MQ) */
   logic [`LG_MRQ_ENTRIES+1:0] r_color_cnt [1:0];
   logic [1:0] 		       t_mq_color;
   always_ff@(posedge clk)
     begin
	for(integer c = 0; c < 2; c = c + 1)
	  begin
	     if(reset)
	       begin
		  r_color_cnt[c] <= 'd0;
	       end
	     else
	       begin
		  r_color_cnt[c] <= r_color_cnt[c]
				    + {{(`LG_MRQ_ENTRIES+1){1'b0}}, (t_got_req2 && !core_mem_req.commit && (core_mem_req.restart_id == c[0]))}
				    - {{(`LG_MRQ_ENTRIES+1){1'b0}}, ((w_rsp_v | w_wake_v | (w_blk_v & w_rsp.blk[2])) && (w_rsp.restart_id == c[0]))}
				    - {{(`LG_MRQ_ENTRIES+1){1'b0}}, (t_mq_stale_owed && (t_mem_head.restart_id == c[0]))};
	       end
	  end
     end // always_ff@ (posedge clk)
`ifdef VERILATOR
   /* debug only: exact shadow of the per-color accounting, keyed {color, rob_ptr}.
    * Catches the leak/double-answer the moment it happens, not at the next flip. */
   logic [N_ROB_ENTRIES-1:0] r_dbg_out [1:0];
   logic [7:0] r_dbg_mm_cnt;
   always_ff@(posedge clk)
     begin
	if(reset)
	  begin
	     r_dbg_out[0] <= '0;
	     r_dbg_out[1] <= '0;
	  end
	else
	  begin
	     logic [N_ROB_ENTRIES-1:0] t_o0, t_o1;
	     t_o0 = r_dbg_out[0];
	     t_o1 = r_dbg_out[1];
	     if(t_got_req2 && !core_mem_req.commit)
	       begin
		  if(core_mem_req.restart_id ? t_o1[core_mem_req.rob_ptr] : t_o0[core_mem_req.rob_ptr])
		    begin
		       $display("[COLORSHADOW] cyc=%0d double accept color=%0d rob=%0d op=%0d", r_cycle, core_mem_req.restart_id, core_mem_req.rob_ptr, core_mem_req.op);
		    end
		  if(core_mem_req.restart_id) t_o1[core_mem_req.rob_ptr] = 1'b1; else t_o0[core_mem_req.rob_ptr] = 1'b1;
	       end
	     if((w_rsp_v | w_wake_v | (w_blk_v & w_rsp.blk[2])))
	       begin
		  if(!(w_rsp.restart_id ? r_dbg_out[1][w_rsp.rob_ptr] : r_dbg_out[0][w_rsp.rob_ptr]))
		    begin
		       $display("[COLORSHADOW] cyc=%0d answer to non-outstanding color=%0d rob=%0d rsp=%b blk=%b(%0d) wake=%b st_commit_op=%0d",
				r_cycle, w_rsp.restart_id, w_rsp.rob_ptr, w_rsp_v, w_blk_v, w_rsp.blk, w_wake_v, r_req.op);
		    end
		  if(w_rsp.restart_id) t_o1[w_rsp.rob_ptr] = 1'b0; else t_o0[w_rsp.rob_ptr] = 1'b0;
	       end
	     if(t_mq_stale_owed)
	       begin
		  if(t_mem_head.restart_id) t_o1[t_mem_head.rob_ptr] = 1'b0; else t_o0[t_mem_head.rob_ptr] = 1'b0;
	       end
	     r_dbg_out[0] <= t_o0;
	     r_dbg_out[1] <= t_o1;
	  end
     end
   always_ff@(negedge clk)
     begin
	if(reset)
	  begin
	     r_dbg_mm_cnt <= 8'd0;
	  end
	else if(((32'($countones(r_dbg_out[0])) != 32'(r_color_cnt[0])) || (32'($countones(r_dbg_out[1])) != 32'(r_color_cnt[1]))) && (r_dbg_mm_cnt < 8'd20))
	  begin
	     r_dbg_mm_cnt <= r_dbg_mm_cnt + 8'd1;
	     $display("[COLORSHADOW] cyc=%0d count mismatch shadow=%0d/%0d cnt=%0d/%0d", r_cycle,
		      $countones(r_dbg_out[0]), $countones(r_dbg_out[1]), r_color_cnt[0], r_color_cnt[1]);
	  end
     end
`endif
`ifdef VERILATOR
   /* debug only: a color counter must never underflow or run away */
   always_ff@(negedge clk)
     begin
	for(integer c = 0; c < 2; c = c + 1)
	  begin
	     if(!reset && (r_color_cnt[c] > (N_MQ_ENTRIES + 8)))
	       begin
		  $display("[COLORCNT] cyc=%0d color %0d count %0d runaway/underflow", r_cycle, c, r_color_cnt[c]);
	       end
	  end
     end
`endif
   always_comb
     begin
	t_mq_color = 2'd0;
	for(integer i = 0; i < N_MQ_ENTRIES; i = i + 1)
	  begin
	     if(r_mq_addr_valid[i] && !r_mem_q[i].commit)
	       begin
		  t_mq_color[r_mem_q[i].restart_id] = 1'b1;
	       end
	  end
	mem_color_busy[0] = (r_color_cnt[0] != 'd0) | t_mq_color[0];
	mem_color_busy[1] = (r_color_cnt[1] != 'd0) | t_mq_color[1];
	/* independent of the color counters: the queue is empty, no pass or fill is
	 * in progress and no answer is on its way out */
	mem_quiet = mem_q_empty && (r_state == ACTIVE) && !r_got_req && !r_got_req2 &&
		    !r_fill_rsp_pend && !w_rsp_v && !w_blk_v && !w_wake_v;
     end // always_comb

`ifdef VERILATOR
   /* rv64core's restart_id check: nothing of a flushed era may be accepted */
   always_ff@(negedge clk)
     begin
	if(!reset && t_got_req2 && !core_mem_req.commit && (core_mem_req.restart_id != restart_color))
	  begin
	     $display("cycle %0d : current restart color is %0d but ingesting %0d", r_cycle, restart_color, core_mem_req.restart_id);
	     $stop();
	  end
     end // always_ff@ (negedge clk)
`endif

`ifdef PIPETRACE
   import "DPI-C" function void pt_event(input int rob_ptr, input int letter, input longint cycle);
   always_ff@(negedge clk)
     begin
	if(!reset && (t_pt2 != 8'd0))
	  begin
	     pt_event({{(32-`LG_ROB_ENTRIES){1'b0}}, r_req2.rob_ptr}, {24'd0, t_pt2}, {32'd0, r_cycle});
	  end
	if(!reset && (t_pt1 != 8'd0))
	  begin
	     pt_event({{(32-`LG_ROB_ENTRIES){1'b0}}, r_req.rob_ptr}, {24'd0, t_pt1}, {32'd0, r_cycle});
	  end
	/* L1D-miss path of a load (the owner is r_req; stores/commits are skipped --
	 * a commit's rob_ptr is stale) */
	if(!reset && t_pop_mq && !t_mem_head.is_store && !t_mem_head.commit)
	  begin
	     pt_event({{(32-`LG_ROB_ENTRIES){1'b0}}, t_mem_head.rob_ptr}, "O", {32'd0, r_cycle});
	  end
	if(!reset && t_direct_fill)
	  begin
	     pt_event({{(32-`LG_ROB_ENTRIES){1'b0}}, r_req2.rob_ptr}, "E", {32'd0, r_cycle});
	  end
	if(!reset && n_mem_req_valid && !r_mem_req_valid && !r_req.is_store && !t_direct_fill)
	  begin
	     pt_event({{(32-`LG_ROB_ENTRIES){1'b0}}, r_req.rob_ptr}, (n_mem_req_opcode == MEM_LW) ? "E" : "Y", {32'd0, r_cycle});
	  end
	if(!reset && (r_state == HANDLE_RELOAD) && !r_req.is_store)
	  begin
	     pt_event({{(32-`LG_ROB_ENTRIES){1'b0}}, r_req.rob_ptr}, "J", {32'd0, r_cycle});
	  end
     end // always_ff@ (negedge clk)
`endif

   /* the deferred fill response: FUNCTIONAL state, so it must not live under
    * `ifdef VERILATOR (it once did -- synthesis dropped the register, the FPGA
    * delivered a zero response and the waiting load wedged; sim never saw it) */
   always_ff@(posedge clk)
     begin
	if(n_fill_rsp_pend)
	  begin
	     r_fill_rsp <= t_fill_rsp;
	  end
     end

`ifdef VERILATOR
   always_ff@(posedge clk)
     begin
	if(!reset && r_fill_rsp_pend && (r_got_req2 || r_got_req))
	  begin
	     $display("[LSU] cyc=%0d deferred fill rsp collides with a port pass", r_cycle);
	     $stop();
	  end
     end // always_ff@ (posedge clk)

   /* rsp / block / wakeup share core_mem_rsp: port 1 and port 2 never answer in
    * the same cycle (a port-1 read retry holds off the port-2 accept) */
   always_ff@(posedge clk)
     begin
	if(!reset && ((n_core_mem_rsp_valid + n_core_mem_blk_valid + n_core_mem_wake_valid) > 2'd1))
	  begin
	     $display("[LSU] cyc=%0d l1d rsp/blk/wake collide %b%b%b", r_cycle,
		      n_core_mem_rsp_valid, n_core_mem_blk_valid, n_core_mem_wake_valid);
	     $stop();
	  end
     end // always_ff@ (posedge clk)

   /* an uncached LOAD must reach memory only when non-speculative (at the ROB
    * head, the head's committable delay slot, or draining dead ops, which the
    * t_ucld_dead_drop arm answers without an access) */
   always_ff@(posedge clk)
     begin
	if(!reset && (r_state == ACTIVE) && (n_state == INJECT_UNCACHE_LOAD) &&
	   !(head_of_rob_ptr_valid && (head_of_rob_ptr == r_req.rob_ptr)) &&
	   !(head_of_rob_ds_committable && (next_head_of_rob_ptr == r_req.rob_ptr)))
	  begin
	     $display("[UCSPEC] cyc=%0d speculative uncached load pa=%x rob_ptr=%0d head=%0d",
		      r_cycle, r_req.addr, r_req.rob_ptr, head_of_rob_ptr);
	  end
     end // always_ff@ (posedge clk)
`endif
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
