dsheffie/r9999/l2.sv

`include "machine.vh"

module l2(clk,
	  reset,
	  state,
	  rsp_state,
	  l1i_flush_req,
	  l1d_flush_req,

	  l1i_flush_complete,
	  l1d_flush_complete,
	  
	  flush_complete,

	  //l1 -> l2
	  l1_mem_req_valid,
	  l1_mem_req_ack,
	  l1_mem_req_addr,
	  l1_mem_req_cacheable,
	  l1_mem_req_mask,
	  l1_mem_req_store_data,
	  l1_mem_req_opcode,
	  l1_mem_req_from_d,
	  l1_mem_req_colour,
	  l2_nocache,

	  //l2 -> l1
	  l1_mem_rsp_valid,
	  l1_mem_rsp_bad,
	  l1_mem_load_data,

	  //l2 -> mem
	  mem_req_ack,
	  mem_req_valid, 
	  mem_req_addr, 
	  mem_req_store_data, 
	  mem_req_opcode,
	  mem_req_mask,
	  mem_req_uncached,
	  
	  //mem -> l2
	  mem_rsp_valid,
	  mem_rsp_bad,
	  mem_rsp_load_data,

	  cache_hits,
	  cache_accesses,

	  // DMA-coherence snoop (from henry's snoop FIFO): invalidate one L2 line per request.
	  snoop_req_valid,
	  snoop_req_addr,
	  snoop_req_ack,
	  snoop_req_wbinv,
	  snoop_done,

	  // stage B: back-invalidate probe to the L1D
	  probe_req,
	  probe_addr,
	  probe_colour,
	  probe_ack,
	  probe_dirty,
	  probe_data,

	  // R10000 block op: invalidate the block in the L1I
	  l1i_blk_inv_req,
	  l1i_blk_inv_addr,
	  l1i_blk_inv_done
	  );

   input logic clk;
   input logic reset;
   output logic [3:0] state;
   output logic [3:0] rsp_state;
   
   input logic l1i_flush_req;
   input logic l1d_flush_req;
   input logic l1i_flush_complete;
   input logic l1d_flush_complete;
   
   output logic flush_complete;

   input logic 	l1_mem_req_valid;
   output logic l1_mem_req_ack;
   input logic [`PA_WIDTH-1:0] l1_mem_req_addr;
   input logic	      l1_mem_req_cacheable;
   /* l2_nocache (driver-set BEFORE `go`, static during a run): entirely disable the L2 as a
    * cache.  Route cacheable DATA ops (loads/stores/line-fills, opcode < MEM_INVL=24) down the
    * uncached pass-through-to-DRAM path so the L2 NEVER fills a line -> holds nothing -> no stale
    * reservoir AND no inclusivity vs the L1D.  CACHE-management ops (>=24) stay cacheable so their
    * handlers still run (find an empty L2, ack/write through).  l2_nocache=0 => normal L2.  Set
    * before-go only, so no mid-run flush needed (no lines exist to go stale). Was `ENABLE_L2_NOCACHE. */
   wire w_l2_cacheable = l1_mem_req_cacheable & (~l2_nocache | (l1_mem_req_opcode >= 6'd24));
`ifdef ENABLE_COHERENT_L1I
   wire w_ci_need = l1_mem_req_from_d && !is_blkop(l1_mem_req_opcode) &&
		    (((l1_mem_req_opcode == 6'd4) && w_l2_cacheable) ||
		     ((l1_mem_req_opcode == 6'd7) && !w_l2_cacheable));
   wire w_ci_ok = r_ci_ok && (l1_mem_req_addr[`PA_WIDTH-1:7] == r_blk_addr);
`endif
   input logic l2_nocache;
   input logic [15:0] l1_mem_req_mask;
   
   input logic [127:0] l1_mem_req_store_data;
   input logic [5:0] l1_mem_req_opcode;   /* mem_op_t; the memory side (mem_req_opcode) stays 5 bits */
   /* the granted request is the L1D's (the arbiter's address mux selects the L1D unless
    * it is in GNT_L1I) -- presence tracking only records L1D fills */
   input logic       l1_mem_req_from_d;
   /* stage C2: the L1D set colour (index bits above the page offset) the request's
    * line lives at in the VA-indexed L1D -- what pidx records */
   input logic [`L1D_N_COLOUR-1:0] l1_mem_req_colour;

   output logic        l1_mem_rsp_valid;
   output logic        l1_mem_rsp_bad;     /* uncached load answered with a bus error */
   output logic [127:0] l1_mem_load_data;
   
   input logic 	mem_req_ack;
   output logic mem_req_valid;
   output logic [`PA_WIDTH-1:0] mem_req_addr;
   output logic [127:0] mem_req_store_data;
   output logic [4:0] 	mem_req_opcode;
   output logic [15:0]	mem_req_mask;
   output logic 	mem_req_uncached;   /* this request is an uncached load/store (non-speculative) */
   
   input logic 		mem_rsp_valid;
   input logic		mem_rsp_bad;
   
   input logic [127:0] 	mem_rsp_load_data;
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
