dsheffie/r9999/sgi_hpc.cc

#include "sgi_hpc.hh"
#include "interpret.hh"
#include "sgi_scsi.hh"
#include "sgi_seeq.hh"
#include "sgi_scc.hh"
#include "sgi_newport.hh"
#include "sgi_ps2.hh"
#include "sgi_mc.hh"
#include "cache_model.hh"
#include "sclog.hh"
#include "globals.hh"

static sgi_scsi *ip28_scsi1(state_t *s);   /* --ip28 second WD33C93, below */
#include <cassert>
#include <cstdlib>
#include <ctime>

/* device-trace spew is off by default (it floods the console stream and slows the
 * boot to a crawl); set DEVTRACE=1 to re-enable. */
static const bool dev_verbose = getenv("DEVTRACE") != nullptr;
#define DPRINTF(...) do { if(dev_verbose) fprintf(stderr, __VA_ARGS__); } while(0)

/* RTC time source. Default: the live host wall-clock. Deterministic-time mode
 * (DETTIME env -- set on BOTH interp_mips and the JIT sim for reproducible
 * lockstep co-sim): a fixed plausible epoch advanced by retired-instruction
 * count, so the DS1286 clock is identical run-to-run instead of reading
 * ::time(nullptr). The base + rate must match the JIT sim's rtc_now exactly. */
static time_t rtc_now(state_t *s) {
  static const bool det = getenv("DETTIME") != nullptr;
  if(det) {
    static const time_t   DETTIME_BASE = 1717200000;     /* 2024-06-01 00:00:00 UTC */
    static const uint64_t DETTIME_RATE = 100000000ull;   /* ~100 M retired insns / simulated sec */
    return DETTIME_BASE + (time_t)(s->icnt / DETTIME_RATE);
  }
  return ::time(nullptr);
}

/* hundredths of a second for the DS1386 clock (same time source as rtc_now);
 * the SGI PROM polls it to check that the oscillator runs */
static uint32_t rtc_hundredths(state_t *s) {
  static const bool det = getenv("DETTIME") != nullptr;
  if(det) {
    return (uint32_t)((s->icnt / 1000000ull) % 100);   /* DETTIME_RATE / 100 */
  }
  struct timespec ts;
  clock_gettime(CLOCK_REALTIME, &ts);
  return (uint32_t)(ts.tv_nsec / 10000000);
}
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
