dsheffie/r9999/(commit log)

2026-05-02 hack in coproc0 print to register7 in the coproc
2026-05-03 better hacked in support for register print
2026-05-14 change smt2 file name and deal with broken logic in l1i
    [l1i.sv]
2026-05-22 plumb uncachable data side, swl and swr still broken
    [core_l1d_l1i.sv, exec.sv, interpret.cc, l1d.sv, l2.sv, top.cc]
2026-05-22 plumb processor mode bits, cacheable memory seems broken, isnt working on fpga
    [core.sv, core_l1d_l1i.sv, exec.sv, interpret.cc, l1d.sv, l1i.sv, top.cc]
2026-05-23 fix test harness issues
    [core_l1d_l1i.sv, exec.sv, l1d.sv, l1i.sv, l2.sv, mipsseg.sv, top.cc]
2026-05-23 fix deadlock on uncacheable access
    [core_l1d_l1i.sv, l2.sv]
2026-05-24 fix word sw mask
    [sgi_mc.cc, top.cc]
2026-05-25 add wired and random
2026-05-25 use bev to compute correct exception vector
    [core.sv, exec.sv]
2026-05-28 whoops - signal direction wrong
    [exec.sv]
2026-05-29 more tlb plumbing, fix double definition of w_add32
    [core.sv, core_l1d_l1i.sv, exec.sv, l1d.sv]
2026-05-29 tlb probe executes on mem pipe
2026-05-31 looks like the divider latency is wrong
    [core.sv, exec.sv, top.cc]
2026-05-31 divider appears to work, multiplier still has some bugs
    [divider.sv, exec.sv, mul.sv]
2026-06-03 i left claude have its way with the interpreter to fix the testing environment. added tlb instructions that i'm not currently testing and added hooks to terminate the simulation
    [interpret.cc, top.cc]
2026-06-04 fix multu/divu/maddu sign-extension in interpreter; switch csmith ref to QEMU
    MIPS-III specifies that 32-bit multiply/divide results are sign-extended
    into the 64-bit HI/LO registers. The interpreter was zero-extending via
    uint32_t assignments and unsafe uint64_t* pointer casts, causing the
    checker to catch divergences between the RTL (correct) and interpreter
    (wrong) on any test that used mflo/mfhi after multu or divu.
    Fix multu and divu to use sext64() for both lo and hi. Fix maddu the
    same way, and also fix the HI:LO accumulator reconstruction in madd and
    maddu to mask each half to 32 bits before shifting, which would otherwise
    corrupt the high word when lo holds a sign-extended negati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
    [interpret.cc, top.cc]
2026-06-05 fix HILO PRF exhaustion deadlock; fix 32b div/mul sign-extension; fix TEQ trap
    LG_HILO_PRF_ENTRIES 2→3 (4→8 entries): a tight ddiv loop could simultaneously
    hold 3 speculative HILO PRF entries (one per in-flight loop iteration) plus 1
    architectural entry, exhausting all 4 slots and permanently blocking further
    ddiv allocation — manifested as "no retire in 65537 cycles" on fail_15.
    Also includes fixes from prior session:
    - divider.sv: sign-extend remainder (n_Y[127:64]) for 32b divides, not just
    quotient; was producing wrong HI value for 32-bit div/divu
    - mul.sv: properly sign/zero-extend operands to 2W bits before multiplying so
    the full 2W-bit product is correct; use w_src_A/B (z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
    [core.sv, divider.sv, interpret.cc, mul.sv]
2026-06-05 revert LG_HILO_PRF_ENTRIES to 2 (not the root cause of fail_15 stall)
2026-06-05 fix is_div/is_mult missing 64b opcodes; fix capstone to MIPS64 mode
    is_div() and is_mult() in uop.vh only covered 32b variants (DIV/DIVU,
    MULT/MULTU), leaving DDIV/DDIVU/DMULT/DMULTU to fall through to the ALU
    scheduler's 1-cycle bus check instead of using t_div_ready / mul latency.
    For DDIV this meant the divider was never gated by t_div_ready, so the
    divide never actually started and the instruction deadlocked at the ROB
    head — the root cause of the fail_15 csmith hang (0/500 failures now).
    Also switch capstone disassembler init to CS_MODE_MIPS64 so 64b
    instructions decode correctly.
2026-06-05 run_tests.sh: N tests after cbmc filtering; save failures to failures/
    Previously N controlled total attempts including cbmc skips, so a run of
    500 might only exercise ~370 tests. Now each worker retries csmith generation
    until cbmc passes (up to 100 tries), so N is the count of tests that
    actually reach the simulator.
    Failing test artifacts are now saved to failures/fail_N.{c,elf} instead of
    the repo root, keeping the workspace clean.
2026-06-05 fix checker exception handling and slow-test classification
    top.cc: when RTL takes an exception (retires bfc00180-bfc003FF) while
    the sim is still at the faulting instruction in user code, advance the
    sim to execute the fault (triggering raise_adel/raise_ades → sim→bfc00180)
    then one more step to restore the normal invariant ss->pc == next_retire_pc.
    Normal branch delay-slot mismatches (bfc00010 startup jr, etc.) are not in
    the handler range and keep the original 2-mismatch tolerance unchanged.
    tests/csmith/run_tests.sh: bump default MAXICNT 10M→50M so slow-but-finite
    programs (like fail_12458 which needs 20M instructions) complete within the
    wall-clock limit. Classify "no checksum A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
    [top.cc]
2026-06-06 add CP0 timer interrupt: Count/Compare, IRQ injection, checker sync
    - exec.sv: add r_count/r_compare/r_timer_ip registers; irq_pending
    combinatorial output; cp0_count output; MFC0/MTC0 for regs 9/11/13
    - core.sv / core_l1d_l1i.sv: plumb took_irq and cp0_count to top
    - decode_mips.sv: add irq input port (was previously missing entirely)
    - rob.vh: add is_branch field to insn_fetch_t
    - l1i.sv: set insn.is_branch from predecode pd; IRQ now only injected
    on branch instructions — fixes BD=1 bug caused by decode-queue skew
    where the alloc-stage r_in_delay_slot lagged the decode stage
    - top.cc: sync sim CP0 Count each cycle; call raise_int on took_irq
    - interpret.cc/hh: add raise_int(); sets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
    [core.sv, core_l1d_l1i.sv, decode_mips.sv, exec.sv, interpret.cc, l1i.sv, mipsseg.sv]
2026-06-06 add logic to track if uops are in a delay slot
2026-06-06 csmith: add --timer-irq flag to run_tests.sh; guard timer setup with #ifdef
    Timer interrupt support in start_csmith.S is now conditional on
    -DENABLE_TIMER_IRQ, preserving the original no-interrupt behaviour by
    default. run_tests.sh accepts --timer-irq anywhere in the argument list
    to pass the define and enable timer IRQs (Compare=20000, interval=10000
    cycles) for the test run.
2026-06-06 implement sub/dsub; add overflow traps to add/dadd/sub/dsub in RTL and interpreter
    - decode_mips.sv: add missing sub (SPECIAL func=34) decode → SUB op
    - exec.sv: add SUB case with w_sub32_overflow fault; fix DSUB oversight
    (was missing w_sub64_overflow fault)
    - interpret.cc: add raise_overflow (ExcCode=12); implement add, dadd, sub,
    dsub with overflow detection matching RTL bit conditions
    [decode_mips.sv, exec.sv, interpret.cc]
2026-06-06 update PROJECT_STATE.md: serializing ops, delay-slot findings, test scores
    - Add serializing instructions table (TLBR/TLBWI/TLBWR/MFC0/MTC0/ERET
    all have must_restart=1; TLBP does not)
    - Document delay-slot/must_restart interaction: 16 cache insns in delay
    slots (safe NOPs), 5 mfc0 in delay slots (known wrong-restart-PC bug)
    - Update test score to 984/16/0 (1000 tests, --timer-irq)
    - Add sub + overflow trap fixes to Recently Implemented
    - Add prioritized Next Steps table (cache NOP, MFC0 non-serializing)
2026-06-06 MFC0/MTC0: replace must_restart with oldest_first + block-allocation
    Instead of draining the ROB and flushing the pipeline for MFC0/MTC0:
    - Add oldest_first bit to uop_t; gate issue in exec.sv on rob_ptr==head_of_rob_ptr
    - Block allocation of new instructions while an oldest_first instruction is pending
    (set r_oldest_first_pending on allocation, clear on retirement or ROB flush)
    - Also block t_alloc_two when either uop has oldest_first set, preventing the
    second-slot hazard where NOP+MTC0 pairs could bypass the block
    This fixes the wrong-restart-PC bug for MFC0 in branch delay slots (was:
    must_restart would restart at branch_pc+8 instead of branch target). The
    block-allocation mechanism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
    [core.sv, decode_mips.sv, exec.sv]
2026-06-06 fix sign-extension, serializing ops, and checker sync
    RTL: convert SYSCALL/BREAK/TLBR/TLBWI/TLBWR/ERET from serializing_op
    to oldest_first + block-allocation; add t_fault to ERET so it redirects
    via the machine-clear path on retire; sign-extend all MFC0 CP0 register
    reads (was zero_extend32); sign-extend ra link register for JAL/JALR/BAL/
    BGEZAL (full 64-bit PC arithmetic instead of zero-extended +8).
    harness: sign-extend resume_pc injection from 32-bit ELF load address;
    mask sparse_mem access through 29-bit physical address; fix dual-retire
    secondary checker comparison to use (uint32_t) casts — sign-extended RTL
    retire_two_pc was never matching zero-extended sim pc, losing sync after
    del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
    [decode_mips.sv, exec.sv, top.cc]
2026-06-06 loadelf: sign-extend ELF entry point into 64-bit PC
    ms->pc was assigned from a uint32_t, zero-extending kernel addresses
    (0x80xxxxxx) to positive 64-bit values instead of the correct negative
    sign-extended form (0xffffffff80xxxxxx). Cast through int32_t so all
    subsequent PC arithmetic in the interpreter — branch targets, J-type
    upper-bit extraction, and pc+4 increments — naturally produces
    sign-extended results matching the RTL.
2026-06-06 extend TLB tests (TLBWR, global bit) and fix no-checker termination
    Add TLBWR round-trip test: write entry via TLBWR, use TLBP to locate
    it, verify data with TLBR. Deliberately avoids reading the Index
    register after TLBP because the Random counter decrements every retire
    in the RTL but only on TLBWR in the interpreter, so slot numbers
    diverge between the two.
    Add global-bit test: write an entry with G=1 in both EntryLo halves to
    a fixed index, probe with a different ASID (must hit), then probe with
    a wrong VPN (must miss).
    Set run-tlb Makefile target to -c 0 since TLBWR involves the Random
    register which is non-deterministic from software's perspective.
    Fix top.cc: when checker is disab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
    [hello.c, top.cc]
2026-06-06 wire up D-side TLB: PA translation in tlb.sv, enable miss detection in l1d.sv
    tlb.sv: replace pass-through (pa <= va) with actual PFN-based translation.
    4KB pages only (pagemask=0 deferred for larger pages). VA[12] selects
    even (pfn0) or odd (pfn1) page; PA = {pfn[PA_WIDTH-13:0], va[11:0]}.
    Also populate dirty/writable outputs from d0/d1 and v0/v1 fields.
    l1d.sv: remove the `ifdef RESPECT_MAPPED` guards so TLB miss detection
    is always active for mapped (kuseg/kseg2) accesses. Unmapped segments
    (kseg0/kseg1) have active=0 which forces hit=1, so they are unaffected.
    tests/dside_tlb/test_dside_tlb.S: new test covering:
    - load via TLB even page (write via kseg1, read via kuseg -> verifies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
    [l1d.sv, tlb.sv]
2026-06-07 fix decode hazard: gate DQ fill on !oldest_first_pending
    Instructions were being decoded into the DQ while an oldest_first
    instruction (MTC0 to SR) was pending in the ROB. When KX=0 at
    decode time, SD/LD and other 64-bit ops fell through to the default
    uop.op=II in decode_mips.sv, causing a spurious RI exception on the
    first SD in main().
    Fix: suppress insn_ack and both DQ-push conditions while
    r_oldest_first_pending=1. Raw instruction bits sit in the l1i fetch
    queue; they are decoded after the oldest_first instruction retires,
    at which point the updated CP0 state (r_sr_kx=1) is already live.
    No pipeline flush or restart-PC computation needed; branch delay
    slots are handled naturally sinc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
    [core.sv]
2026-06-07 implement I-side TLB: translate kuseg fetch addresses and inject I-TLB faults
    Add a full instruction-side TLB (ISIDE=1 parameter) to l1i, shared with
    the D-side entry write path. On a mapped fetch, the ITLB translates VA→PA
    before the cache tag compare. A TLB miss (no entry) injects FETCH_TLB_MISS
    into the FQ; a TLB invalid (V=0) injects FETCH_TLB_INVALID. Both fold
    through the decoder (oldest_first) and raise the correct MIPS exception
    vector (0x000 for refill, 0x180 for invalid) at retirement. PC is saved
    to r_addrs at ROB allocation as BadVAddr.
    Tested: 1000/1000 --mapped-data --timer-irq (965 pass, 35 skip, 0 fail).
    [core.sv, core_l1d_l1i.sv, decode_mips.sv, l1i.sv]
2026-06-07 wire up FETCH_MISALIGNED: detect and raise AdEL on unaligned instruction fetch
    In l1i, check r_cache_pc[1:0] != 0 before the TLB fault path and inject a
    fault instruction (t_push_insn) into the FQ, with t_insn.misaligned driven
    live. In core, ARCH_FAULT now handles FETCH_MISALIGNED: sets cause=4 (AdEL)
    and saves the misaligned PC as BadVAddr via r_addrs at ROB allocation.
    Tested: 100/100 --mapped-data --timer-irq (94 pass, 6 skip, 0 fail).
    [core.sv, l1i.sv]
2026-06-07 add --mapped-insn csmith variant: .text in kuseg via I-TLB
    New startup (start_csmith_mapped_insn.S) installs 48 TLB entries for
    kuseg 0x200000-0x25FFFF in the .boot.reset section (kseg1) before
    jumping into kuseg .text, avoiding the chicken-and-egg problem where
    the first kuseg fetch would miss the I-TLB. Data/BSS/stack stay in
    kseg0, so only the I-side TLB is exercised.
    New linker script (baremetal_mapped_insn.ld) places .text at kuseg
    0x200000 with 1:1 VA→PA mapping; rodata/data/BSS at kseg0 0x80020000.
    run_tests.sh gains --mapped-insn flag (mutually exclusive with
    --mapped-data) and shows both mapped-data and mapped-insn status lines.
    Tested: 10000/10000 --mapped-insn --timer-irq (9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
2026-06-07 implement LL/SC (load-linked/store-conditional) in RTL and decoder
    - Add MEM_LL, MEM_LLD, MEM_SC, MEM_SCD opcodes to machine.vh and uop.vh
    - Decode MIPS opcodes 48/52/56/60 as LL/LLD/SC/SCD in decode_mips.sv;
    mark all four oldest_first=1 so only one is in-flight at a time
    - Add LL/LLD/SC/SCD dispatch in exec.sv mem_tail path
    - l1d.sv: add link register (r_link_reg/r_link_reg_val), set on LL/LLD
    response from port2 (cache hit) or port1 (miss/reload path), cleared
    on exception (clr_link_reg) or SC completion
    - SC two-phase: port2 sends early ack with correct result
    (t_port2_hit_cache && w_match_link2), cache write deferred to
    graduated-store port1 path using r_sc_should_write flag
    -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
    [core.sv, core_l1d_l1i.sv, decode_mips.sv, exec.sv, l1d.sv]
2026-06-08 Add 64-bit TLB format and mapped64 csmith variants
    RTL + interpreter: widen TLB to the R10000 64-bit format. PA_WIDTH 32->40,
    tlb_data_t gains region r[1:0], VPN2 widened to 27b (VA[39:13]), PFN to 28b
    (PA[39:12]). Add DMFC0/DMTC0 (rs=1/5) for 64-bit CP0 access; EntryHi/EntryLo
    writes use the full 64-bit format under dmtc0, the 32-bit slices under mtc0.
    Add XContext (CP0 reg 20). MFC0/MTC0/DMFC0/DMTC0 no longer rewrite the PC
    (they are oldest_first and don't restart the pipeline). Interpreter TLB
    staging now uses 64-bit cpr0_64 shadow registers.
    csmith: add --mapped64-data / --mapped64-insn flags that install the TLB via
    dmtc0 using the 64-bit register format. Install values are < 2^32, so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
    [decode_mips.sv, exec.sv, interpret.cc, tlb.sv]
2026-06-08 core: vector 64-bit TLB refills to the XTLB vector (0x080)
    A TLB refill taken while 64-bit addressing is active for the operating
    mode must use the XTLB refill vector (base|0x080) instead of the 32-bit
    TLB refill vector (base|0x000). Capture r_xtlb_refill in ARCH_FAULT
    (tlb_refill & any in_64b_*_mode) and select the offset in WRITE_EPC:
    refill -> 0x080/0x000, all other exceptions -> 0x180. Miss-vs-invalid
    vectoring was already correct (invalids use 0x180).
    Add tests/xtlb/test_xtlb.S: self-contained (own BEV=0 vectors, no crt0,
    magic-halt instead of break) refill test built in two variants. 64-bit
    fault -> VEC=XTLB (0x080); 32-bit fault -> VEC=TLB (0x000). Wired into
    tests/Makefile with a ru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
    [core.sv]
2026-06-08 core/exec: EXL-based exception model + EXL-gated refill vector
    Normal exceptions now set Status.EXL on entry (was ERL); ERL is reserved
    for reset/NMI/cache-error. ERET implements level precedence (clear ERL if
    set, else clear EXL) and returns to EPC (ErrorEPC not yet implemented).
    exec exposes sr_exl; the existing EPC-write guard (&~EXL) now correctly
    preserves EPC across nested exceptions.
    core EXL-gates the refill vector: a refill taken with EXL already set is a
    nested miss and falls through to the general vector (0x180) instead of the
    TLB/XTLB refill vector. BadVAddr/EntryHi/Context still update regardless.
    Tests: add MODE_NESTED variant (EXL=1 refill -> VEC=GEN) and a self-contained
    te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
    [core.sv, exec.sv]
2026-06-08 tests: make except test self-contained so its handler reaches 0x180
    Previously test_except.elf linked against crt0.o, whose .except_vec "break"
    stubs occupied 0x000..0x180, so the real handler was appended at 0x80000304
    and never ran -- the SYSCALL hit crt0's break stub and the test stalled.
    Rewrite as self-contained (own _start and own vector at .org 0x180, no crt0)
    and halt via the magic-halt register. Now exercises the EXL exception/ERET
    path end-to-end: SYSCALL -> 0x80000180 handler -> ERET -> verify handler ran
    and EPC pointed at the SYSCALL. Build without crt0; run-except uses -c 0.
    Result: "Exception / ERET test / Returned from handler via ERET / PASS".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
2026-06-08 decode CACHE (opcode 0x2f) as NOP
    Previously CACHE fell through to the illegal-instruction (II) path, which
    would trap a kernel's cache-init loops. Decode it as a NOP in both the RTL
    (decode_mips.sv, mirroring PREF) and the interpreter (interpret.cc, like
    the existing prefetch 0x33 case) so RTL and checker agree.
    Add tests/xtlb/test_cache.S: executes several CACHE ops and prints
    CACHE-OK; passes on both RTL (-c 0) and the checker. Wired into run-xtlb.
    csmith RTL-only regression unaffected (5/6, 0 fail).
    [decode_mips.sv, interpret.cc]
2026-06-08 cp0: implement read-only PRId (CP0 reg 15), R4000 value
    PRId previously read as 0 in the RTL. Return a named processor-id value and
    make the interpreter agree. Define PRID_R4000/R4400/R10000 constants in
    machine.vh (RTL), interpret.hh (checker) and sim.h (tests); select R4000
    (0x00000400) for now. PRId is read-only: the RTL has no register to write,
    and the interpreter now ignores MTC0/DMTC0 to reg 15; cpr0_64[15] is
    initialized so DMFC0 matches MFC0.
    Add tests/xtlb/test_prid.S: MFC0/DMFC0 read PRID_VALUE and an attempted
    MTC0 write leaves it unchanged. Passes on RTL and checker. Wired into run-xtlb.
2026-06-08 docs: add SGI IP22 platform reference (addr map, MC, HPC3, UART)
    Capture the IP22 (Indy/Indigo2) details gathered for Linux64 bring-up, from
    indy_docs/{mc,hpc3}.pdf and the linux-mips source:
    - kernel load/entry addresses (64-bit load 0xffffffff88004000 -> PA 0x08004000;
    entry kernel_entry 0xffffffff8830e898); vmlinux.32 loads via existing load_elf
    - MC registers @ 0x1fa00000 incl MEMCFG0/1 (0xc0/0xc8) memory-size config
    - HPC3 @ 0x1fb80000/0x1fb00000, PBUS PIO external regs at 0x58000 + ch*0x400
    - UART/console = Zilog 85230 SCC @ physical 0x1fbd9830 (HPC3 ch0 PBUS PIO ch6);
    data reg 0x1fbd9837/0x1fbd983f
    - sim integration plan (reuse sgi_mc/sgi_hpc; add SCC Tx->stdout) and current
    boo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
2026-06-08 implement TNE (trap if not equal, SPECIAL funct 0x36)
    Only TEQ was implemented; TNE decoded as an illegal instruction. GCC/kernel
    code (e.g. cpu_probe) emits tne, so a 64-bit MIPS Linux boot took an illegal-
    instruction exception at the first tne. Add TNE in uop.vh, decode_mips.sv,
    exec.sv (mirroring TEQ with !=), the interpreter (case 0x36), and mips_insns.hh.
    Verified: xtlb/eret/except suite passes; csmith 6/6; kernel boot advances past
    the former tne derail.
2026-06-08 top: add --memdump hexPA:hexLEN:file to dump physical memory at exit
    Lets us read the kernel printk ring buffer (__log_buf) from a -c 0 run when no
    console is up yet, which is how the early-boot panic was diagnosed.
2026-06-08 arcs: provide root component (SGI-IP22) so the kernel identifies the machine
    prom_identify_arch() calls GetChild(NULL) and reads the root component's iname
    to match a machine; with no component tree it printed "ARCH: Unknown" and
    panicked. Add a child_component stub returning a root linux_component whose
    iname is "SGI-IP22". This both fixes the panic and (via PROM_FLAG_USE_AS_CONSOLE
    set on the match) brings up the ARC console -> our Write stub -> real output:
    Linux version ... / ARCH: SGI-IP22 / CPU0 revision is: 00000400 (R4000SC)
    ... reaches "MC: Probing memory configuration:".
2026-06-09 Fix L1/L2 cached/uncached coherence, LL/SC oldest-first clear, SC success; advance IP22 Linux boot
    - l1d: fix make_mask for 64-bit MEM_LD/MEM_SD; refactor 64-bit load/store to
    merge_cl64/select_cl64/bswap64; on an uncached access that aliases a resident
    L1 line, write back (if dirty) + invalidate before the uncached op; make SC
    success depend on the reservation (link), not on a cache hit.
    - l2 (inclusive of L1): on an uncached access that hits a resident L2 line,
    write back to memory (if dirty) + invalidate before the uncached op.
    - core: clear r_oldest_first_pending on the second dual-retire port too — an
    oldest-first LL/SC retiring as the 2nd of a pair left the bit stuck, starv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
    [core.sv, core_l1d_l1i.sv, exec.sv, l1d.sv, l2.sv, sgi_mc.cc, top.cc]
2026-06-09 remove davids print statements
2026-06-09 interp: hardwire $0 to zero in execMips; add FPGA/IP22 address-map doc
    - interpret.cc: force gpr[0]=0 at the top of execMips. The checker never re-zeroed
    $0, so `mflo $0` (used by the kernel's r4k-bugs64.c to discard LO) corrupted the
    zero register. gcc never writes $0 so csmith never exercised it; ports the fix
    found while bringing up the standalone interp_mips functional sim.
    - docs/fpga_address_map.html: full rewrite of the IP22 physical-map / FPGA bring-up
    reference. Authoritative CPU map (mc.pdf p.22), the 4GB->sub-512MB compaction
    contract, boot-ROM-at-0xBFC00000 plan for IRIX, PL-vs-ARM device split, the
    memory-sizing / no-guest-bus-error analysis (MAME mc.cpp + SGI PROM 0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
    [interpret.cc]
2026-06-09 l1d: raise TLB Modified/Invalid per R4400; rename tlb writable->valid
    The dtlb's permission outputs were never consumed, so stores to a non-dirty
    page silently succeeded (broken SW dirty-bit tracking) and accesses to a
    valid=0 entry used a bogus translation.
    - tlb.sv: drive dirty(D)/valid(V) outputs to 1 when !active (unmapped kseg0/1),
    mirroring the hit forcing, so ckseg0 accesses never fault on a non-matching
    entry's bits. Rename the misnamed `writable` port to `valid` (it carries V).
    - l1d.sv: wire .dirty/.valid; add, after the refill check, V==0 -> tlb_invalid
    (load+store) and is_store && D==0 -> tlb_modified (no write). Per R4400 the
    store-to-valid-but-not-dirty case is TLB Mod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
    [l1d.sv, l1i.sv, tlb.sv]
2026-06-10 single-step support, headless vivado scripts, 64b-mode-hazard TDD tests
    single-step: new single_step/step pins on core / core_l1d_l1i. One
    architectural commit per 0->1 edge on `step` (r_step_credit gates
    t_can_retire_rob_head and t_retire_two). Driven on-board via AXI control
    reg port 4 (bit31 = mode, bit30 = step pulse); read32(7) = last PC.
    HW-validated on the FPGA.
    rebuild.sh / rebuild.tcl: headless Vivado IP-refresh + synth/impl flow.
    mipscore.v: regenerated single-file Verilog (s2v) matching this RTL.
    tests/test64: TDD harness characterizing the 64-bit-op-after-mode-
    changing-mtc0 Reserved-Instruction hazard (a daddiu RIs against the
    stale decode-time 64-bit mode). test64d reproduces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
2026-06-10 fix serializing-op restart in branch delay slots (64b mode hazard + Case 2)
    Route mtc0/dmtc0 to serializing_op (restart-on-commit). The WAIT restart
    now uses the in_delay_slot ternary: a serializing op in a branch delay
    slot restarts to the branch's resolved target, else pc+4. The Case-2
    ternary had been mis-applied to the fault branch; the WAIT line itself
    was still plain target_pc.
    - exec.sv: t_pc default = pc+4 (serializing restart pc; branches override)
    - decode_mips/uop.vh/rob.vh: carry pred_target onto the uop and ROB entry
    - core.sv: WAIT n_restart_pc = in_delay_slot ? r_last_branch_target
    : target_pc; latch last retired branch target on is_br|is_call|is_indirect;
    folded-j target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
    [core.sv, decode_mips.sv, exec.sv, l1i.sv]
2026-06-10 guard sim-only $stop calls with `ifdef VERILATOR (formal-compat)
    Three $stop error-checks (l2 protocol busted, mem queue full/empty) were
    unguarded, breaking `yosys read_verilog -formal`. Guard them like the
    existing $stop sites so formal.ys -> yosys-smtbmc works.
    [l1d.sv, l2.sv]
2026-06-11 MIPS core+interp co-sim fixes; random instruction test framework
    RTL l1d.sv: fix big-endian swl at a word-aligned addr (was a no-op:
    byte-enable 4'b0000 + data path kept the existing word). Found by
    fuzzing, validated across ~65k random co-sim seeds.
    RTL core.sv: single-step credit fix (level-based step edge); FORMAL
    asserts P-rob-adjacency / P-restart-pc under `ifdef FORMAL.
    interpret.cc (all caught by the generator): RI on 64-bit ops in 32-bit
    mode; sign-extension/width fixes for srlv, srav, div, addiu, mult.
    top.cc: --step_hold (FPGA-like step waveform); drop init-latency probe.
    tests/randgen: seeded MIPS-III instruction generator + parallel co-sim
    runner (all c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
    [core.sv, interpret.cc, l1d.sv, top.cc]
2026-06-11 P-mode-hazard: convert the RI mode-check into a formal assert + cover
    The inline mode-hazard check (an is_ii/RI committing whose fetch-time
    64-bit mode differs from the current committed mode) is now:
    - a Verilator $stop in the is_ii commit path (catches it in the fuzzer)
    - a clocked `ifdef FORMAL assert (P-mode-hazard) in the formal block
    Supporting state: add mode_when_fetched to the rob/uop (rob.vh, uop.vh),
    stamp it at decode (decode_mips.sv), compute w_in_64b_mode in core.sv.
    Add a cover on (ARCH_FAULT && is_ii): it documents that the free-stream
    BMC stalls ~step 12 and never reaches a committed RI, so P-mode-hazard is
    vacuous in BMC. Real coverage is the 65k-seed sim $stop + FPGA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
    [core.sv, decode_mips.sv, top.cc]
2026-06-12 fix 64b mode hazard (r_sr_ie blocking assign) + gate debug trace infra
    Root cause of the FPGA-only daddiu Reserved-Instruction after a
    mode-changing mtc0: a lone blocking `=` in the clocked Status flop
    block (r_sr_ie = reset ? 0 : n_sr_ie), plus the n_sr_* next-state
    logic sitting in an always_ff. Verilator scheduled the race
    favorably (always passed); Vivado made the mode-bit write ~50/50
    metastable on silicon. Fix:
    - exec.sv: n_sr_* next-state block always_ff -> always_comb
    - exec.sv: r_sr_ie `=` -> `<=` in the r_sr flop block
    Validated on silicon: 180/180 kernel-entry runs pass (was ~50%);
    vmlinux now clears kernel_entry and boots through the daddiu-bug
    check, cache probe, MC init, an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
    [core.sv, core_l1d_l1i.sv, exec.sv, top.cc]
2026-06-12 arcs: fix garbled console — poll FIFO-full before pushing chars
    stub_write blasted `mtc0 $7` (console push) in a tight loop with no
    flow control. The console FIFO is only 8 deep with no HW backpressure
    on push, so during printk bursts the ring overflowed and laps itself
    (wr==rd reads as empty mid-line) -> duplicated/dropped fragments.
    The HW exposes the full flag via `mfc0 $7` bit0 (exec.sv reg7 read);
    honor it: spin until not-full before each push. No RTL/bitstream
    change needed -- just rebuild arcs_fw.bin. Verified: vmlinux console
    is fully clean through Initmem on silicon.
2026-06-12 faulted-delay-slot funnel: gate dmtc0 to 64b mode + simplify WAIT handler
    - decode_mips.sv: gate dmtc0 by w_in_64b_mode so it RIs in 32-bit mode
    like daddu (was mode-exempt). NOTE: this does NOT make the WAIT
    faulted case reachable -- the RI rewrites op->II which strips
    serializing_op, so it never enters the funnel. Carries a Linux-boot
    regression risk if the kernel ever uses dmtc0 in 32-bit (KX=0) mode.
    - core.sv: WAIT_FOR_SERIALIZE_IN_FAULTED_DELAY_SLOT faulted branch --
    replace the old $stop/$display("hello???") debug guard with
    n_state=ARCH_FAULT + t_bump_rob_head (the //todo path).
    - CLAUDE.md: record findings -- funnel ENTRY is a mispredicted branch +
    serializing (mtc0/dm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
    [core.sv, decode_mips.sv]
2026-06-13 CpU (coprocessor-unusable) op + FPU/IRIX bring-up study docs
    RTL — add a dedicated Coprocessor-Unusable op (CP0 cause 11) mirroring II's
    fold/alloc/fault plumbing:
    - decode_mips.sv: COP0 instructions gated on in_kernel_mode (else -> CPU op);
    dmtc0/dmfc0 gated on w_in_64b_mode (RI in 32-bit mode, like daddu)
    - uop.vh / rob.vh: CPU op + is_cpu ROB field
    - core.sv: fold + t_arch_fault + ARCH_FAULT cause=11 for CPU (mirrors is_ii)
    Validated: kernel-mode randgen sanity 80/80; directed supervisor-mode mtc0 -> cause 11.
    Docs — study/bring-up notes toward an FPU and booting IRIX on r9999:
    - FPU_PORT_STUDY.md: FP plumbing/dataflow grafted from mipscore@superscalar
    - FPU_ROUNDING_EXCEPTIONS.md: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
2026-06-13 cp0: functional WatchLo/WatchHi (r18/r19) register interface
    IRIX's start does `mtc0 zero, c0_watchlo/watchhi` (defensive init), so r9999
    must accept the write (and read it back) without faulting. No watch-match
    hardware or Watch (ExcCode 23) delivery is needed — the kernel never programs
    a watch address. Modeled on the Compare register: store on mtc0 r18/r19, read
    back on mfc0, reset to 0; next-state in always_comb, flop via r_X <= n_X.
    Also fixes a stale `// always_ff` comment on the n_sr/n_count always_comb block
    (leftover from the mode-hazard always_ff->always_comb conversion).
    Validated: build clean, kernel-mode randgen sanity 40/40, directed
    write->read-back test passes, sv2v elabo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
    [exec.sv]
2026-06-13 interp: model branch-delay-slot exceptions (fixes a pre-existing co-sim divergence)
    The interpreter (co-sim checker) mishandled an exception raised by an instruction
    in a branch/jump delay slot -- the RTL was correct; the interp was the bug. Two
    problems, both pre-existing (reproduce on main), found via the 8h csmith soak:
    1. The exception was SWALLOWED: every branch/jump handler ran the delay slot then
    unconditionally set s->pc = target, overwriting the exception vector that the
    faulting delay-slot insn had set -- so the interp took the branch and skipped
    the exception while the RTL vectored. Add run_delay_slot(): only take the
    branch/jump if the delay slot did NOT raise an ex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
    [interpret.cc]
2026-06-13 CACHE instruction: serializing whole-cache flush (steps 1-2)
    Implement the MIPS CACHE op (0x2f) for IRIX code-coherence. The caches are
    non-coherent and non-inclusive (L1D writeback -> L2, L1I refill <- L2), so
    CACHE must do real work, not NOP. MVP: decode CACHE as a serializing op that,
    at the serialize point, pulses a whole-cache flush of both L1I+L1D (the
    core_l1d_l1i arbiter chains the L2 flush), waits for all three completes, then
    restarts -- a refetch is mandatory once L1I is nuked. This pushes any patched
    D-line to L2 and forces the I-side to refetch it. Reuses the FLUSH_FOR_HALT
    complete handshake; no EA / I-D routing / fake-completes (those are the
    deferred per-line optimization).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
2026-06-13 CACHE: per-line D-side writeback (flush_cl) instead of whole-D flush
    D-ops (cache select bit insn[16]=1) now drive the surgical per-line flush_cl
    at EA=base+offset, MEM_SW'ing just the addressed dirty line to L2 -- exactly
    the code-coherence push -- instead of flushing the entire D-cache on every op.
    I-ops still nuke the whole L1I (which chains the arbiter's L2 flush).
    - CACHE_OP decodes srcA=rs, imm=offset; exec computes t_result=srcA+sign_extend
    (imm), which lands in rob.data and is used as flush_cl_addr.
    - flush_cl bypasses the whole-flush arbiter (goes only to L1D), so the completes
    differ by op type: fake the non-participating completes at funnel entry so
    CACHE_FLUSH keeps its un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
2026-06-13 CACHE: 0x11 D-Hit-Invalidate (no-writeback / DMA-in)
    D-Hit-Invalidate (op 0x11, Hit-Invalidate operation insn[20:18]==100) must
    DROP a dirty line without writing it back -- a device DMA'd fresh data into
    memory and the stale cached copy must be discarded, not flushed over the new
    data. Because the caches are non-inclusive, the drop must hit both L1D and L2.
    - decode: cache_inval = (insn[20:18]==3'b100); carried uop_t -> rob_entry_t.
    - core: new flush_cl_inval output (plumbed through core_l1d_l1i to l1d); the
    D-op funnel drives it and masks the EA to a physical address (kseg0/kseg1
    unmapped) so L1D can tag-match.
    - l1d FLUSH_CL: when flush_cl_inval, invalidate the line WITHOUT writeback,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
2026-06-13 CACHE: user-mode -> Coprocessor Unusable (CpU) privilege check
    CACHE is privileged; in user mode it must raise Coprocessor Unusable
    (Cause.ExcCode 11). Gate the 0x2f decode on in_kernel_mode exactly like the
    existing CP0 (coproc0) gate: kernel -> CACHE_OP, else -> op = CPU (folded,
    sets rob.is_cpu -> ARCH_FAULT cause 11). No interpreter change needed -- the
    interp doesn't model CP0 privilege, but csmith/randgen run in kernel mode
    (reset ERL=1), so the co-sim never executes a user-mode CACHE.
    test_cache_priv.S (RTL-only, -c 0, self-contained): maps useg 0x00400000,
    writes a "cache 0x0,0($0)" stub via the kseg1 alias, ERETs to user mode, and
    checks the resulting exception is CpU (ExcCode 11).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
    [decode_mips.sv]
2026-06-13 64-bit ops: always valid in kernel mode (decouple from KX)
    64-bit operations (sd, daddu, daddiu, dsll, ...) are always valid in Kernel
    mode on the R4000; KX gates 64-bit *addressing* and the XTLB-refill vector, not
    operation availability. Supervisor/User still require SX/UX.
    r9999 incorrectly gated the kernel 64-bit-op decode on KX
    (w_in_64b_mode = in_64b_kernel_mode|... where in_64b_kernel_mode = in_kernel &
    KX). Use the unconditional in_kernel_mode for the op-decode gate; the XTLB
    vector path (core.sv, w_in_64b_kernel_mode) is unchanged, so tests/xtlb still
    selects the XTLB vector on KX. interpret.cc matched for the co-sim.
    This fixes two things at once:
    - IRIX /unix boots past its earl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
    [decode_mips.sv, interpret.cc]
2026-06-14 l1d TLB: use the translated physical address for the tag check + replay
    The D-side TLB computed the translated PA (w_mapped_addr) but never used it: the
    port-2 hit check compared the VA tag (r_cache_tag2) and the miss queue stored
    the VA req (r_req2), so a mapped access tagged/refilled/replayed with the VA
    (1:1) -- non-identity mappings silently read the wrong physical line. (rv64core
    nu_l1d.sv does this right.)
    Fix (geometry: IDX_STOP==LG_PG_SZ, so the index is within the page offset =>
    VA index == PA index, no aliasing -- only the tag must be physical):
    - hit checks (t_hit_cache2, t_port2_hit_cache) compare r_tag_out2 against the
    translated physical tag w_tlb_tag2 = w_mapped_addr[PA_W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
    [l1d.sv]
2026-06-14 tlb: match the 32-bit VPN2 only (ignore R + upper VPN bits)
    A 32-bit kseg VA sign-extends (va[63:62]=11, va[39:32]=ff), but mtc0 writes
    EntryHi.VPN2 zero-extended (exec.sv ~2568), so the old match
    (vpn == va[39:13]) && (r == va[63:62])
    never matched a wired high-VA entry -- both the upper VPN bits and the R field
    mismatched. That is the IRIX wirepda wall: the wired PDA entry (high VA) never
    matched the I-fetch of the wirepda return. Match the 32-bit VPN2 (va[31:13])
    only; it uniquely identifies a page in the 32-bit address space. (Found via the
    interp_mips reference TLB.)
    Validated: test_xlate/test_wired/test_tlb/dside_tlb pass; xtlb still selects the
    XTLB vs TLB refill vector on KX (vect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
2026-06-14 decode: implement daddi (opcode 0x18, trapping 64-bit add-immediate)
    DADDI was in opcode_t + exec.sv (overflow-trapping add) but the decoder had no
    0x18 case, so daddi decoded to II -> Reserved Instruction. IRIX's
    call_prom_cached (0x8800653c) uses daddi and RI'd there once the TLB fixes let
    the boot reach it. Add the 0x18 decode mirroring daddiu (gated on 64-bit mode;
    exec already handles the op + overflow). randgen 150/150.
    [decode_mips.sv]
2026-06-14 Henry/IRIX: minimal Z8530 SCC serial model (console TX capture)
    MAME ground truth: the IRIX kernel prints by driving the IOC2 Z8530 SCC
    directly (arcs_write=0, romvec Write=0 over a full boot), so capturing console
    text needs a real (if minimal) SCC, not the ARCS Write hook.
    Add a TX-only Z8530 model at the IP22 IOC2 serial address (phys 0x1fbd9830, a
    new scc_regs range carved out of the HPC region). z80scc ab_dc decode (bit1 =
    channel A/B, bit0 = data/control): DATA-register writes transmit the byte to
    stdout; CONTROL reads return RR0 with Tx-Buffer-Empty set so the du driver's
    "ready to transmit?" poll always succeeds. top.cc dispatches the SCC window
    byte-granular (SCC registers are byte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
2026-06-14 Henry/IRIX: ARCS shim for direct /unix boot (SPB + 35-entry romvec)
    Synthetic ARCS firmware for a sash-less/PROM-less IRIX boot, per the MAME
    ground truth in IRIX_CPU_REQUIREMENTS.md: a valid SPB at phys 0x1000 ("ARCS",
    SPBLength 72, ver 1.10) pointing at a 35-entry FirmwareVector (standard ARCS
    order: Write=27, GetMemoryDescriptor=18, GetEnvironmentVariable=30, ...) and a
    13-entry PrivateVector. Live romvec stubs: Halt/PowerDown/Restart/Reboot ->
    clean sim halt, GetMemoryDescriptor -> one free-RAM descriptor, GetChild ->
    root "SGI-IP22" component, Write -> CP0 putchar; others return 0. The running
    kernel only calls the romvec once (GetEnvironmentVariable), so this is mostly
    correct in-memor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
2026-06-14 arcs_irix: getenv returns an SGI eaddr (MAC) instead of NULL
    IRIX init_sysid does etoh(getenv("eaddr")); a NULL return -> etoh(NULL) ->
    lbu 0(0) -> fault. Return a fixed SGI MAC string (08:00:69 OUI). With the RTL
    TLB fixes + this, the boot leaps from ~1.4M to ~81.8M cycles and prints an
    actual IRIX kernel panic through the Z8530 SCC; next wall is cfc1 (FPU) RI'ing
    because the FP plumbing (fp branch) isn't on this branch.
2026-06-14 docs(IRIX_KERNEL_GAPS): MAME-session TLB/CP0/PA reqs + cache-op boot histogram
    Findings from driving headless MAME (indy_4610, R4600/mips3) with breakpoints
    and C++ interpreter instrumentation:
    - TLB: 48 dual-entry JTLB confirmed (matches r9999), boot is 4KB-only (3000
    writes, 100% PageMask=0), R4000 blind-tlbwr refill path, Wired=8 at start.
    - PA: 29-bit (512MB) platform ceiling; PFNs only ~28 bits used.
    - CP0: steady-state timekeeping via on-chip Count/Compare; Status.FR=1 used
    once N32/N64 userland runs (FP regfile must support FR=1, no FP arith yet).
    - cache instruction: 5.2M ops over a 120s boot; four primary-cache ops are
    99.94% (D-IdxWBInval 28.5%, I-IdxInval 28.5%, D-HitWBInval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
2026-06-14 top: [exc] probe — print EPC + faulting insn on EXL-rise
    Pairs with the existing [sr] mode-transition print: on the cycle Status.EXL
    goes 0->1, decode the EPC's instruction and print it, so boot/exception walls
    are identified immediately (e.g. the IRIX cfc1 FPU wall at 0x8801b978). Debug
    instrumentation for the direct-/unix-boot effort now on main.
2026-06-14 exec/interp: fix signed ADD/SUB overflow detection (2 bugs)
    Surfaced by the cheritest import (BUGS_FOUND.md, category-a).
    BUG1 — overflow read un-forwarded operands: the adder uses the forwarded
    t_srcA/t_srcB, but the overflow predicates compared against the raw PRF reads
    w_srcA/w_srcB, which hold stale values on same-cycle forwarding -> spurious
    Arithmetic Overflow trap when an operand came from a just-issued producer.
    Fix: compute overflow from t_srcA and the effective addend (w_imm for
    ADDI/ADDIU, else t_srcB) -- the same operands the adder consumes. This also
    makes ADDI/DADDI overflow correct (they were comparing against w_srcB, the
    immediate form has no register srcB).
    BUG2 — SUB/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
    [exec.sv, interpret.cc]
2026-06-14 exec/interp: decode the trap + REGIMM branch-and-link instructions
    Decode gaps surfaced by the cheritest import (BUGS_FOUND.md bugs 3-4) — these
    all RI'd before:
    - register traps TGE/TGEU/TLT/TLTU (TEQ/TNE already decoded)
    - trap-immediates TGEI/TGEIU/TLTI/TLTIU/TEQI/TNEI
    - branch-and-link BLTZAL/BLTZALL/BGEZALL (BGEZAL already decoded)
    To stay within the 7-bit opcode enum, the immediate trap forms reuse the
    register-trap ops with srcB_valid=0 (exec compares srcA against the sign-
    extended immediate instead of srcB); TEQ/TNE/BGEZALL ops are reused too. Only
    6 new opcodes (BLTZAL/BLTZALL/TGE/TGEU/TLT/TLTU).
    decode_mips.sv: REGIMM rt=16/18/19 (b-and-link, 18/19 likely) + rt=8..14
    (trap-imm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
    [decode_mips.sv, exec.sv, interpret.cc]
2026-06-14 interp: remove MIPS32 SPECIAL2/SPECIAL3 instructions (not in MIPS-III)
    ~5-year-old vestigial support for instructions the R4000 RTL doesn't decode
    (and that the cheritest import flagged as category-c divergences because the
    interpreter executed them while the RTL RI'd):
    - SPECIAL2 (op 0x1c): madd, maddu, mul, msub, clz -> execSpecial2 deleted
    - SPECIAL3 (op 0x1f): seb, seh, ext, ins, rdhwr -> execSpecial3 deleted
    Both opcodes now raise_ri in the interpreter, matching the MIPS-III RTL, so
    co-sim agrees (both RI). Dead mipsInsn enum entries removed. Verified: a raw
    SPECIAL2 mul RIs with ExcCode 10 and is co-sim clean; randgen 200/200.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
    [interpret.cc]
2026-06-14 FP plumbing: GPR<->FPR moves + FP loads/stores (FR=1), checker fixed for mips3/4
    Graft the FP move/load/store datapath from mipscore@superscalar into r9999.
    Actual FPU arithmetic is deferred; this is moves + ld/st only, FR=1 flat
    32x64-bit FP registers (mips3/4), validated by directed co-sim tests.
    RTL (rename + mem pipe + L1D):
    - uop.vh/rob.vh/core.sv: FP register file + rename (FP free list, FP RAT,
    per-source int-vs-FP mux, ROB valid_fp_dst, retire-free). MEM_MOV op;
    fp_dst threaded through mem_req_t/mem_rsp_t.
    - exec.sv: FP PRF (r_fp_prf) + inflight; GPR<->FPR moves routed through the
    L1D as MEM_MOV carrying data in the request addr field (mtc1/mfc1 =
    sign_extend32(src[31:0]));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
    [core.sv, decode_mips.sv, exec.sv, interpret.cc, l1d.sv]
2026-06-14 FP randgen hammer + fix 2 cross-domain (int/FP) RTL bugs found by it
    Extend tests/randgen/gen_mips_test.py with an FP unit (mtc1/mfc1 moves +
    lwc1/swc1/ldc1/sdc1 loads/stores, even FP regs only since gas rejects odd
    under .set mips3) and a preamble that inits every even FP reg (the FP PRF
    has no HW reset). 900/900 co-sim seeds clean after the fixes below.
    The hammer exposed two bugs, both because int and FP physical-register
    numbers share one space, so a mem response tagged FP must be excluded from
    int-domain logic:
    - exec.sv: int scheduler wakeup + operand bypass matched a source pdst
    against mem_rsp_dst_ptr gated only on mem_rsp_dst_valid. An FP load whose
    FP pdst equalled an int op'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
    [exec.sv, l1d.sv]
2026-06-14 fp: register the FP register-file reads (rf4r2w-style synchronous read)
    The FP PRF read ports were combinational (w_mem_fp_srcB = r_fp_prf[mem_uq.srcB],
    r_fp_prf[mem_dq.src_ptr]), unlike the int PRF (rf4r2w) which uses registered
    reads -- the silicon-proven pattern. Vivado inferred the FP PRF as a Block RAM
    with "Read Address Register Found" + a read/write collision warning, i.e. the
    Verilator-passes/FPGA-might-not class.
    Add registered read ports r_fp_rd_srcB (mfc1 source) and r_fp_rd_dq (FP store
    data), folded into the FP-PRF write always_ff. The read address is the
    combinational head (t_mem_uq.srcB / t_mem_dq.src_ptr) so the registered output
    lands aligned with mem_uq / mem_dq -- identic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
    [exec.sv]
2026-06-14 fp: widen opcode_t + rob.opcode + retire_op to 8 bits
    The FP ops (LWC1/SWC1/LDC1/SDC1/CFC1/CTC1) plus main's trap/branch-and-link
    ops push the opcode enum past 127, so opcode_t became [7:0] (uop.vh). Widen
    the matching 7-bit holders to avoid Verilator WIDTH errors: rob_entry_t.opcode
    and the retire_op/retire_two_op debug ports.
    Validated on fp: fpu/overflow/traps co-sim clean, randgen 200/200, build clean.
    [core.sv, core_l1d_l1i.sv]
2026-06-14 docs: IP22 chip-register reference + MAME-session question log
    - IP22_CHIP_REGISTERS.md: MC/IOC/VDMA register maps mined from SGI docs
    (arcs_spec, indy_docs/ip22) with corrections to the MAME-derived findings.
    - MAME_QUESTIONS.md: the r9999 <-> MAME-session ground-truth question log.
2026-06-14 fp: ldc1/sdc1 are legal in 32-bit mode (drop the 64-bit-mode gate)
    ldc1/sdc1 are FP load/stores — they need the FPU (CU1), not 64-bit *integer*
    addressing mode — so they must decode regardless of w_in_64b_mode (they were
    mistakenly gated like integer LD/SD). The interpreter already dispatched them
    unconditionally, so this closes a latent 32-bit-mode RTL-vs-interp divergence.
    tests/fpu/fp_dldst.S (+ run-fpu): 64-bit FP store->load round-trip. -c 0 PASS,
    co-sim clean, randgen 200/200.
    [decode_mips.sv]
2026-06-14 interp: implement DADDI (opcode 0x18) to match the RTL
    The RTL decodes+executes DADDI (trapping 64-bit add-immediate, 64-bit-mode
    gated; commit 19208ee) but the interpreter RI'd opcode 0x18 -- a latent co-sim
    mismatch (randgen/directed tests never emit DADDI). The interp_mips session
    surfaced it: real IRIX hits a DADDI (@0x8800653c) and the interpreter wrongly
    RI'd it. Add it: 64-bit add-immediate, trap on signed overflow (formula matches
    RTL w_add64_overflow), gated in is_64b_gated like daddiu (RI in 32-bit mode).
    tests/except/test_overflow.S: + daddi non-overflow (no trap) + 64-bit overflow
    (traps, cause 12). -c 0 PASS, co-sim 0 divergences, randgen 200/200.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
    [interpret.cc]
2026-06-14 add FPGA csmith soak tooling (ooo_core golden, board-driven)
    End-to-end csmith regression on the FPGA, validated sim-vs-silicon:
    - build_one.sh generate+build one FPGA-runnable (mapped) csmith ELF
    - build_batch.sh pre-build N ELFs; bake the manifest from ooo_core (the
    exact RTL on the board), QEMU kept only as a cross-check
    - gen_manifest.sh bake/refresh a manifest from ooo_core for any dir of
    binaries (the NFS path: no QEMU/source needed)
    - run_fpga_regression.sh dev-box-in-loop: build, deploy, run, diff vs QEMU
    - soak_board.sh runs ON the ARM: loop the manifest, compare each FPGA
    checksum to the ooo_core golden, pa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
2026-06-14 add printf.c/arith64.c (bare-metal support deps for csmith soak builds)
    build_one.sh links these from hello/ into the FPGA-runnable csmith ELFs;
    they were untracked so a fresh checkout couldn't build a batch.
2026-06-15 cheri: run alu/branch/cp0 standalone on the FPGA (ooo_core golden)
    - common/dump.s: __putc now spins on the putchar-FIFO-full flag (mfc0 $7
    bit0) before pushing. Without backpressure the ~640-char register dump
    overflows the 8-deep console FIFO on silicon (the AXI driver drains far
    slower than the core pushes); harmless in ooo_core, which drains instantly.
    This is what kept the R<dd>= dump from ever appearing on the FPGA.
    - fpga/build_batch.sh: bake the ooo_core R<dd>= dump as the golden for each
    buildable test (sim-vs-silicon: same RTL as the board) and collect the ELF.
    - fpga/soak_board.sh: runs ON the ARM -- per test, run the ELF, capture the
    dump (kill mips-axi once 32 R-li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
2026-06-15 cheri: extend FPGA harness to mem/tlb; log uncached-SCD silicon bug
    mem/tlb run standalone on the FPGA via the same ooo_core-golden harness:
    mem 41 goldens, tlb 5 (the other 13 tlb tests $stop ooo_core at core.sv:1542,
    the faulted-delay-slot serialize funnel, so they yield no golden).
    mem/tlb result: 45 pass / 1 fail of 46. The fail is a real sim-vs-silicon
    divergence (BUGS_FOUND.md BUG 3): mem_test_raw_scd_uncached -- uncached
    (XKPHYS CCA=2) SCD reads back 0 on silicon (deterministic), while the cached
    SCD and ooo_core return the stored value. Uncached SC-reservation / store
    path is the suspect (LL/SCD newly added). Quarantined in build_batch.sh
    alongside the timing-nondeterministic cp0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
2026-06-15 interp: model the LL/SC link (R10000 conservative) + RED test for the RTL gap
    The interpreter treated the LL/SC link as a no-op (SC always succeeded). Now it
    models the reservation exactly (in-order, so exact): LL/LLD set {valid,line}
    (16B, LG_L1D_CL_LEN=4); any intervening normal load/store, exception, ERET, or
    interrupt clears it; SC/SCD succeed iff valid && same line, then clear. Clearing
    is wired centrally: set_exc_pc (all exceptions), raise_int, the ERET case, and a
    dispatch-level clear on the normal load/store opcodes (NOT CACHE/SYNC/PREF/tlbp/
    fpr-move, to match the eventual RTL op set: all MEM ops except LL/LLD/SC/SCD/
    TLBP/INVL/MOV).
    Validated safe: compiles, randgen 40/40 (no LL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
2026-06-15 MAME_QUESTIONS: add Q2 (KPTEBASE / linear-page-table bootstrap)
    From the interp_mips/analyzer session: the functional sim now boots past
    wirepda to ~10.5M insns and hits the next VM wall -- a nested TLB-refill
    miss in the self-mapped page-table region (~0xff800000) because only the
    PDA is wired and init_pmap hasn't run. Asks the MAME oracle to dump wired
    slots 0-7 and identify who installs slots 1-7 (PROM vs kernel), testing the
    hypothesis that the PROM pre-loads wired page-table mappings the kernel
    inherits.
2026-06-15 LL/SC: selectable reservation model (BERI default / R10000), tracked in-order
    The link is now maintained at the in-order first pass (l1d.sv port2; the OOO
    retry/port1 path is not consulted) and the model is a compile-time switch
    (machine.vh LLSC_BREAK_ON_LOAD, mirrored in interpret.hh; RTL + interpreter
    kept in sync so the co-sim agrees):
    default = BERI/CHERI: a STORE to the linked line breaks the link; loads and
    stores to other lines do not.
    LLSC_BREAK_ON_LOAD = R10000 conservative (p.27): any intervening load/store
    breaks it.
    Empirical justification: scanning Linux vmlinux.32 found 2781 LL/SC pairs with
    0 intervening loads/stores -- real code never puts a memo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
2026-06-15 cheri/BUGS_FOUND: record that ingress serialization (#1) does not fix the back-to-back-SC torture; the fix is a per-in-flight-SC write-enable (#2)
    Tried gating atomic ingress on an SC-in-port-stages flag -- did not help: the
    corrupting SCD is already in mem_q, and the race is the SCD's own port1 write
    vs the shared r_sc_should_write flop in its mem_q replay, not an inter-SC
    ingress race. Real fix = carry w_match_link2 in the SCD's mem-queue entry.
2026-06-15 l1d: a failed SC/SCD must not forward its store data to a later load
    A load to the same line as an in-flight FAILED store-conditional forwarded the
    SC's store data (store->load forwarding via r_must_forward / r_array_wr_data,
    l1d.sv ~1000/1151) instead of the unchanged line. The reservation itself was
    correct -- the failed SC's array write is gated off (t_wr_array && r_sc_should_write)
    and the cache line is never modified -- but t_array_data for MEM_SC/MEM_SCD was
    the merge with the SC's data computed REGARDLESS of r_sc_should_write, so the
    forwarding path still handed it out.
    Fix: gate the merge -- t_array_data = r_sc_should_write ? merge(...) : t_data.
    A failed SC now leaves t_array_data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
    [l1d.sv]
2026-06-16 exc: gate Cause.BD on EXL==0 (R4000); fix interp EPC/BD; nested-EPC test
    R4000: EPC and Cause.BD update only when Status.EXL==0 -- a nested exception
    (e.g. a TLB miss inside the refill handler) must preserve the original EPC so
    its ERET retries it (the IRIX self-mapped-page-table refill relies on this;
    see RTL_HANDOFF.md / interp_mips IRIX_BOOT_NOTES).
    The RTL already gated the EPC write (exec.sv:2582); this adds the matching gate
    for Cause.BD (n_exc_in_ds) and fixes interpret.cc set_exc_pc, which updated both
    EPC and BD unconditionally. Both are R4000-conformance fixes; note the co-sim
    checker compares neither EPC nor k0/k1, so the interp bug was latent (no
    observable divergence) -- confir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
    [exec.sv, interpret.cc]
2026-06-16 docs: MAME-oracle co-sim answers (Q4, Q5 rounds 1-6) + RTL handoff note
    MAME_QUESTIONS.md: Q4 (16 MB / mconfig0=0x23200000, kernel reads MC directly)
    and Q5 retired-instruction co-sim + rounds 1-6 — CPU-ID/PRId (R4600 0x2020),
    Config/cachecolormask (0x0002e4b3), IOC2 SYSID (0x26), the ARCS/sash
    argc/argv/envp handoff (the doc had a1=a2=0, actually argv/envp), the device-
    register + CP0 batch, romvec value-matching (FW[30] GetEnvironmentVariable,
    PrivateVector[1] env-table), and the KPTEBASE/kptbl page-table-backing analysis
    (kvalloc must write the valid leaf PTE; kmissnxt resolves the self-reference).
    RTL_HANDOFF.md: ask the r9999 RTL session to verify the page-table-backing
    (kptbl[c00000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
2026-06-16 RTL_HANDOFF: answer the KPTEBASE/nested-EPC item -- not a r9999 RTL bug
    r9999's RTL already gates the EPC write on Status.EXL==0 (exec.sv:2582) and the
    refill vector on ~EXL (core.sv:1582), so a nested TLB miss preserves EPC and
    eret retries correctly -- the wall that bit interp_mips cannot occur here. The
    original kptbl[c0000000]==0x1 premise was superseded by interp_mips's own
    same-day finding (EPC-on-nested-exception). Records the conformance cleanups
    landed in 701db1e, the co-sim GPR-only caveat, and the real next blocker (no
    IRIX boot flow in the RTL sim).
2026-06-16 Config: present R4600 cache geometry (0x0002e4b3) for IRIX pagecoloralign
    IRIX's mlreset derives cachecolormask from the CP0 Config cache-size
    fields; with the wrong value pagecoloralign loops forever. Present the
    R4600 value 0x0002e4b3 (16 KB I$ + 16 KB D$, 32-byte lines, SC bit 17 =
    no secondary cache) so mlreset derives cachecolormask=1 and
    pagecoloralign converges (MAME_QUESTIONS.md Q5 round-2). SC=1 still
    makes the kernel skip the scache probe (was 0xa8200 in RTL / 0x88200 in
    interp).
    exec.sv (mfc0 Config) + interpret.cc (init) both updated to match.
    randgen 1000/1000 co-sim clean; the IRIX boot now clears pagecoloralign
    and advances to the genuine KPTEBASE page-table-backing wall.
    Co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
    [exec.sv, interpret.cc]
2026-06-16 docs: Q6 answer — RTL IOC2 SYSID read is in wrong byte lane
    getsysid's lw at phys 0x1fbd9858 must return 0x00000026 (SYSID in
    bits[7:0]); the RTL likely places 0x26 in bits[31:24] so the kernel's
    low-byte mask sees 0x00 and mis-detects the board. First trace
    divergence at line 168,599; upstream cause of the 0x838e000 bzero wall.
2026-06-16 tests/devregs: directed IRIX-boot device-register check (vs MAME golden)
    Reads the boot-critical SoC device registers (MC sysid/mconfig0/1, IOC2
    SYSID, HPC regs) and checks them against MAME's golden kernel-visible
    values, plus write/read-back on the R/W MC registers. Run via the Henry
    SoC harness for the RTL device models:
    henry_tb --kernel devregs/test_devregs.elf
    Complementary to the MAME retired-PC diff: it catches value-only device
    bugs the PC-diff misses (the kernel reads a register without branching on
    it). It already found the MC sysid bug (kernel saw 0x03000000, MAME wants
    0x00000013 -- fixed in the henry_soc HPC/MC model). The 3 HPC checks are a
    deliberate red baseline for regis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
2026-06-17 TLB: gate CAM match on valid bit + reset valid bits (fixes IRIX wirepda on FPGA)
    tlb.sv matched on VPN2+ASID/Global without checking valid, and r_tlb was never
    reset, so on silicon a reset/tlbinit-filler entry could alias the wirepda PDA VA
    through the loose 19-bit VPN compare and be selected by find_first_set -> bogus
    PFN 0x6828e -> out-of-range PA -> AXI hang. Verilator inits r_tlb to 0 so it
    never manifested there. Fix mirrors rv64core: gate w_hits on (v0|v1) and reset
    per-entry v0/v1 on reset.
    Batched session work:
    - l1d.sv: report the faulting VA for BadVAddr, not the zero-extended PA
    - arcs/: self-contained IRIX PROM (arcs_boot: SCC heartbeat + argv/envp handoff +
    jr /unix) + romvec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
    [core.sv, exec.sv, l1d.sv, tlb.sv]
2026-06-17 l2: add UNCACHE_WB_TURNAROUND to fix AXI deadlock on uncached store aliasing a dirty line
    An uncached store/load whose line is resident-and-dirty in the L2 makes the
    L2 write the dirty line back (UNCACHE_WB_DRAIN) and then issue the uncached
    op. The old code re-asserted mem_req in the same cycle the writeback response
    arrived, with no gap. The AXI master's WAIT state gates WAIT->IDLE on mem_req
    dropping, so the back-to-back request deadlocked the AXI bus (axi state stuck
    at WAIT). Verilator's flat memory model has no AXI WAIT, so it never reproduced.
    Repurpose the dead GAMEOVER state ('d14) as UNCACHE_WB_TURNAROUND: on the
    writeback response, drop mem_req for one turnaround cycle before re-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
    [l2.sv]
2026-06-17 arcs_irix: remove SCC_MARK romvec progress markers
    The per-stub SCC_MARK chars (W/M/E/C/P/D/H) were an FPGA progress tracer, but
    they write to the SCC DATA port which routes to the console -- so they leaked
    into the IRIX banner ("EDIRIX..."). Drop the macro and all call sites now that
    the boot reaches the root-device prompt; console output is clean.
2026-06-17 tlb: mode-aware VPN2+R match (correctness; does NOT fix the kptbl panic)
    The TLB match compared only the low 19 VPN2 bits (va[31:13]) unconditionally,
    ignoring the region R (va[63:62]) and upper VPN2 (va[39:32]). In 64-bit
    addressing that can alias distinct high kernel VAs sharing va[31:13]. This change
    makes the match architecturally correct -- full VPN2+R in 64b mode, low-19 in 32b
    mode -- and fixes the companion mtc0-EntryHi zero-extend so explicitly-written
    high-VA entries (IRIX tlbwired) carry R + upper VPN2.
    IMPORTANT (corrected claim): this was originally committed believing it fixed the
    silicon "tlbmiss: invalid kptbl entry" panic. IT DOES NOT. A 30x IRIX soak on the
    FPGA still pani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
    [core_l1d_l1i.sv, exec.sv, l1d.sv, l1i.sv, tlb.sv]
2026-06-17 tlb: Sail-spec unconditional full VPN2+R match (supersede the KX-gated match)
    Replace the Status.KX-gated match (which fell back to a loose low-19 compare in
    32-bit addressing) with the spec's unconditional full match, per the Sail model
    (sail-cheri-mips mips/mips_tlb.sail tlbEntryMatch/tlbSearch):
    r = va[63:62], vpn2 = va[39:13];
    hit iff valid & (r == entryR) & (vpn2 == entryVPN, page-masked) & (asid | G).
    No mode switch and R is always compared -- the spec has no 32-bit shortcut. This
    removes the now-unneeded in_64b_mode plumbing (tlb.sv port + l1i/l1d/core_l1d_l1i).
    exec.sv already writes EntryHi.R/VPN2 from the full GPR (also per Sail MTC0), so
    this is self-consistent. The earlier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
    [core_l1d_l1i.sv, l1d.sv, l1i.sv, tlb.sv]
2026-06-18 arcs: add arcs_linux firmware (Linux-correct memory descriptor for henry)
    arcs_irix boots IRIX on henry but its GetMemoryDescriptor reports the RAM
    block as Type 1 (arcs_rvpage = RESERVED in Linux's arch/mips/fw/arc
    memory.c) and only 16 MiB -- so Linux sees zero free memory and panics in
    __memblock_alloc_or_panic. arcs_linux = arcs_irix with the descriptor fixed
    to Type 2 (arcs_fcontig = free) and 128 MiB, matching arcs_fw. With it (and
    console=arc), henry boots IP22 Linux past mem init to "clocksource: Switched
    to clocksource MIPS". arcs_irix is left untouched so IRIX still boots.
2026-06-18 arcs_linux: driver-patchable kernel entry (boot stub for FPGA)
    The arcs_boot stub (--start-pc 0xa0003000) builds argv/envp + jumps to the
    kernel. Make the entry kernel-agnostic: instead of a baked-in immediate, the
    stub reads a PATCH SLOT at blob offset 0x40 (kseg1 0xA0001040). The FPGA driver
    writes the loaded kernel's ELF e_entry there (big-endian) before starting the
    core, so one firmware boots any kernel. Defaults to the current vmlinux.32
    entry (0x8832c118) when unpatched. Validated on henry_tb via --start-pc
    0xa0003000: heartbeat -> Linux banner.
2026-06-18 tlb: out_of_range output for Sail PA>MAX_PA(36b) Address-Error (WIP)
    Toward Sail TLBTranslateC conformance: a matched entry whose PFN
    (pa[39:12]=pfn[27:0]) overflows PA_WIDTH=36 — i.e. pfn[27:24]!=0 — is
    silently truncated by w_pa4k today. Add an out_of_range flag (asserted
    only for mapped entries; unmapped/active=0 PAs are in-range) and route it
    through l1d/l1i toward an eventual AdEL/AdES. Not yet raising the exception.
    [l1d.sv, l1i.sv, tlb.sv]
2026-06-18 arcs: IP22-faithful first-stage boot loader (FSBL) for the Linux ARCS firmware
    Restructure arcs_linux into a PROM-resident FSBL: arcs_boot @ 0xBFC00000
    (the CPU reset vector) copies the ~3 KB SPB/romvec block into RAM at
    0xA0001000 at reset, then stages argv/envp and jumps to the kernel. The
    ARCS callback stubs stay in the Boot PROM; the romvec entries (copied to
    0xA0001000) point back at them. New arcs_linux.ld links the SPB block at
    VMA 0xA0001000 with its LMA in the PROM (AT>); the FSBL does the ROM->RAM
    copy via _spb_lma/_spb_vma/_spb_size.
    This matches the real IP22 layout: only the tiny SPB sits in low memory
    (which the MC System Memory Alias folds into the bottom of DRAM @
    0x08001000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
2026-06-19 plumb new interrupt delivery
2026-06-19 core: software interrupts (Cause.IP[1:0]) + r9999-TB interrupt-input tests
    exec.sv: capture the only software-writable Cause.IP bits (IP0/IP1) on
    mtc0 Cause into r_ip0/r_ip1 and feed them into w_ip[1:0] (was tied 0), so
    software interrupts pend.
    Tests (r9999-only TB, -c0): tests/swirq raises IP0/IP1 via mtc0 Cause;
    tests/extirq injects IP2..IP6 via the TB (R9999_ASSERT_IP); baremetal_support
    exc_handler now splits ExcCode-0 into external IP[6:2] (record + mask IM),
    software IP[1:0] (record + clear Cause.IP), and timer IP7. All pass
    (checksum 3 / 4 / 16 / 64).
2026-06-19 tests: g_pit_mode for INT3 8254-timer ack in the baremetal exc handler
    baremetal_support.c: when g_pit_mode is set, exc_handler acks IP4/IP5 (the
    INT3 8254 timers) via the Timer Clear register (0xBFBD98A0) and keeps IM
    enabled so a periodic timer re-fires, instead of the default extirq path
    that masks IM[N]. Defaults to 0, so existing extirq/swirq behavior is
    unchanged. Consumed by the henry SoC tests/pit timer-interrupt test.
2026-06-19 gitignore sim run outputs; untrack committed test artifacts
    Add log.txt/pushout.txt/branch_info.txt (ooo_core/henry_tb run outputs) to
    .gitignore (*.elf/*.dis/*.mips already ignored), and untrack the artifacts
    that were committed into tests/extirq, tests/swirq, and tests/timer.
2026-06-19 tests: fix INT3 Timer Clear byte address (slot+3, 0xa3)
    IOC2 byte registers sit on the low byte lane (slot+3) per the kernel struct
    sgint_regs ("u8 _pad[3]; volatile u8 reg;"), so the g_pit_mode Timer Clear ack
    must target 0xBFBD98A3, not 0xBFBD98A0. PIT test re-validated green.
2026-06-19 arcs: unify firmware as henry_arcs -- one FSBL blob boots Linux + IRIX
    The IRIX boot failure was firmware, not the CPU: arcs_irix.bin was a stub-style
    blob (linked low, loaded at pa 0x1000, entry 0xa0003000), but the loaders moved
    to the FSBL address 0x1fc00000 when Linux's FSBL was added -- so the IRIX stub
    was fetched as garbage and wedged.
    Fix: ONE FSBL firmware (henry_arcs.S, was arcs_linux.S) boots both. IRIX ignores
    a1/a2 and reads everything from the SPB, so the Linux entry convention (a0=argc,
    a1=argv, a2=envp) works for both; the driver/TB patches the kentry slot per kernel.
    Verified in the henry Verilator sim: Linux -> /init, IRIX -> banner.
    Drop the now-dead stub firmware arcs_i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
2026-06-19 TLB: drive cacheability from the entry C field + full user/sup/kernel AdEL
    Two architectural TLB completions, both validated in sim.
    C-bit cacheability (the proper fix for the L2 UNCACHE_WB_TURNAROUND
    workaround): the C field was already stored (tlb_data_t.c0/c1) and decoded
    from MTC0 EntryLo[5:3], but the tlb module never output it, so l1d fell back
    to mipsseg's segment hardcode -- a cacheable mapped store could be routed
    uncached. tlb.sv now exposes a registered cache_attr (page-mux of c0/c1, in
    lockstep with pa); l1d applies it at the remap point: for a MAPPED access
    cacheability = (C==3), unmapped keeps the segment decision. No extra pipeline
    stage, and the CAM already holds c0/c1 so th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
    [exec.sv, l1d.sv, l1i.sv, mipsseg.sv, tlb.sv]
2026-06-20 fix BEV=1 exception vector base 0xbfc00000 -> 0xbfc00200 (R4000/Sail item 3)
    The R4000 (and Sail exceptionVectorBase) BEV=1 base is 0xBFC00200, not
    0xBFC00000 -- so BEV=1 exceptions vectored 0x200 too low (TLB refill to the
    reset entry 0xBFC00000, general to 0xBFC00180 instead of 0xBFC00380). Latent
    (OS clears BEV before paging; bare-metal tests run BEV=0) but a real conformance
    gap. RTL = the base; checker = its 6 general-exception sites hardcoded 0xBFC00180
    ignoring BEV, now BEV-aware exc_vector_general() matching interp_mips (already
    correct). Validated: 600/600 co-sim, 300/300 BadVAddr, except/cache, Linux+IRIX.
    [core.sv, interpret.cc]
2026-06-20 TLB: VA out-of-range Address Error (Sail item 1 VA half), SEGBITS-parameterized
    A mapped, non-compat 64-bit VA whose in-region address exceeds SEGBITS
    (VA[61:SEGBITS]!=0) now raises AdEL/AdES instead of sending an out-of-range VA to
    the bus. New SEGBITS define in machine.vh (40=R4000, 48=R10000) -- also bounds
    the VPN/CAM width, so it funds the address-narrowing thrust. mipsseg computes
    w_va_oor (compat sign-extended form exempt; unmapped segs use the PA>MAX_PA
    check). Removed the debug $display that w_va_oor made flood on speculative ops.
    Checker/interp_mips deferred: randgen masks its EAs into kseg0 so it never trips
    the check (co-sim stays green) and the directed test is -c0 (RTL self-ch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
    [exec.sv, mipsseg.sv]
2026-06-20 TLB: narrow PFN to PA_WIDTH-12 (PFN_WIDTH), enforce PA-range by construction
    pfn0/pfn1 were 28 bits (40-bit PA) but PA_WIDTH=36 -> PFN is 24 bits. New
    PFN_WIDTH define; tlb_data_t / EntryLo regs / MTC0 extraction / 64b read-back all
    track it. Saves 384 bits of the 48-entry TLB CAM (shrinks the route-congested
    array) and removes the translate-time |w_pfn[27:24] out-of-range check (now
    impossible -- PA = {pfn,off} is exactly PA_WIDTH). out_of_range tied 0; the l1d
    bad_addr-from-oor path is now dead (left for a follow-up cleanup).
    Validated: 400/400 co-sim, All TLB tests passed, test_va_range PASS, Linux+IRIX boot.
2026-06-20 RF: drop the zero-reg read mux on FPGA/sim to unblock register-file BRAM
    The rf4r2w rdptr==0 -> 0 mux made the int-PRF banks "infeasible" for BRAM (Vivado
    fell back to LUTRAM). $0 / phys-reg-0 is provably never written (dst_valid=(rd!=0);
    phys 0 reserved in the free list + never freed) and the RF inits to 0 (BRAM/
    bitstream INIT; Verilator zeroes state), so the mux is redundant there. Guard it
    on `ifdef FPGA: drop it for FPGA + sim (BRAM-friendly, -1 2:1 mux per read port),
    keep it for targets without a power-up-zero guarantee (e.g. ASIC SRAM).
    Validated: co-sim 300/300, test_tlb. IRIX boot variance (0x29 dominant) confirmed
    unrelated -- this run-to-run earlier alarm was not a regression.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
2026-06-20 i-side instruction-fetch Address Error (AdEL via FETCH_ADDR_ERROR)
    Raise AdEL (ExcCode 4) on an access-level / VA-out-of-range INSTRUCTION
    FETCH, completing the i-side half of the Sail TLBTranslate access checks
    (the d-side shipped earlier).
    Option C -- harvest, don't recompute: l1i already instantiates mipsseg for
    the fetch VA and computed bad_perms but discarded it (the ".bad_perms() //
    TODO" stub). Connect it, flop it (r_bad_va), carry one bit (bad_va) in
    insn_fetch_t next to misaligned/tlb_miss/tlb_invalid -- so NOTHING new lands
    on the l1i critical path (the segment decode already runs there). decode
    turns bad_va into a new FETCH_ADDR_ERROR uop, prioritized ABOVE tlb_miss (an
    out-of-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
    [core.sv, decode_mips.sv, l1i.sv]
2026-06-20 tests/henry: bare-metal test harness booted via the henry_arcs FSBL
    The mapped bare-metal runtime (start_csmith_mapped.S) hangs at "state 1" on
    the Henry FPGA. Boot tests like the kernel instead: link an ordinary ELF at
    a cached kseg0 address and let the FSBL (henry_arcs.bin @ 0xBFC00000) hand
    off to it -- the mips-axi driver patches the FSBL kentry slot with the ELF's
    e_entry. kseg0 is unmapped+cached, sidestepping the mapped-runtime wall.
    henry_crt0.S set $sp, zero .bss, call main, magic-halt on return
    henry_io.h putch/puts/puthex via the CP0-$7 console (= ARCS stub_write)
    henry.ld kseg0 0x88010000 text, 0x88070000 stack
    hello.c banner + sum(1..100)==5050 self-che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
2026-06-20 tests/csmith: port FPGA regression to the FSBL/kseg0 flow
    The FPGA csmith regression built bare-metal ELFs with the MAPPED runtime
    (start_csmith_mapped.S + baremetal_mapped.ld, run --sgi 1), which loads and
    starts but hangs at "ready!, state 1" before main on the Henry SoC FPGA
    (project_henry_baremetal_runtime_broken).
    Boot the tests like the kernel instead: link everything in cached, unmapped
    kseg0 and hand off from the henry_arcs FSBL.
    start_csmith_fsbl.S kseg0 crt0: set $sp, zero .bss, call main, magic-halt
    csmith_fsbl.ld all sections in kseg0 (0x88010000 text, 0x8c000000 stack)
    build_one.sh use the FSBL crt0 + linker (own .support_fsbl cache)
    run_fpga_regression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
2026-06-21 checker: store full 64-bit link register (no sext32 truncation)
    The embedded co-sim checker saved gpr[31]=sext32((uint32_t)(PC+8)) at all
    four link sites (jal/jalr and both branch-and-link). That drops bit 32+ of a
    64-bit return address. It's a no-op for the current co-sim (sign-extended
    kseg0/low PCs), but it diverges from the RTL, which computes the full
    int_uop.pc[M_WIDTH-1:0]+8. Store the full value to match the hardware and
    remove the latent truncation (same class as the interp_mips fix).
    randgen co-sim sweep 600/600 pass.
    [interpret.cc]
2026-06-21 decode: WAIT -> NOP (kernel idle loop no longer RI-faults)
    r9999 has no low-power halt, so the WAIT opcode (cop0 CO, insn[5:0]=32) was
    unhandled and fell through to the default II -> the kernel idle loop (r4k_wait)
    RI-faulted, and the preceding mtc0 c0_sr made that II also trip the P-mode
    $stop. Decode WAIT as NOP (same approach as CACHE->NOP) so the idle loop spins
    with interrupts enabled. This unblocks Linux to reach userspace (/init).
    randgen co-sim sweep 600/600 (randgen never emits WAIT, so no behavior change
    for existing tests).
    [decode_mips.sv]
2026-06-21 cp0: store + report Status CU0 (was hardcoded 1) for the kernel from-user test
    cpr0_status_reg hardcoded CU0=1 (the coprocessor-usable bits were tied high,
    never stored). The IP22 kernel uses CU0 as its from-user/from-kernel indicator
    in the exception entry (handle_int: "sll k0,3; bltz" extracts CU0 -- kernel runs
    CU0=1, userspace CU0=0). With CU0 stuck at 1, every USERSPACE interrupt looked
    "from kernel" -> handle_int skipped the kernel-stack switch and the gp recompute,
    used the user gp(=0), and faulted on ld 32(gp) = 0x20 -> an infinite TLB-refill
    livelock that blocked Linux from running /init.
    Add an r_sr_cu0 flop, capture Status[28] on mtc0 c0_sr, and report it (reset=1).
    NOT enforced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
    [exec.sv]
2026-06-21 tlb: match on a per-slot written bit, not (v0|v1) — fix demand-paging livelock
    The TLB match required (r_tlb[i].v0 | r_tlb[i].v1), i.e. an entry only counted
    as a match if at least one of its two pages was valid. That conflated two
    different states: an unwritten reset slot (v0=v1=0, garbage VPN) and a
    legitimately-installed not-present entry (v0=v1=0, REAL VPN). The latter is the
    normal demand-paging case: the refill handler, finding a not-yet-present PTE,
    does tlbwr with v0=v1=0. Excluding it from the match meant the retry took
    another Refill instead of TLB-Invalid, so do_page_fault was never reached and
    the page was never allocated -- an infinite-refill livelock that blocked Linux/
    IRIX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
    [tlb.sv]
2026-06-22 fix save_to_tlb_regs latch: make it a one-shot pulse (PC=0 /init crash)
    r_save_to_tlb_regs is meant to fire for exactly one cycle in ARCH_FAULT to
    snapshot BadVAddr/Context into the CP0 TLB regs. Its always_comb default was
    `n_save_to_tlb_regs = r_save_to_tlb_regs;` (hold), so once set it LATCHED past
    ARCH_FAULT into ACTIVE until the next fault cleared it.
    Consequence (Linux /init crash, and the suspected IRIX boot randomness): while
    the bit was still stuck high, exec.sv's EntryHi always_comb gives
    save_to_tlb_regs priority over a dmtc0 c0_entryhi write. A demand-paging
    __update_tlb that does `dmtc0 EntryHi; tlbp; ... tlbwi` then had its
    EntryHi.VPN2 clobbered from the intended VPN to core_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
    [core.sv, exec.sv]
2026-06-22 CLAUDE.md: disambiguate "synth/build" — ask r9999 (core) vs henry (SoC)
    Two FPGA bitstreams both output ultra96v2_oob_wrapper.bit: r9999/ultra96
    (bare core, no SCC/RTC/HPC3 — can't boot IRIX/Linux) and henry (full IP22 SoC,
    required for IRIX/Linux). When the user says "synth/build/rebuild/deploy" without
    qualifying, ask which; "core"/"mipscore" => r9999, "soc"/"henry" => henry.
    Documents both build flows + the same-filename deploy-clobber trap. Records the
    lesson from a bisect wasted building r9999/ultra96 chasing an "IRIX regression"
    that was just the no-SCC FSBL spin (prev.bit was a henry bit).
2026-06-23 l1d: store->load forward match index-only (was comparing VA tag vs PA tag)
    t_cm_block compared the incoming load's UNTRANSLATED VA tag against the store's
    physical tag. The cache is VIPT (tag = translated PA) and the dtlb PA output is
    registered, so for any MAPPED access (VA != PA) the forward was wrongly
    suppressed -> the load read stale array data -> every mapped store->load
    round-trip silently corrupted (kernel exec handed /init a wrong $sp; /init's
    first stack reload returned 0 -> a3=null -> vsnprintf SIGSEGV; on FPGA, wrong
    csmith checksums + apparent "boot randomness").
    Fix: index-only forward match (matches rv64core nu_l1d). The index is within the
    page offset (VA index == PA index);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
    [l1d.sv]
2026-06-25 tests/henry: SCC console-throughput experiment (CP0 / SCC polled / SCC Tx-IRQ)
    Bare-metal Henry-SoC test (contest.c) that writes 10000 chars via three console
    paths and reports the CP0 reg-23 free-running cycle delta for each:
    - CP0 reg-7 putchar FIFO (~438 cyc/char)
    - SCC chanA Tx, polled on RR0 (~606 cyc/char)
    - SCC chanA Tx, interrupt-driven via IP2 (irqvec.S handler at 0x80000180,
    placed by henry_irq.ld)
    This exposed the henry ioc.sv SCC control-write bug (the control-write data byte
    was dropped, so WR1.TxIE could never be set -> the SCC Tx interrupt never fired
    -> Linux interrupt-driven console TX stalled). Note: the IRQ method's bare-metal
    handler currently hangs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
    [contest.c]
2026-06-25 fpu: port mipscore FP ALU (add/sub/mul + compare/FCR) into r9999
    Re-introduces the floating-point execution unit, following the structure of
    ~/code/mipscore's FP ALU rather than a bespoke design.
    - leaf units brought verbatim from mipscore: fpu.sv + fp_add/fp_mul/
    fp_compare/fp_special_cases (+ fp_compare.vh). DEBUG_FPU left undefined so
    the real adder/multiplier is wired (not the bogo_* self-check path). Reuses
    r9999's identical count_leading_zeros.
    - decode_mips.sv: COP1 ADD/SUB/MUL.[sd], C.{LT,EQ,LE}.[sd], BC1{T,F,TL,FL}.
    - uop.vh/machine.vh: FP arith/compare/BC1 opcodes; FPU_LAT, LG_FCR_PRF_ENTRIES,
    LG_FP_UQ_ENTRIES.
    - core.sv/rob.vh: scalar FCR (FP cond-code) rename d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
2026-06-25 fpu: unify single/double FP adder into one fpu_add unit
    Replaces the two format-specific adders (fp_add #(.W(32)) + fp_add #(.W(64)))
    in fpu.sv with a single fpu_add.sv that handles both single and double,
    selected at runtime by an fmt input.
    - fpu_add.sv: one double-width datapath; single operands ride the low 32 bits
    (MIPS layout), extracted/packed and rounded once at the target precision.
    Self-contained (fpu_zero_detector + reuses count_leading_zeros).
    - fpu.sv: the two adder instances collapse to one fpu_add (fmt=is_double,
    sub=is_sub, en=any add/sub); the SP/DP adder result regs collapse to a single
    t_adder_result (already format-correct, zero-extended for single).
    - fp_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
    [fpu.sv, fpu_add.sv]
2026-06-25 fpu: unify single/double FP multiplier into one fpu_mul unit
    Mirrors the adder unification: replaces fp_mul #(.W(32)) + fp_mul #(.W(64)) in
    fpu.sv with a single fpu_mul.sv selected at runtime by fmt.
    - fpu_mul.sv: one double-width datapath; 53x53 significand multiply normalized
    from the [1,4) product, then fed through the SAME fmt-dependent rounding /
    pack / flags back-end as fpu_add (single runs left-justified so its round
    point lands at bit 29, identical to the adder -- one back-end serves both
    formats). Self-contained output pipeline; reuses no shared submodules.
    - fpu.sv: the two fp_mul instances collapse to one fpu_mul (fmt=is_double);
    the SP/DP mult result regs colla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
    [fpu.sv, fpu_mul.sv]
2026-06-25 fpu: plumb FCSR.RM into the fpu; sv2v-compat + test termination fixes
    - FCSR.RM: add an rm[1:0] input to the fpu module, fed from r_fcsr[1:0] in
    exec.sv (MIPS FCSR.RM encoding matches the units' 0=RN/1=RZ/2=RP/3=RM).
    CTC1 is serializing, so FCSR is stable for any FP op's lifetime -> reading
    r_fcsr combinationally at issue is correct. Replaces the hardwired rm=0 in
    fpu_add/fpu_mul.
    - sv2v compatibility for the henry SoC flow (per-file sv2v): fpu.sv now
    `include "uop.vh" (it references opcode_t), and handle_fcr's locals are
    renamed (fcr_in/t_hf) so they don't shadow module signals (shadowing trips
    sv2v's Scoper).
    - tests: -c 0 (no-checker) runs terminate on a magic-hal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
    [exec.sv, fpu.sv]
2026-06-25 fpu: abs/neg/mov + all 16 C.cond predicates (fixes ordered-compare-on-NaN)
    Phase A -- abs/neg/mov (.s/.d): single-cycle sign bit-ops on the existing
    convert single-cycle path (r_fp_wb_bitvec slot, fpu bypassed); single results
    zero-extend the low 32 bits. Opcodes SP/DP ABS/NEG/MOV.
    Phase B -- full FP compare set: generalize fpu_compare to the MIPS C.cond
    predicate {less,equal,unordered,signaling} carried as cond[3:0]; collapse the
    6 SP/DP_CMP_{LT,EQ,LE} opcodes to SP_CMP/DP_CMP with cond in uop.imm[6:3]
    (cc in imm[2:0]). decode matches all func 48..63. Checker fpCmp likewise
    generalized to all 16.
    BUG FIXED (real RTL defect): the compare result must force less/equal FALSE
    when unordered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
    [decode_mips.sv, exec.sv, fpu.sv, fpu_compare.sv, interpret.cc]
2026-06-25 fpu: Status.FR R/W + FR=0 odd-register FP-compute -> Reserved Instruction
    Part 1 of FR=0 (o32) support. Status.FR (bit 26) becomes a real R/W bit (was
    hardwired 1; resets to 1 = n32/n64 default) so the kernel can select FR=0 per
    o32 process, and decode can see it.
    In FR=0 the FPRs are 16 even/odd 32-bit pairs and arithmetic is even-register
    only (R10000 UM p.307). An odd register on an FP COMPUTE op is UNPREDICTABLE in
    the MIPS ISA -- it is wildly underspecified here: no mandated exception, and the
    Sail spec (sail-cheri-mips) doesn't even model FR (mips_prelude.sail: "RP/FR/RE/
    MX/PX not implemented"). The R10000 silently forces the low bit to 0 (odd->even);
    we refuse that silent fault and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
    [core.sv, decode_mips.sv, exec.sv, interpret.cc]
2026-06-25 fpu: FR=0 odd-register ldc1/sdc1 -> Reserved Instruction (Part 2a)
    In FR=0 a doubleword load/store names a 64-bit double by its even register; an
    odd register is invalid (R10000 UM p.305: "if the register selected is odd, the
    load/store is invalid"). LDC1/SDC1 are is_mem, so Part 1's is_fp gate didn't
    catch them -- an FR=0 odd-reg ldc1 was still silently executing as a full-64 load
    to the odd reg. Now decode faults it (RI / ExcCode 10), same loud choice as the
    odd-reg compute case; even-reg ldc1/sdc1 is unchanged full-64. Checker mirrors
    it (_ldc1/_sdc1).
    (Singleword lwc1/swc1/mtc1/mfc1 with odd regs are NOT faulted -- odd selects the
    high half; that merge/extract is Part 2b.)
    Test fp_f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
    [decode_mips.sv, interpret.cc]
2026-06-25 fpu: rest of the COP1 converts + catch-all Unimplemented-Op E-trap
    Converts:
    - CVT.W.s/d (round per FCSR.RM) + ROUND.W (RN) / CEIL.W (RP) / FLOOR.W (RM) --
    the existing fpu_f2i with the rounding mode fed in (TRUNC.W stays RZ); new
    CVT_W_S/D opcodes carry the rm in uop.imm (imm[2]=use-FCSR.RM, else imm[1:0]).
    - The .L (64-bit fixed) family: ROUND/TRUNC/CEIL/FLOOR.L + CVT.L (fpu_f2i
    dst_long=1) and CVT.S.L / CVT.D.L (fpu_i2f src_long=1). New CVT_L_S/D,
    CVT_S_L, CVT_D_L opcodes; all on the single-cycle convert path.
    Catch-all E-trap:
    - Any COP1 op not implemented in HW now decodes to FP_UNIMPL, which rides the
    fpu and raises the Unimplemented-Op (E) bit -> FPE (ExcCode 15, FCSR.Caus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
    [decode_mips.sv, exec.sv, fpu.sv, interpret.cc]
2026-06-26 core: populate mode_when_fetched in the ROB entry at alloc (both slots)
    The P-mode-hazard guard at ARCH_FAULT (and the formal assert) read
    t_rob_head.mode_when_fetched, but the ROB-allocation block never copied it from
    the uop -- it held whatever stale value the previous occupant of that ROB slot
    left. So the guard compared garbage: spurious P-mode mismatches (tripped by an
    RDHWR resumed across a Status update), and worse, it could mask a real 64b-mode
    decode hazard. Copy the field for both allocation slots. Debug/formal-only
    signal (dead in synth), so no functional/timing change to the bitstream.
2026-06-26 fpu: fix FP-exception drain deadlock; add checkpoint/fast-forward resume
    FP-drain deadlock (the coremark '%f hang'): a div.d in a branch delay slot takes
    the Unimplemented-Op(E) punt -> EXCEPTION_DRAIN, which holds ds_done/flash_clear
    high for the whole drain and waits for r_rob_inflight==0. An in-flight FP op
    could never clear its inflight bit, so the drain never exited. Three divergences
    from the mipscore FP source, all restored:
    - t_clr_mask was uq_wait|mq_wait, missing the FP scheduler's wait mask. Add
    fp_uq_wait (r_fp_uq_wait: set on t_push_*_fp, cleared on t_pop_fp_uq) so ops
    still parked in fp_uq get dropped from r_rob_inflight in one cycle.
    - r_fp_wb_bitvec / r_fp_iss_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
    [core.sv, exec.sv, fp_regfile.sv, rf4r2w.sv, tlb.sv, top.cc]
2026-06-26 l1d: skid-buffer bypass on the r_mem_q feed (-1 cycle load-to-use)
    Port of rv64core's combinational L1D-accept: when r_mem_q is empty and the L1D
    can accept (it latches core_mem_req into r_req2 + acks the same cycle), drive the
    freshly-AGU'd request straight to the L1D instead of enqueue-then-dequeue;
    back-pressure falls back to enqueue ("skid"). Behind `ENABLE_L1D_SKID.
    Saves the FIFO round-trip cycle on the common case -- the load-to-use latency that
    bounds pointer-chasing code (coremark core_list, the ~2 vs rv64core's ~5 CM/MHz
    gap). Measured (tests/memlat dependent-load chase, all L1D hits): load-to-use
    3->2 cycles, IPC 0.328->0.473 (+44%). Correctness: randgen 400/400 + FP co-sim
    15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
    [exec.sv, memlat.c]
2026-06-27 l1d: VIPT alias-safe tag (rv64core nu_l1d scheme) -- enables L1D > page size
    Take the cache tag down to LG_PG_SZ instead of IDX_STOP so it includes the
    VIPT alias bits (index bits above the 4KB page offset). A speculatively
    VA-indexed port-2 read then detects an alias (PA[12..] mismatch) as a tag
    miss and self-corrects via the existing physical-address miss-queue retry;
    fills are physical, so no synonym/duplicate lines form. Writeback-address
    reconstruction drops the tag's now-overlapping alias bits.
    No-op at the current 4KB direct-mapped config (LG_ALIAS_BITS=0,
    IDX_STOP==LG_PG_SZ): randgen co-sim 100/100 and coremark byte-identical.
    Validated at 8KB (LG_L1D_NUM_SETS=9): randgen 100/100 an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
    [l1d.sv]
2026-06-27 l1d/l2: writeback-through MEM_WB so CACHE D-writebacks reach DRAM
    CACHE D-writeback ops issued MEM_SW from FLUSH_CL, which only wrote the
    dirty line into L2 -- it sat dirty in L2 and never reached DRAM, so a
    non-CPU reader (HPC3 DMA / host disk service) saw stale memory.
    MEM_WB: l1d routes the FLUSH_CL dirty writeback through it; l2 on a hit
    flushes the carried line to DRAM + drops the L2 copy, on a miss writes
    straight to DRAM. Validated by tests/cache/test_cache_ops.S (DRAM oracle).
    [l1d.sv, l2.sv]
2026-06-27 tests/cache: directed DMA-descriptor coherence repro
    Minimal 4-case repro (no-flush / 0x15 / 0x15+0x17 / 0x01) that localized
    the stranded-in-L2 CACHE-writeback bug fixed by MEM_WB; complements the
    broader test_cache_ops.S matrix. Validated via henry_tb --dump (DRAM oracle).
2026-06-28 l2: clear dirty on clean-reload + invalidate (fixes DMA clobber); present R4400
    The L2 left the dirty bit set when a line was refilled from DRAM
    (CLEAN_RELOAD set valid/tag/data but never cleared dirty) or invalidated
    (MEM_INVL cleared valid only). A line that was invalidated/evicted then
    refilled came back valid AND spuriously dirty, so a later eviction wrote
    stale data back to DRAM -- clobbering a buffer the SCSI engine had just
    DMA'd. IRIX's disk INQUIRY then read free-list garbage and the disk
    wouldn't attach. Clear dirty on both paths.
    Also switch PRId R4600 -> R4400 and Config DB=1 -> 0: the old R4000/R4400
    boot divergence was a since-fixed TLB bug, and R4400's programmable L1
    line si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
    [exec.sv, l1d.sv, l2.sv]
2026-07-01 tests/henry: bare-metal SCSI DMA + PS<->PL ping-pong tests
    Directed henry-SoC tests for the new SCSI DMA controller + the cross-path
    ordering experiments:
    - scsi_read.c / scsi_write.c: program the WD33C93 + HPC3 descriptor, issue
    READ(10)/WRITE(10), and check the DMA'd buffer -- scsi_read verifies the SGI
    volume-header magic (0x0be5a941) at LBA 0; scsi_write round-trips write+read
    byte-exact via the disk overlay.
    - pingpong{,_c,_nc,_x,_xc}.c: bare-metal MIPS<->ARM ordering micro-tests
    (uncached / cached+invalidate / same-leg-DDR vs cross-path-S00) used to
    characterize the PS<->PL DDR/AXI ordering + the non-coherent HP read.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
    [pingpong.c, pingpong_c.c, pingpong_nc.c, pingpong_x.c, pingpong_xc.c, scsi_read.c, scsi_write.c]
2026-07-01 machine.vh/tlb/exec: N_TLB_ENTRIES knob for JTLB size (default 48)
    Single source of truth for the JTLB entry count. R4000/R4400 is
    architecturally 48 (IRIX + Linux hardcode it by PRId; there is no Config1
    MMU-size register on R4x00), so 48 is the default and the only value IRIX
    accepts. Wired through tlb.sv (N, r_tlb depth) and exec.sv (Random
    reset/wrap + shadow-TLB depth). Set 16 for a Linux-only timing-optimized
    build (also needs cpu-probe.c c->tlbsize=16; breaks IRIX).
    [exec.sv, tlb.sv]
2026-07-01 l1i: I-side micro-ITLB (always-miss v1) -- split the 48-way CAM to close timing
    The fully-associative 48-entry JTLB CAM was henry's #1 timing path. New
    itlb.sv registers the 48-way match (w_hits) so the CAM compare gets its own
    cycle; l1i fronts it with a WAIT_FOR_TLB state (modeled on RELOAD_TURNAROUND)
    that re-presents r_cache_pc to hold va while the 2-cycle JTLB settles, then
    consumes with the now-valid registered outputs. r_itlb_ready marks the primed
    cycle and clears every other cycle, so every mapped fetch re-primes
    (always-miss -- correctness first; a later step adds real micro-TLB entries
    so hits skip the ~cycle wait). core_l1d_l1i widens l1i_state to 4 bits for
    the new state.
    Gotch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
    [core_l1d_l1i.sv, itlb.sv, l1i.sv]
2026-07-03 exec: gate sticky-int_uop side effects (TLB-write spray + ERET EXL linger)
    Two RTL bugs, one disease: int_uop is a sticky register, and the big ALU
    always_comb case evaluates it every idle cycle it lingers (~15 cycles
    between issues). Side-effect intents computed there MUST be qualified by
    r_start_int (the one-cycle "op actually executing" pulse), like the CP0
    writes already were. Two were not:
    1. TLB-write spray: n_tlb_entry_out_valid stayed asserted while
    n_tlb_index=r_random re-latched a moving Random, so one TLBWR wrote
    ~5 TLB entries -- worse, a lingering stale TLBWR paired with the NEXT
    context's freshly-mtc0'd EntryHi staging, manufacturing entries no
    instruction ever w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
    [core.sv, core_l1d_l1i.sv, exec.sv, top.cc]
2026-07-03 CACHE hit-type D-ops via the mem pipe (dtlb-translated) -- IRIX mounts root
    The MIPS CACHE op flushed lines using PA = VA & 0x1fffffff -- the kseg0/1
    UNMAPPED rule. Correct for static kernel buffers, but IRIX invalidates its
    XFS buffer-cache lines (mapped K2SEG) for DMA'd disk reads, so a Hit-op on a
    mapped EA hit a garbage PA, the real line stayed stale, and the root
    superblock read wrong data -> vfs_mountroot EWRONGFS (errno 1011).
    Architecturally, Hit-type CACHE ops translate their EA like a load. This
    routes the primary-D Hit ops (Hit-Inval 0x11 / Hit-WB-Inval 0x15 / Hit-WB
    0x19) through the memory pipeline instead of the ALU+serialize funnel:
    decode_mips: 0x11/0x15/0x19 -> new mem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
    [decode_mips.sv, exec.sv, l1d.sv]
2026-07-03 machine.vh: revert ALU int scheduler to 8 entries (LG_INT_SCHED_ENTRIES 2->3)
    FIXES a userspace/console corruption regression. The 8->4 ALU integer
    matrix-scheduler downsize was bundled into 070c810's machine.vh; the 4-entry
    (LG=2) config MIS-ISSUES -> instruction replay. On henry (Verilator + FPGA
    impl_12): the Linux console banner garbles (each char emitted ~12x -- the
    string is intact but replayed), and BOTH IRIX init (SIGBUS) and Linux init
    (SIGSEGV) die in userspace. 8 entries (LG=3) boots Linux clean -- banner,
    VFS rootfs mount, healthy retirement.
    Bisected: board (noskid.bit Jun26 clean vs impl_12 garbled) -> Verilator
    repro -> git bisect 62cbd2f(clean)/070c810(garbled) -> peeled 0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
2026-07-03 exec: r_start_int-gate the reg7 putchar push (sticky-int_uop side effect)
    t_push_putchar was `t_wr_cpr0 & (int_uop.dst==7)` -- UNGATED. int_uop is a
    sticky register, so the reg7 putchar-FIFO push re-fired every idle cycle the
    mtc0 lingered (~10x when the ALU scheduler was slow to refill), producing
    repeated console characters ("LLLL...iiii..." = "Linux..." each char ~10x).
    Same class as the TLB-spray/ERET sticky-int_uop gates added in 070c810 --
    that commit fixed those two but missed the putchar. The 4-entry scheduler
    (LG_INT_SCHED_ENTRIES=2) merely EXPOSED it (long idle gaps); 8 entries masked
    it. So this is the true root cause of the console garble, independent of
    scheduler size.
    Fix: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
    [exec.sv]
2026-07-04 l2: write-back dirty line on MEM_INVL (was silent drop) -- fixes init SIGSEGV
    MEM_INVL invalidated a dirty L2 line WITHOUT flushing it to DRAM. A dirty L2
    line arises when an L1D eviction (MEM_SW) lands valid data in L2 that hasn't
    reached DRAM; a bare drop loses it. copy_page hits this: src/dst alias in the
    VIPT direct-mapped L1D (page-offset index), the dirty dst line is evicted to
    L2, then a coherence CHWBINV whose L1D line is already gone issues a plain
    MEM_INVL -> the copied GOT word is lost -> userspace jalr $t9=0 -> SIGSEGV ->
    init dies. Now MEM_INVL of a dirty line writes w_d0 back to DRAM (reusing the
    MEM_WB/UNCACHE_STORE path) before invalidating.
    Verified on the interp->henry_tb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
    [l2.sv]
2026-07-04 l2: drain dirty-INVL writeback through the turnaround gap (fixes silicon AXI deadlock)
    The MEM_INVL dirty-writeback added in 0e09e92 went straight to UNCACHE_STORE,
    re-asserting mem_req with no gap. The AXI master gates WAIT->IDLE on mem_req
    dropping, so back-to-back mem_req without the turnaround DEADLOCKS the PS<->PL
    AXI on silicon (the wirepda class; henry_tb's DRAM model acks instantly so sim
    missed it, and the first deploy wedged the bus).
    Route the dirty-INVL writeback through UNCACHE_WB_DRAIN (which drops mem_req for
    the turnaround) -> UNCACHE_WB_TURNAROUND, which now acks the L1 when
    r_opcode==MEM_INVL instead of re-issuing an uncached op.
    Re-verified on the checkpoint repro (init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
    [l2.sv]
2026-07-04 l2: gate the [desc l1->l2] sim trace behind DESC_TRACE
    The descriptor-page trace was `ifdef VERILATOR (always on in sim) and spammed
    the boot on the SCSI descriptor page. Gate it behind DESC_TRACE (off by default,
    re-enable with +define+DESC_TRACE).
2026-07-05 tests/csmith: mega builders -- N csmith programs in one binary
    build_mega.sh (FSBL/unmapped) and build_mega_pt.sh (mapped/page-table) combine N
    csmith tests into a single boot. Each program's globals/functions/crc32_context
    are static (per-TU), so combining is just renaming each main -> csmith_<i>; a
    generated driver chains them and platform_main_end() only prints (no halt), so one
    boot emits N per-test checksums vs the QEMU golden. NONE-golden tests are skipped
    (they hang and would block every test after them).
    Purpose: value-agnostic catch for the random mapped-execution corruption
    (project_fpga_mapped_corruption) -- one boot = N x exposure, a checksum mismatch
    localizes to a TEST<i>/seed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
2026-07-05 tests/csmith: SCSI-disk mega vehicle that caught the multi-segment DMA bug
    build_mega_linux.sh combines N csmith programs into one static musl n64 Linux
    binary; make_csmith_disk.sh lays it on a raw disk image + emits an initramfs
    /init that LOOP-reads it from /dev/sda (SCSI DMA), execs, and diffs per-test
    checksums vs the initramfs-resident golden. A byte-cmp of the SCSI-read copy
    vs the golden localised the corruption to exactly offset 4096 -> the one-
    segment shim delivery. This is the deterministic reproducer for the sgiwd93
    sg_tablesize=1 fix.
2026-07-07 core: faulted-delay-slot precise-exception fix + architecturally-correct CACHE icache-invalidate
    - core.sv: a faulted (mispredicted) ROB head with a regular delay slot now waits
    for the delay slot to COMPLETE before retire+DRAIN, so a faulting delay slot
    cannot slip past the flush and corrupt arch state (the "go a0" mapped-corruption
    bug). Branch-likely nullifying delay slots are checked FIRST so they don't
    deadlock (they never complete).
    - core.sv / core_l1d_l1i.sv: I-side CACHE (Index/Hit-Invalidate) now invalidates
    the L1I and restarts to refetch; it no longer nukes the whole L1I + chains an L2
    flush. The L1I is read-only and L2 is its refill source, so flushing L2 was both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
    [core.sv, core_l1d_l1i.sv, exec.sv, itlb.sv, l1d.sv, l1i.sv]
2026-07-07 core: DPI timer-IRQ trace hook; scheduler back to 8 entries
    - core.sv: import "DPI-C" log_timer_irq(), fired once per interrupt taken --
    hooked on (r_state==ARCH_FAULT) & t_rob_head.is_irq, which IS a timer interrupt
    since IP[1..6] are unwired. (took_irq ANDs the registered r_cause, which lags
    the EPC write by a cycle, so it never asserts -- ARCH_FAULT is the reliable
    edge.) `ifdef VERILATOR, so excluded from FPGA synth. The C side stamps each
    with the sim cycle for the henry_tb monitor `timer` query.
    - top.cc: no-op log_timer_irq() stub so ooo_core links (only henry_tb records it).
    - machine.vh: LG_INT_SCHED_ENTRIES 2 -> 3 (ALU scheduler 4 -> 8 entries). Boot
    makes it much farth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
2026-07-08 core: never write physreg 0 ($0); prove the decode invariant
    An r0-dest op reached the integer PRF with wrptr0==0 & wen0 and stomped
    physreg 0. The FPGA read path (rf4r2w) had dropped the rdptr==0->0 mux on
    the invariant that $0 is never written, so r0 then read back garbage -> silent
    r0 corruption (go checkpoint "recursively faulted to death"; live on silicon).
    Two writers of $0 existed in decode:
    - ssnop (sll $0,$0,1) fell through the SLL case to a real SLL (dst_valid).
    - mfc0/dmfc0/mfc1/cfc1/dmfc1 $0 set dst_valid unconditionally.
    Fixes:
    - rf4r2w.sv: gate the ALU write port on wrptr0 != 0 (backstop for ANY
    r0-dest write, not just the two decode cases).
    - decode_mips.sv: sll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
    [decode_mips.sv, formal_decode.sv, rf4r2w.sv]
2026-07-08 core: fix faulted-delay-slot precise-exception (go SIGSEGV)
    A mispredicted branch retired and issued its fall-through restart ~16 cycles
    BEFORE its delay-slot store completed. If that delay slot then took a memory
    fault (store TLB miss), the fall-through instructions had already been fetched
    and retired -- corrupting a live register (the store's base) so the ERET retry
    stored to a bad address -> userspace SIGSEGV (099.go died ~27M insns into the
    checkpoint). Cycle-level trace showed the exception vector WAS installed in
    r_restart_pc, but the wrong-path fetch was already in flight.
    Fixes (core.sv):
    - t_can_retire_rob_head: a faulted branch with a REGULAR delay slot now waits
    for the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
    [core.sv, exec.sv]
2026-07-08 formal: move decode proof into formal/ (keep it out of the FPGA .sv glob)
    gen_mipscore.sh (henry) and convert_sv_to_v.py (r9999 core) both `cp *.sv`
    from the repo root into the sv2v build, so formal_decode.sv at root -- a
    non-synthesizable formal testbench wrapper -- broke both FPGA builds. Move
    formal_decode.sv + run_decode_formal.sh into formal/ so the root glob skips
    them; runner references ../{machine.vh,uop.vh,decode_mips.sv}.
    [formal_decode.sv]
2026-07-08 core: fix uncached-delay-slot retire deadlock (ip22_eeprom_read hang)
    An uncached mem op in the delay slot of a MISPREDICTED (faulted) branch
    deadlocked: the branch's retire gate waits for the delay slot to complete
    (the bug-#3 SIGSEGV fix), but the delay-slot uncached op's issue gate waits
    to be at the ROB head / drain_ds_complete -- which needs the branch to retire.
    Circular; only a jr-ra mispredict with an uncached-store delay slot triggers
    it, so it was intermittent on silicon.
    Fix A: a regular delay slot of a complete, faulted branch at the ROB head is
    non-speculative (MIPS delay slots always commit), so let its uncached op issue.
    core exports next_head_of_rob_ptr + head_of_rob_ds_comm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
    [core.sv, core_l1d_l1i.sv, l1d.sv]
2026-07-08 core: debug readback infra -- head-status port + gated L2 event ring
    dbg_head_status: pack the ROB-head's stuck-reason bits (rob_empty, complete,
    can_retire, faulted, delay-slot, next-complete, dq-empty) into a 32b readback
    peer of dbg_head_pc, exposed at AXI 0x1B for the board `head` command. Cracked
    the ip22_eeprom_read deadlock (head wedged on a faulted jr, status 0x1a).
    L2<->AXI event ring: now behind `ifdef ENABLE_L2_EVENT_RING (a bare per-file
    ifdef strips cleanly through sv2v, unlike machine.vh-scoped ENABLE_TRACE_BUFFER);
    off by default, so the ring's block-RAM is excluded from normal builds.
    ERET $display gated behind `ifdef ERET_TRACE (clean console by default).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
    [core.sv, core_l1d_l1i.sv, exec.sv]
2026-07-09 exec,core: extend faulted-delay-slot retire fix to oldest_first (mfc0) delay slots
    An oldest_first op (e.g. mfc0 c0_cause) that is the regular delay slot of a
    complete, faulted branch at the ROB head is non-speculative -- guaranteed to
    commit -- so let it issue even though the branch, not it, is the head. Without
    this the branch's retire waits for the delay slot while the delay slot waits to
    become oldest -> deadlock (IRIX boot: faulted beqz + mfc0 delay slot). exec.sv
    adds the head_of_rob_ds_committable/next_head_of_rob_ptr allowance to the
    oldest_first issue gate; core.sv routes the two signals to exec. Silicon-confirmed.
    [core.sv, exec.sv]
2026-07-09 core: disable sim-only guards that false-trip on IRIX boot
    recursive-fault $stop (r_fault_cnt>10) trips on IRIX's R4000 clock-calibration
    spin; 'lala land' kseg1 $stop trips on IRIX cache-init running uncached in kseg1.
    Both are Verilator-only $display/$stop (no silicon effect); henry_tb's no-retire
    watchdog is the reliable hang detector.
2026-07-09 l1d: gate SCSI-clobber trace behind SCSI_CLOBBER_TRACE (was VERILATOR)
2026-07-09 interp,l1d: forward-port co-sim store-check + TLB VA->PA probe from rv64core/interp_mips
    Forward-ports the rv64core store-check across the shared MIPS ancestor: l1d.sv reports each
    committed sw/sd cache-write via a wr_log DPI (gated `ifdef ENABLE_STORE_CHECK -- henry_tb
    only); interpret.cc/.hh record the ISS store stream (store_rec / g_iss_stores, #ifdef
    STORE_CHECK). Also forward-ports interp_mips's non-faulting full-TLB probe (tlb_probe_ro)
    so the ISS store address is the real PA, matching the RTL's TLB. r9999's own ooo_core/FPGA
    builds are unaffected (neither guard set); henry_tb does the drain+compare.
2026-07-09 store-check: cover aligned sb/sh/sw/sd with size-masked data
    sb/sh are aligned single-writes (one t_wr_array each) so they don't drift the FIFO -- only
    the unaligned swl/swr/sdl/sdr do. Track sb(8)/sh(16)/sw(32)/sd(64) with the store data masked
    to its width on both the RTL (l1d.sv, per r_req.op) and ISS (interpret.cc) sides.
    [interpret.cc, l1d.sv]
2026-07-09 interp: real TLB translation in the golden ISS (port va_translate from interp_mips)
    The golden ISS used a 1:1 va2pa STUB (kseg0/1 strip, else identity), which mistranslates
    every MAPPED (useg/kseg2/xkseg) access. As the henry_tb checker for IRIX (kseg2-heavy) this
    produced FALSE divergences: a kseg2 load the stub sent to the wrong PA read 0 while the RTL's
    real TLB read the correct checkpoint-seeded value (the 0x881b7ce4 r14 'core bug' was this
    tooling artifact, not silicon).
    Forward-ports interp_mips's real TLB: tlb_op, exc_vector (TLB/XTLB refill vector),
    tlb_set_fault_state (BadVAddr/EntryHi/Context/XContext), raise_tlb, a micro-TLB (flushed on
    TLBWI/TLBWR), and va_translate over the 48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
    [interpret.cc]
2026-07-10 co-sim checker TLB-sync + IRIX-boot fixes
    - interpret.cc/.hh: golden ISS TLB now driven SOLELY by the RTL mirror
    (g_iss_tlb_ext) -- suppress the ISS's own tlbwi/tlbwr so the 48-entry TLB stays
    bit-identical to the RTL's (fixes the checker's wired-PDA spurious refill at
    ~131K insns). Add is_64b_addr_mode() for the XTLB-vs-TLB refill vector; record
    the last translated load VA for device-load delay-slot classification;
    env-gated raise_tlb fault probe (TLBFAULTDBG).
    - sparse_mem.hh: IP22 System Memory Alias (PA<512KB -> +0x08000000), route_devices.
    - exec.sv: +define+INSN_PACED_COUNT (co-sim only) advances Count per retired insn
    to match the interpreter's timer.
    - core.sv: relax the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
    [core.sv, exec.sv, interpret.cc, itlb.sv]
2026-07-11 l2: fix stale-dirty eviction clobber + skip L2 walk on L1I-only flush
    Two L2 fixes found chasing the IRIX SCSI-DMA descriptor corruption (the
    deterministic XFS-btree panic):
    1. Miss-eviction guard: `if(w_dirty)` -> `if(w_need_wb)` (valid & dirty).
    MEM_WB (CACHE writeback-through) clears valid but not dirty, leaving a
    line valid=0/dirty=1; the bare w_dirty test then wrote that stale line
    back on a later miss, regressing a SCSI-DMA descriptor in DRAM (armed
    {08398f80,0x40} -> stale {883e4800,0}) -> wd93dma_flush flushes the wrong
    range -> XFS reads stale disk data -> panic. The CLEAN_RELOAD fill site
    already defended this leak; the eviction consumer was missed.
    2. L1I-only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
    [l1d.sv, l2.sv]
2026-07-11 core: *al branches (bltzal/bgezal/bltzall/bgezall) link ra unconditionally
    MIPS *al branches write ra <- pc+8 UNCONDITIONALLY; only the branch
    direction is conditional. Both the RTL (exec.sv) and the embedded ISS
    (interpret.cc) gated the link on takeBranch -- exec.sv computed
    t_result = t_take_br ? pc+8 : old_r31
    (writing back the old r31 on not-taken), and decode fed srcB=r31 for it.
    This broke every PIC dynamic linker: glibc's MIPS __start uses
    `bltzal t0,.+8` with t0>=0 (NOT taken) as a runtime-PC capture idiom.
    Not-taken + no-link left ra=0 -> load bias subu = -0x8c8 -> jalr to
    GOT[3](0)+3932+bias = 0x694 -> SIGSEGV in ld-2.11.3.so. It hid because
    bal (=bgezal $0, always taken) and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
    [decode_mips.sv, exec.sv, interpret.cc, top.cc]
2026-07-11 l1d: scaffolding for double-beat D-Hit CACHE ops (CHOP_BEAT2 + r_chop_beat)
    Groundwork for making each D-Hit CACHE op (CHINV/CHWBINV/CHWB) operate on
    the addressed 16B line AND the next (addr+16), so stock IRIX's 32B-aligned/
    32B-stride dma_cache_inv (built for a 32B primary line) covers both 16B lines
    of r9999's 16B cache -- the DMA-buffer clobber root-caused in the interp_mips
    cache model. See project_coherent_dma_plan.
    This commit is INERT (no behavior change, builds clean): adds the enum state
    CHOP_BEAT2 and the r_chop_beat/n_chop_beat register (decl/reset/flop/default).
    The beat FSM logic + FLUSH_CL Index-op mirror land next, validated against
    tests/cache + randgen (the coherence hazar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
    [l1d.sv]
2026-07-11 l1d: double-beat D-Hit CACHE ops (Hit_WB/Hit_WB_Inval/Hit_Inval cover 32B)
    Each D-Hit CACHE op (CHWB/CHWBINV/CHINV) now operates on the addressed 16B line
    AND the next (addr+16), so stock IRIX's 32B-aligned/32B-stride dma_cache_inv --
    compiled for a 32B primary line -- covers BOTH 16B lines of r9999's 16B cache.
    This is the DMA-buffer clobber root-caused in the interp_mips cache model
    (is_vh reading a stale free-list line where the DMA'd volume header should be).
    Mechanism (l1d.sv FSM): beat 0 runs the op on the addressed line but DEFERS
    graduation; on the flush's mem-rsp (FLUSH_CL_WAIT) -- or immediately for a
    CHWB clean-hit/miss -- it goes CHOP_BEAT2_RD (re-index the tag/data RAM to
    set+1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
2026-07-12 exec: honor decoder dst_valid for GPR-writing mem ops (fixes IRIX lw-zero r0 forward)
    t_mem_tail.dst_valid was hardcoded 1'b1 per load/SC/MFC1 op in the mem-tail
    construction, overriding the decoder's dst_valid = (rt != 0). An IRIX
    `lw zero,0(dev)` (uncached-MMIO device-probe read, result discarded to r0)
    thus reached the mem pipe with dst_valid=1 on physreg 0. Its device-read value
    then forwarded (mem-forward matches on physreg 0, no r0 exclusion) onto a later
    load's r0 base at the skid-off mem-queue enqueue -> address 0xffffa018+garbage
    -> null read -> IRIX "Bad addr 0x15c" kernel panic.
    Fix: dst_valid = mem_uq.dst_valid for the 17 GPR-writing mem ops
    (LW/LWU/LWL/LWR/LB/LBU/LHU/LH/LD/LDL/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
    [exec.sv]
2026-07-18 tests: add cvt.d.w (i2f) regression tests for the fpu_i2f leading-one fix
    Directed tests that exercise int->double with non-power-of-2 magnitudes, which
    the fpu_i2f find_lowest_set_bit bug got wrong (cvt.d.w 116 -> 4.0). Existing
    cvt tests only used powers of two (lowest==highest bit), so this class slipped
    through -- and the GPR-only co-sim never compares FP registers.
    tests/fpu/fp_cvtdw.S -- cvt.d.w of 116/216/58/1024/... must equal N.0
    tests/fpu/fp_capacity.S -- add.d/mul.d magnitude sweep incl. the 100+116=216
    capacity case + x2 probes
    tests/henry/fp_capacity.c-- same, bare-metal on the henny SoC FPU (CU1-enabled)
    Wired into `make run-fpu` (co-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
    [fp_capacity.c]
2026-07-18 l1d/l2: sub-page cache guard + optional L2-nocache + dormant DMA snoop
    Brings the henny cache work to main WITHOUT changing main's default config
    (L1 stays NUM_SETS=8 / 4KB; ENABLE_L2_NOCACHE stays OFF -> full 128KB L2).
    - l1d.sv: SUB-PAGE (<4KB) guard so a cache smaller than a page elaborates
    correctly -- TAG_LSB = min(IDX_STOP, LG_PG_SZ), LG_ALIAS_BITS = max(0, ...)
    instead of a negative part-select. No effect at the 4KB default (IDX_STOP
    == LG_PG_SZ, LG_ALIAS_BITS == 0); enables the tiny/henny configs.
    - l2.sv + machine.vh: ENABLE_L2_NOCACHE bypass as an ifdef OPTION (off by
    default) -- cacheable data ops go straight to DRAM, L2 retains nothing
    (the non-coherent-DMA workaround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
    [core_l1d_l1i.sv, l1d.sv, l1i.sv, l2.sv]
2026-07-19 l1i: VIPT tag-widening + VA-indexed fill for alias-safe L1I > 4KB
    The L1I is VIPT (VA-indexed, PA-tagged) and, unlike l1d, had NO alias handling:
    its tag stopped at IDX_STOP, so a >4KB I-cache FALSE-HITs -- two different
    physical code lines that differ only in an alias bit (PA[12..]) land in the same
    VIPT set, the tag (missing those bits) matches, and the wrong instructions are
    fetched.
    Mirror the l1d fix, adapted for a read-only cache:
    - TAG_LSB = min(IDX_STOP, LG_PG_SZ): take the tag down to LG_PG_SZ so it CARRIES
    the alias bits. LG_ALIAS_BITS/N_TAG_BITS follow. All tag slices
    [PA_WIDTH-1:IDX_STOP] -> [:TAG_LSB] (hit compares + tag-RAM wr_data).
    - VA-index the fill (r_mem_req_ad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
    [l1i.sv]
2026-07-19 machine.vh: enable 16KB L1I+L1D + 128KB write-back L2
    L1I/L1D: LG_..._NUM_SETS 1 -> 10 (16KB each). Safe now that both sides handle
    VIPT aliasing: D-side alias-free by IRIX page coloring (measured 0 back-invalidates
    to 16KB on a real boot), I-side false-hit-safe by the l1i tag-widening. FORMAL
    branches stay at 2.
    L2: drop ENABLE_L2_NOCACHE -> the full 128KB write-back L2 (silicon-validated:
    boots IRIX clean to login; DMA-coherent via the L1D->L2 CACHE-op forwarding).
    Claude-Session: https://claude.ai/code/session_013FvsgooNFJkXWmtU7bRTom
2026-07-19 core: find_first_set -> find_lowest_set_bit (o32 TLB-Modify encoder fix)
    find_first_set scanned MSB->LSB, returning the HIGHEST set bit despite its
    name. It drives scheduler alloc/select and the free-list/TLB priority
    encoders; wrong-oldest selection was the root cause of the IRIX o32
    TLB-Modify loop / SIGSEGV. New find_lowest_set_bit.sv (true LSB-priority);
    renamed all 13 call sites in core/exec/fair_sched/itlb/tlb.
    Coupled: fpu_i2f needs the HIGHEST set bit, so it moves to
    count_leading_zeros + (63-clz) rather than the flipped shared helper (else
    cvt.d.w 116 -> 4.0). Guarded by the existing fpu/fp_cvtdw regression.
    find_first_set.sv left in place (now unused).
    Validated: randgen 300/300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
    [core.sv, exec.sv, fair_sched.sv, find_lowest_set_bit.sv, fpu_i2f.sv, itlb.sv, tlb.sv]
2026-07-19 core: expose henry debug interface (cause_ip + programmable watchpoint/fault-trap), guarded
    Adds the core-interface ports henry_soc.sv binds unconditionally, so henry can
    build against a clean r9999 main instead of a detached submodule + local WIP:
    - exec.sv: cause_ip[7:0] output -- a free tap off the existing w_ip (Cause.IP
    pending bits, for co-sim ISR dispatch), unconditional.
    - core.sv / core_l1d_l1i.sv: bp_pc/bp_wp_addr/bp_wp_val/fault_clear inputs +
    cause_ip/dbg_frozen/dbg_wp_data outputs, ALWAYS present so the henry wrapper
    binds them. The driver-programmable breakpoint + store value/address watchpoint
    + resettable fault-trap logic is under `ifdef ENABLE_DEBUG_WATCHPOINT;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
    [core.sv, core_l1d_l1i.sv, exec.sv]
2026-07-19 iss+build: co-sim OS-mode checker (interpret.cc/hh) + env-driven SV2V_DEFINES
    Lets the henry SoC build + co-sim-check from a CLEAN r9999 submodule tracking
    origin/main, instead of a detached commit + local WIP:
    - interpret.cc/hh: the co-sim OS-mode checker support henry_tb.cpp calls --
    g_iss_os_mode (default false, so ooo_core is unaffected; when set, SYSCALL/BREAK
    trap to 0x180 like the RTL instead of halting), iss_fetch_inst() for the retire
    trace, and raise_int() gains a defaulted ip arg (real Cause.IP[7:0] instead of
    hardcoded IP[7]) -- main's lone caller uses the default. Also models the o32
    TLB-Modified (D=0) store fault in the ISS. Additive; ooo_core randgen 300/300.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
2026-07-19 exec: TIMER_RARE co-sim scheduler-tick stretch (guarded, off by default)
    Completes the co-sim-checker interface on main so the henry r9999 submodule can
    track origin/main with zero local edits. On an MTC0 Compare write, when defined,
    fold the large periodic scheduler interval by TIMER_RARE so timer-driven context
    switches -- the lockstep checker's main divergence points -- become rare, letting
    it run past the ~62M scheduler wall. Short calibration intervals are untouched so
    IRIX still boots. CO-SIM ONLY: `ifdef TIMER_RARE, undefined by default -> the block
    compiles out and silicon/default behavior is byte-identical. henry enables it via
    SV2V_DEFINES when running the checker.
    Validated: buil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
    [exec.sv]
2026-07-22 arcs: FSBL programs station MAC + restores MEMCFG-256MB (IP22 ethernet)
    Two additions to the henry_arcs first-stage bootloader for the henry SoC:
    - Station MAC: write 08:00:69:12:34:56 (real SGI OUI, matches eaddr_str) into
    the ds1386 bbRAM at HPC3 0x604e8..0x604fc, one byte per word (byte in [31:24]).
    This is where IRIX (Guiness/Indy path, ip22_nvram_read) and Linux sgiseeq read
    the onboard ethernet address; without it the NIC reads MAC 00:00:00:00:00:00.
    - Restore the MC MEMCFG0 = 0x3f203f40 (256MB, 2 banks) write at kseg1 0xbfa000c4.
    This existed only as a local uncommitted edit that built the deployed binary --
    it was missing from committed source, so a clean rebuild would ha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
2026-07-27 debug-infra: on-silicon be-corruption hunt RTL (watchpoint + 32K ring + TLB shadow + exc-ring)
    Parks the uncommitted debug instrumentation for the IRIX `be` small-int-in-a-
    pointer-field corruption hunt on a branch so main stays clean. All gated by
    ENABLE_DEBUG_WATCHPOINT / ENABLE_RETIRE_TRACE / ENABLE_TLB_SHADOW /
    ENABLE_EXC_RING (via SV2V_DEFINES); production builds omit them.
    - core.sv: PC+threshold store watchpoint (bp_wp_addr repurposed = producer PC,
    freeze when store DATA < bp_wp_val = a small int in a pointer slot); 32K retire
    ring; TLB shadow; exc-ring; resettable fault-trap.
    - rob.vh / exec.sv: mem_req_t.pc un-guarded for synth (the store-tracer PC match).
    - core_l1d_l1i.sv /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
    [core.sv, core_l1d_l1i.sv, decode_mips.sv, exec.sv, l1d.sv, l2.sv]
2026-07-28 decode: FR=0 odd ldc1/sdc1 force ft even, don't RI (match R4K/iris/kernel)
    In FR=0 mode (16 even/odd FP pairs) IRIX/Linux o32 code does ldc1/sdc1 to
    odd $ft -- e.g. _save_fp_context stores all 32 regs incl. odd. r9999
    wrongly RI'd odd-reg ldc1/sdc1, panicking the kernel FP-save path. Real
    R4K/R10K, MAME, and the iris ISS all treat odd-as-even (fpr[reg & ~1]),
    never RI. Force ft even at the LDC1/SDC1 decode, and narrow the FR=0
    fp-reg fault to (compute) is_fp odd-reg arith only (genuinely undefined).
    Silicon-validated (henny impl_11, o32 FP + SIGALRM runs clean).
    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
    [decode_mips.sv]
2026-07-29 divider: port rv64core's CLZ-accelerated nu_divider into the r9999 MIPS core
    Replaces the fixed-full-width divider.sv with rv64core's variable-latency
    nu_divider: count_leading_zeros on the partial remainder vs the divisor skips the
    leading-zero quotient iterations, so typical operands finish in a handful of
    cycles instead of a fixed 64. Adapted to the MIPS HILO interface -- produces BOTH
    quotient (LO) and remainder (HI) in one op (no is_rem mux); is_32b for div/ddiv
    (32-bit operands sign/zero-extended in, both result halves sign-extended out);
    is_signed_div for signed/unsigned in one module (unsigned_divider.sv retired).
    The early (CLZ-skipped) result is held until a HILO writeback slot is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
    [exec.sv, interpret.cc, nu_divider.sv]
2026-07-30 l1d: refine port-2 same-set hazard to byte-mask overlap (disjoint-hit) -> +2.7-3.0% dhrystone
    The port-2 "hit-busy" hazard was set-index-only:
    w_hit_busy_addrs2[i] = (r_mq_addr[i] == t_cache_idx2)
    so ANY access to a set with an in-flight miss-queue entry was treated as a
    hazard and serialized through the MQ -- even when the two accesses touch
    DISJOINT bytes of the line (different record fields, adjacent stack slots).
    Refine to (same-set AND byte-overlap), mirroring rv64core nu_l1d: add a
    per-MQ-entry byte mask r_mq_mask (populated on push, & {16{is_store}} so only
    stores carry a mask), and w_addr_intersect[i] = |(r_mq_mask[i] & t_req_mask).
    An in-flight store still intersects an overlappi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
2026-07-30 core: enable dual-retire (remove the & 1'b0 clamp) -> +36% dhrystone IPC
    core.sv retire logic hard-disabled two-wide retire:
    t_retire_two = !t_rob_next_empty & 1'b0 & ...
    so the machine retired EXACTLY one insn/cycle (pipetrace retire histogram
    1:65536, never 2) while alloc/complete both sustained width-2 -- a structural
    retire cap, not a dependency limit. This was the dominant residual IPC gap vs
    rv64core, previously mis-attributed to "diffuse pipeline maturity".
    The & 1'b0 was added in c63636a ("fix faulted-delay-slot precise-exception,
    go SIGSEGV") ALONGSIDE the actual fix (a faulted branch now waits for its
    delay slot to COMPLETE before retiring -- single-retire head path). The
    retire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
    [core.sv]
2026-07-30 machine.vh: restore debug bit caches to 16KB L1 / 128KB L2
    debug-infra had shrunk L1 16KB->4KB and L2 128KB->8KB 'to free BRAM for the
    32K retire ring', but (a) the perf bit uses only 28% BRAM so there's ample
    headroom, and (b) the deep trace lives in DRAM (dram_trace.sv), not BRAM, so
    the ring never needed the space. The 4KB direct-mapped L1I thrashed on
    dhry_henny's code footprint (printf + libc + arith64 64-bit divide) -> L1I
    99.7%->96.2%, and with L2 also tiny the misses hit DRAM: dhrystone IPC
    1.235->0.777. Worse, tiny direct-mapped caches are the prime suspect for
    reintroducing the be placement-nondeterminism the debug bit is meant to catch
    deterministically. Restore both -> IPC back t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
2026-08-01 checker: MTC0 EntryHi must take the FULL 64-bit GPR (R field) + directed TLB remap test
    The checker zero-extended every MTC0 into cpr0_64. EntryHi's R field is bits
    [63:62] and the TLB match compares it against VA[63:62], so a kernel-mapped entry
    installed with a 32-bit MTC0 got R=0 while any kseg2/kseg3/xkseg VA has R=3 -- the
    entry could never match and the checker took a spurious TLB refill where the RTL
    translated correctly. Sail's execute(MTC0 ...EntryHi) takes the full 64-bit GPR;
    interp_mips already carried this fix, r9999 did not.
    A/B validated with an all-MTC0 variant of the new test: without the fix the checker
    diverges at the first mapped load (sim pc = 0xbfc00280, the KX=1 XTL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
    [interpret.cc]
2026-08-01 tests/tlb: add tlbp->tlbr->tlbwi and I-side remap phases to test_tlb_remap
    Phases 1-2 wrote mappings at a known index and only ever did data loads, so two
    paths that real IRIX leans on hard were untested.
    phase 3 -- the actual IRIX update flow. set_tlbpid / tlbdropin / _unmaptlb never
    write a blindly chosen index; they do EntryHi=VA; tlbp; tlbr; modify EntryLo; tlbwi,
    which silently assumes the matching CAM and the shadow RAM agree on index<->entry
    association (the on-silicon IRIX sweep saw 13/21 live entries whose shadow key probed
    to a DIFFERENT CAM index). Eight entries at indices 16-23, each re-pointed through
    the probed index, with all three steps checked separately: the probe lands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
2026-08-01 tests/tlb: add TLB-pressure phase (Wired + TLBWR churn) to test_tlb_remap
    Phases 1-4 used a handful of entries at known indices with no eviction. Real IRIX
    runs all 48 entries live, replaces with TLBWR, and keeps a nonzero Wired region -- and
    the on-silicon sweep's 13/21 shadow-vs-CAM mismatch was measured on a LOADED system,
    so a pressure-dependent fault would pass every earlier phase and still be real.
    phase 5: Wired=8 with 8 wired entries at indices 0..7, then 512 rounds of TLBWR churn
    over 64 rotating VAs. Each round checks that the mapping TLBWR just installed
    translates correctly, and that a wired entry is still present AT ITS OWN INDEX with the
    right page (TLBWR must never pick a v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
2026-08-03 timer: Count/Compare match must tolerate a dual-retire 2-step (lost tick -> idle-loop wedge)
    Where Count is RETIREMENT-paced -- the INSN_PACED_COUNT co-sim build, and single_step
    mode on silicon -- a dual retire advances Count by TWO. The timer IP was set on an
    exact equality match (n_count == r_compare), so any Compare landing on the value the
    retiring pair stepped over was silently SKIPPED. The tick is then lost until Count
    wraps 2^32 (~4.3e9), i.e. effectively never.
    Caught in the henny IRIX co-sim: the kernel sat in idler/local_idle/idlerunq with the
    fault counter frozen at 4820 across 33M cycles -- zero interrupts, so nothing was left
    to wake any process. The earlier log showed a si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
    [exec.sv]
2026-08-07 predecode: recognise BLTZAL/BLTZALL/BGEZALL as branches (IRIX `be` corruption)
    predecode.sv's REGIMM (opcode 1) table switched on rt and handled only
    0/1/2/3/17, so rt 16 (BLTZAL), 18 (BLTZALL) and 19 (BGEZALL) fell to
    `default` and got pd=0. l1i treats pd==0 as NOT control flow
    (t_update_spec_hist = (t_pd != 4'd0), and the cflow if-chain never matches
    0), so t_is_cflow / n_delay_slot / t_take_br all stayed 0: the front end ran
    straight through a real branch, mispredicting it every time and never
    marking its delay slot -- while decode_mips.sv decoded all four correctly.
    MIPSpro emits `bgezall $zero,TARGET` as its unconditional-call idiom, which
    is architecturally ALWAYS taken. With the de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
    [l1i.sv, predecode.sv]
2026-08-07 tests: REGIMM branch-and-link ISA coverage (bgezal/bgezall/bltzal/bltzall)
    Two directed tests for the instruction family behind the `be` corruption
    (58a7679). rs==$zero makes every case fully determined:
    insn condition taken? delay slot links ra?
    bgezal $zero rs >= 0 YES executes yes
    bgezall $zero rs >= 0 YES executes yes (likely, taken => executes)
    bltzal $zero rs < 0 no executes yes (not likely => always executes)
    bltzall $zero rs < 0 no NULLIFIED yes (likely, not taken => nullified)
    test_regimm_link.S pins that table plus the unconditional link (ra = branch+8
    even when NOT taken -- r9999 previo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
2026-08-08 l1i: drop unimplemented l1i_fill/l1i_flush DPI hooks
    These were declared and called under `ifdef ENABLE_STORE_CHECK, but no C++
    implementation was ever committed in any tree. The sim Makefile passes
    ENABLE_STORE_CHECK unconditionally, so the imports always compiled and
    henry_tb always failed to link:
    undefined reference to `l1i_flush'
    Nobody noticed because a stale henry_tb binary predating the RTL change kept
    running. Removing them restores the build. The intent (pair with the L1D
    hooks to answer "is the stale reservoir the L1D or the L1I?") is worth
    rebuilding later WITH its C++ side.
    Claude-Session: https://claude.ai/code/ses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
    [l1i.sv]
2026-08-09 machine.vh: drop ENABLE_L1_TINY so the default L1 really is 4KB
    93a6ff7 added the ifndef geometry guards and claimed "default L1I/L1D to
    4KB", but it also carried an ACTIVE `define ENABLE_L1_TINY 1` from the be
    hunt, plus `elsif ENABLE_L1_TINY -> LG_L1*_NUM_SETS 2. The effective default
    was therefore 4 lines x 16B = 64 BYTES per L1, not 4KB -- the commit
    contradicted its own message, and any build that did not pin the geometry on
    the command line silently got 64B L1s.
    Removes the define and both elsif branches; the defaults now resolve to
    LG_L1*_NUM_SETS 8 (256 sets x 16B = 4KB == LG_PG_SZ, zero VIPT alias bits).
    The ifndef guards are untouched, so command-line overrides still win and the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
2026-08-12 l1i: form fetch groups on the first PREDICTED-TAKEN branch, not the first branch
    The fetch group used to terminate at ANY predecoded branch, with the PHT
    consulted only for slot 0:
    t_spec_branch_marker = ({1'b1, pd3!=0, pd2!=0, pd1!=0, pd0!=0} >> t_insn_idx)
    & {4'b1111, !((t_pd == 4'd1) && !r_pht_out[1])};
    so a conditional branch predicted NOT-taken sitting in slot 1/2/3 ended the
    group for no reason -- ~7-8% of the instruction stream. rv64core's l1i_2way
    reads the PHT for every slot and truncates only on a predicted-TAKEN branch;
    this is that scheme.
    - PHT entry WIDTH(2) -> WIDTH(8): four packed 2-bit counters, one per
    instruction slot in the 16B line.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
2026-08-13 TODO: add associativity -- everything is direct-mapped
    L1I, L1D and L2 are all direct-mapped. This is the second lever that reduces
    miss COUNT rather than miss COST, so it is independent of the MSHR work.
    3C decomposition of dhrystone's retired PC stream at 4KB L1I: 896-BYTE footprint,
    ZERO capacity misses, 4968 conflict misses = 98.9% of all I-misses. 4KB 2-way
    lands on the compulsory floor (56), identical to 16KB direct-mapped -- so 2-way
    recovers the entire 9% that otherwise needs a 4x larger cache. Same failure on
    the D side: membw's three 96KB arrays are an exact multiple of 4KB apart, so
    a[j]/b[j]/c[j] share a set and the slope reads 2.49 instead of 2.0.
    The 2-way L1I already EXIS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
2026-08-13 TODO: correct the 2-way L1I entry -- the prototype is gone
    Two errors in the associativity item as written:
    1. It cited scratchpad/l1i_2way.sv.r9999 as a recoverable artifact. That path
    does not exist -- it was a session-temp directory, since cleaned, and there is
    no scratchpad/ in this tree. The three l1i_2way.sv files on disk are all
    rv64core versions. The validation history is real; the code is not.
    2. (dsheffie) It forked from l1i.sv before 9789594, so even had it survived it
    would need the predicted-taken PHT work merged in.
    Reframed as a re-implementation and pointed at ~/code/rv64core/l1i_2way.sv, which
    is live and ALREADY carries t_tcb0 -- it is the file 9789594 was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
2026-08-13 l1d: per-state FSM occupancy profiler (off by default)
    Answers "where do the cycles go" without per-load tagging, which r9999 can do
    because it is blocking -- exactly one miss is ever in flight. Enabled by
    uncommenting L1D_STATE_PROFILE; dumps every L1D_PROFILE_PERIOD cycles.
    Result that motivated the TODO reshuffle: on membw at -m 30 the L1D spends 82%
    of ALL cycles in INJECT_RELOAD waiting for a fill, 15.6% in ACTIVE, 2.3% in
    HANDLE_RELOAD -- ~35 cycles per fill against 30 cycles of modelled memory, so the
    miss path itself is efficient and the cost is simply that only one fill can be
    outstanding.
    KNOWN DEFECT (recorded in TODO.md 4): the writeback-vs-fill split is WRONG. It
    discriminat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
    [l1d.sv]
2026-08-21 l1d: don't accept a port2 request in the cycle we leave ACTIVE
    port2 is a two-stage pipe: a request is ACKed inside the ACTIVE case at cycle
    N (core_mem_req_ack, so the core never re-sends it) but PROCESSED at cycle N+1
    under `ACTIVE:`. Nothing kept those two stages consistent -- if this cycle's
    logic already moved n_state out of ACTIVE, the accepted request landed in a
    state with no port2 handling and was silently dropped: no ack, no MQ push, no
    fault. The op then never completed and, being the older entry, blocked ROB
    retirement forever; a younger CACHE hit-op already in the MQ waited on a
    graduation (2'b10) that could never arrive.
    CACHE hit-ops are what expose it: a chop's double beat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
2026-08-22 l1d: route CHWB through the same beat arms as the other CACHE hit-ops
    Both the beat-0 and CHOP_BEAT2 arms excluded MEM_CHWB from the INV path
    (`else if(r_req.op != MEM_CHWB)`), leaving it to fall into arms that issued no
    memory request at all. On a clean hit that was a silent no-op; the miss case
    reached the beat-2 tail only via the `if(!n_chop_wait)` fall-through. CHINV
    and CHWBINV take the INV arm for every non-dirty-hit case and work
    (tests/cache/test_chop_ops.S), so CHWB now follows the identical flow -- which
    is what the WB arm's comment already claims ("CHWB is conservatively treated as
    WB-Invalidate"). The now-dead CHWB-only clean-hit arms are removed.
    This is NOT the fix for the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
    [l1d.sv]
2026-08-22 machine.vh: default the L2 back to 16KB
    Back to 16KB from the 128KB of 2fb24a9. 128KB does shake out more L2 bugs, as
    that commit intended, but it also RETAINS a speculatively-filled line long
    enough to act as the stale reservoir for the R10000-class non-coherent-DMA
    bug -- the same reservoir ENABLE_L2_TINY / ENABLE_L2_NOCACHE exist to kill.
    With both of those off and no HW snoop into the L1D (ENABLE_L2_INCLUSION is
    not defined by any build), a 128KB L2 against a 4KB L1D leaves IRIX dying in
    reconfigure with `xfs_iflush: Bad inode <n> magic number`. 16KB is the
    geometry 09d1ccf recorded as "configuration does not appear [to] fail".
    This moves a DEFAULT only -- builds that pass explicit ge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
2026-08-22 top.cc: TIP per-cycle stall attribution (ported from rv64core)
    Charges every cycle to a PC so stalls are attributable rather than just
    counted: a cycle with an empty ROB goes to the last retired PC, a cycle with
    no retirement goes to the blocked ROB head (dbg_head_pc), and a retiring cycle
    splits its credit across the retiring slots under dual retire. Also tracks
    per-PC instruction counts so cycles-per-insn can be read per site.
    Gives "where did the cycles go" for the memory-path work instead of inferring
    it from aggregate IPC.
    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
    [top.cc]
2026-08-30 cosim: recognize BEV=0 kseg0 exception vectors, mirror hardwired Status.CU2
    Three fixes found while replaying full-system Linux checkpoints in ooo_core.
    top.cc: the post-exception resync only recognized the BEV=1 boot-ROM vectors
    (bfc00180+). A Linux checkpoint runs with BEV=0, so the RTL vectors into kseg0
    (TLB refill 0x80000000, XTLB 0x80000080, general 0x80000180) and the sim was
    never advanced past the faulting instruction -- it sat on the store while the
    RTL ran the handler, and the desync watchdog killed the run a few retires later.
    interpret.cc: exec.sv's cpr0_status_reg puts a literal 1'b1 in the cu2 slot, so
    Status.CU2 always reads 1 in the RTL. A checkpoint whose stored Status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
    [interpret.cc, top.cc]
2026-09-06 tracing: the logging/instrumentation tree used for the silicon bug hunt
    This is the "kitchen sink" branch: every retire-ring / operand-logging change the
    hunt depends on, in git instead of scattered across working trees.
    WHY THIS EXISTS. The tree that actually builds the deployed henry bitstream was
    never committed anywhere. It survived only as a /tmp scratch dir from a Sep-4
    gen_mipscore run, and the checked-out repos had since been contaminated with
    debug-infra variants of henry_soc.sv and core_l1d_l1i.sv that cannot elaborate
    against it (2026-09-06: two synth failures chasing exactly that). Recovered from
    /tmp and PROVEN equivalent -- regenerating mipscore.v from these sources with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
    [core.sv, core_l1d_l1i.sv, decode_mips.sv, exec.sv, l1d.sv, l1i.sv, rf4r2w.sv, top.cc]
2026-09-07 decode: two more $zero reads removed -- BAL's operand and `move rd,$zero'
    Follow-on to the zero-compare uops, same principle: an instruction whose result
    does not depend on $zero should not read physreg 0 to compute it.
    * BAL. `bal off' IS `bgezal $0,off' -- $0 >= 0 always, so the branch is
    UNCONDITIONAL and the operand is never consulted. decode already mapped
    rs==0 to a distinct BAL uop, but the shared REGIMM prologue had set
    srcA=rs=$0 with srcA_valid=1, so every `bal' read physreg 0 for nothing.
    exec's BAL arm computes t_take_br=1 and t_result=pc+8 and never references
    t_srcA, so dropping the source cannot change behaviour. This one matters
    beyond tidiness: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
2026-09-07 decode: stop reading physreg 0 for the $zero idioms; add a NOT uop
    `$zero' operand reads are the consume side of the physreg-0 corruption
    hypothesis. The earlier BEQZ/BNEZ/BRA/TEQZ/TNEZ work only covered
    branches, which is 42% of the static physreg-0 reads in an o32 binary --
    the largest remaining category was `move', because every MIPS `move
    rd,rs' assembles to `addu rd,rs,$0' or `or rd,rs,$0'. Measured on the
    `wc' guest binary from the SIGFPE capture: 1099 addu + 712 or, against
    896 for all $0-comparing branches combined.
    Re-steer the $0 forms to single-source (or source-free) uops:
    addu rd,rs,$0 -> SLL rd,srcA,0 (NOT MOV: ADDU is a 32-bit add whose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
2026-09-07 decode: close five physreg-0 bypass-poison holes (jalr/mfc0/dmfc0/cfc1/daddiu)
    rf4r2w gates the PRF write on `wrptr0 != 'd0', so nothing can write
    physreg 0. The forwarding and wakeup compares in exec.sv have no such
    guard -- all six of them match on `srcX == int_uop.dst' gated only by
    t_wr_int_prf, never on dst_valid:
    r_fwd_int_srcA <= r_start_int && t_wr_int_prf
    && (t_picked_uop.srcA == int_uop.dst);
    uop.dst DEFAULTS to 'd0 in decode. So any op that reaches exec with an
    INT_WRITER opcode and dst_valid=0 keeps dst==0, matches every concurrent
    $zero read, and bypasses its result onto that operand -- blocked from the
    register file, but not from the consumer. The w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
2026-09-07 exec: overflow-CHECK uops for `add $0,rs,rt' and friends; decode-p0 now proves
    Completes the physreg-0 bypass closure and fixes a second, independent
    bug found on the way.
    add/addi/daddi with a $0 destination were the remaining counterexamples
    to `t_wr_int_prf => dst_valid' (see the previous commit for why that
    property is what protects the unguarded bypass compares). Unlike the
    others they cannot fold to NOP: `add $0,rs,rt' is a documented MIPS
    overflow-CHECK idiom, and Integer Overflow is raised independent of the
    destination. interpret.cc agrees -- raise_overflow() runs before the
    gpr[rd] write -- so NOP'ing them silently disarms the check.
    Which is exactly what main was already doing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
    [decode_mips.sv, exec.sv, formal_decode_p0.sv, formal_l1d_fwd.sv, formal_rf.sv, formal_rf_p0.sv, fpu_stub.sv, muldiv_stub.sv]
2026-09-07 exec: structural $zero guard on the int bypass and wakeup compares
    rf4r2w has refused to WRITE physreg 0 since the r0/SSNOP fix
    (`wrptr0 != 'd0'), but nothing refused to BYPASS onto it. A producer
    with dst==0 was blocked from the register file and still forwarded its
    result to every consumer reading $zero. The register file was closed;
    the bypass was not.
    uop.dst defaults to 'd0 in decode, so ANY op reaching exec with an
    INT_WRITER opcode and dst_valid=0 keeps dst==0 and matches every
    concurrent $zero read. Until the preceding two commits, seven encodings
    did exactly that (jalr/add/addi/daddi/mfc0/dmfc0/cfc1/daddiu).
    Those are now fixed in decode, so this guard is redundant TODAY -- and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
    [exec.sv]
2026-09-07 decode: BEQZL / BNEZL -- branch-likely zero compares were missed
    `beqzl rs' IS `beql rs,$0' and `bnezl rs' IS `bnel rs,$0', so they read
    physreg 0 exactly like the non-likely forms that BEQZ/BNEZ already fixed.
    The branch-likely opcodes were simply overlooked, and the earlier
    measurements could not see it: modern gcc emits NO branch-likely at all
    (0 in wc, dhrystone and hello), so the static census that reported 99.75%
    coverage never counted opcodes 20/21 in either the numerator or the
    denominator.
    They are not rare where it matters. big-csmith-test.mips has 7942
    branch-likely instructions, 514 of them with a $0 operand, and
    MIPSpro-built IRIX code uses the form idiomatically -- IRIX being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
    [decode_mips.sv, exec.sv]
2026-09-07 cosim: treat a control-flow desync as a failure, not a quiet stop
    When the RTL and the checker take different control flow, the desync
    watchdog (last_check > 2) printed "no match in a while" to stderr and
    broke out of the loop -- without setting `incorrect'. The run therefore
    wrote its normal stats log and, to anything reading stdout, looked like a
    clean completion. run_parallel.sh compensates by grepping for "no
    match", but a direct ooo_core invocation does not, and I misread exactly
    that during the BEQZL work.
    This matters more than a cosmetic issue: a mis-resolved branch is the
    shape of the silicon bug being hunted, and it is the failure mode most
    likely to show up as a control-flow de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
    [top.cc]
2026-09-07 decode: fold the last $0 operand forms -- physreg-0 reads reach zero
    Re-measuring across wc + dhrystone + big-csmith + hello (not just wc, which
    is what the earlier 99.75% figure was based on) changed the priorities
    completely. The largest remaining readers were nothing I had flagged:
    ori rt,$0,imm 52368 (with li/xori/andi/addi) zero-extended imm load
    subu rd,$0,rt 6039 negu -- 32-bit negate
    sltu rd,$0,rt 461 == (rt != 0)
    slt rd,$0,rt 16 == (rt > 0)
    `ori rt,$0,imm' is how gas builds any constant that does not fit a signed
    16-bit `li', and `subu rd,$0,rt' is plain `negu' -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
    [decode_mips.sv, exec.sv]
2026-09-07 exec: extend the $zero bypass guard to the forwarded-DATA capture
    This branch carries a forwarded-data capture (r_fwd_srcA_data /
    r_fwd_srcB_data) that main does not have -- on main the operand mux
    reads r_int_result directly. The structural guard from main (0f22576)
    therefore did not reach these two sites when the branch was rebased.
    They are not cosmetic. The capture is
    if(int-match) r_fwd_srcA_data <= t_result;
    else if(mem-match) r_fwd_srcA_data <= mem_rsp_load_data;
    while the FLAGS r_fwd_int_srcA / r_fwd_mem_srcA are both guarded. An
    unguarded int-match with dst==0 takes the `if' arm and SKIPS the mem
    capture, yet clears the int flag and leaves the mem flag set -- so a
    legit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
    [exec.sv]
2026-09-13 core: TIP stall attribution, one-shot ring capture, and capture-path fixes
    Retire-ring instrumentation for the silicon crash hunt, plus two fixes to
    mechanisms that did not do what their own comments claimed.
    TIP stall attribution: r_rt_stall encodes WHY retirement was blocked, in the
    3 bits that were already sitting as 3'd0 padding at the top of the record --
    so the record stays 216b and the BRAM footprint does not change. Latched on
    the FIRST stalled cycle of a gap and held, so the gap is attributed to what
    STARTED it rather than to whatever was true when it finally drained.
    One-shot capture (ctrl bit22): a rising edge on rt_oneshot rewinds and arms
    the ring for exactly 1024 commits, th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
    [core.sv, core_l1d_l1i.sv, formal_alloc_bank.sv, formal_decode_p0.sv, formal_l1d_rsp.v, l1d.sv]
2026-09-17 uop.vh: classify FP mem ops (ldc1/lwc1/sdc1/swc1) in is_load/is_store
    exec.sv remaps LDC1->MEM_LD / LWC1->MEM_LW / SDC1->MEM_SD / SWC1->MEM_SW for
    the mem pipe, but t_rob_tail.is_store and t_blocked_by_store call is_store()
    on the ORIGINAL uop opcode -- so FP stores were is_store=0 in the ROB and did
    not block a younger load. is_load() was likewise missing the FP loads (its
    uses are $display-only, so cosmetic). Suspected cause of the applu jacld_
    FP interrupt-resume wedge reproduced on henny silicon.
    Claude-Session: https://claude.ai/code/session_016xfvfmXV8dUTCShBtrkiAu
2026-09-22 fp: the FP condition code lives only in the renamed FCR PRF
    BC1T/BC1F read the RENAMED FCR physreg (exec.sv r_fcr_prf), whose only
    writer was an FP compare. CTC1/CFC1 read and wrote the ARCHITECTURAL
    r_fcsr flop and never touched r_fcr_prf -- CTC1 carried no fcr_dst_valid
    so it allocated no FCR physreg. Nor did a compare's result ever reach
    FCSR: the retire-time update writes only Cause[17:12] and Flags[6:2].
    So the condition code had two copies that never synchronised, and both
    directions were broken:
    ctc1 $t,$31 ; bc1t -> the branch read the STALE compare result
    c.eq.d ; cfc1 $t,$31 -> FCSR bit 23 never reflected the compare
    R4400 manual, Control/Status Register Condition Bit: "t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
    [core.sv, decode_mips.sv, exec.sv]
2026-09-22 fp: MIPS legacy NaN semantics -- signaling is the fraction MSB SET
    The R4400 predates IEEE 754-2008 and has no FCSR.NAN2008 bit, so its
    quiet bit is INVERTED relative to 2008: a NaN is SIGNALING when its
    fraction MSB is SET. These modules used the 2008 test (~a[51] / ~a[22]),
    so every SNaN was treated as quiet and vice versa -- Invalid was raised
    on quiet NaN operands and suppressed on signaling ones.
    Also generate the MIPS default NaN (0x7FF7FFFFFFFFFFFF / 0x7FBFFFFF)
    rather than propagating an operand payload.
    Found with Berkeley TestFloat against a MIPS-legacy SoftFloat
    specialization; confirmed against the R4400 manual and MAME's r4000.cpp.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
    [fpu_add.sv, fpu_compare.sv, fpu_f2f.sv, fpu_mul.sv]
2026-09-22 interp: fix four golden-model bugs the co-sim was hiding
    The interpreter is the co-sim oracle, so a bug here either masks an RTL
    bug (both wrong the same way) or fabricates a divergence against correct
    RTL. All four were found by diffing against interp_mips, the mature
    full-system ISS this was forked from.
    - FCC: kept the condition code only in FCR25 while ctc1/cfc1 touched
    FCR31, the same split the RTL had -- which is exactly why the checker
    reported no divergence on tests/fpu/fp_fcc.S. FCSR is now the
    architectural home (bit 23 = FCC0) and FCCR mirrors it. All four
    compare predicates route through the one helper that owns both;
    setConditionCode was previously DEAD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
    [interpret.cc]
2026-09-22 uni_divider: unified integer + FP divide/sqrt unit
    One restoring recurrence serving the integer divider, div.s/div.d and
    sqrt.s/sqrt.d. Replaces nu_divider (which was tuned for dhrystone) and
    removes the FP div/sqrt trap-to-OS path: fpu.sv raised Unimplemented for
    every div/sqrt, so applu spent 83% of its time in the kernel emulator.
    lhs = r_rem, rhs = divisor | {root,2'b01}, bit = (lhs >= rhs),
    r_rem <= {sel, next source bit(s)}
    Integer side is a drop-in for nu_divider and BIT-IDENTICAL to it,
    including div-by-zero and INT_MIN/-1. The dhrystone short-circuit
    (t_skip8/16/32, 8/16/32 steps via a 4:1 mux when the dividend's high bits
    are clear) is disabled when B == 0 so those cases st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
    [uni_divider.sv]
2026-09-22 exec: wire the unified divider in unconditionally, retiring nu_divider
    uni_divider.sv landed as a standalone module (aab4ac7) with nothing
    instantiating it. This connects it and removes nu_divider: div.s/div.d/
    sqrt.s/sqrt.d now execute in HARDWARE instead of raising Unimplemented-Op
    and trapping to the OS soft-float emulator. No `ifdef -- this is a one-way
    change.
    Wiring:
    - d0 replaces nu_divider; integer side is a drop-in (bit-identical,
    worst-case latency <= nu_divider's, so the DIV32_LAT backstop holds)
    - fpu0's start gains `& ~w_iss_is_ds' so div/sqrt route to d0 instead of
    reaching the fpu, which can only E-trap them
    - the fp_uq head pops on w_fdiv_ready for a div/sqrt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
    [exec.sv]
2026-09-22 core: drive the FP and FCR retire ports so the co-sim can see FP writes
    retire_reg_valid tests only t_rob_head.valid_dst, so an architectural FP or
    FCR register write was INVISIBLE to the checker. Every FP value bug in this
    core stayed silent until it leaked out through an mfc1/swc1 -- which is a
    large part of why the FP corruption hunt took as long as it did.
    02f3111 declared these ports tied to zero so an SoC wrapper would link.
    Tied-off outputs make it BUILD, not CHECK: a co-sim against that would
    silently verify no FP register writes at all. This drives them.
    Mirrors the integer retire port exactly: rob_entry_t.data already carries
    the FP result (complete_bundle_2 writes it on the FP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
    [core.sv, core_l1d_l1i.sv]
2026-09-22 core_l1d_l1i: the last five ports an SoC wrapper connects
    02f3111 declared 18 of the ports henry_soc.sv connects; synthesis then failed
    on five more. My completeness check was unsound: it grepped each port name
    against the whole file, so a name appearing in a comment counted as declared,
    and the sed range that extracted the instantiation truncated at the first
    `);' and never saw the tail of the list.
    Worse, I took a clean sv2v conversion as proof the interface linked. It is
    not: sv2v converts each file independently and never checks cross-module port
    matching. Only synthesis does.
    Adds rt_oneshot (input) plus dbg_rob_inflight, retire_load_addr_two, wf_badv
    and wf_stat (outputs, tied off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
    [core_l1d_l1i.sv]
2026-09-25 l1d: FLUSH_CL invalidates a dirty line after its MEM_WB
    IRIX's Index_Writeback_Invalidate_D (cache 0x01, the >16KB __dcache_inval
    path before a disk read) reaches the L1D as FLUSH_CL. The dirty arm wrote
    the line through to DRAM but never invalidated it, so the line stayed
    VALID+DIRTY. After the SCSI DMA deposits new data in DRAM, a load hits the
    stale copy, or its later eviction writes the stale 16B line over the DMA
    data -- the 16B-aligned zero runs seen in XFS inode buffers on silicon.
    Found with the Murphi model ~/code/murphi/r9999_caches.m (FIX_INDEX_INV);
    confirmed in henry_tb with a directed test (stale read + eviction clobber
    without the fix, both correct with it). cache-op 6/6,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
    [l1d.sv]
2026-09-26 ARM-requested whole-cache flush as an injected uop; fix IRQ/xflush delay-slot injection
    External flush (ext_flush_req / ext_flush_done on core_l1d_l1i), handled like an
    IRQ: while a request is pending, decode replaces a non-delay-slot instruction with
    a serializing whole-L1D CACHE op (uop/rob cache_all). At the ROB head it raises the
    core's own L1D flush (L1I complete faked, the sequencer chains the L2), CACHE_FLUSH
    restarts at the replaced instruction's pc, and ext_flush_done pulses. The uop is
    not an architectural retire (retire_valid suppressed, like an IRQ uop). The
    sequencer's old direct ext path, which flushed the caches under live core traffic
    and wedged, is no longer driven.
    Dela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
    [core.sv, core_l1d_l1i.sv, decode_mips.sv, l1i.sv]
2026-09-26 ARM page flush: XFLUSH/XPG_WBINV/XPG_INV injected uops + L1D page walk
    Replace the cache_all flag with three dedicated injected opcodes (decode takes
    the op and the page PA in {jmp_imm,imm}; exec passes it to rob.data). New
    core inputs ext_flush_ppn/whole/drop select the op.
    XPG_* runs an L1D page walk (FLUSH_PG/FLUSH_PG_WAIT) over the page's 256
    lines, carrying each line to the L2 itself, with the core drained at the ROB
    head:
    WBINV: dirty L1D hit -> MEM_WB; else invalidate a hit + MEM_INVL (the L2
    writes back if dirty, then drops).
    INV: invalidate a hit + new MEM_PGDROP (the L2 drops without writeback and
    reports whether the line was dirty).
    Dirty lines found by a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
    [core.sv, core_l1d_l1i.sv, decode_mips.sv, exec.sv, l1d.sv, l2.sv]
2026-09-27 fix IRQ injection replacing a delay slot (fetch slots 3/4, DQ-only clear)
    Two ways decode's delay-slot tracker could miss a delay slot, letting an injected
    IRQ uop replace it:
    - l1i fetch slots 3/4 had is_branch hardcoded 0. Since predicted-taken fetch
    groups a branch can sit there, so ITS delay slot looked like an ordinary insn.
    Slots 3/4 now use predecode like slots 1/2.
    - r_dec_delay_slot was only reset on a ROB clear; a DQ-only clear (serialize /
    CACHE_FLUSH / HALT / exception restarts, none of which restart INTO a delay
    slot) left a stale 1, so the refetched first branch looked like a delay slot and
    its real delay slot did not.
    Caught on silicon: IRIX swtch lost a delay-slot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
    [core.sv, l1i.sv]
2026-09-27 exec: BNEL not taken must nullify its delay slot
    Every branch-likely form restarts with `|| !t_take_br' so a not-taken branch
    nullifies its delay slot; BNEL had it commented out since the initial import.
    It stayed hidden because l1i predicts every branch-likely taken, so a not-taken
    one always mispredicted and restarted anyway -- any predictor change would expose
    it as a silently executed delay slot.
    tests/except/test_likely_nullify.S: all eight likely forms (BEQL, BNEL, BLEZL,
    BGTZL, BLTZL, BGEZL, BEQZL, BNEZL), 64 iterations each taken and not taken.
    Negative control: with l1i temporarily predicting likely NOT taken, the unfixed
    BNEL fails under co-sim on the first iteration (s0 rtl 1 vs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
    [exec.sv]
2026-09-27 exec: capture forwarded operand data with its flag
    The operand mux paired the r_fwd_* flags with r_int_result / r_mem_result /
    r_*_hilo, which reload EVERY cycle. The flag names the producer of the cycle it
    was set in; the data register can already hold the next cycle's result, so a
    consumer could read a value its producer never wrote. Now each forwarded-data
    register loads under exactly the condition, and in the same priority order, as
    the flag the mux selects it with, so flag and data always describe the same
    producer.
    On silicon (henry, rdchk-reader-agreement debug branch, 2026-09-03) the stale
    mem-forward capture signature disappeared with this change across the fix soak.
    Co-Authored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
    [exec.sv]
2026-09-27 interp: three golden-model fixes (addi overflow, FP x/0, lwl/lwr address)
    - addi (0x08) was a bare 64-bit `gpr[rs] + simm32' with no overflow check,
    while ADD right above it traps correctly. The RTL is right (exec.sv ADDI:
    sign_extend32(w_add32), t_fault = w_add32_overflow), so an overflowing or
    64-bit-operand addi made the co-sim report a divergence against a correct RTL.
    Now a 32-bit add, sign-extended, raising Overflow.
    - FP divide returned DBL_MAX for x/0, discarding the sign of both the zero and
    the dividend. IEEE: x/0 -> +-Inf, 0/0 -> NaN.
    - lwl/lwr truncated the effective address to 32 bits before va_translate, which
    is wrong for a 64-bit address (KX/UX); the other loads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
    [interpret.cc]
2026-09-27 debug: restart-reason record, ROB-indexed mem-op PC shadow, real dbg_rob_inflight
    Silicon debug hooks (all readback-only, no effect on execution):
    - core: last-restart record -- why (mispredict / exception / serialize /
    cache_flush / resume), head ptr, cause, restart pc + source pc, the cycle and
    count of the restart edge, and retires since. The retire ring only shows
    restarts FOLLOWED by a retire; this keeps the last one even when the machine
    wedges right after it. Read at dbg_trace_index[14]&[4], word = index[2:0];
    word0's top byte is 0x5a.
    - exec: dbg_memop_pc, the PC of the last memory op scheduled into each ROB slot
    (survives squash), read at dbg_trace_index[14] with the R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
2026-09-27 csmith baremetal: FPE handler that reproduces the IRIX FP-emulation traffic
    On an FPE (div.d/sqrt.d unimplemented) the handler now does what the IRIX
    emulator's traffic looks like -- a burst of mfc1/mtc1 (each a MEM_MOV through the
    L1D) with a data-dependent, ~50% mispredicted branch inside the handler -- then
    skips the faulting op (EPC+8 if it was in a delay slot, else EPC+4). It
    reproduces the traffic, not the math: a vehicle for the applu FP-wedge class
    (MEM_MOVs + mispredicts inside an FP trap) without booting IRIX.
    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
2026-09-27 core: allow a branch to allocate and retire with its delay slot
    Both 2-wide rules refused to pair anything with a branch. Relax them to
    "at most one branch per cycle", as in rv64core:
    - retire: a correctly-predicted branch at the ROB head now retires together
    with its delay slot (mispredicted ones are faulted and already excluded).
    - allocate: the !t_uop.is_br rule was a leftover of the branch-order buffer
    removed in 6cd6864.
    - branch training selects the slot that holds the branch (t_next_head_br);
    it used to assume slot 2 whenever two retired.
    Calls/returns stay out of retire slot 2 (rv64core's attempt, 720c670, broke
    the RSB and was reverted in 67c2516).
    tests/except/test_after_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
    [core.sv]
2026-09-27 perf knobs: fetch branch-in-group, ALU sched bypass, uq dual pop; top-down
    Three pipeline performance features, each behind a define in machine.vh
    (all off; area/timing not yet characterized):
    - ENABLE_FETCH_BR_GROUP (l1i.sv): a predicted-taken direct branch
    (cond/likely/j/b) in fetch slot 1-2 is pushed together with the insns
    before it and its delay slot, target from that slot, then one resteer
    bubble -- as rv64core does. Was: group cut before the branch, branch
    alone, delay slot alone. Calls and BTB/return targets keep that path.
    - ENABLE_SCHED_BYPASS (exec.sv): when no ALU scheduler entry is ready, a
    uop-queue head whose operands pass the allocation-time
    !inflight|alloc-mat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
2026-09-29 itlb: micro-ITLB honors PageMask (was hardwired to 4KB pages)
    The micro-ITLB fast path compared r_u_vpn == va[39:13] with no
    PageMask, picked the even/odd page with va[12] and formed
    PA = {pfn, va[11:0]}. On any instruction page larger than 4KB it
    fetched from the wrong PA (a 64KB-page Linux took RI on its first user
    fetch and killed compress with SIGILL). Cache the entry's pagemask
    and reuse the 48-way TLB's masked compare and size-indexed odd-bit /
    PA-offset mux. 4KB entries (pagemask 0) behave exactly as before.
    Never seen before because 4KB-page kernels put only data on large
    pages. Henry synth: not on any top timing path.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
    [itlb.sv]
2026-09-29 core: split the ROB into alloc-only (mrob) and completion (crob) storage
    rv64core's scheme: fields written only at allocation live in
    mrob_entry_t, stored in the even/odd banks with ONE computed write port
    per bank (tail and next_tail differ in bit 0) and no reset, so they map
    to LUTRAM; fields written after allocation live in crob_entry_t (the
    existing multi-ported flops). rob_entry_t stays the merged view every
    reader uses (rob_to_mrob / rob_to_crob / rob_merge), so no downstream
    logic changes.
    Pure storage refactor: cycle-identical to the unsplit core on dhrystone
    and on Linux compress checkpoints; randgen co-sim clean.
    Henry (no RDCHK), ROB16: -2.2K LUT, -2.1K FF. ROB32: -3.9K LUT,
    -4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
    [core.sv]
2026-09-29 l1d: uncached-by-TLB loads wait for the ROB head in the replay queue
    w_uncachable_req only sees the segment's cacheability; kuseg/xkuseg are
    "cached" there, so a load through a user page whose TLB C bit says
    uncached could fast-hit or issue INJECT_UNCACHE_LOAD speculatively.
    Port 2 now requires the translated C bit for a fast hit; the MRQ releases
    an uncached plain load only when non-speculative (ROB head, the head's
    committable delay slot, or drain); a dead one at drain is answered
    without the device access. VERILATOR [UCSPEC] checker + directed test
    tests/dside_tlb/test_uncached_tlb_load.S (76 hits before, 0 after).
    Cycle-identical on dhrystone and Linux compress checkpoints.
    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
    [l1d.sv]
2026-09-30 LSU: store queue + forwarding, non-blocking L1D misses, restart color
    Rework of the memory pipe per NONBLOCKING_MEMORY.md, on top of main f8dabd4.
    exec LSU (age-matrix pool behind r_mem_uq, rv64core scheduler):
    - simple loads held until answered; block codes park them (BLK_MISS,
    BLK_ST_CONFLICT cache-owned; BLK_SB_CONFLICT, BLK_SB_DATA, BLK_UNCACHEABLE
    LSU-owned, level-released)
    - plain stores (SB/SH/SW/SD/SWC1/SDC1): address pass at issue, data captured
    separately, held until retired, committed in program order, freed on st_done
    - loads pass addressed stores; the l1d compares the load PA against older
    stores' store-buffer slots (epoch-checked) and forwards from the youngest
    fully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
    [core.sv, core_l1d_l1i.sv, exec.sv, gen_html.cc, l1d.sv, top.cc]
2026-09-30 lsu: move merge loads, partial stores and SC into the LSU; remove graduation
    SWL/SWR/SDL/SDR and SC/SCD are LSU stores (SC issues only when oldest; the
    link match is latched at the address pass and carried by the commit).
    LWL/LWR/LDL/LDR are LSU loads whose merge base comes from their store-buffer
    slot, so port 2 serves them on a hit or forward and misses carry the value.
    The exec store-data queue, the core_store_data channel, mem_dq_clr and the
    l1d graduation paths are gone. The debug store watchpoint now keys on the
    LSU store-data capture.
    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
    [core.sv, core_l1d_l1i.sv, exec.sv, l1d.sv]
2026-09-30 Remove the RDCHK retire-time reader-agreement checker
    The checker did its job (validated, 0 hits on a Linux boot) and costs
    4.5-8K LUT plus ~40% retire throughput on silicon when enabled. Removed:
    the ENABLE_RDCHK block in core.sv, its ROB fields (srcB_ptr, srcA_rd,
    srcB_rd, chk_srcA/B_val, chk_vals_valid), the exec operand capture and
    RDCHK_POSCTRL, and the dbg_rdchk port through core_l1d_l1i. Retire
    back-pressure (w_rt_stall) returns to constant 0. The rest of the
    debug infrastructure (trace ring, watchpoint, fault trap) is unchanged.
    Cycle-identical to 995f5be on dhrystone and the directed tests.
    Claude-Session: https: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
2026-10-01 mem-sched: fix two silicon hangs, DTLB timing, checker XKPHYS gap
    - exec: set r_mq_wait only on LSU-owned blocks (mem_blk_code[2]); clear it
    on a response. A cache-owned block (BLK_MISS/BLK_ST_CONFLICT) is answered,
    never re-picked, so the bit leaked to the next op in that ROB slot; at a
    flush that op's inflight bit was cleared, the fast restart skipped a running
    MUL, and its completion landed on a newly allocated op (Linux hang on ROB32
    silicon, reproduced in sim at cycle 614M).
    - l1d: r_fill_rsp was assigned only under `ifdef VERILATOR; synthesis dropped
    it and silicon delivered a zero fill response (early-boot hang).
    - l1d: drive the DTLB from the presented request (core_mem_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
    [exec.sv, interpret.cc, l1d.sv]
2026-10-01 mem-sched: silicon/sim debug infra for restart hazards
    - STALL_SNAP: freeze ROB head, exec queue/wait masks and LSU state into
    dbg_trace_data on a retire stall (exec dbg_exec_snap, core words 0-17).
    - RESTART_MEM_QUIET / RESTART_MIN_CYC restart knobs; l1d mem_quiet output.
    - RSTWIN_TRACE: restart-window trace in exec.
    - VERILATOR-only detectors: STUCKST, STALEEXEC, PUSHDSDONE, DRAINWAIT,
    DBLFREE/DBLALLOC, STALECOMPL (ACTIVE only), RATCOPYRETIRE, COLORSHADOW,
    COLORCNT.
    All off by default; no functional change.
    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
    [core.sv, core_l1d_l1i.sv, exec.sv, l1d.sv]
2026-10-03 core: commit CP0 writes at retire; order CP0 ops as one renamed register
    MTC0/DMTC0 no longer write CP0 at execute. Exec stages {data, reg, 64b} in a
    ROB-indexed buffer (exec.sv r_cp0_stage_*) and core commits it when the writer
    retires (r_retire_cp0_* handshake; a CP0 writer retires alone). A wrong-path,
    squashed or nullified mtc0 therefore never changes CP0. This fixes a silicon
    bug: a serializing mtc0 in the nullified delay slot of a not-taken
    branch-likely went through the faulted-delay-slot funnel, executed, and wrote
    CP0 although it never retired.
    All CP0 ops are totally ordered as if CP0 were one renamed register whose
    versions become ready at retire: writers (MTC0/DMTC0/TLBP/TLBR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
    [core.sv, decode_mips.sv, exec.sv]
2026-10-04 l1d: start any flush only from a fully drained L1D
    A flush arm in ACTIVE could overwrite n_state while a port-1 miss or a
    port-2 direct fill was in hand: the fill went out, its response was
    consumed as a flush beat, the load was never answered and its
    {color,rob} inflight bit leaked, so the next (EXCEPTION_)DRAIN waited
    on that color forever. This was the IRIX go EXCEPTION_DRAIN wedge on
    silicon, raced by XPG page flushes (ARM DMA coherence). The XPG and
    DMA-inval arms also skipped the retired-store drain, so a retired store
    could land after the page flush. All four flush arms now require
    w_l1d_drained (MQ empty, nothing owed, both pipe stages empty, no
    retired store pending).
    Reproduced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
    [l1d.sv]
2026-10-06 l1i: keep branch-predictor update state in the front end (bpu_idx table)
    Each pushed fetch group writes its PHT index into a 64-entry table in l1i
    (LG_BPU_TBL_SZ 6); only the 6-bit table index (bpu_idx) rides through
    decode, the ROB and retire, replacing the LG_PHT_SZ-wide pht_idx. At
    retire l1i looks the PHT index back up from branch_bpu_idx. Mirrors
    rv64core 291b0cb. 64 entries is well above the ~30 insns that can be
    in flight (FQ 8 + DQ 4 + ROB 16 + stage regs), so a live entry never
    wraps. The retire-trace 11-bit pht slot now carries the zero-extended
    bpu_idx.
    Step 1 toward a front-end-resident TAGE-style predictor: further
    predictor metadata goes in this table instead of widening e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
2026-10-06 l1i: 2-wide fetch, 2-table mini-TAGE, 32KB 2-way L1I
    Three front-end changes, validated together on silicon:
    * 2-wide fetch: push at most two insns per cycle, pairing an insn with a
    following taken direct branch; the fetch queue becomes two LUTRAM banks.
    Retires ENABLE_FETCH_BR_GROUP. 4W fetch bought nothing over this on
    ooo_core (compress/coremark/dhrystone within 0.3%) and costs ~3.3K LUT.
    * ENABLE_MINI_TAGE (now on): the PHT becomes a PC-indexed bimodal plus two
    tagged tables, T1 (16b history) and T2 (48b), each 1K per-fetch-line
    entries {valid, tag9, slot2, ctr3, u2} in one RAMB18. Single-cycle
    lookup, longest hit overrides the bimodal for its slot. Trained at
    retire f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
2026-10-06 core: fetch-fault BadVAddr from the head pc; r_addrs gets one write port
    r_addrs (per-ROB-entry BadVAddr, 64b x N_ROB) was written by every memory
    response AND by both alloc slots on fetch faults, but is read only in
    ARCH_FAULT at the ROB head -- three write ports (so flops: 2,048 FFs at
    ROB-32) for an exceptional value. A fetch fault's BadVAddr is its own pc,
    which the mrob already holds, so ARCH_FAULT now takes t_rob_head.pc for
    FETCH_TLB_MISS/FETCH_TLB_INVALID/FETCH_MISALIGNED/FETCH_ADDR_ERROR and
    r_addrs only for memory ops. The two alloc-time writes are gone; r_addrs
    has a single (mem-response) writer and can map to LUTRAM.
    Validation: dhrystone 156,746 cycles (unchanged), randgen 25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
2026-10-06 CLAUDE.md: FPGA builds always target henry
    Any "build/synth/rebuild/deploy/bitstream" request means the henry SoC;
    the bare r9999 core project is built only when named explicitly. Also
    records how to build an r9999 change that is not in henry's submodule
    pin yet (copy into henry/r9999, HENRY_NO_SUBMODULE_UPDATE=1
    ./gen_mipscore.sh, restore the submodule, check the ipshared md5).
    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
2026-10-07 l1i: mini-ITTAGE tagged indirect-target table over the BTB
    The PC-indexed BTB stays the default (right for single-target jumps) and now
    trains on every retired indirect. A 256-entry tagged table {valid, 9b tag,
    2b confidence, target}, indexed by pc ^ the T1 16-bit history, is read at
    fetch beside the BTB; a tag hit overrides the BTB target. Retire update from
    the entry as read at fetch (recorded per fetch group in the bpu_idx table):
    ITT right -> conf+1; ITT wrong -> conf-1, replace target at 0; BTB wrong ->
    allocate only if the slot is invalid or conf 0, else age it. The core
    exports the retired branch target and is_indirect for training; the old
    restart-time BTB write is gone, so l1i dr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
    [core.sv, core_l1d_l1i.sv, l1i.sv]
2026-10-07 tests/henry: bare-metal pointer-chase memlat sweep
    4KB..32MB working sets, 64B-spaced nodes in one random cycle, CP0 $23
    timing. kseg0 arena, so no TLB misses: the plateaus are pure L1D / L2 /
    DRAM load-to-use. Booted via the henry_arcs FSBL like the other henry tests.
    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
2026-10-07 exec: non-power-of-2 LSU sizes (MEM_SCHED_ENTRIES)
    MEM_SCHED_ENTRIES sets how many of the 1 << LG_MEM_SCHED_ENTRIES slots are
    usable (default: all, so no change). The allocator and the full check treat
    the top slots as permanently busy, and the valid next-state is masked, so
    their valid bits are a constant synthesis can see: every reader in exec and
    the l1d store buffer is gated by valid/live, and their state is pruned.
    henry ROB-32, skid + ITT + 512KB L2: LSU 8 / 12 / 16 = 53,327 / 55,355 /
    58,951 LUT, WNS +0.114 / +0.062 / -0.281. Sim at memlat 37 vs ROB-16 LSU-8:
    ROB-32 with LSU 8/10/12/14/16 = -1.9/-2.6/-3.2/-3.6/-3.9% cycles; randgen
    1000 clean at each size.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
2026-10-09 tests/except/test_overflow: quiet the Count/Compare timer
    The handler's raw `mfc0 $k0, Cause` is compared by the co-sim checker,
    and Cause.IP7 (Count == Compare) is cycle-timed in the RTL but not in the
    ISS: every --checker run reported a false k0 mismatch (0x8030 vs 0x30) at
    any memlat, on main too. Count = 1, Compare = 0 at startup (writes only:
    an mfc0 of Count would itself diverge, see tests/csmith/start_csmith.S).
    Self-check P and co-sim clean at memlat 4/37/50.
    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
2026-10-09 exec: non-power-of-2 ALU scheduler sizes (INT_SCHED_ENTRIES)
    Mirror of the LSU knob (52ba22e): `INT_SCHED_ENTRIES (default
    1 << LG_INT_SCHED_ENTRIES) entries are usable; the top ones are never
    allocated (INT_SCHED_USABLE masks both alloc ports and the full check, and
    the valid bit written is the mask bit), so their valid bits are constant 0
    and synthesis prunes them.
    Default build cycle-identical to 52ba22e on the co-sim directed tests.
    INT_SCHED_ENTRIES=6 (of 8): hello / except / traps / overflow / unaligned /
    smc_hit / smc_index co-sim clean; CoreMark ckpt 8M insns IPC 0.839 vs 0.841.
    Claude-Session: https://claude.ai/c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
2026-10-09 interpret: JALR links rd (not always ra); MTC0 sign-extends into 64-bit CP0
    Two ISS fixes made during the Jazz/NT 4.0 bring-up on interp_mips:
    - JALR wrote the link to $31 regardless of rd; it now writes rd (and
    nothing when rd == 0).
    - MTC0 into a 64-bit CP0 register (everything but EntryHi) zero-extended
    the GPR; it now sign-extends the low word, matching the RTL's staged
    sign-extended GPR (exec.sv n_epc). Zero-extended, a 32-bit kernel's
    `mtc0 EPC; eret` returned to 0x00000000fce27900 (R=0), which never
    matches its R=3 kseg3 TLB entry.
    Co-sim directed tests unchanged (hello, except, traps, overflow,
    unaligned, smc_hit, smc_index).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
    [interpret.cc]
2026-10-09 interpret/tests: the checker ISS and the tests report PRId = R4400, like the RTL
    machine.vh PRID_VALUE is R4400 (0x440); the checker ISS (interpret.hh)
    and tests/common/sim.h still said R4600 (0x2020), so every PRId read
    diverged under co-sim and test_prid printed PRID-BAD on every build.
    (R4600 dated from booting IRIX inside this ISS; IRIX boots on the RTL as an
    R4400, and standalone ISS work uses interp_mips.) test_prid: PRID-OK,
    co-sim clean.
    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
2026-10-09 interpret: ERET returns to the 64-bit EPC; MTC0 EPC/ErrorEPC take the full GPR
    ERET (from 3914d19 on inclusive-l2-v2-rebase): the checker's ERET used the
    32-bit cpr0 view of EPC, so n64 user code at 0x120002420 returned to
    0x20002420, took an XTLB refill and desynced right after a checkpoint
    shim's ERET. With it, the CoreMark checkpoint co-sims clean on main
    (8M insns, 0 divergences).
    MTC0: EPC and ErrorEPC now take the full GPR, as the RTL does (exec.sv
    stages t_srcA, n_epc = w_cp0_wr_data) and as Sail does
    (set_CP0EPC(rGPR(rt))); other 64-bit CP0 registers keep the sign-extended
    low word (1425a87). This is the superset of the branch's 66c2d71 and
    main's 1425a87, so the branch merge can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
    [interpret.cc]
2026-10-09 core: P-mode-hazard guard uses decode's definition of 64-bit mode
    decode_mips.sv stamps mode_when_fetched with "64-bit ops valid" =
    in_kernel_mode | 64b user | 64b supervisor (70538bc: kernel mode is 64-bit
    regardless of KX). core.sv's own w_in_64b_mode, which feeds only the
    P-mode-hazard $stop / formal assert and debug prints, still required KX
    in kernel mode, so ANY reserved-instruction fault in kernel mode with
    KX=0 tripped the guard (tests/fpu/fp_mips4: its first movn). Not a stale
    mode -- the Status write there leaves kernel mode set; the two copies just
    disagreed by definition. No functional effect: w_in_64b_kernel_mode
    (with KX) still drives the XTLB vector and the ports to exec/l1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
2026-10-09 checker: full 64-bit EPC on exception entry, Cause.IP synced from the RTL, no MIPS IV
    Three co-sim checker (ISS) fixes:
    - Exception / interrupt entry kept the 64-bit EPC as sext32((uint32_t)pc),
    truncating n64 user code (0x120000fec -> 0x20000fec); since ERET returns
    to the 64-bit view, the checker resumed at the wrong address after a user
    TLB miss. set_exc_pc stores the full pc; raise_int and its top.cc caller
    carry a 64-bit EPC.
    - Cause.IP[7:0] is synced from the RTL every cycle (cause_ip == exec.sv
    w_ip, what the RTL's mfc0 Cause returns), like Count already is. IP7 is
    timing-dependent (Count == Compare; both 0 at reset), so every handler
    that read Cause raw mismatched whe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
    [interpret.cc, top.cc]
2026-10-09 checker: mirror the RTL's TLB into the ISS, --os-mode, adopt mfc0 Random/Count
    Checkpoint co-sim (Linux checkpoints through the ckpt shim) diverged at the
    first exceptions after resume. ooo_core's checker was missing what
    henry_tb's already had, plus two timing-dependent CP0 reads:
    - TLB mirror: the ISS's tlbwr chose its own Random slot, so the two
    48-entry TLBs drifted and the checker took refills the RTL did not.
    itlb.sv's tlb_wr_log DPI hook (now also under ENABLE_TLB_MIRROR, which
    the ooo_core Makefile defines; henry keeps ENABLE_STORE_CHECK, FPGA
    builds define neither) feeds a lossless queue that is applied before
    every ISS step; g_iss_tlb_ext makes it the ISS TLB's only writ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
    [core.sv, core_l1d_l1i.sv, exec.sv, itlb.sv, top.cc]
2026-10-09 interpret: Config is the RTL's read-only constant; tlbp miss leaves Index = P only
    Two more checker/RTL differences found by checkpoint co-sim:
    - Config: the ISS initialised 0x0002e4b3 (before the RTL's DB=0 change to
    0x0002e4a3) and let mtc0/dmtc0 overwrite it, so a checkpoint's CP0
    restore left it 0 and the kernel's next mfc0 Config diverged. Now
    CONFIG_VALUE (= exec.sv 'd16), in both views, writes ignored like PRId.
    - tlbp miss: the R4400 leaves Index[5:0] undefined; the RTL loads the
    probe result's index (0), the ISS kept the stale index (0x8000001b vs
    0x80000000). Match the RTL.
    Claude-Session: https://cla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
2026-10-09 checker: decode the mfc0-adoption instruction through the ISS TLB
    adopt_timing_cp0 (55ff721) decided whether a retired instruction was an
    mfc0 of Random/Count from get_insn(pc & 0x1fffffff), which for user code
    reads an unrelated physical page. In go's iscaptured that page held an
    `mfc0 $v0, Count` at the offset of a `beqz` whose delay slot loads v0, so
    the checker copied the RTL's not-yet-updated v0 into the ISS mid-delay-slot
    and later reported a v0 mismatch (RTL 0x1200fa778 vs ISS 1) in the next
    refill handler -- the go-checkpoint divergence. Use iss_fetch_inst (the
    ISS's own TLB translation of the retire PC) instead.
    go_s03 / go_s05 Linux checkpoints now co-sim clean for 15M insns eac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
2026-10-14 mipsseg: 32-bit addressing mode sign-extends EA[31:0]
    In 32-bit addressing mode the R4000 effective address is the sign-extension
    of EA[31:0], but the AGU adds 64 bits. A base built with lui of a bit-31-set
    constant plus a negative offset -- NT 3.1 ntdll reads its TEB at useg
    0x7ffff4a8 as `lui 0x8000; lw -0xb58` -- gives 0xffffffff_7ffff4a8. mipsseg
    passed that untruncated VA on as l_addr, and the TLB compares R and VPN2 in
    full, so the access missed the user entry and took a TLB refill.
    mipsseg now sign-extends v_addr from bit 31 whenever the current mode is not
    64-bit addressed (KX/SX/UX clear), and every decode, permission check and
    l_addr uses the canonical form. It is a no-op for w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
2026-10-14 l1d: whole-cache flush invalidates dirty lines too (external flush leaves every line in I)
    FLUSH_CACHE wrote a dirty line back as MEM_SW with n_inhibit_write=1, expecting
    the response to write valid=0 -- but w_cacheable_mem_rsp_valid is
    INJECT_RELOAD-only and the response lands in FLUSH_CACHE_WAIT, so nothing was
    written: the line stayed VALID+DIRTY after the walk. After an ARM EXTFLUSH a
    later eviction could then write the stale line back over data a device had
    DMA'd there since. At 16 KB IRIX's own Index_WB_Inv sweeps hid it; with a
    64 KB L1D they cover a quarter of the cache and IRIX failed to boot on silicon
    (found on inclusive-l2-v2-rebase, fixed there as 6bd85f6).
    Fix: invalidate th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
2026-10-14 l2: track L1D presence + colour per line (inclusive-l2-v2 stage A)
    Each L2 line gets pd ("the L1D may hold this line") and pidx (the L1D
    index colour it was filled at: the index bits above the page offset,
    2 bits for the 16KB L1D). Set on an L1D fill hit, cleared on an L1D
    writeback (victim/alias/flush MEM_SW) and on every L2 valid-bit write
    (refill, drop, flush, init). Conservative: a silent clean L1D eviction
    leaves pd set. The arbiter passes l1_mem_req_from_d so L1I fills do
    not set pd. The L1D is still PA-indexed, so pidx = the request's PA
    colour; stage C makes the L1D VA-indexed and supplies it.
    No behaviour change: dhrystone cycle-identical (211,688), randgen
    2000/2000 (1K) + 100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
2026-10-14 l2/l1d: back-invalidate probe before evicting an L1D-held line (inclusive-l2-v2 stage B)
    When an L1I miss is about to evict an L2 line whose pd bit is set, the L2
    first probes the L1D (probe_req/probe_addr held until probe_ack). The L1D
    invalidates the line if present and returns it if dirty; the L2 writes that
    (newer) data back instead of its own copy. An L1D-requested eviction needs
    no probe: the L2 index contains the L1 index, so the L1D's own miss already
    dropped or wrote back that line (pd is stale there).
    L1D side (rule R2 of INCLUSIVE_L2_PROTOCOL.md: the ack never depends on the
    L1D's own request): a new PROBE_CHK state, entered from ACTIVE or any state
    only waiting on the L2 (INJE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
2026-10-14 l1d: line PA from the full tag (inclusive-l2-v2 stage C1)
    Writeback / invalidate addresses were rebuilt as {tag[..:alias], set, 0},
    taking the alias bits (PA above the page offset) from the set index. That
    is only right while every line sits at its PA set. The tag already holds
    those bits, so the 8 rebuild sites now share w_line_pa = {tag, in-page set
    bits, 0}: a line's PA no longer depends on where it is stored, which stage
    C2 needs to store lines at their VA set.
    Cycle-identical to stage B: test_l1i_probe / inval_nowb / smc_hit /
    smc_index, and go_s03 / go_s05 with XPG injection (30M insns each, same
    cycle counts and exception logs).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
2026-10-14 l1d: carry the line's set with the request (inclusive-l2-v2 stage C2a)
    The L1D set a request's line lives in now travels with it -- port 2 ->
    MQ (r_mq_addr, already a per-entry index array) -> r_req (r_req_idx) ->
    the fill (r_mem_req_idx), and per store-buffer slot (r_sb_idx) for
    retired-store drains -- instead of being re-derived from the PA at every
    use. Every port-1 / MQ / fill / array-write site uses the carried index.
    Here it is still the PA set, so nothing changes; C2b makes it the VA set.
    Cycle-identical to C1 on the directed suites (cache, probe, hello,
    except, unaligned, atomic) and on go_s05 with XPG injection.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
2026-10-14 l1d/l2: VA-indexed L1D with L2 alias tracking, push probes (inclusive-l2-v2 stage C2b)
    L1D lines now live at their VA set (t_req2_idx = the port-2 VA set), so
    the colour-mismatch replay is gone. Every L1D->L2 request carries its
    colour (mem_req_colour, `L1D_N_COLOUR bits); the L2 records it as pidx
    and probes the L1D at {probe_colour, PA in-page bits}.
    Probe rules (push -- the R10000 PIdx scheme, user's manual 5.5 / VCE
    errata):
    1. before evicting ANY pd line, whoever caused it (L1I miss, or an L1D
    miss at any colour -- with VA indexing the victim can sit in another
    set), probe at pidx; a dirty copy is the victim writeback.
    2. an L1D LW / INVL / PGDROP that hits a pd line whose p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
2026-10-14 INCLUSIVE_L2_PROTOCOL.md: the inclusive-L2 protocol spec
    Protocol, proof status (Murphi: probe protocol, presence bits, DMA
    snoop, VA alias pull/push), the RTL open items, the separate-reply-channel
    decision, and the stage plan. Stage C is push (R10000 PIdx precedent,
    decided 2026-10-08) with the two probe rules as implemented in C2b, its
    validation, and the bugs found on the way.
    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
2026-10-14 l2: external WBINV snoop with L1D probe; --snoop-delay debug injector
    The L2 snoop port gains a WBINV mode (snoop_req_wbinv=1): if the L1D may
    hold the line (pd), probe it out at pidx (probe reason 5); then write back
    whichever copy is dirty (the probe's or the L2's) and invalidate;
    snoop_done pulses on completion (after the writeback drains). Snoop
    accept now resets the per-request probe state (r_from_d, r_probed,
    r_probe_dirty). The old discard mode (MEM_SNOOP_INVL, no writeback, no L1D
    probe) is unchanged. core_l1d_l1i wires the port through (the main
    tie-off is gone; henry_soc must tie snoop_req_wbinv when its pin moves) and
    [BISTAT] gains a snoop_wbinv row.
    top.cc --snoop-delay N (d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
2026-10-14 l1d/l2: D3 in-transit writeback capture, DROP probe; inclusion checkers + per-line history (sim)
    RTL (synthesized):
    - l1d PROBE_CHK (D3): a probe that lands while the L1D's own writeback of the probed
    line (MEM_SW / MEM_WB) is still in flight returns that data as dirty, so a snoop
    cannot miss a line between the L1D and the L2.
    - l2: a DROP (MEM_SNOOP_INVL, wbinv=0) on a line the L1D may hold (pd) probes it out at
    pidx first (probe reason 6); the discard arm also clears the dirty bit. The
    dma_snoop_shim now issues WBINV for both its pre and post snoops; DROP remains for
    the ENABLE_DMA_SNOOP FIFO path.
    Sim only (VERILATOR / ifdef, no synthesis effect):
    - PRESCHK prints each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
2026-10-14 l1d: whole-cache flush invalidates dirty lines too (external flush leaves every line in I)
    FLUSH_CACHE wrote a dirty line back as MEM_SW with n_inhibit_write=1, expecting the
    response to write valid=0 -- but w_cacheable_mem_rsp_valid is INJECT_RELOAD-only and the
    response lands in FLUSH_CACHE_WAIT, so nothing was written: the line stayed VALID+DIRTY
    after the walk (since d0c4e06, 2026-05). Under the inclusive L2 the SW is an eviction
    (pd cleared) and the L2 flush then drops its copy, so the ARM's EXTFLUSH broke inclusion
    on every flush that found a dirty line: DMA data landed under a stale L1D copy and a later
    eviction wrote the stale line back over it. Invalidate at issue, like FLUSH_CL;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
2026-10-16 formal/murphi: check in the cache-protocol models, generators and runners
    The Murphi models behind INCLUSIVE_L2_PROTOCOL.md and the DMA / page-walk work
    lived only in ~/code/murphi. Bring them into the tree next to the RTL they
    prove:
    models r9999_main / incl / va / nb / dma / pagewalk / caches, rv64core_*
    gen/ make_incl.py + passes (r9999_incl.m is GENERATED from r9999_main.m)
    runners run_*.sh, ladder.sh, sweep_dma.sh (paths now relative to this
    directory; CMurphi via $CMURPHI, output in ./build, gitignored)
    README.md which model covers what, how to run, negative-control rule
    r9999_incl.m is regenerated from the generators: the copy left at the old
    top level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
2026-10-16 machine.vh: TINY_CORE knob -- a small core for fast SoC/device bring-up builds
    +define+TINY_CORE shrinks the core when its performance does not matter
    (e.g. Newport bring-up on henry): LSU 4, ALU scheduler 4, L1D 4KB (one page,
    so no alias colours), L1I 2x4KB, L2 16KB; ROB stays 16. Sizes passed
    explicitly still win. Defaults are unchanged without the define.
    henry rings-only build (bit e60c0687): 55,743 LUT / 35,139 FF / 31 BRAM tiles
    vs 63,773 / 40,426 / 209 for the 64K/64K ROB32/LSU12 perf build; WNS +0.179 at
    100 MHz; ~25 min synth+impl. henry_tb 1.5B-cycle cold boots reach userspace
    on both IRIX (539 SCSI read chains, 0 bad bytes; inclusion check clean) and
    Linux (busybox init).
    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
2026-10-17 core: precise data bus error (DBE, cause 7) from the memory response
    A bus error is decided where IP22 decides it -- the MC, in the SoC -- and comes back
    with the response; nothing new on the load-issue path.
    - l2.sv: forward mem_rsp_bad on uncached-load responses (new l1_mem_rsp_bad output).
    - l1d.sv: INJECT_UNCACHE_LOAD copies it into the load's response as bus_err, with no
    destination write.
    - core.sv / rob.vh: bus_err marks the ROB entry faulted (is_bus_err); at the head it
    takes cause 7 through the existing precise-exception path (EPC/BD as usual,
    BadVAddr untouched).
    - core_l1d_l1i.sv: L2 -> L1D wiring.
    Stage S1 of henry docs/bus-errors.md (uncached loads); cached no-bank acces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
2026-10-17 henry_arcs: GetEnvironmentVariable("monitor") -> "h" (XL24 needs it); monitor=h in envp
    A 24-bit Newport (XL24, board revision 0) takes its video timing from the `monitor`
    environment variable instead of probing the monitor ID (XL8 reads ID 10 from the
    CMAP revision). The stub returned the eaddr string for every name, so an XL24 board
    fell back to 1024x768 while the display assumes 1280x1024 -- the same reason MAME's
    XL24 Indy needs `setenv monitor h`. Names starting "mon" now return "h", and
    monitor=h is in the boot environment. XL8 boots are unaffected (IRIX keeps probing).
    Verified on silicon: IRIX reports Indy 24-bit, 1280x1024 @ 60 Hz, xdm draws correctly.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
2026-10-21 l1i: per-line invalidate for I-side CACHE ops (was a whole-L1I flush)
    An I-side CACHE op (index/hit invalidate, fill) used to start FLUSH_CACHE and
    walk all 1024 L1I sets -- ~260 cycles per op. IRIX's I-clean loop in
    __cache_wb_inval (cache 0x0, 16B stride, reached via userdma -> cache_operation
    -> _bclean_caches) issues one per line, so under Xsgi it was 28.8% of all
    samples. The core now sends the op's set index (flush_line_req/idx) and l1i
    reuses FLUSH_CACHE for exactly that one set (r_fline_one), clearing both ways
    at the index -- exact for index ops, a harmless extra miss for hit ops. The
    L2 is not flushed for I-only ops (already true; stale core.sv comment fixed).
    Silicon (henry bi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
2026-10-23 exec: MFC1/MTC1/DMFC1/DMTC1 are not memory-ordered in the LSU
    The FP<->GPR moves only borrow the mem pipe as a cross-register-file path
    (MEM_MOV, echoed by the l1d with no cache access), but they were in the
    strict class: they waited for every older LSU entry and every younger load
    waited on them. New r_mem_sched_mv class: eligible as soon as the operand
    is ready, freed at issue like a strict op, and excluded from t_mem_pending.
    CTC1/CFC1 stay strict.
    quakespan micro (ROB16, memlat 37): 0.3-3.3% cyc/px; randgen, FP directed
    tests, henry_tb cache-op + faulted-delay-slot regressions clean.
    Claude-Session: https://claude.ai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
2026-10-23 tlb: store TLB_PA_WIDTH (29) PA bits, zero-fill to PA_WIDTH
    Everything IP22/henry maps sits below 0x20000000, but the dtlb, the itlb +
    micro-ITLB and exec's TLBR shadow each stored the full 24-bit (PA_WIDTH 36)
    PFN per page. New TLB_PA_WIDTH knob (default 29): the stored PFN is
    TLB_PA_WIDTH-12 bits, truncated on write and checkpoint load, zero-filled to
    PFN_WIDTH on every read (incl. TLBR -> EntryLo). PA_WIDTH stays 36 for the
    caches, L2 and henry's devices. A PFN with bits above TLB_PA_WIDTH aliases
    low (no PA-range check), as the 32-bit DRAM path already did.
    Cycle-identical in sim (dhrystone, 20M-insn Linux checkpoint co-sim, randgen).
    henry ROB16 bit: 59.2K -> 58.0K LUT, 40.7K -> 39.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
2026-10-25 mipsseg: SR.ERL makes kuseg unmapped and uncached (32-bit addressing)
    The IP24 PROM sizes memory through kuseg 0x20000000 with ERL still set
    from reset. ERL only clears the cache/mapped flags (w_va is already
    PA = VA there), so no new address mux lands on the AGU -> DTLB critical
    path; a first version that muxed l_addr failed timing. The 64-bit xkuseg
    case is not implemented. The I-side does not see ERL yet (l1i ties it 0).
    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
2026-10-25 machine: TLB_PA_WIDTH 30 so the PROM's bank probe at PA 0x20000000 works
    The IP24 PROM probes each memory bank through 16 MB uncached TLB pages at
    PA 0x20000000. With 29 stored PA bits the TLB dropped bit 29, the probe
    landed on the low alias, every bank echoed, and hinv said 512 MB. With 30
    bits (and henry's bank decode) the real PROM reports 256 MB on silicon.
    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
2026-10-25 rob: support non-power-of-2 ROB sizes (ROB_ENTRIES knob)
    ROB pointers stay {wrap, index}, so empty (equal) and full (index equal,
    wrap differs) are unchanged; nothing compares ROB pointer ages. Only
    advancing a pointer depends on capacity: rob_ptr_inc() dispatches to
    rob_ptr_inc_pow2 (plain add, logic unchanged for 16/32) or
    rob_ptr_inc_npow2 (wrap at ROB_ENTRIES, flip the wrap bit).
    `ROB_ENTRIES defaults to 1<<LG_ROB_ENTRIES; must be even (two-wide
    alloc/retire banks by ptr[0]) and in (2^(LG-1), 2^LG]. ROB storage
    arrays are sized by ROB_ENTRIES; rob_ptr-indexed masks stay 2^LG.
    Also fixes the LG=5 Verilator width warnings: dbg_rob_inflight (32b AXI
    debug reg) shows ROB entries 15..0 ab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
2026-10-26 gen_html: add traceTemplate.html (the template gen_html reads)
    The tableData placeholder sits inside <script>, with a leading ';' on the
    next line so the emitted array literal isn't parsed as a call. Memory-pipe
    events (Q/S/H/Z/K...) get a muted cell color and a legend entry.
2026-10-26 gen_html: find traceTemplate.html next to the binary, fail if missing
    The template was opened relative to cwd; run from anywhere else, gen_html
    silently wrote a bare `var tableData = ...' with no HTML around it.
2026-10-31 IP28 (Indigo2 R10000) IRIX boots to Inst> on ooo_core under co-sim
    RTL (ENABLE_R10000):
    - R10000 CACHE ops: cache_act at retire; L2 sequences the 128B secondary
    block ops (0x17/0x13/0x03) and drives a background L1I invalidate
    - CCA 3/4/5 cached (IRIX IP28 runs kernel at xkphys CCA 5)
    - tlbr returns all architectural EntryLo PFN bits (shadow RAM keeps them)
    - R10000 PRId/FIR/Config, CP0 diagnostic regs read 0, any $25 select
    ENABLE_COHERENT_L1I (validation knob, off): a line lives in the L1I xor
    the L1D -- the L2 drops it from the L1I before an L1D fill or uncached
    store and probes the L1D before an L1I fill.
    ooo_core testbench:
    - --ip22/--ip28/--disk: indysim device models (MC, HPC3, SC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
