dsheffie/r9999/(notices)

Notices in the files:
core.sv:
per-uop stage stamps: allocation here, scheduler entry / issue in exec.sv,
joined in top.cc by rob index at retirement
